cnchens/RV1126_RV1109_Hardware_Design_Template/README.md

# RV1126_RV1109_Hardware_Design_Template
RV1126_RV1109_HW_202103
