cnchens/RV1126_RV1109_Hardware_Design_Template/01_Common Document/Rockchip_RV1126_RV1109_Schematic_and_PCB_Review_Checklist_V1.1_CN.xlsx

Sheet: 封面页
RV1126/RV1109原理图及PCB评审注意事项
Revision: | V1.1
Date: | 2020-11-02
Status: | Draft
Rockchip Confidential

Sheet: 声明
保密提示： 本文档及其附件可能含有机密信息，来自瑞芯微电子股份有限公司，仅发送给指定接收者。若非该特定接收人，请勿复制、 使用或披露本文档的任何内容。若误收本文档，请从系统中永久性删除本文档，并以回复邮件或其他方式即刻告知发件人。瑞芯微电子股份有限公司拥有本文档信息的著作权及解释权，禁止任何未经授权许可的侵权行为。 IMPORTANT NOTICE: This document is from Rockchip Electronics Co., Ltd. .The contents of this document and any attachments may contain information that is privileged, confidential and/or exempt from disclosure under applicable law and relevant NDA. If you are not the intended recipient, you are hereby notified that any disclosure, copying, distribution, or use of the information is STRICTLY PROHIBITED. Please immediately contact the sender as soon as possible and destroy the material in its entirety in any format. Thank you.

Sheet: 历史版本
Revision History
Revision | Description | Editor | Revision Date
V1.0 | first edition | Linus.Lin | 2020.07.03
V1.1 | 删除关于efuse的描述. | Linus.Lin | 2020.11.02

Sheet: CPU&Crystal&Reset
类型 |  | 项目 | 要求 | 风险点及影响 | 是否验证? | 审核人 | 备注
平台共性 | 原理图 | PMIC_SLEEP和TSADC_SHUT是特定功能信号，不得随意更改。 | 必须 | 设计要求
 |  | RESET信号管脚需放置0.1uF滤波电容。 | 必须 | 设计要求
 |  | 晶体负载电容请根据实际使用的晶体的CL电容值选择，并控制常温下的频率容限在20ppm以内。 | 必须 | 设计要求
 |  | XOUT_24M网络串接电阻（22ohm）必须保留，用于限流，防止过驱。 | 必须 | 设计要求
 |  | FLASH_VOL_SEL/GPIO0_B3必须根据实际FLASH接口电平，选择合适的上下拉，以配置VCCIO1_VDD(FLASH_VDDQ)电源域的电平。 | 必须 | 设计要求
 |  | ADC_IN0用于Recovery模式选择，连接按键时请串联100ohm电阻；如果产品没有按键需求，请一定要预留10kohm上拉电阻以及测试点，否则会无法进行软件调试。 | 必须 | 设计要求
 |  | SPI/NAND/EMMC的DATA0或CLK信号预留测试点，以防开发过程中烧写了错误的固件后无法正常启动，且此时RECOVERY键不起作用。 | 必须 | 设计要求
 | PCB | 晶体电路布局需要优先考虑，布局时应与芯片在同一层并尽量靠近放置以避免打过孔。晶体走线尽可能的短，远离干扰源。 | 必须 | 设计要求
 |  | 晶体电路布局时如果与芯片不同层放置，走线及过孔需要与其他信号保持12mil以上间距，避免被干扰。 | 必须 | 设计要求
 |  | 晶体以及时钟信号必须保证邻层的地参考面完整，时钟信号需要包地处理，包地线每隔400mil至少添加一个GND过孔。 | 必须 | 设计要求
 |  | PLL电源的去耦电容，必须放在芯片管脚背面。 | 必须 | 设计要求
 |  | PLL电源的去耦电容，在单面贴时应尽量靠近芯片电源管脚布局单面贴时，先在最靠近芯片的位置放置去耦电容，电流需先流经电容，再进入芯片。 | 必须 | 设计要求
 |  | 在布局时，RESET复位信号远离板边缘和金属接插件，以防止因ESD引起的异常而导致复位模块死机。 | 必须 | 设计要求
 |  | RESET的滤波电容应尽量靠近芯片管脚布局，信号需先经过电容，再进入芯片。 | 必须 | 设计要求
 |  | RESET信号应远离DCDC、RF等强干扰信号，以防止受到干扰。如果走线较长，建议包地处理，并且包地线每隔500mil至少添加一个GND过孔。 | 必须 | 设计要求
 |  | RESET按键的TVS保护二级管应尽量靠近按键放置，信号拓扑为：按键--->TVS--->CPU&PMIC；出现ESD现象时，ESD电流必须先经过TVS器件衰减。 | 必须 | 设计要求
扩展需求 | 原理图
 | PCB

Sheet: PMIC&Power
类型 |  | 项目 | 要求 | 风险点及影响 | 是否验证? | 审核人 | 备注
平台共性 | 功能 | 电源器件选型请按照参考设计提供的型号，如果需要更换，LDO/BUCK的带载能力、功率耗散要满足设计要求。如果不知道每一路电源的功耗数据，可向Rockchip申请EVB的电源测试数据做参考。 | 必须 | 设计要求
 |  | 在各功能模块正常工作以后，需要在reboot测试和高功耗场景时对系统各电源做观察，电源不能有瞬时纹波较大的情况，必须留有足够的余量并控制好纹波。 | 必须 | 设计要求
 | 原理图 | DC 5V电源供电时，输入端放置100uF以上电容，改善电源纹波。 | 可选项
 |  | 芯片的每路电源管脚都要靠近放置去耦电容。 | 必须 | 设计要求
 |  | 请勿删除参考图中电源管脚串接的电阻或磁珠，因为芯片需要RC或LC以防止浪涌损坏。 | 必须 | 设计要求
 |  | PMIC的电源时序以及电源分配是固定的，请不要随意改动各路电源所使用的LDO和DC-DC。 | 必须 | 设计要求
 |  | 如果通过按键复位，靠近PMIC的RESETB管脚放置一个0.1uF滤波电容。 | 必须 | 设计要求
 |  | PMIC RK809-2的DC-DC电感参考值为：感量0.47uH，饱和电流3A以上，DCR小于50毫欧。 | 必须 | 设计要求
 |  | PMIC上连接SNSP和SNSN的采样电阻应选择10毫欧电阻，精度为1%，封装为0805或更大尺寸。 | 必须 | 设计要求
 | PCB | 芯片的相邻层必须是一个完整的GND平面。 | 必须 | 设计要求
 |  | 芯片的DDR信号区域，每个GND BALL需要对应一个过孔。 | 必须 | 设计要求
 |  | 芯片的Power管脚，每个ball需要对应一个过孔。 | 必须 | 设计要求
 |  | 芯片的GND管脚，每1.5个ball需要对应一个过孔。 | 必须 | 设计要求
 |  | 芯片下方相同网络的Power ball和GND ball在顶层走“井”字形，交叉连接。 | 必须 | 设计要求
 |  | 所有去耦电容应尽量靠近芯片电源管脚布局；双面贴的板子，去耦电容务必放在对应的电源管脚背面，特别是10uF以上容量的电容，电容的GND pad靠近芯片中心的GND ball放置。 | 必须 | 设计要求
 |  | 单面贴的板子，所有去耦电容布局时应尽可能放置在靠近芯片电源管脚。 | 必须 | 设计要求
 |  | 电源换层时，要尽可能的多打电源过孔；去耦电容的GND过孔要跟它的电源过孔数量保持一致。 | 必须 | 设计要求
 |  | 去耦电容的换层过孔要满足带载能力，不管是电源输入、电源输出还是接地，必须有足够多的过孔，才能保证低ESR（用于减低回路电感），保证电容的去耦效果。 Rockchip建议10uF容量以上去耦电容，一个焊盘提供两个以上0402尺寸的过孔，10uF以下容量的电容，一个焊盘提供至少一个0402尺寸的过孔，过孔要靠近电容焊盘。 | 必须 | 设计要求
 |  | PMIC的32.768KHz时钟信号需要包地处理。 | 必须 | 设计要求
 |  | PMIC电量计的SNSP/SNSN采样线按照差分规则走线，无阻抗要求；采样线上的100nF滤波电容靠近PMIC的管脚放置。采样电阻请靠近电池座的VCC_BAT-管脚放置。 | 必须 | 设计要求
 |  | PMIC的DC-DC之间电感的SW端间距大于1.5mm。建议将输入电容布局在PMIC的同一面，以增大电感之间的间距。 | 必须 | 设计要求
 |  | PMIC的EPAD接地焊盘要有足够的过孔，建议保证5*5个0.5*0.3mm或是6*6个0.4*0.2mm的过孔。 | 必须 | 设计要求
 |  | PMIC的DC-DC 100ohm反馈电阻需要靠近输出电容放置，电阻一端连接到DC-DC输出电容，另一端连接到PMIC的FB反馈脚上，并同时连接到CPU同一电源网络的最远端负载处(通常是芯片背面的去耦电容处)。反馈线宽度使用4mil，必须与电源铺铜伴随走线，以避免干扰；反馈线与其他信号间隔6mil以上。 | 必须 | 设计要求
 |  | VDD_ARM、VDD_LOGIC、VCC_DDR、VDD_NPU、VDD_VEPU的铺铜宽度需满足芯片的电流需求，连接到芯片电源管脚的铺铜足够宽，路径不能被过孔分割太严重。 | 必须 | 设计要求
 |  | 电源部分布局时应远离板边及金属接插件，防止ESD干扰。 | 必须 | 设计要求
 |  | 采样电阻 ——> VCC_BAT- ——> VCC_BAT+ ——>VCC_SYS的走线尽可能短，宽度必须考虑3A的过电流能力，并且不能有太大的压降，所以电源过孔孔径要够大并且数量够多（8个以上），这样可以让主电源回路阻抗更小，充分发挥电池的性能。 | 必须 | 设计要求
扩展需求 | 原理图 Schematic | 如果RK809-2不使用电量计，请把PMIC的SNSP/SNSN/BATDIV接地。 | 必须 | 设计要求
 | PCB | PMIC的32.768K晶体，如果使用金属圆柱体封装，金属外壳应接地。 | 必须 | 保证时钟稳定

Sheet: ADC
类型 |  | 项目 | 要求 | 风险点及影响 | 是否验证? | 审核人 | 备注
平台共性 | 原理图 | ADC_AVDD_1V8电源管脚需放置0.1uF去耦电容。 | 必须 | 设计要求
 |  | 按键的分压电阻阻值请使用参考设计的推荐值，请勿随意改动。 | 必须 | 设计要求
 | PCB | ADCIN0的1nF电容为按键去抖电容，布局时尽量靠近芯片管脚放置。 | 必须 | 设计要求
 |  | ADC信号请远离LCD、DRAM等数字信号。禁止在高速信号线的相邻层布线；禁止在高速信号附近打孔换层；走线不要穿过电感区域。 | 必须 | 设计要求
扩展需求 | 原理图
 | PCB

Sheet: GPIO&总线接口
类型 |  | 项目 | 要求 | 风险点及影响 | 是否验证? | 审核人 | 备注
平台共性 | 原理图 | 对于SDIO、I2S、I2C、PCM、SPI、UART等总线以及GPIO端口，要注意与外接设备的IO电平匹配。 | 必须 | 设计要求
 |  | 对于SDIO、I2S、I2C、PCM、SPI、UART等总线以及GPIO端口，当通过连接器实现板对板连接时，建议串接一定阻值的电阻(22ohm-100ohm之间，具体以能满足SI测试为准)，并预留TVS器件。 | 必须 | 防止生产过程中的强静电及强浪涌直接灌入芯片GPIO，导致芯片管脚被击穿。
 |  | 如果增加或更换了GPIO功能，请确保GPIO的初始上拉或下拉状态满足设计要求。 | 必须 | 设计要求
 |  | 如果连接器上有高压信号，在连接器选型时还应考虑防呆处理。 | 可选项 | 防止作业员反插，强电流灌入GPIO而导致芯片击穿。
 |  | 对于所有总线，如I2S/I2C/PCM/SPI/SDIO/SDMMC中，CLK信号上的串联匹配电阻，都必须靠近源端（发送端）放置。 | 必须 | 设计要求
 |  | 对于SDIO/SDMMC总线，数据信号上的串联匹配电阻，应靠近芯片端放置（400mil以内）。 | 必须 | 设计要求
 | PCB | 高速信号PCB设计请参考《Rockchip_RV1126_RV1109_High_Speed_PCB_Design_Guide》文档中的约束条件。 | 必须 | 设计要求
 |  | 对于I2S/PCM/SDIO/SDMMC总线，CLK信号必须单独包地走线以减少干扰，包地线每隔400mil至少添加一个GND过孔（如果走线没有包地但满足3W原则，也没什么问题。一旦包地则必须增加GND过孔，否则效果反而更差）；总线其他信号做为一组，整组包地走线并与其它信号隔离开，不建议使用电流变化较大的电源平面做为信号的参考平面，或者在DC-DC的SW端附近走线。 | 必须 | 设计要求
扩展需求 | 原理图
 | PCB

Sheet: USB
类型 |  | 项目 | 要求 | 风险点及影响 | 是否验证? | 审核人 | 备注
平台共性 | 原理图 | USB_AVDD_0V8/1V8/3V3电源管脚需放置0.1uF去耦电容。 | 必须 | 设计要求
 |  | OTG_EXTR、HOST_EXTR电阻请选用200ohm 1%精度。 | 必须 | 设计要求
 |  | DP/DM差分对串联连接2.2ohm电阻或共模电感。 | 必须 | 设计要求
 |  | ESD保护器件（如TVS）尽可能靠近USB连接器放置。对于USB2.0，TVS的最大结电容不应超过3pF。 | 必须 | 设计要求
 |  | USB OTG端口是系统固件烧写口，主板上必须预留接口。 | 必须 | 设计要求
 |  | USB ID串联100ohm电阻。 | 必须 | 设计要求
 | PCB | 高速信号PCB设计请参考《Rockchip_RV1126_RV1109_High_Speed_PCB_Design_Guide》文档中的约束条件。 | 必须 | 设计要求
 |  | USB差分对需要控制PCB阻抗，差分阻抗为90Ω ±10%。 | 必须 | 设计要求
 |  | USB差分对应严格遵循差分规则走线。例如，必须保持相同的长度、相同的宽度、相同的层和固定的线距，并尽可能保持对称。 | 必须 | 设计要求
 |  | USB差分对如果跨不同平面走线，需要有伴随地；走线拐角尽量用弧线或者钝角，不能为直角或锐角。 | 必须 | 设计要求
 |  | USB差分对与电源或地平面（或走线）、信号线和过孔保持至少12mil的距离。 | 必须 | 设计要求
 |  | 当USB差分信号走线需要换层时，确保走线上的过孔数量少于6个，并靠近信号过孔放置对称的地缝合孔。 | 必须 | 设计要求
 |  | OTG_EXTR、HOST_EXTR电阻靠近芯片端放置。 | 必须 | 设计要求
 |  | 如果使用USB进行电池充电，VBUS走线需要能支持2.5A的电流。 | 必须 | 设计要求
 |  | USB连接座远离RF天线、摄像头等高EMI源。 | 必须 | 设计要求
 |  | USB的TVS保护二极管应尽量靠近连接座放置，信号拓扑为：USB座--->TVS--->CPU；出现ESD现象时，ESD电流必须先经过TVS器件衰减；TVS器件走线上不要有残桩(Stub)。 | 必须 | 设计要求
扩展需求 | 原理图 | 在USB差分信号上预留共模电感。 | 可选项 | 眼图不符合协议规范
 | PCB | 共模电感应放置在靠近连接座端。 | 可选项 | 设计要求

Sheet: DRAM
类型 |  | 项目 | 要求 | 风险点及影响 | 是否验证? | 审核人 | 备注
平台共性 | 原理图 | 请根据不同的DDR颗粒类型，修改RK809-2 FB3（pin27）的分压电阻阻值，使得VCC_DDR输出电压与颗粒相匹配。 | 必须 | 设计要求
 | PCB | 高速信号PCB设计请参考《Rockchip_RV1126_RV1109_High_Speed_PCB_Design_Guide》文档中的约束条件。 | 必须 | 设计要求
 |  | 请套用Rockchip提供的DDR参考模板。 | 必须 | 设计要求
 |  | 所有DDR信号需要控制PCB阻抗，差分阻抗为100Ω ±10%，单端阻抗为50Ω ±10%。 | 必须 | 设计要求
 |  | DDR走线的参考层需要为完整的平面，参考平面的范围需要比最外层走线宽12mil以上 。避免出现连续的过孔阻断信号的回流路径的情况。 | 必须 | 设计要求
 |  | VCC_DDR电源平面保持完整，不要在平面内走线。 | 必须 | 设计要求
 |  | 信号换层时，参考层没有变化，始终为GND平面的，按照每2个信号过孔，对应增加1个GND过孔。 信号换层时，参考层出现变化，例如从GND平面变化为VCC_DDR平面，按照每3～4个信号过孔，对应增加1个缝合电容。 | 必须 | 设计要求
 |  | DDR电路布局尽量靠近板内，远离板边及金属接插件，防止DDR模块因ESD引起异常而死机。 | 必须 | 设计要求
扩展需求 | 原理图 | 预留屏蔽罩；屏蔽罩如果有散热孔，请避开DDR颗粒位置。 | 可选项
 | PCB

Sheet: FLASH
类型 |  | 项目 | 要求 | 风险点及影响 | 是否验证? | 审核人 | 备注
平台共性 | 原理图 | 根据Nand/eMMC Flash的实际供电电压(1.8V或3.3V)，配置FLASH_VOL_SEL/GPIO0_B3管脚电平： 配置为高电平，控制器供电VCCIO1_VDD及所属IO电压域为1.8V。 配置为低电平，控制器供电VCCIO1_VDD及所属IO电压域为3.3V。 | 必须 | 设计要求
 |  | NAND FLASH的38PIN串接0ohm电阻后接到VCCIO_FLASH电源网络。因为部分SLC的颗粒PIN38为写保护，如果直接接高电平，软件需要特殊处理。预留0ohm以后，遇到这类SLC颗粒后拿掉0ohm电阻，悬空PIN38即可。 | 必须 | 设计要求
 |  | EMMC的DATA0与CMD要预留上拉电阻位，电源为VCCIO_FLASH，不可删减。 | 必须 | 设计要求
 |  | EMMC_CLK不需要上拉电阻以及电容。 | 必须 | 设计要求
 | PCB | 高速信号PCB设计请参考《Rockchip_RV1126_RV1109_High_Speed_PCB_Design_Guide》文档中的约束条件。 | 必须 | 设计要求
 |  | 所有EMMC信号都要控制PCB阻抗，单端信号阻抗为50Ω ±10%。 | 必须 | 设计要求
 |  | 电源线宽度应满足控制器及相应颗粒的电流需求（25mil以上）。 | 必须 | 设计要求
 |  | EMMC_CLK的22ohm串联匹配电阻靠近CPU端（源端）布局（400mil以内）。 | 必须 | 设计要求
 |  | EMMC_CLK单独走线并做包地处理，并且包地线每隔400mil至少添加一个GND过孔。 | 必须 | 设计要求
 |  | EMMC_DATA/CMD整组并行包地走线并遵循3W原则。 | 必须 | 设计要求
扩展需求 | 原理图 | eMMC与Nand兼容设计双Layout时，需要注意走线要理顺，避免EMMC_CLK走线上有很长的分支。 | 必须 | 分支会造成EMMC_CLK的SI问题；
 |  | eMMC与Nand兼容设计双Layout时，走线必须先经过Nand的管脚再连接到EMMC的管脚。 | 必须 | EMMC速率较高，如果走线有分支或者先经过EMMC再连接到NAND，会造成信号的SI问题；
 | PCB

Sheet: Camera
类型 |  | 项目 | 要求 | 风险点及影响 | 是否验证? | 审核人 | 备注
平台共性 | 原理图 | MIPI_RX0_AVDD_0V8、MIPI_RX1_AVDD_1V8、MIPI_RX0_AVDD_1V8、MIPI_RX1_AVDD_1V8电源管脚需串联1ohm电阻。 | 必须 | 设计要求
 |  | 做为Camera功能使用时，VCCIO4与VCCIO6供电必须用相同的电源，保证I2C/MCLK/PDN/RESET等与Camera的DOVDD电平保持一致。 | 必须 | 设计要求
 |  | 若摄像头带AF 功能，则VCC2V8_AF需要单独供电；或是与AVCC2V8_DVP共用，但是需要用磁珠隔离。 | 必须 | 设计要求
 |  | CAMERA的DVDD 供电有1.2V/1.5V/1.8V等不同情况，请根据Camera的规格书提供准确的电源。 | 必须 | 设计要求
 | PCB | 高速信号PCB设计请参考《Rockchip_RV1126_RV1109_High_Speed_PCB_Design_Guide》文档中的约束条件。 | 必须 | 设计要求
 |  | MIPI CSI差分对需要控制PCB阻抗，差分阻抗为100Ω ±10%。 | 必须 | 设计要求
 |  | CIF_CLKIN (PCLK)/CIF_CLKOUT (MCLK)时钟信号单独走线并做包地处理，包地线每隔500mil至少添加一个GND过孔。 | 必须 | 设计要求
 |  | CIF_D0-D15/VSYNC/HREF整组并行包地走线并遵循3W原则。 | 必须 | 设计要求
 |  | MIPI CSI差分对应严格遵循差分规则走线。例如，必须保持相同的长度、相同的宽度、相同的层和固定的线距，并尽可能保持对称。 | 必须 | 设计要求
 |  | MIPI CSI差分对需要有完整的参考平面，不可跨平面走线；走线拐角尽量用弧线或者钝角，不能为直角或锐角。 | 必须 | 设计要求
 |  | MIPI CSI差分对整组并行走线并包地，与GND信号间距遵循3W原则，并且包地线每隔300mil至少添加一个GND过孔。 MIPI CSI差分对整组并行走线，如果不包地，则与其他信号的距离至少为12mil。 | 必须 | 设计要求
 |  | MIPI CSI连接座如果有预留测试点，应靠近连接座，且走线上的残桩(Stub)尽量短。 | 必须 | 设计要求
 |  | CAMERA布局时需要远离大功率辐射器件， 如GSM天线等。 | 必须 | 设计要求
 |  | 连接座AVDD/DOVDD/DVDD电源的去耦电容，都需要尽量靠近CAMERA连接座放置。 | 必须 | 设计要求
扩展需求 | 原理图
 | PCB

Sheet: Audio
类型 |  | 项目 | 要求 | 风险点及影响 | 是否验证? | 审核人 | 备注
平台共性 | 原理图 | 驻极体麦克风的偏置电阻请根据实际规格参数选择。 | 必须 | 设计要求
 |  | 麦克风的偏置电源需要68-100ohm电阻和4.7uF以上电容进行RC滤波。 | 必须 | 设计要求
 | PCB | PMIC Codec的SPK_OUT网络串接磁珠请靠近PMIC输出（源端）放置。 | 必须 | 设计要求
 |  | PMIC Codec的VCC_SPK_HP走线大于50mil。 | 必须 | 设计要求
 |  | HP_SNS网络串接电阻必须在耳机座管脚处短接到地。 | 必须 | 设计要求
 |  | HP_SNS做为HPL/HPR的伴随地，整组走线并包地，HPL/HPR线宽10mil以上。 | 必须 | 设计要求
 |  | SPKP/SPKN按照差分走线并整组包地，线宽20mil。 | 必须 | 设计要求
 |  | MIC单端连接时，MIC1/MIC2单独走线并分别包地。 MIC差分连接时，MICP/MICN按照差分走线，并整组包地。 | 必须 | 设计要求
 |  | 所有音频信号都请远离LCD、DRAM等高速信号线，遵循3W原则。禁止在高速信号线相邻层走线；禁止在高速信号线附近打孔换层；走线不要穿过电感区域；原理RF信号和器件。 | 必须 | 设计要求
 |  | 耳机座/麦克风的TVS保护二级管应尽量靠近连接座放置，信号拓扑为：耳机座/麦克风--->TVS--->CPU；出现ESD现象时，ESD电流必须先经过TVS器件衰减；TVS器件走线上不要有残桩(Stub)。 | 必须 | 设计要求
扩展需求 | 原理图
 | PCB

Sheet: Display
类型 |  | 项目 | 要求 | 风险点及影响 | 是否验证? | 审核人 | 备注
平台共性 | 原理图 | LCDC_CLK网络33ohm串联匹配电阻靠近芯片端（源端）放置，减少信号反射。 | 必须 | 设计要求
 |  | RGB/MIPI等信号，如果有经连接器实现板对板连接时，建议全部信号串接一定阻值的电阻(2.2ohm-10ohm之间，具体以能满足SI测试为准)，以及预留TVS器件。 | 必须Mandatory | 防止生产过程中的强静电及强浪涌直接灌入芯片GPIO，导致芯片管脚被击穿。
 | PCB | 高速信号PCB设计请参考《Rockchip_RV1126_RV1109_High_Speed_PCB_Design_Guide》文档中的约束条件。 | 必须 | 设计要求
 |  | MIPI DSI差分对需要控制PCB阻抗，差分阻抗为100Ω ±10%。 | 必须 | 设计要求
 |  | MIPI DSI差分对应严格遵循差分规则走线。例如，必须保持相同的长度、相同的宽度、相同的层和固定的线距，并尽可能保持对称。 | 必须 | 设计要求
 |  | MIPI DSI差分对需要有完整的参考平面，不可跨平面走线；走线拐角尽量用弧线或者钝角，不能为直角或锐角。 | 必须 | 设计要求
 |  | MIPI DSI差分对整组并行走线并包地，与GND信号间距遵循3W原则，并且包地线每隔300mil至少添加一个GND过孔。 MIPI DSI差分对整组并行走线，如果不包地，则与其他信号的距离至少为12mil。 | 必须 | 设计要求
 |  | MIPI DSI连接座如果有预留测试点，应靠近连接座，且走线上的残桩(Stub)尽量短。 | 必须 | 设计要求
 |  | RGB的数据信号整组并行走线并包地，与其他信号间距遵循3W原则。 | 必须 | 设计要求
 |  | RGB的CLK信号单独走线并做包地处理，并且包地线每隔500mil至少添加一个GND过孔。 | 必须 | 设计要求
扩展需求 | 原理图
 | PCB

Sheet: LCM&TP
类型 |  | 项目 | 要求 | 风险点及影响 | 是否验证? | 审核人 | 备注
平台共性 | 原理图 | LED背光升压IC的FB端限流电阻，请选用1%精度电阻，并按功率需求选择合适的封装尺寸。 | 必须 | 设计要求
 |  | LED背光升压IC的EN/PWM管脚，选择内部下拉的GPIO，外接下拉电阻，避免上电时出现闪屏现象。 | 必须 | 设计要求
 |  | LED背光的驱动电压输出，请选择合适额定电压的滤波电容。 | 必须 | 设计要求
 |  | LED背光升压电路的肖特基二极管请根据工作电流选择合适的型号，并注意二极管的反向击穿电压，避免在空载时反向击穿。 | 必须 | 设计要求
 |  | 屏和触摸屏的信号电平要与芯片的IO驱动电平匹配，如RST/Stand by等信号。 | 必须 | 设计要求
 |  | TP的I2C总线必须加2.2K上拉到VCC3V3_TP电源。 | 必须 | 设计要求
 |  | 带Charge pump的TP IC，请注意电容的额定电压。 | 必须 | 设计要求
 |  | 对于屏，当通过FPC与板连接时，建议串接一定阻值的电阻(22ohm-100ohm之间，具体以能满足SI测试为准)，并预留TVS器件。 | 必须 | 设计要求
 |  | 屏接口建议预留共模电感。 | 必须 | 设计要求
 | PCB | LED背光IC的FB端限流电阻，请靠近屏座放置而不是DC-DC。 | 必须 | 设计要求
 |  | 背光升压电路，请注意电容摆放及电源走线，保证电源的充放电回路最小。 | 必须 | 设计要求
 |  | 屏和触摸屏连接座如果有预留测试点，应靠近连接座，且走线上的残桩(Stub)尽量短。 | 必须 | 设计要求
扩展需求 | 原理图
 | PCB

Sheet: Sensor
类型 |  | 项目 | 要求 | 风险点及影响 | 是否验证? | 审核人 | 备注
平台共性 | 原理图 | 多个设备共用I2C总线时，确保I2C总线上有加上拉电阻，且设备的地址不冲突。 | 必须 | 设计要求
 |  | 确保Sensor的VCCIO与I2C/SPI总线的电源域一致，否则会漏电。 | 必须 | 设计要求
 | PCB | Sensor的去耦电容靠近IC放置。 | 必须 | 设计要求
 |  | 磁敏感类的Sensor（如地磁传感器）需要远离强磁场， 易磁化器件， 大电流器件等， 如听筒，喇叭，马达，摄像头，螺丝钉，大电感与大电容等。同时不能放在屏蔽罩内。 | 必须 | 设计要求
 |  | 磁敏感类的Sensor（如地磁传感器）不能放置在电源的铜皮、走线区域，会受电流产生磁场的影响。 | 必须 | 设计要求
 |  | MEMS器件，在pcb扇出时需注意四个方向走线均衡，不允许单个方向大面积铺铜，避免应力造成传感器参数漂移。 | 必须 | 设计要求
 |  | MEMS器件，在生产时不允许超声波清洗。 | 必须 | 设计要求
扩展需求 | 原理图
 | PCB

Sheet: Micro-SD Card
类型 |  | 项目 | 要求 | 风险点及影响 | 是否验证? | 审核人 | 备注
平台共性 | 原理图 | SDMMC_CLK串联匹配电阻靠近源端，即芯片端放置。 | 必须 | 设计要求
 |  | SDMMC_DET串联电阻靠近源端（卡端）放置，避免频繁拔插卡造成芯片端IO损坏。 | 必须 | 设计要求
 |  | Micro-SD总线支持3.0卡时，TVS保护管的结电容不超过0.5pF。 | 必须 | 设计要求
 |  | SDMMC与UART/JTAG复用的管脚建议预留测试点，方便调试阶段连接UART/JTAG。 | 可选项
 |  | Micro-SD连接座端的VCC_SD电源去耦电容不可删除。 | 必须 | 设计要求
 | PCB | 高速信号PCB设计请参考《Rockchip_RV1126_RV1109_High_Speed_PCB_Design_Guide》文档中的约束条件。 | 必须 | 设计要求
 |  | 所有SDMMC信号都要控制PCB阻抗，单端信号阻抗为50Ω ±10%。 | 必须 | 设计要求
 |  | SDMMC_CLK单独走线并做包地处理，并且包地线每隔400mil至少添加一个GND过孔。 | 必须 | 设计要求
 |  | SDMMC_DATA/CMD整组并行包地走线并遵循3W原则。 | 必须 | 设计要求
 |  | Micro-SD卡座下面区域尽量避免走线，以免出现ESD现象时会受耦合影响。 | 必须 | 设计要求
 |  | Micro-SD的TVS保护二级管应尽量靠近卡座放置，信号拓扑为：Micro-SD卡座--->TVS--->CPU；出现ESD现象时，ESD电流必须先经过TVS器件衰减；TVS器件走线上不要有残桩(Stub)。 | 必须 | 设计要求
扩展需求 | 原理图
 | PCB

Sheet: WIFI&BT
类型 |  | 项目 | 要求 | 风险点及影响 | 是否验证? | 审核人 | 备注
平台共性 | 原理图 | 请确保模组的IO电平与CPU的IO电平保持一致，否则需要做电平匹配处理。 | 必须 | 设计要求
 |  | 晶体负载电容请根据实际使用的晶体的CL电容值选择，并控制常温下的频率容限在10ppm以内。 | 必须 | 设计要求
 |  | 天线预留π型电路用于天线匹配调节。 | 必须 | 设计要求
 |  | 确认PCM与UART接口的连接方向，如IN和OUT、TXD和RXD。 | 必须 | 设计要求
 |  | 如果使用需要32.768k时钟输入的模组，需要注意时钟幅度。 | 必须 | 设计要求
 | PCB | 高速信号PCB设计请参考《Rockchip_RV1126_RV1109_High_Speed_PCB_Design_Guide》文档中的约束条件。 | 必须 | 设计要求
 |  | 模组远离DDR、HDMI、USB等其他高速信号走线及连接座。 | 必须 | 设计要求
 |  | 模组下方TOPC层不允许走线，需保证参考面为完整的地平面，SDIO信号线建议绕过模组投影区域后连接到模组管脚。 | 必须 | 设计要求
 |  | 晶体电路布局需要优先考虑，布局时应与模组在同一层并尽量靠近放置以避免打过孔。晶体走线尽可能的短，远离干扰源。 | 必须 | 设计要求
 |  | 晶体电路布局时如果与模组不同层放置，走线及过孔需要与其他信号保持12mil以上间距，避免被干扰。 | 必须 | 设计要求
 |  | 晶体以及时钟信号必须保证邻层的地参考面完整，时钟信号需要包地处理，包地线每隔400mil至少添加一个GND过孔。 | 必须 | 设计要求
 |  | 所有SDIO信号都要控制PCB阻抗，单端信号阻抗为50Ω ±10%。 | 必须 | 设计要求
 |  | SDIO_CLK单独走线并做包地处理，并且包地线每隔400mil至少添加一个GND过孔。 | 必须 | 设计要求
 |  | SDIO_DATA/CMD整组并行包地走线并遵循3W原则。 | 必须 | 设计要求
 |  | 模组的电源走线尽量采用星型布局，减弱不同路电源轨道之间的相互干扰。 | 必须 | 设计要求
 |  | 电源滤波电容应尽量靠近芯片管脚布局，电流需先经过电容，再进入芯片。 | 必须 | 设计要求
 |  | 模组的电感布局时，请注意走线经电感出来后，先经过电容，再进入模组电源管脚。（附图） | 必须 | 设计要求
 |  | 天线端口走线50欧，保证参考地完整，阻抗不要突变，下方不允许有其他信号线或电源；走线的伴随地需要与主地参考面使用地墙连接。 | 必须 | 设计要求
扩展需求 | 原理图 | 射频线预留测试座。 | 可选项 | 方便厂测，以及天线调试；
 | PCB | 模组周围预留屏蔽罩位置，并做PCB阻焊开窗处理。 | 可选项
