cnchens/RV1126_RV1109_Hardware_Design_Template/01_Common Document/Rockchip_RV1126_RV1109_Schematic_and_PCB_Review_Checklist_V1.1_EN.xlsx

Sheet: Cover
RV1126/RV1109 Schematic and PCB Review Checklist
Revision: | V1.1
Date: | 2020-11-02
Status: | Draft
Rockchip Confidential

Sheet: Statement
保密提示： 本文档及其附件可能含有机密信息，来自瑞芯微电子股份有限公司，仅发送给指定接收者。若非该特定接收人，请勿复制、 使用或披露本文档的任何内容。若误收本文档，请从系统中永久性删除本文档，并以回复邮件或其他方式即刻告知发件人。瑞芯微电子股份有限公司拥有本文档信息的著作权及解释权，禁止任何未经授权许可的侵权行为。 IMPORTANT NOTICE: This document is from Rockchip Electronics Co., Ltd. .The contents of this document and any attachments may contain information that is privileged, confidential and/or exempt from disclosure under applicable law and relevant NDA. If you are not the intended recipient, you are hereby notified that any disclosure, copying, distribution, or use of the information is STRICTLY PROHIBITED. Please immediately contact the sender as soon as possible and destroy the material in its entirety in any format. Thank you.

Sheet: Revision History
Revision History
Revision | Description | Editor | Revision Date
V1.0 | first edition | Linus.Lin | 2020.07.03
V1.1 | Delete the description about efuse. | Linus.Lin | 2020.11.02

Sheet: CPU&Crystal&Reset
Type |  | Item | Requirement | Risk & Influence | Is it verified? | Reviewer | Remark
Platform commonality | Schematic | PMIC_SLEEP and TSADC_SHUT are specific function signals and can not be changed randomly. | Mandatory | Design requirement
 |  | Place 0.1uF filter capacitor close to RESET pin. | Mandatory | Design requirement
 |  | The value of crystal load capacitors should be selected according to CL of the crystal, and having a frequency tolerance of ±20ppm at +25°C. | Mandatory | Design requirement
 |  | XOUT_24M network series resistance (22ohm) must be reserved for current limiting to prevent overdrive. | Mandatory | Design requirement
 |  | FLASH_VOL_SEL/GPIO0_B3 must select the appropriate pull-up and pull-down according to the actual FLASH interface level to configure the voltage of VCCIO1_VDD(FLASH_VDDQ). | Mandatory | Design requirement
 |  | ADC_IN0 is used for Recovery mode selection. Please series connect a 100ohm resistor connect to button. if the product has no button requirement, please be sure to reserve 10kohm pull-up resistor and test point, otherwise software debugging will not be possible. | Mandatory | Design requirement
 |  | The DATA0 or CLK signal of SPI/NAND/EMMC reserves test points, in case the wrong firmware is programmed during the development process and cannot boot normally, and the RECOVERY key does not work at this time. | Mandatory | Design requirement
 | PCB | Give priority to crystal circuit when layout, and place as close as possible to the CPU in the same layer to avoid vias. Crystal traces is as short as possible，far away from the interference source, and needs to surround by GND. | Mandatory | Design requirement
 |  | If the crystal circuit layout is placed in a different layer from the CPU, the traces and vias need to be kept at a distance of more than 12mil from other signals to avoid interference. | Mandatory | Design requirement
 |  | The crystal and clock signal must ensure the integrity of the ground reference plane of the adjacent layer, and the clock signal needs to surround by GND.The ground trace should be added with at least one GND via every 400mil. | Mandatory | Design requirement
 |  | The decoupling capacitors of PLL power supply must be placed on the back of the CPU power pins. | Mandatory | Design requirement
 |  | The decoupling capacitors of PLL power supply should be placed as close as possible to the power pin of the CPU for boards of single-side SMT. Place the decoupling capacitor closest to the CPU first. to flow through capacitors first before entering the pins. The current must first flow through the capacitor before entering the chip. | Mandatory | Design requirement
 |  | Keep the RESET signal far away from the board edge and metal connectors when layout to prevent the reset modules from crashing due to an abnormality caused by ESD. | Mandatory | Design requirement
 |  | The filter capacitor of RESET should be placed as close as possible to the CPU pin when layout. The signal must flow through capacitors first before entering the CPU. | Mandatory | Design requirement
 |  | The RESET signal should be far away from strong interference signals such as DCDC and RF to prevent interference. If the trace is long, it is recommended to surround by GND, and ground trace should be added with at least one GND via every 500mil. | Mandatory | Design requirement
 |  | TVS protection diodes are placed as close as possible to RESET button. Signal topology is: button--->TVS--->CPU&PMIC; when ESD occurs, ESD current must first be attenuated by TVS components. | Mandatory | Design requirement
Extended requirement | Schematic
 | PCB

Sheet: PMIC&Power
Type |  | Item | Requirement | Risk & Influence | Is it verified? | Reviewer | Remark
Platform commonality | Function | For the selection of power supply devices, please follow the model provided in the reference design. If replacement is required, the loading capacity and power dissipation of the LDO/BUCK must meet the design requirements. If you do not know the power consumption value of each power supply, you can apply to Rockchip for power supply test data for reference. | Mandatory | Design requirement
 |  | After each function module works properly, it is necessary to observe each power supply of system during reboot test and high consumption. The power cannot have a large instantaneous ripple, and you must leave sufficient margin and control the ripple. | Mandatory | Design requirement
 | Schematic | When the DC 5V power supply is used, place a capacitor of more than 100uF at the input terminal to improve the power supply ripple. | Optional
 |  | Each power supply pin of the chip should be placed close to the decoupling capacitor. | Mandatory | Design requirement
 |  | Do not delete serial connection resistors or beads in the power pins of reference schematic because CPU requires RC or LC to prevent surge damage. | Mandatory | Design requirement
 |  | Power sequence and power distribution of PMIC are fixed. Do not arbitrarily change LDO and DC-DC used by each power. | Mandatory | Design requirement
 |  | If reset by button, place a 0.1uF filter capacitor close to the RESETB pin of PMIC. | Mandatory | Design requirement
 |  | PMIC RK809-2 DC-DC inductors reference value: inductance 0.47uH, saturation current 3A or more, DCR less than 50 milliohms. | Mandatory | Design requirement
 |  | The sampling resistor connected to SNSP and SNSN on PMIC should choose 10 milliohm resistors with 1% accuracy and size 0805 or larger. | Mandatory | Design requirement
 | PCB | The adjacent layer of the CPU mount layer must be a complete GND plane. | Mandatory | Design requirement
 |  | For the DDR signal area of CPU, each GND BALL needs to correspond to a via. | Mandatory | Design requirement
 |  | For the Power pin of CPU, each ball needs to correspond to a via. | Mandatory | Design requirement
 |  | For the GND pin of CPU, every 1.5 ball needs to correspond to a via. | Mandatory | Design requirement
 |  | The Power ball and GND ball of the same net under CPU is routed in "X" shape, cross-connect in top layer. | Mandatory | Design requirement
 |  | All the decoupling capacitors should be placed as close as possible to the power pins of SOC. For boards of double-sided SMT, capacitors must be placed on the back of the power pins, especially for capacitors with a capacity of more than 10uF, the GND pad of the capacitor is placed close to the GND ball in the center of the SOC. | Mandatory | Design requirement
 |  | For boards of single-sided SMT, all decoupling capacitors should be placed as close as possible to the chip power pins. | Mandatory | Design requirement
 |  | When changing the power supply layer, it is necessary to add as many power supply vias as possible. The GND vias of the decoupling capacitor should be consistent with the number of power vias. | Mandatory | Design requirement
 |  | The layer-changing vias of the decoupling capacitor must meet the load-carrying capacity. Whether it is power input, power output or grounding, there must be enough vias to ensure low ESR (used to reduce loop inductance) and ensure the decoupling effect of the capacitor Rockchip recommends that, for decoupling capacitors bigger than 10uF, one pad provides more than two 0402 vias, and for capacitances less than 10uF, one pad provides a 0402 via at least. Vias should be close to capacitors pads. | Mandatory | Design requirement
 |  | 32.768KHz clock signal of PMIC needs to surrounded by GND. | Mandatory | Design requirement
 |  | The SNSP/SNSN sampling line of PMIC battery fuel gauge is in accordance with the difference rule and has no impedance requirement; the 100nF filter capacitor on the sampling line is placed closed to the pins of PMIC; the sampling resistor should be placed closed to the VBAT- pin of battery connector. | Mandatory | Design requirement
 |  | The distance between the SW terminals of the inductor between the DC and DC of the PMIC is greater than 1.5mm. It is recommended to place the input capacitor on the same side of the PMIC to increase the spacing between the inductors. | Mandatory | Design requirement
 |  | EPAD of PMIC should have enough vias. Recommend to ensure 5*5 0.5*0.3mm size or 6*6 0.4*0.2mm size vias. | Mandatory | Design requirement
 |  | The 100ohm feedback resistor of PMIC DC-DC needs to be placed close to the output capacitor. One end of the resistor is connected to the DC-DC output capacitor, the other end is connected to the PMIC FB feedback pin, and it is also connected to the farthest load of the same power network of the CPU ( It is usually the decoupling capacitor on the back of the chip). The width of the feedback line is 4mil, and it must be routed with the power supply copper to avoid interference; the distance between the feedback line and other signals is more than 6mil. | Mandatory | Design requirement
 |  | The copper of VDD_ARM, VDD_LOGIC, VCC_DDR,VDD_NPU and VDD_VEPU must meet requirements of the CPU current. Copper path to CPU power pins wide enough and cannot be divided too much by vias. | Mandatory | Design requirement
 |  | Power part should be far away from the board edge and metal connectors when layout to prevent from being interferenced due to ESD. | Mandatory | Design requirement
 |  | The power path from sampling resistance ---> VCC_BAT- ---> VCC_BAT+ ---> VCC_SYS should be as short as possible. Copper width requires current capacity to 3A, and the voltage drop should not be too large. So the vias of power supply should be large enough and the quantity should be more enough (more than 8), so that the main power supply circuit impedance can be smaller and the battery performance can be brought into full play. | Mandatory | Design requirement
Extended requirement | Schematic | If RK809-2 doesn't use fuel gauge, please connect SNSP/SNSN/BATDIV to GND for PMIC. | Mandatory | Design requirement
 | PCB | If 32.768KHz crystal of PMIC is packaged using metal cylinder, the metal shell should be connected to ground. | Mandatory | Guarantee the clock stability

Sheet: ADC
Type |  | Item | Requirement | Risk & Influence | Is it verified? | Reviewer | Remark
Platform commonality | Schematic | Need to place 0.1uF decoupling capacitor for ADC_AVDD_1V8 power pin. | Mandatory | Design requirement
 |  | Please use the recommended value in the reference design as the resistance of keys circuit. Do not change it randomly. | Mandatory | Design requirement
 | PCB | The 1nF capacitor of ADCIN0 is a button filter capacitor, it should be placed as close as possible to the CPU pin when layout. | Mandatory | Design requirement
 |  | Keep ADC signal away from the digital signal such as LCD, DRAM and so on. Do not route on the adjacent layer of high-speed signal. Do not drill via near the high-speed signal. Do not route through inductor area. | Mandatory | Design requirement
Extended requirement | Schematic
 | PCB

Sheet: GPIO&BUS
Type |  | Item | Requirement | Risk & Influence | Is it verified? | Reviewer | Remark
Platform commonality | Schematic | For SDIO, I2S, I2C, PCM, SPI, UART and other bus, as well as GPIO port, pay attention to IO level matching with external device. | Mandatory | Design requirement
 |  | For SDIO, I2S, I2C, PCM, SPI, UART and other bus, as well as GPIO port, when connect board with other by connectors, recommend to series connect resistors with a certain resistance (22ohm-100ohm, subject to the SI specification), and reserve TVS components. | Mandatory | Prevent the strong static electricity and strong surge in the production process, leading to the breakdown of the chip pin.
 |  | If there is an increase or replacement of GPIO function, ensure that the GPIO initial pull-up or pull-down state meets the design requirements. | Mandatory | Design requirement
 |  | If there is a high voltage signal on connectors, need to consider the anti-plug treatment for selection of connector components. | Optional | Prevent the operator from inserting back and pouring high current into GPIO to cause chip breakdown.
 |  | For all bus, such as I2S/I2C/PCM/SPI/SDIO/SDMMC, CLK signal series resistor must be placed close to source end (sending end). | Mandatory | Design requirement
 |  | For the SDIO/SDMMC bus, the series matching resistor on the data signal should be placed close to the CPU end (within 400mil). | Mandatory | Design requirement
 | PCB | For high-speed PCB design, please refer to the constraints in the "Rockchip_RV1126_RV1109_High_Speed_PCB_Design_Guide" document. | Mandatory | Design requirement
 |  | For I2S/PCM/SDIO/SDMMC bus, CLK signal must be surround by GND to reduce interference，The ground trace should be added with at least one GND via every 400mil (if the trace is not surround by GND, but it meets the 3W rule, there is nothing Problem. Once surround by GND, the GND via must be added, otherwise the effect is worse). The other signals of the bus as a group, surround by GND and isolated from other signals, and it is not recommend to use the power plane with large current variation as the signal reference plane , or the wire is routed near the SW terminal of the DC-DC. | Mandatory | Design requirement
Extended requirement | Schematic
 | PCB

Sheet: USB
Type |  | Item | Requirement | Risk & Influence | Is it verified? | Reviewer | Remark
Platform commonality | Schematic | Please place the 0.1uF decoupling capacitor as close the USB_AVDD_1V0/1V8/3V3 power pin as possible. | Mandatory | Design requirement
 |  | OTG_EXTR and HOST_EXTR should select 200ohm resistors with 1% accuracy. | Mandatory | Design requirement
 |  | DP/DM differential pair suggest to series connect a 2.2ohm resistor or common mode inductance . | Mandatory | Design requirement
 |  | Place ESD protection component (ex. TVS) as close as possible to the USB connector.The max junction capacitance of TVS should not exceed 3pF for USB2.0. | Mandatory | Design requirement
 |  | USB OTG port is the system firmware download port, the main board must reserve the port. | Mandatory | Design requirement
 |  | OTG ID series connected 100ohm resistor. | Mandatory | Design requirement
 | PCB | For high-speed PCB design, please refer to the constraints in the "Rockchip_RV1126_RV1109_High_Speed_PCB_Design_Guide" document. | Mandatory | Design requirement
 |  | USB differential pair should control impedance. The differential impedance is 90Ω ±10%. | Mandatory | Design requirement
 |  | USB differential pair trace should routing strictly follow the differential rule. For example,must be kept as same length, same width, same layer and fixed space gap,and also be kept as symmetric as possible. | Mandatory | Design requirement
 |  | If the USB differential pair is routed across different planes, an accompanying ground is required; Corners of the traces should use arcs or obtuse angles instead of right angles or acute angles. | Mandatory | Design requirement
 |  | Keep USB differential pair at least 12mil away from power or ground plane (or traces), signal traces and vias. | Mandatory | Design requirement
 |  | When the USB differential signal trace needs to be change layers, make sure that the number of vias on the trace is less than 6, and place ground stitching vias close to signal vias. | Mandatory | Design requirement
 |  | OTG_EXTR and HOST_EXTR resistor should be placed close to the CPU end. | Mandatory | Design requirement
 |  | If use USB for battery charging, VBUS trace needs to be able to support 2.5A current. | Mandatory | Design requirement
 |  | USB connectors should be far away from high EMI sources such as RF antennas, camera and so on. | Mandatory | Design requirement
 |  | TVS protection diodes are placed as close as possible to USB port. Signal topology is: USB port--->TVS--->CPU; when ESD occurs, ESD current must first be attenuated by TVS components.TVS components traces should not have trace stub. | Mandatory | Design requirement
Extended requirement | Schematic | Reserve a common mode choke on USB differential pair. | Optional | Eye diagram does not conform with protocol specification
 | PCB | Common mode choke should be placed close to the USB port. | Optional | Design requirement

Sheet: DRAM
Type |  | Item | Requirement | Risk & Influence | Is it verified? | Reviewer | Remark
Platform commonality | Schematic | Please change the value of RK809-2 FB3（pin27）divider resistor according to different types of DDR components to make VCC_DDR output voltage match with the component. | Mandatory | Design requirement
 | PCB | For high-speed PCB design, please refer to the constraints in the "Rockchip_RV1126_RV1109_High_Speed_PCB_Design_Guide" document. | Mandatory | Design requirement
 |  | Please use the DDR reference template provided by Rockchip. | Mandatory | Design requirement
 |  | All DDR signals should control impedance. The differential impedance is 100Ω ±10%, and the single-ended impedance is 50Ω ±10%. | Mandatory | Design requirement
 |  | The reference layer of the DDR trace needs to be a complete plane, and the range of the reference plane needs to be more than 12mil wider than the outermost trace. Avoid the situation of continuous via blocking signal return path. | Mandatory | Design requirement
 |  | The VCC_DDR power plane remains complete, do not route in the plane. | Mandatory | Design requirement
 |  | When the signal changes layers, the reference layer does not change, and it is always the GND plane. According to every 2 signal vias, add 1 GND via. When the signal changes layers, the reference layer changes, for example, from the GND plane to the VCC_DDR plane, and a stitching capacitor is added every 3 to 4 signal vias. | Mandatory | Design requirement
 |  | DDR circuit layout should be within the board as much as possible and away from the board edge and metal connectors to prevent DDR module from crashing due to abnormality caused by ESD. | Mandatory | Design requirement
Extended requirement | Schematic | Reserve the shield. If there are heat dissipation holes in a shield cover, please keep it away from DDR component position. | Optional
 | PCB

Sheet: FLASH
Type |  | Item | Requirement | Risk & Influence | Is it verified? | Reviewer | Remark
Platform commonality | Schematic | According to the supply voltage (1.8V or 3.3V) of Nand/eMMC Flash, the FLASH_VOL_SEL/GPIO0_B3 pin level is configured: Configuration high, the controller power supply VCCIO1_VDD and its IO voltage range are 1.8V. Configuration low, the controller power supply VCCIO1_VDD and its IO voltage range are 3.3V. | Mandatory | Design requirement
 |  | The 38 pin of NAND FLASH is series connected to the VCCIO_FLASH power supply by a 0 ohm resistor. Because some SLC particle PIN38 is write protection, if connected directly to high level, the software needs special treatment. After reserving 0 ohm, when encountering such SLC particles, remove 0 ohm resistance and floating PIN38. | Mandatory | Design requirement
 |  | The DATA0 and CMD signals of EMMC should reserve pull-up resistor to connect to VCCIO_FLASH power supply, which can not be deleted. | Mandatory | Design requirement
 |  | EMMC_CLK doesn't need pull-up resistor and capacitor. | Mandatory | Design requirement
 | PCB | For high-speed PCB design, please refer to the constraints in the "Rockchip_RV1126_RV1109_High_Speed_PCB_Design_Guide" document. | Mandatory | Design requirement
 |  | All EMMC signals should control impedance. The single-ended signal impedance is 50Ω ±10%. | Mandatory | Design requirement
 |  | Power trace width should meet the current requirements of controller and corresponding components (more than 25mil). | Mandatory | Design requirement
 |  | The 22ohm series matching resistor of EMMC_CLK should be close to CPU (source) end at layout (within 400mil). | Mandatory | Design requirement
 |  | EMMC_CLK signal should be routed separately and surrounded by GND, and ground trace should be added with at least one GND via every 400mil. | Mandatory | Design requirement
 |  | The EMMC_DATA/CMD as a group parallel routing and surround by GND, and follow the 3W rule. | Mandatory | Design requirement
Extended requirement | Schematic | When eMMC and Nand are compatible to design double Layout, attention should be paid to straightening out the routing and avoiding the long branches of EMMC_CLK. | Mandatory | Long branches will cause SI problems in EMMC_CLK.
 |  | When eMMC and Nand are compatible to design double Layout, the line must first pass through Nand's pin and then connect to EMMC's pin. | Mandatory | EMMC has a high speed. If the line first pass through eMMC's pin and then connect to Nand's pin, it will cause SI problem of the signal.
 | PCB

Sheet: Camera
Type |  | Item | Requirement | Risk & Influence | Is it verified? | Reviewer | Remark
Platform commonality | Schematic | MIPI_RX0_AVDD_0V8、MIPI_RX1_AVDD_1V8、MIPI_RX0_AVDD_1V8 and MIPI_RX1_AVDD_1V8 power pins need to series connect 1ohm resistors. | Mandatory | Design requirement
 |  | When used as camera function, VCCIO4 and VCCIO6 must use the same power supply to ensure that I2C/MCLK/PDN/RESET level should be match with DOVDD of Camera. | Mandatory | Design requirement
 |  | If camera has AF function, VCC2V8_AF requires separate power supply, or share with AVCC2V8_DVP using chip ferrite bead to isolate. | Mandatory | Design requirement
 |  | DVDD voltage of CAMERA has different conditions such as 1.2V / 1.5V / 1.8V, etc. Please provide accurate power supply according to the specification of Camera. | Mandatory | Design requirement
 | PCB | For high-speed PCB design, please refer to the constraints in the "Rockchip_RV1126_RV1109_High_Speed_PCB_Design_Guide" document. | Mandatory | Design requirement
 |  | MIPI CSI differential pair should control impedance. The differential impedance is 100Ω ±10%. | Mandatory | Design requirement
 |  | CIF_CLKIN (PCLK)/CIF_CLKOUT (MCLK) signal should be routed separately and surrounded by GND, and ground trace should be added with at least one GND via every 500mil. | Mandatory | Design requirement
 |  | The CIF_D0-D15/VSYNC/HREF as a group parallel routing and surround by GND, and follow the 3W rule. | Mandatory | Design requirement
 |  | MIPI CSI differential pair should routing strictly follow the differential rule. For example,must be kept as same length, same width, same layer and fixed space gap,and also be kept as symmetric as possible. | Mandatory | Design requirement
 |  | MIPI CSI differential pair must be routed over complete ground plane and not cross different plane. Corners of the traces should use arcs or obtuse angles instead of right angles or acute angles. | Mandatory | Design requirement
 |  | MIPI CSI differential pair as a group parallel routing and surround by GND, the distance from the GND signal follow the 3W rule and the ground trace should be added with at least one GND via every 300mil. MIPI CSI differential pair as a group parallel routing and if not surround by GND, the distance away from othe signals at least 12mil . | Mandatory | Design requirement
 |  | If there is a reserved test point for the MIPI CSI connector, they should be close to the connector, and the stub on the trace should be as short as possible. | Mandatory | Design requirement
 |  | CAMERA layout should be far away from the high power radiation components such as GMS antenna etc. | Mandatory | Design requirement
 |  | The decoupling capacitors of AVDD/DOVDD/DVDD power of connectors all need to be placed as close as possible to CAMERA connector. | Mandatory | Design requirement
Extended requirement | Schematic
 | PCB

Sheet: Audio
Type |  | Item | Requirement | Risk & Influence | Is it verified? | Reviewer | Remark
Platform commonality | Schematic | Select the bias resistance of electret microphone according to the actual specification parameter. | Mandatory | Design requirement
 |  | The bias power of microphone needs 68-100ohm resistor and 4.7uF or more capacitor for RC filtering. | Mandatory | Design requirement
 | PCB | The magnetic bead series connected with SPK_OUT network of PMIC Codec should be placed close to the output(source end) of PMIC. | Mandatory | Design requirement
 |  | The trace of VCC_SPK_HP of PMIC Codec is bigger than 50mil. | Mandatory | Design requirement
 |  | HP_SNS network series connected resistor must be short connected to GND in earphone socket pin. | Mandatory | Design requirement
 |  | HP_SNS is used as a concomitant VSS for HPL / HPR signals. The whole group should be surrounded by GND. The HPL/HPR trace width is more than 10mil. | Mandatory | Design requirement
 |  | SPKP/SPKN should be routed according to the difference and the whole group should be surrounded by GND, the trace width is 20mil. | Mandatory | Design requirement
 |  | When MIC is connected with single end, MIC1/MIC2 should be routed separately and surrounded by GND. When MIC is connected with the differential, MICP/MICN should be routed according to the differential and the whole group should be surrounded by GND. | Mandatory | Design requirement
 |  | Keep all audio signals away from high-speed signal lines such as LCD and DRAM, and follow the 3W rule. It is forbidden to route the adjacent layers of high-speed signal lines; it is forbidden to drill holes and change layers near high-speed signal lines; the traces should not pass through the inductor area; Away from RF signals and equipment. | Mandatory | Design requirement
 |  | TVS protection diodes are placed as close as possible to headphone/microphone. Signal topology is: headphone/microphone--->TVS--->CPU; when ESD occurs, ESD current must first be attenuated by TVS components.TVS components traces should not have trace stub. | Mandatory | Design requirement
Extended requirement | Schematic
 | PCB

Sheet: Display
Type |  | Item | Requirement | Risk & Influence | Is it verified? | Reviewer | Remark
Platform commonality | Schematic | LCDC_CLK network 33ohm series connection resistor is placed near the chip end (source end) to reduce signal reflection. | Mandatory | Design requirement
 |  | For the signals such as RGB/MIPI etc., if it is board-to-board connected by connectors, recommend to series connect resistors with a certain resistance value (2.2ohm-10ohm, subject to the SI specification) for all the signals, and reserve TVS components. | Mandatory | Prevent the strong static electricity and strong surge in the production process, leading to the breakdown of the chip pin.
 | PCB | For high-speed PCB design, please refer to the constraints in the "Rockchip_RV1126_RV1109_High_Speed_PCB_Design_Guide" document. | Mandatory | Design requirement
 |  | MIPI DSI differential pair should control impedance. The differential impedance is 100Ω ±10%. | Mandatory | Design requirement
 |  | MIPI DSI differential pair should routing strictly follow the differential rule. For example,must be kept as same length, same width, same layer and fixed space gap,and also be kept as symmetric as possible. | Mandatory | Design requirement
 |  | MIPI DSI differential pair must be routed over complete ground plane and not cross different plane. Corners of the traces should use arcs or obtuse angles instead of right angles or acute angles. | Mandatory | Design requirement
 |  | MIPI DSI differential pair as a group parallel routing and surround by GND, the distance from the GND signal follow the 3W rule and the ground trace should be added with at least one GND via every 300mil. MIPI DSI differential pair as a group parallel routing and if not surround by GND, the distance away from othe signals at least 12mil . | Mandatory | Design requirement
 |  | If there is a reserved test point for the MIPI DSI connector, they should be close to the connector, and the stub on the trace should be as short as possible. | Mandatory | Design requirement
 |  | The whole group of RGB signals should be surrounded by GND and distance from the othe signals follow the 3W rule. | Mandatory | Design requirement
 |  | The CLK signal of RGB should be routed separately and surrounded by GND, and the ground trace should be added with at least one GND via every 500mil. | Mandatory | Design requirement
Extended requirement | Schematic
 | PCB

Sheet: LCM&TP
Type |  | Item | Requirement | Risk & Influence | Is it verified? | Reviewer | Remark
Platform commonality | Schematic | The current-limiting resistor of FB pin of LED backlight booster IC should select 1% accuracy, and choose the appropriate package size according to the power requirements. | Mandatory | Design requirement
 |  | EN/PWM pin of LED backlight boost IC needs to select the internal pull-down GPIO, and connect pull-down resistor to avoid the screen flicker when power-on. | Mandatory | Design requirement
 |  | LED backlight driving voltage output should select the filter capacitor with appropriate rated voltage (DC). | Mandatory | Design requirement
 |  | For the Schottky diode of the LED backlight boost circuit, please select the appropriate model according to the operating current, and pay attention to the reverse breakdown voltage of the diode to avoid reverse breakdown during no-load. | Mandatory | Design requirement
 |  | The signal level of the screen and touch screen should match the IO drive level of the CPU, such as Reset/Standby signals. | Mandatory | Design requirement
 |  | I2C bus of TP must add 2.2Kohm pull-up to VCC3V3_TP power. | Mandatory | Design requirement
 |  | For TP IC with Charge pump, please pay attention to the rated voltage of capacitor. | Mandatory | Design requirement
 |  | For Screen panel, when connect board with FPC cnnectors, recommend to series connect resistors with a certain resistance (22ohm-100ohm, subject to the SI specification), and reserve TVS components. | Mandatory | Design requirement
 |  | Screen interface is recommended to reserve common mode inductor. | Mandatory | Design requirement
 | PCB | The current-limiting resistor of FB pin of LED backlight IC should be placed close to the panel socket instead of DC-DC. | Mandatory | Design requirement
 |  | Backlight booster circuit, please pay attention to capacitor placement and power wiring to ensure the minimum charge and discharge circuit of the power supply. | Mandatory | Design requirement
 |  | If there are reserved test points for the screen and touch screen connector, they should be close to the connector, and the stub on the trace should be as short as possible. | Mandatory | Design requirement
Extended requirement | Schematic
 | PCB

Sheet: Sensor
Type |  | Item | Requirement | Risk & Influence | Is it verified? | Reviewer | Remark
Platform commonality | Schematic | When I2C bus is shared by multiple devices, make sure there is pull-up resistor added in I2C bus and no conflict among the devices address. | Mandatory | Design requirement
 |  | Make sure VCCIO power supply of sensor is consistent with the power domain of I2C/SPI bus, otherwise the current leakage will occur. | Mandatory | Design requirement
 | PCB | Place decoupling capacitors close to sensor. | Mandatory | Design requirement
 |  | Magnetic sensitive sensors (such as compass sensors) need to stay away from strong magnetic fields, easily magnetizable components, high current components etc. such as earphone, motor, speaker, camera, screw, big inductor and big capacitor and so on. Besides, they cannot be placed inside the shield. | Mandatory | Design requirement
 |  | Magnetic sensitive sensors (such as compass sensors) cannot be placed in the area of the copper and trace of power, otherwise it will be influenced by the magnetic field produced by the current. | Mandatory | Design requirement
 |  | For MEMS devices, pay attention to the balanced routing in the four directions when the PCB is fanout. It is not allowed to lay copper in a large area in a single direction to avoid sensor parameter drift caused by stress. | Mandatory | Design requirement
 |  | MEMS devices, ultrasonic cleaning is not allowed during production. | Mandatory | Design requirement
Extended requirement | Schematic
 | PCB

Sheet: Micro-SD Card
Type |  | Item | Requirement | Risk & Influence | Is it verified? | Reviewer | Remark
Platform commonality | Schematic | SDMMC_CLK series connection resistor is close to the source end, that is, placed on the CPU end. | Mandatory | Design requirement
 |  | SDMMC_DET serial connection resistors are placed close to the source end (card end) to avoid the CPU end IO damage caused by frequent card insertion and removal. | Mandatory | Design requirement
 |  | When Sdcard bus supports 3.0 card, TVS protection diodes load capacitances do not exceed 0.5pF. | Mandatory | Design requirement
 |  | It is recommended to reserve test points for the multiplexed pins of SDMMC and UART/JTAG, which is convenient for connecting the serial port/JTAG during the debugging stage. | Optional
 |  | Do not delete VCC_SD power decoupling capacitor in Micro-SD connector. | Mandatory | Design requirement
 | PCB | For high-speed PCB design, please refer to the constraints in the "Rockchip_RV1126_RV1109_High_Speed_PCB_Design_Guide" document. | Mandatory | Design requirement
 |  | All SDMMC signals should control impedance. The single-ended signal impedance is 50Ω ±10%. | Mandatory | Design requirement
 |  | SDMMC_CLK signal should be routed separately and surrounded by GND, and ground trace should be added with at least one GND via every 400mil. | Mandatory | Design requirement
 |  | The SDMMC_DATA/CMD as a group parallel routing and surround by GND, and follow the 3W rule. | Mandatory | Design requirement
 |  | Try to avoid routing in the area below Micro-SD card connector to avoid coupling caused by ESD occurs. | Mandatory | Design requirement
 |  | TVS protection diodes are placed as close as possible to Micro-SD connector. Signal topology is: connector--->TVS--->CPU; when ESD occurs, ESD current must first be attenuated by TVS components. TVS components traces should not have trace stub. | Mandatory | Design requirement
Extended requirement | Schematic
 | PCB

Sheet: WIFI&BT
Type |  | Item | Requirement | Risk & Influence | Is it verified? | Reviewer | Remark
Platform commonality | Schematic | Please ensure that the IO level of the module is consistent with the IO level of the CPU, otherwise level matching needs to do the level shift. | Mandatory | Design requirement
 |  | The value of crystal load capacitors should be selected according to CL of the crystal, and having a frequency tolerance of ±10ppm at +25°C. | Mandatory | Design requirement
 |  | Reserve π-type circuit for antenna matching adjustment. | Mandatory | Design requirement
 |  | Confirm the connection direction of PCM and UART interfaces, such as IN and OUT, TXD and RXD. | Mandatory | Design requirement
 |  | If you use a module that requires a 32.768k clock input, you need to pay attention to the clock amplitude. | Mandatory | Design requirement
 | PCB | For high-speed PCB design, please refer to the constraints in the "Rockchip_RV1126_RV1109_High_Speed_PCB_Design_Guide" document. | Mandatory | Design requirement
 |  | Module should be far away from other high-speed signal traces and connectors such as DDR, HDMI, USB and so on. | Mandatory | Design requirement
 |  | The TOP layer below the module does not allow wiring. It is necessary to ensure that the reference plane is a complete ground plane. SDIO signals routing should bypass module projection area and then connect to the module pins. | Mandatory | Design requirement
 |  | Give priority to crystal circuit when layout, and place as close as possible to the module in the same layer to avoid vias. Crystal traces is as short as possible，far away from the interference source, and needs to surround by GND. | Mandatory | Design requirement
 |  | If the crystal circuit layout is placed in a different layer from the module, the traces and vias need to be kept at a distance of more than 12mil from other signals to avoid interference. | Mandatory | Design requirement
 |  | The crystal and clock signal must ensure the integrity of the ground reference plane of the adjacent layer, and the clock signal needs to surround by GND.The ground trace should be added with at least one GND via every 400mil. | Mandatory | Design requirement
 |  | All SDIO signals should control impedance. The single-ended signal impedance is 50Ω ±10%. | Mandatory | Design requirement
 |  | SDIO_CLK signal should be routed separately and surrounded by GND, and ground trace should be added with at least one GND via every 400mil. | Mandatory | Design requirement
 |  | The SDIO_DATA/CMD as a group parallel routing and surround by GND, and follow the 3W rule. | Mandatory | Design requirement
 |  | Module power traces need to adopt a star shape layout to reduce the mutual interference among different power traces. | Mandatory | Design requirement
 |  | Power filter capacitors layout should be as close as possible to the chip pins. They should be placed on the same layer of WIFI chip or module. Current needs to flow through capacitors before entering the chip. | Mandatory | Design requirement
 |  | When the inductor of the module is laid out, please note that after the trace comes out of the inductor, it passes through the capacitor first, and then enters the power supply pin | Mandatory | Design requirement
 |  | The impedance of antenna input/output ports is 50ohm, with reference ground of interlayer, surrounding clearance GND which connect multiple vias to main ground, and do not allow crossover with other signal traces or power. | Mandatory | Design requirement
Extended requirement | Schematic | RF trace should reserve a test connector. | Optional | Convenient for factory testing and antenna tunning.
 | PCB | Reserve the shield position around modules, and make PCB solder mask opening. | Optional
