cnchens/RV1126_RV1109_Hardware_Design_Template/01_Common Document/RV1126_RV1109_PINOUT_EN_V1.2_20201030.xlsx

Sheet: CoverPage
RV1126_RV1109
Pin List and Pin Information
Revision: V1.2
Date: 2020/10/30
Status: Draft
Rockchip Confidential

Sheet: Statement
保密提示： 本文档及其附件可能含有机密信息，来自瑞芯微电子股份有限公司，仅发送给指定接收者。若非该特定接收人，请勿复制、 使用或披露本文档的任何内容。若误收本文档，请从系统中永久性删除本文档，并以回复邮件或其他方式即刻告知发件人。瑞芯微电子股份有限公司拥有本文档信息的著作权及解释权，禁止任何未经授权许可的侵权行为。 IMPORTANT NOTICE: This document is from Rockchip Electronics Co., Ltd. .The contents of this document and any attachments may contain information that is privileged, confidential and/or exempt from disclosure under applicable law and relevant NDA. If you are not the intended recipient, you are hereby notified that any disclosure, copying, distribution, or use of the information is STRICTLY PROHIBITED. Please immediately contact the sender as soon as possible and destroy the material in its entirety in any format. Thank you.

Sheet: Revision History
Revision History
Revision | Description | Editor | Revision Date
V1.0 | First edition. | Li Yanhong | 2020.04.10
V1.1 | update MCU | Li Yanhong | 2020.06.23
V1.2 | update： 1.Delect BT.656 TX function | Li Yanhong | 2020.10.30

Sheet: 0.Description
Sheet Description
1. The Pin Information sheet describes the pin numbers, functions,characteristics, and corresponding configuration registers. 2. The Function Signal sheet describes the function signals and their multiplexed pins. 3. The Pin Control registers sheet describes the rigister address of the pins and the configurations of multiplexing relationships, driver capability, and pull-up and pull-down ,default IO drive strenth,input enable,schmitt trigger enable. 4. The Ball Map sheet describes the ball position distribution.
Pin Types Describtion
CI | Crystal Oscillator Input
CO | Crystal Oscillator Drive Output
I | Input
O | Output
I/O | Input/Output
B | Bidirection signal
A | Analog setting or filtering
AI | Analog Input
AO | Analog Output
AI/O | Analog Input/Output
PI | Power Supply
PO | Power Output
API | Analog Power Supply
APO | Analog Power Output
G | Ground
AG | Analog Ground
UP | Internal Pull-up
DOWN | Internal Pull-down
High-Z | high impedance
R_PU28K | Pull up resistance normal value 28Kohm
R_PD29K | Pull down resistance normal value 29Kohm
Abbreviations Describtion
_u | Default Internal Pull-up
_d | Default Internal Pull-down
_z | Default Tri-State
_od | Open Drain Output
_5V | Support 5V Tolerant Input
_od5V | Support 5V Tolerant Input ,Open Drain Output

Sheet: 1.Pin Information
Pin Number | Pin Name | Level State | default I/O Type | Default Io Driver Current |  |  |  | Power Domain | Supply Voltage | Pin Type | Schmitt Trigger | Interruptable | IO Config Register |  |  |  |  | Function Description
 |  |  |  | DS3 | DS2 | DS1 | DS0 |  |  |  |  |  | Driver strength control register | PU/PD control register | Input enable control register | Schmitt trigger control register | IOMUX control register | function Number | Signal Name | Direction | Description
OSC/PLL | 6 balls
Y9 | XOUT24M |  |  |  |  |  |  | PMU/PLL | 1.8V | CO | -- | -- | PMUGRF_OSC_DS | -- | -- | -- | -- | 0 | XOUT24M | O | Clock output of 24MHz crystal
AA9 | XIN24M |  |  |  |  |  |  | PMU/PLL | 1.8V | CI | -- | -- |  | -- | -- | -- | -- | 0 | XIN24M | I | Clock input of 24MHz crystal
P11 | PLL_AVDD_0V8 |  |  |  |  |  |  | PLL | 0.8V | PI | -- | -- | -- | -- | -- | -- | -- | 0 | PLL_AVDD_0V8 | -- | PLL 0.8V supply
R11 | PLL_AVDD_1V8 |  |  |  |  |  |  | PLL | 1.8V | PI | -- | -- | -- | -- | -- | -- | -- | 0 | PLL_AVDD_1V8 | -- | PLL 1.8V supply
P10 | PMUIO_VDD_0V8 |  |  |  |  |  |  | PMUIO0/1 | 0.8V | PI | -- | -- | -- | -- | -- | -- | -- | 0 | PMUIO_VDD_0V8 | -- | PUMIO0/1 0.8V supply
R10 | PMUIO_VDD_1V8 |  |  |  |  |  |  | PMUIO0/1 | 1.8V | PI | -- | -- | -- | -- | -- | -- | -- | 0 | PMUIO_VDD_1V8 | -- | PUMIO0/1 1.8V supply
PMUIO0 | 12 Balls |  |  |  |  |  |  | Power Supply | Supply Voltage | Pin Type | Schmitt Trigger | Interruptable | Driver strength control register | PU/PD control register | Input enable control register | Schmitt trigger control register | IOMUX control register | function Number | Signal Name | Direction | Description
W7 | NPOR_u | UP | I | NA | NA | 0 | 1 | PMUIO0 | 1.8V/3.3V | I | √ | -- | -- | -- | -- | -- | -- | 0 | IO_NPOR | I | Reset signal, active low
T8 | TVSS_d | DOWN | I | NA | NA | 0 | 1 | PMUIO0 | 1.8V/3.3V | I | √ | -- | -- | -- | -- | -- | -- | 0 | TVSS | I | Mode Select: TVSS = 0 function mode, default 0. TVSS = 1 test mode.
W6 | CLK_REF/GPIO0_A0_d | DOWN | I | 0 | 0 | 0 | 1 | PMUIO0 | 1.8V/3.3V | I/O | √ | √ | PMUGRF_GPIO0A_DS_L | PMUGRF_GPIO0A_P | PMUGRF_GPIO0A_IE | PMUGRF_GPIO0A_SMT | PMUGRF_GPIO0A_IOMUX_L | 0 | GPIO0_A0 | B | GPIO
 |  |  |  |  |  |  |  |  |  |  |  |  |  |  |  |  |  | 1 | CLK_REF | O | Clock output
Y5 | TSADC_SHUT_M0/TSADC_SHUTORG/GPIO0_A1_z | High-Z | I | NA | NA | 0 | 1 | PMUIO0 | 1.8V/3.3V | I/O | √ | √ | PMUGRF_GPIO0A_DS_L | PMUGRF_GPIO0A_P | PMUGRF_GPIO0A_IE | PMUGRF_GPIO0A_SMT | PMUGRF_GPIO0A_IOMUX_L | 0 | GPIO0_A1 | B | GPIO
 |  |  |  |  |  |  |  |  |  |  |  |  |  |  |  |  |  | 1 | TSADC_SHUT_M0 | O | Temperature sensor ADC,connected with primary reset and watchdog reset
 |  |  |  |  |  |  |  |  |  |  |  |  |  |  |  |  |  | 2 | TSADC_SHUTORG | O | Temperature sensor ADC
AA3 | CLKI_CLKO_32K/GPIO0_A2_z | High-Z | I | 0 | 0 | 0 | 1 | PMUIO0 | 1.8V/3.3V | I/O | √ | √ | PMUGRF_GPIO0A_DS_L | PMUGRF_GPIO0A_P | PMUGRF_GPIO0A_IE | PMUGRF_GPIO0A_SMT | PMUGRF_GPIO0A_IOMUX_L | 0 | GPIO0_A2 | B | GPIO
 |  |  |  |  |  |  |  |  |  |  |  |  |  |  |  |  |  | 1 | CLKI_CLKO_32K | B | 32.768KHz clock output or input
U7 | SDMMC0_DET/GPIO0_A3_u | UP | I | NA | NA | 0 | 1 | PMUIO0 | 1.8V/3.3V | I/O | √ | √ | PMUGRF_GPIO0A_DS_L | PMUGRF_GPIO0A_P | PMUGRF_GPIO0A_IE | PMUGRF_GPIO0A_SMT | PMUGRF_GPIO0A_IOMUX_L | 0 | GPIO0_A3 | B | GPIO
 |  |  |  | NA | NA | 0 | 1 |  |  |  |  |  |  |  |  |  |  | 1 | SDMMC0_DET | I | SDMMC0 card detect signal, 0 represents presence of card
V7 | SPI0_CS1n_M0/GPIO0_A4_u | UP | I | NA | NA | 0 | 1 | PMUIO0 | 1.8V/3.3V | I/O | √ | √ | PMUGRF_GPIO0A_DS_H | PMUGRF_GPIO0A_P | PMUGRF_GPIO0A_IE | PMUGRF_GPIO0A_SMT | PMUGRF_GPIO0A_IOMUX_H | 0 | GPIO0_A4 | B | GPIO
 |  |  |  | NA | NA | 0 | 1 |  |  |  |  |  |  |  |  |  |  | 1 | SPI0_CS1n_M0 | B | CS signal1 of SPI0
AA2 | SPI0_CS0n_M0/GPIO0_A5_u | UP | I | NA | NA | 0 | 1 | PMUIO0 | 1.8V/3.3V | I/O | √ | √ | PMUGRF_GPIO0A_DS_H | PMUGRF_GPIO0A_P | PMUGRF_GPIO0A_IE | PMUGRF_GPIO0A_SMT | PMUGRF_GPIO0A_IOMUX_H | 0 | GPIO0_A5 | B | GPIO
 |  |  |  | NA | NA | 0 | 1 |  |  |  |  |  |  |  |  |  |  | 1 | SPI0_CS0n_M0 | B | CS signal0 of SPI0
V6 | SPI0_MOSI_M0/GPIO0_A6_d | DOWN | I | NA | NA | 0 | 1 | PMUIO0 | 1.8V/3.3V | I/O | √ | √ | PMUGRF_GPIO0A_DS_H | PMUGRF_GPIO0A_P | PMUGRF_GPIO0A_IE | PMUGRF_GPIO0A_SMT | PMUGRF_GPIO0A_IOMUX_H | 0 | GPIO0_A6 | B | GPIO
 |  |  |  | NA | NA | 0 | 1 |  |  |  |  |  |  |  |  |  |  | 1 | SPI0_MOSI_M0 | O | SPI0 output data
W5 | SPI0_MISO_M0/GPIO0_A7_d | DOWN | I | NA | NA | 0 | 1 | PMUIO0 | 1.8V/3.3V | I/O | √ | √ | PMUGRF_GPIO0A_DS_H | PMUGRF_GPIO0A_P | PMUGRF_GPIO0A_IE | PMUGRF_GPIO0A_SMT | PMUGRF_GPIO0A_IOMUX_H | 0 | GPIO0_A7 | B | GPIO
 |  |  |  | NA | NA | 0 | 1 |  |  |  |  |  |  |  |  |  |  | 1 | SPI0_MISO_M0 | I | SPI0 input data
Y4 | SPI0_CLK_M0/GPIO0_B0_d | DOWN | I | 0 | 0 | 0 | 1 | PMUIO0 | 1.8V/3.3V | I/O | √ | √ | PMUGRF_GPIO0B_DS_L | PMUGRF_GPIO0B_P | PMUGRF_GPIO0B_IE | PMUGRF_GPIO0B_SMT | PMUGRF_GPIO0B_IOMUX_L | 0 | GPIO0_B0 | B | GPIO
 |  |  | I |  |  |  |  |  |  |  |  |  |  |  |  |  |  | 1 | SPI0_CLK_M0 | O | SPI0 clock signal
R9 | PMUIO0_VDD |  |  |  |  |  |  | PMUIO0 | 1.8V/3.3V | PI | -- | -- | -- | -- | -- | -- | -- | 0 | PMUIO0_VDD | -- | 1.8V/3.3V I/O power of PMUIO0
PMUIO1 | 12 Balls |  |  |  |  |  |  | Power Supply | Supply Voltage | Pin Type | Schmitt Trigger | Interruptable | Driver strength control register | PU/PD control register | Input enable control register | Schmitt trigger control register | IOMUX control register | function Number | Signal Name | Direction | Description
W10 | PMIC_IN/PWM7_IR_M0/GPIO0_B1_d | DOWN | I | NA | NA | 0 | 1 | PMUIO1 | 1.8V/3.3V | I/O | √ | √ | PMUGRF_GPIO0B_DS_L | PMUGRF_GPIO0B_P | PMUGRF_GPIO0B_IE | PMUGRF_GPIO0B_SMT | PMUGRF_GPIO0B_IOMUX_L | 0 | GPIO0_B1 | B | GPIO
 |  | DOWN | I | NA | NA | 0 | 1 |  |  |  |  |  |  |  |  |  |  | 1 | PMIC_INT | I | PMIC interrupt input signal
 |  | DOWN | I | NA | NA | 0 | 1 |  |  |  |  |  |  |  |  |  |  | 3 | PWM7_IR_M0 | B | Pulse Width Modulation input or output, used for IR application recommended
Y10 | PMIC_SLEEP/TSADC_SHUT_M1/PWM6_M0/GPIO0_B2_d | DOWN | I | NA | NA | 0 | 1 | PMUIO1 | 1.8V/3.3V | I/O | √ | √ | PMUGRF_GPIO0B_DS_L | PMUGRF_GPIO0B_P | PMUGRF_GPIO0B_IE | PMUGRF_GPIO0B_SMT | PMUGRF_GPIO0B_IOMUX_L | 0 | GPIO0_B2 | B | GPIO
 |  | UP | I | NA | NA | 0 | 1 |  |  |  |  |  |  |  |  |  |  | 1 | PMIC_SLEEP | O | mode Select: PMIC_SLEEP= 0 operation mode, default 0. PMIC_SLEEP= 1 Sleep mode.
 |  | DOWN | I | NA | NA | 0 | 1 |  |  |  |  |  |  |  |  |  |  | 2 | TSADC_SHUT_M1 | O | Temperature sensor ADC,connected with primary reset and watchdog reset
 |  | DOWN | I | NA | NA | 0 | 1 |  |  |  |  |  |  |  |  |  |  | 3 | PWM6_M0 | B | Pulse Width Modulation input or output
Y8 | FLASH_VOL_SEL/GPIO0_B3_d | DOWN | I | NA | NA | 0 | 1 | PMUIO1 | 1.8V/3.3V | I/O | √ | √ | PMUGRF_GPIO0B_DS_L | PMUGRF_GPIO0B_P | PMUGRF_GPIO0B_IE | PMUGRF_GPIO0B_SMT | PMUGRF_GPIO0B_IOMUX_L | 0 | GPIO0_B3 | B | GPIO
 |  | DOWN | I | NA | NA | 0 | 1 |  |  |  |  |  |  |  |  |  |  | 1 | FLASH_VOL_SEL | I | FLASH voltage Selete: FLASH_VOL_SEL=1, FLASH IO Voltage is 1.8V. FLASH_VOL_SEL float, FLASH IO Voltage is 3.3V.
AA7 | I2C0_SCL/GPIO0_B4_u | UP | I | NA | NA | 0 | 1 | PMUIO1 | 1.8V/3.3V | I/O | √ | √ | PMUGRF_GPIO0B_DS_H | PMUGRF_GPIO0B_P | PMUGRF_GPIO0B_IE | PMUGRF_GPIO0B_SMT | PMUGRF_GPIO0B_IOMUX_H | 0 | GPIO0_B4 | B | GPIO
 |  | DOWN | I | NA | NA | 0 | 1 |  |  |  |  |  |  |  |  |  |  | 1 | I2C0_SCL | B | Clock of I2C bus0
Y7 | I2C0_SDA/GPIO0_B5_u | UP | I | NA | NA | 0 | 1 | PMUIO1 | 1.8V/3.3V | I/O | √ | √ | PMUGRF_GPIO0B_DS_H | PMUGRF_GPIO0B_P | PMUGRF_GPIO0B_IE | PMUGRF_GPIO0B_SMT | PMUGRF_GPIO0B_IOMUX_H | 0 | GPIO0_B5 | B | GPIO
 |  | DOWN | I | NA | NA | 0 | 1 |  |  |  |  |  |  |  |  |  |  | 1 | I2C0_SDA | B | Data/Address of I2C bus0
W8 | UART1_TX_M0/PWM0_M0/GPIO0_B6_d | DOWN | I | NA | NA | 0 | 1 | PMUIO1 | 1.8V/3.3V | I/O | √ | √ | PMUGRF_GPIO0B_DS_H | PMUGRF_GPIO0B_P | PMUGRF_GPIO0B_IE | PMUGRF_GPIO0B_SMT | PMUGRF_GPIO0B_IOMUX_H | 0 | GPIO0_B6 | B | GPIO
 |  | UP | I | NA | NA | 0 | 1 |  |  |  |  |  |  |  |  |  |  | 2 | UART1_TX_M0 | O | UART1 TX data
 |  | UP | I | NA | NA | 0 | 1 |  |  |  |  |  |  |  |  |  |  | 3 | PWM0_M0 | B | Pulse Width Modulation input or output
V9 | UART1_RX_M0/PWM1_M0/GPIO0_B7_d | DOWN | I | NA | NA | 0 | 1 | PMUIO1 | 1.8V/3.3V | I/O | √ | √ | PMUGRF_GPIO0B_DS_H | PMUGRF_GPIO0B_P | PMUGRF_GPIO0B_IE | PMUGRF_GPIO0B_SMT | PMUGRF_GPIO0B_IOMUX_H | 0 | GPIO0_B7 | B | GPIO
 |  | DOWN | I | NA | NA | 0 | 1 |  |  |  |  |  |  |  |  |  |  | 2 | UART1_RX_M0 | I | UART1 RX data
 |  | DOWN | I | NA | NA | 0 | 1 |  |  |  |  |  |  |  |  |  |  | 3 | PWM1_M0 | B | Pulse Width Modulation input or output
U9 | SDMMC0_PWR /UART1_RTSN_M0/ PWM2_M0/GPIO0_C0_d | DOWN | I | NA | NA | 0 | 1 | PMUIO1 | 1.8V/3.3V | I/O | √ | √ | PMUGRF_GPIO0C_DS_L | PMUGRF_GPIO0C_P_L | PMUGRF_GPIO0C_IE_L | PMUGRF_GPIO0C_SMT_L | PMUGRF_GPIO0C_IOMUX_L | 0 | GPIO0_C0 | B | GPIO
 |  | DOWN | I | NA | NA | 0 | 1 |  |  |  |  |  |  |  |  |  |  | 1 | SDMMC0_PWR | O | Enable control signal of the SD card power supply
 |  | DOWN | I | NA | NA | 0 | 1 |  |  |  |  |  |  |  |  |  |  | 2 | UART1_RTSN_M0 | O | UART1 request-to-send signal
 |  | DOWN | I | NA | NA | 0 | 1 |  |  |  |  |  |  |  |  |  |  | 3 | PWM2_M0 | B | Pulse Width Modulation input or output
AA4 | PMU_DEBUG/UART1_CTSN_M0/PWM3_IR_M0/GPIO0_C1_d | DOWN | I | NA | NA | 0 | 1 | PMUIO1 | 1.8V/3.3V | I/O | √ | √ | PMUGRF_GPIO0C_DS_L | PMUGRF_GPIO0C_P_L | PMUGRF_GPIO0C_IE_L | PMUGRF_GPIO0C_SMT_L | PMUGRF_GPIO0C_IOMUX_L | 0 | GPIO0_C1 | B | GPIO
 |  | DOWN | I | NA | NA | 0 | 1 |  |  |  |  |  |  |  |  |  |  | 1 | PMU_DEBUG | B | PMU_DEBUG
 |  | UP | I | NA | NA | 0 | 1 |  |  |  |  |  |  |  |  |  |  | 2 | UART1_CTSN_M0 | I | UART1 clear-to-send signal
 |  | UP | I | NA | NA | 0 | 1 |  |  |  |  |  |  |  |  |  |  | 3 | PWM3_IR_M0 | B | Pulse Width Modulation input or output, used for IR application recommended
AA6 | I2C2_SCL/PWM4_M0/GPIO0_C2_d | DOWN | I | NA | NA | 0 | 1 | PMUIO1 | 1.8V/3.3V | I/O | √ | √ | PMUGRF_GPIO0C_DS_L | PMUGRF_GPIO0C_P_L | PMUGRF_GPIO0C_IE_L | PMUGRF_GPIO0C_SMT_L | PMUGRF_GPIO0C_IOMUX_L | 0 | GPIO0_C2 | B | GPIO
 |  | DOWN | I | NA | NA | 0 | 1 |  |  |  |  |  |  |  |  |  |  | 1 | I2C2_SCL | B | Clock of I2C bus2
 |  | DOWN | I | NA | NA | 0 | 1 |  |  |  |  |  |  |  |  |  |  | 3 | PWM4_M0 | B | Pulse Width Modulation input or output
Y6 | I2C2_SDA/PWM5_M0/GPIO0_C3_d | DOWN | I | NA | NA | 0 | 1 | PMUIO1 | 1.8V/3.3V | I/O | √ | √ | PMUGRF_GPIO0C_DS_L | PMUGRF_GPIO0C_P_L | PMUGRF_GPIO0C_IE_L | PMUGRF_GPIO0C_SMT_L | PMUGRF_GPIO0C_IOMUX_L | 0 | GPIO0_C3 | B | GPIO
 |  | DOWN | I | NA | NA | 0 | 1 |  |  |  |  |  |  |  |  |  |  | 1 | I2C2_SDA | B | Data/Address of I2C bus2
 |  | DOWN | I | NA | NA | 0 | 1 |  |  |  |  |  |  |  |  |  |  | 3 | PWM5_M0 | B | Pulse Width Modulation input or output
R8 | PMUIO1_VDD |  |  |  |  |  |  | PMUIO1 | 1.8V/3.3V | PI | -- | -- | -- | -- | -- | -- | -- | 0 | PMUIO1_VDD | -- | 1.8V/3.3V I/O power of PMUIO1
VCCIO1 | 17 Balls |  |  |  |  |  |  | Power Supply | Supply Voltage | Pin Type | Schmitt Trigger | Interruptable | Driver strength control register | PU/PD control register | Input enable control register | Schmitt trigger control register | IOMUX control register | function Number | Signal Name | Direction | Description
W2 | FLASH_D0/EMMC_D0/GPIO0_C4_u | UP | I | NA | NA | 0 | 1 | VCCIO1 | 1.8V/3.3V | I/O | √ | √ | GRF1_GPIO0C_DS_H | GRF1_GPIO0C_P_H | GRF1_GPIO0C_IE_H | GRF1_GPIO0C_SMT_H | GRF1_GPIO0C_IOMUX_H | 0 | GPIO0_C4 | B | GPIO
 |  |  |  | NA | NA | 0 | 1 |  |  |  |  |  |  |  |  |  |  | 1 | FLASH_D0 | B | NAND FLASH Data0
 |  |  |  | NA | NA | 0 | 1 |  |  |  |  |  |  |  |  |  |  | 2 | EMMC_D0 | B | EMMC Data0
W1 | FLASH_D1/EMMC_D1/GPIO0_C5_u | UP | I | NA | NA | 0 | 1 | VCCIO1 | 1.8V/3.3V | I/O | √ | √ | GRF1_GPIO0C_DS_H | GRF1_GPIO0C_P_H | GRF1_GPIO0C_IE_H | GRF1_GPIO0C_SMT_H | GRF1_GPIO0C_IOMUX_H | 0 | GPIO0_C5 | B | GPIO
 |  |  |  | NA | NA | 0 | 1 |  |  |  |  |  |  |  |  |  |  | 1 | FLASH_D1 | B | NAND FLASH Data1
 |  |  |  | NA | NA | 0 | 1 |  |  |  |  |  |  |  |  |  |  | 2 | EMMC_D1 | B | EMMC Data1
V4 | FLASH_D2/EMMC_D2/GPIO0_C6_u | UP | I | NA | NA | 0 | 1 | VCCIO1 | 1.8V/3.3V | I/O | √ | √ | GRF1_GPIO0C_DS_H | GRF1_GPIO0C_P_H | GRF1_GPIO0C_IE_H | GRF1_GPIO0C_SMT_H | GRF1_GPIO0C_IOMUX_H | 0 | GPIO0_C6 | B | GPIO
 |  |  |  | NA | NA | 0 | 1 |  |  |  |  |  |  |  |  |  |  | 1 | FLASH_D2 | B | NAND FLASH Data2
 |  |  |  | NA | NA | 0 | 1 |  |  |  |  |  |  |  |  |  |  | 2 | EMMC_D2 | B | EMMC Data2
V3 | FLASH_D3/EMMC_D3/GPIO0_C7_u | UP | I | NA | NA | 0 | 1 | VCCIO1 | 1.8V/3.3V | I/O | √ | √ | GRF1_GPIO0C_DS_H | GRF1_GPIO0C_P_H | GRF1_GPIO0C_IE_H | GRF1_GPIO0C_SMT_H | GRF1_GPIO0C_IOMUX_H | 0 | GPIO0_C7 | B | GPIO
 |  |  |  | NA | NA | 0 | 1 |  |  |  |  |  |  |  |  |  |  | 1 | FLASH_D3 | B | NAND FLASH Data3
 |  |  |  | NA | NA | 0 | 1 |  |  |  |  |  |  |  |  |  |  | 2 | EMMC_D3 | B | EMMC Data3
V2 | FLASH_D4/EMMC_D4/GPIO0_D0_u | UP | I | NA | NA | 0 | 1 | VCCIO1 | 1.8V/3.3V | I/O | √ | √ | GRF1_GPIO0D_DS_L | GRF1_GPIO0D_P | GRF1_GPIO0D_IE | GRF1_GPIO0D_SMT | GRF1_GPIO0D_IOMUX_L | 0 | GPIO0_D0 | B | GPIO
 |  |  |  | NA | NA | 0 | 1 |  |  |  |  |  |  |  |  |  |  | 1 | FLASH_D4 | B | NAND FLASH Data4
 |  |  |  | NA | NA | 0 | 1 |  |  |  |  |  |  |  |  |  |  | 2 | EMMC_D4 | B | EMMC Data4
V1 | FLASH_D5/EMMC_D5/FSPI_CS1n/GPIO0_D1_u | UP | I | NA | NA | 0 | 1 | VCCIO1 | 1.8V/3.3V | I/O | √ | √ | GRF1_GPIO0D_DS_L | GRF1_GPIO0D_P | GRF1_GPIO0D_IE | GRF1_GPIO0D_SMT | GRF1_GPIO0D_IOMUX_L | 0 | GPIO0_D1 | B | GPIO
 |  |  |  | NA | NA | 0 | 1 |  |  |  |  |  |  |  |  |  |  | 1 | FLASH_D5 | B | NAND FLASH Data5
 |  |  |  | NA | NA | 0 | 1 |  |  |  |  |  |  |  |  |  |  | 2 | EMMC_D5 | B | EMMC Data5
 |  |  |  | NA | NA | 0 | 1 |  |  |  |  |  |  |  |  |  |  | 3 | FSPI_CS1n | O | CS signal1 of SPI FLASH
U4 | FLASH_D6/EMMC_D6/GPIO0_D2_u | UP | I | NA | NA | 0 | 1 | VCCIO1 | 1.8V/3.3V | I/O | √ | √ | GRF1_GPIO0D_DS_L | GRF1_GPIO0D_P | GRF1_GPIO0D_IE | GRF1_GPIO0D_SMT | GRF1_GPIO0D_IOMUX_L | 0 | GPIO0_D2 | B | GPIO
 |  |  |  | NA | NA | 0 | 1 |  |  |  |  |  |  |  |  |  |  | 1 | FLASH_D6 | B | NAND FLASH Data6
 |  |  |  | NA | NA | 0 | 1 |  |  |  |  |  |  |  |  |  |  | 2 | EMMC_D6 | B | EMMC Data6
U3 | FLASH_D7/EMMC_D7/GPIO0_D3_u | UP | I | NA | NA | 0 | 1 | VCCIO1 | 1.8V/3.3V | I/O | √ | √ | GRF1_GPIO0D_DS_L | GRF1_GPIO0D_P | GRF1_GPIO0D_IE | GRF1_GPIO0D_SMT | GRF1_GPIO0D_IOMUX_L | 0 | GPIO0_D3 | B | GPIO
 |  |  |  | NA | NA | 0 | 1 |  |  |  |  |  |  |  |  |  |  | 1 | FLASH_D7 | B | NAND FLASH Data7
 |  |  |  | NA | NA | 0 | 1 |  |  |  |  |  |  |  |  |  |  | 2 | EMMC_D7 | B | EMMC Data7
U2 | FLASH_CS0n/FSPI_CS0n /I2S1_MCLK_M0/GPIO0_D4_u | UP | I | 0 | 0 | 0 | 1 | VCCIO1 | 1.8V/3.3V | I/O | √ | √ | GRF1_GPIO0D_DS_H | GRF1_GPIO0D_P | GRF1_GPIO0D_IE | GRF1_GPIO0D_SMT | GRF1_GPIO0D_IOMUX_H | 0 | GPIO0_D4 | B | GPIO
 |  |  |  | 0 | 0 | 0 | 1 |  |  |  |  |  |  |  |  |  |  | 1 | FLASH_CS0n | O | CS signal of NAND FLASH
 |  |  |  | 0 | 0 | 0 | 1 |  |  |  |  |  |  |  |  |  |  | 3 | FSPI_CS0n | O | CS signal0 of SPI FLASH
 |  |  |  | 0 | 0 | 0 | 1 |  |  |  |  |  |  |  |  |  |  | 4 | I2S1_MCLK_M0 | O | I2S/PCM clock to external device
T4 | FLASH_WRn/EMMC_CMD/GPIO0_D5_u | UP | I | NA | NA | 0 | 1 | VCCIO1 | 1.8V/3.3V | I/O | √ | √ | GRF1_GPIO0D_DS_H | GRF1_GPIO0D_P | GRF1_GPIO0D_IE | GRF1_GPIO0D_SMT | GRF1_GPIO0D_IOMUX_H | 0 | GPIO0_D5 | B | GPIO
 |  |  |  | NA | NA | 0 | 1 |  |  |  |  |  |  |  |  |  |  | 1 | FLASH_WRn | O | NAND FLASH Write enable
 |  |  |  | NA | NA | 0 | 1 |  |  |  |  |  |  |  |  |  |  | 2 | EMMC_CMD | B | EMMC Command or response
T3 | FSPI_D2/I2S1_SDO_M0/GPIO0_D6_d | DOWN | I | NA | NA | 0 | 1 | VCCIO1 | 1.8V/3.3V | I/O | √ | √ | GRF1_GPIO0D_DS_H | GRF1_GPIO0D_P | GRF1_GPIO0D_IE | GRF1_GPIO0D_SMT | GRF1_GPIO0D_IOMUX_H | 0 | GPIO0_D6 | B | GPIO
 |  |  |  | NA | NA | 0 | 1 |  |  |  |  |  |  |  |  |  |  | 3 | FSPI_D2 | B | Data2 of SPI FLASH
 |  |  |  | NA | NA | 0 | 1 |  |  |  |  |  |  |  |  |  |  | 4 | I2S1_SDO_M0 | O | Serial data output of I2S or PCM interface
T1 | FLASH_CLE/EMMC_CLKO/GPIO0_D7_d | DOWN | I | 0 | 0 | 1 | 0 | VCCIO1 | 1.8V/3.3V | I/O | √ | √ | GRF1_GPIO0D_DS_H | GRF1_GPIO0D_P | GRF1_GPIO0D_IE | GRF1_GPIO0D_SMT | GRF1_GPIO0D_IOMUX_H | 0 | GPIO0_D7 | B | GPIO
 |  |  |  | 0 | 0 | 1 | 0 |  |  |  |  |  |  |  |  |  |  | 1 | FLASH_CLE | O | NAND FLASH command latch enable
 |  |  |  | 0 | 0 | 1 | 0 |  |  |  |  |  |  |  |  |  |  | 2 | EMMC_CLKO | O | EMMC Clock
T2 | FLASH_ALE/FSPI_D0/I2S1_LRCK_M0/GPIO1_A0_d | DOWN | I | NA | NA | 0 | 1 | VCCIO1 | 1.8V/3.3V | I/O | √ | √ | GRF1_GPIO1A_DS_L | GRF1_GPIO1A_P | GRF1_GPIO1A_IE | RF1_GPIO1A_SMT | GRF1_GPIO1A_IOMUX_L | 0 | GPIO1_A0 | B | GPIO
 |  |  |  | NA | NA | 0 | 1 |  |  |  |  |  |  |  |  |  |  | 1 | FLASH_ALE | O | NAND FLASH address latch enable
 |  |  |  | NA | NA | 0 | 1 |  |  |  |  |  |  |  |  |  |  | 3 | FSPI_D0 | B | Data0 of SPI FLASH
 |  |  |  | NA | NA | 0 | 1 |  |  |  |  |  |  |  |  |  |  | 4 | I2S1_LRCK_M0 | B | I2S/PCM left & right channel signal serial data, synchronous left & right channel in I2S mode and the beginning of a group of left & right channels in PCM mode
R2 | FLASH_RDYn/FSPI_D1/I2S1_SCLK_M0/GPIO1_A1_u | UP | I | NA | NA | 0 | 1 | VCCIO1 | 1.8V/3.3V | I/O | √ | √ | GRF1_GPIO1A_DS_L | GRF1_GPIO1A_P | GRF1_GPIO1A_IE | RF1_GPIO1A_SMT | GRF1_GPIO1A_IOMUX_L | 0 | GPIO1_A1 | B | GPIO
 |  |  |  | NA | NA | 0 | 1 |  |  |  |  |  |  |  |  |  |  | 1 | FLASH_RDYn | I | NAND FLASH Ready/busy
 |  |  |  | NA | NA | 0 | 1 |  |  |  |  |  |  |  |  |  |  | 3 | FSPI_D1 | B | Data1 of SPI FLASH
 |  |  |  | NA | NA | 0 | 1 |  |  |  |  |  |  |  |  |  |  | 4 | I2S1_SCLK_M0 | B | I2S/PCM serial clock
R4 | FLASH_RDn/FSPI_D3/I2S1_SDI_M0/GPIO1_A2_u | UP | I | NA | NA | 0 | 1 | VCCIO1 | 1.8V/3.3V | I/O | √ | √ | GRF1_GPIO1A_DS_L | GRF1_GPIO1A_P | GRF1_GPIO1A_IE | RF1_GPIO1A_SMT | GRF1_GPIO1A_IOMUX_L | 0 | GPIO1_A2 | B | GPIO
 |  |  |  | NA | NA | 0 | 1 |  |  |  |  |  |  |  |  |  |  | 1 | FLASH_RDn | O | NAND FLASH Read enable
 |  |  |  | NA | NA | 0 | 1 |  |  |  |  |  |  |  |  |  |  | 3 | FSPI_D3 | B | Data3 of SPI FLASH
 |  |  |  | NA | NA | 0 | 1 |  |  |  |  |  |  |  |  |  |  | 4 | I2S1_SDI_M0 | I | Serial data input of I2S
R3 | FLASH_WPn/EMMC_RSTn/FSPI_CLK/GPIO1_A3_d | DOWN | I | 0 | 0 | 1 | 0 | VCCIO1 | 1.8V/3.3V | I/O | √ | √ | GRF1_GPIO1A_DS_L | GRF1_GPIO1A_P | GRF1_GPIO1A_IE | RF1_GPIO1A_SMT | GRF1_GPIO1A_IOMUX_L | 0 | GPIO1_A3 | B | GPIO
 |  |  |  | 0 | 0 | 1 | 0 |  |  |  |  |  |  |  |  |  |  | 1 | FLASH_WPn | O | NAND FLASH Write protect
 |  |  |  | 0 | 0 | 1 | 0 |  |  |  |  |  |  |  |  |  |  | 2 | EMMC_RSTn | B | EMMC reset signal
 |  |  |  | 0 | 0 | 1 | 0 |  |  |  |  |  |  |  |  |  |  | 3 | FSPI_CLK | O | Clock signal of SPI FLASH
P6 | VCCIO1_VDD |  |  |  |  |  |  | VCCIO1 | 1.8V/3.3V | PI | -- | -- | -- | -- | -- | -- | -- | 0 | VCCIO1_VDD | -- | 1.8V/3.3V I/O power of VCCIO1
VCCIO2 | 7 Balls |  |  |  |  |  |  | Power Supply | Supply Voltage | Pin Type | Schmitt Trigger | Interruptable | Driver strength control register | PU/PD control register | Input enable control register | Schmitt trigger control register | IOMUX control register | function Number | Signal Name | Direction | Description
Y14 | SDMMC0_D0/TEST_CLK1_OUT/UART2_RX_M0/GPIO1_A4_u | UP | I | NA | NA | 0 | 1 | VCCIO2 | 1.8V/3.3V | I/O | √ | √ | GRF1_GPIO1A_DS_H | GRF1_GPIO1A_P | GRF1_GPIO1A_IE | RF1_GPIO1A_SMT | GRF1_GPIO1A_IOMUX_H | 0 | GPIO1_A4 | B | GPIO
 |  |  |  | NA | NA | 0 | 1 |  |  |  |  |  |  |  |  |  |  | 1 | SDMMC0_D0 | B | SDMMC0 data0
 |  |  |  | NA | NA | 0 | 1 |  |  |  |  |  |  |  |  |  |  | 2 | TEST_CLK1_OUT | O | Colck signal1 test pin
 |  |  |  | NA | NA | 0 | 1 |  |  |  |  |  |  |  |  |  |  | 3 | UART2_RX_M0 | I | UART2 RX data
W13 | SDMMC0_D1/TEST_CLK0_OUT/UART2_TX_M0/MCU_JTAG_TRSTn/GPIO1_A5_u | UP | I | NA | NA | 0 | 1 | VCCIO2 | 1.8V/3.3V | I/O | √ | √ | GRF1_GPIO1A_DS_H | GRF1_GPIO1A_P | GRF1_GPIO1A_IE | RF1_GPIO1A_SMT | GRF1_GPIO1A_IOMUX_H | 0 | GPIO1_A5 | B | GPIO
 |  |  |  | NA | NA | 0 | 1 |  |  |  |  |  |  |  |  |  |  | 1 | SDMMC0_D1 | B | SDMMC0 data1
 |  |  |  | NA | NA | 0 | 1 |  |  |  |  |  |  |  |  |  |  | 2 | TEST_CLK0_OUT | O | Colck signal0 test pin
 |  |  |  | NA | NA | 0 | 1 |  |  |  |  |  |  |  |  |  |  | 3 | UART2_TX_M0 | O | UART2 TX data
 |  |  |  | NA | NA | 0 | 1 |  |  |  |  |  |  |  |  |  |  | 4 | MCU_JTAG_TRSTn | I | MCU JTAG reset signal
V13 | SDMMC0_D2/UART3_RX_M1/A7_JTAG_TCK_M0/MCU_JTAG_TCK/GPIO1_A6_u | UP | I | NA | NA | 0 | 1 | VCCIO2 | 1.8V/3.3V | I/O | √ | √ | GRF1_GPIO1A_DS_H | GRF1_GPIO1A_P | GRF1_GPIO1A_IE | RF1_GPIO1A_SMT | GRF1_GPIO1A_IOMUX_H | 0 | GPIO1_A6 | B | GPIO
 |  |  |  | NA | NA | 0 | 1 |  |  |  |  |  |  |  |  |  |  | 1 | SDMMC0_D2 | B | SDMMC0 data2
 |  |  |  | NA | NA | 0 | 1 |  |  |  |  |  |  |  |  |  |  | 2 | UART3_RX_M1 | I | UART3 RX data
 |  |  |  | NA | NA | 0 | 1 |  |  |  |  |  |  |  |  |  |  | 3 | A7_JTAG_TCK_M0 | I | Cortex-A7 JTAG interface clock input/SWD interface clock input
 |  |  |  | NA | NA | 0 | 1 |  |  |  |  |  |  |  |  |  |  | 4 | MCU_JTAG_TCK | I | MCU JTAG Clock signal
U13 | SDMMC0_D3/UART3_TX_M1/A7_JTAG_TMS_M0/MCU_JTAG_TMS/GPIO1_A7_u | UP | I | NA | NA | 0 | 1 | VCCIO2 | 1.8V/3.3V | I/O | √ | √ | GRF1_GPIO1A_DS_H | GRF1_GPIO1A_P | GRF1_GPIO1A_IE | RF1_GPIO1A_SMT | GRF1_GPIO1A_IOMUX_H | 0 | GPIO1_A7 | B | GPIO
 |  |  |  | NA | NA | 0 | 1 |  |  |  |  |  |  |  |  |  |  | 1 | SDMMC0_D3 | B | SDMMC0 data3
 |  |  |  | NA | NA | 0 | 1 |  |  |  |  |  |  |  |  |  |  | 2 | UART3_TX_M1 | O | UART3 TX data
 |  |  |  | NA | NA | 0 | 1 |  |  |  |  |  |  |  |  |  |  | 3 | A7_JTAG_TMS_M0 | B | Cortex-A7 JTAG interface TMS input/SWD interface data out
 |  |  |  | NA | NA | 0 | 1 |  |  |  |  |  |  |  |  |  |  | 4 | MCU_JTAG_TMS | I | MCU JTAG mode selection input signal
AA13 | SDMMC0_CLK/UART3_RTSN_M1/MCU_JTAG_TDO/GPIO1_B0_u | UP | I | 0 | 0 | 1 | 0 | VCCIO2 | 1.8V/3.3V | I/O | √ | √ | GRF1_GPIO1B_DS_L | GRF1_GPIO1B_P | GRF1_GPIO1B_IE | GRF1_GPIO1B_SMT | GRF1_GPIO1B_IOMUX_L | 0 | GPIO1_B0 | B | GPIO
 |  |  |  | 0 | 0 | 1 | 0 |  |  |  |  |  |  |  |  |  |  | 1 | SDMMC0_CLK | O | SDMMC0 clock
 |  |  |  | 0 | 0 | 1 | 0 |  |  |  |  |  |  |  |  |  |  | 2 | UART3_RTSN_M1 | O | UART3 request-to-send signal
 |  |  |  | 0 | 0 | 1 | 0 |  |  |  |  |  |  |  |  |  |  | 4 | MCU_JTAG_TDO | O | MCU JTAG output signal
Y13 | SDMMC0_CMD/UART3_CTSN_M1/MCU_JTAG_TDI/GPIO1_B1_u | UP | I | NA | NA | 0 | 1 | VCCIO2 | 1.8V/3.3V | I/O | √ | √ | GRF1_GPIO1B_DS_L | GRF1_GPIO1B_P | GRF1_GPIO1B_IE | GRF1_GPIO1B_SMT | GRF1_GPIO1B_IOMUX_L | 0 | GPIO1_B1 | B | GPIO
 |  |  |  | NA | NA | 0 | 1 |  |  |  |  |  |  |  |  |  |  | 1 | SDMMC0_CMD | B | SDMMC0 command
 |  |  |  | NA | NA | 0 | 1 |  |  |  |  |  |  |  |  |  |  | 2 | UART3_CTSN_M1 | I | UART3 clear-to-send signal
 |  |  |  | NA | NA | 0 | 1 |  |  |  |  |  |  |  |  |  |  | 4 | MCU_JTAG_TDI | I | MCU JTAG input signal
T13 | VCCIO2_VDD |  |  |  |  |  |  | VCCIO2 | 1.8V/3.3V | PI | -- | -- | -- | -- | -- | -- | -- | 0 | VCCIO2_VDD | -- | 1.8V/3.3V I/O power of VCCIO2
VCCIO3 | 17Balls |  |  |  |  |  |  | Power Supply | Supply Voltage | Pin Type | Schmitt Trigger | Interruptable | Driver strength control register | PU/PD control register | Input enable control register | Schmitt trigger control register | IOMUX control register | function Number | Signal Name | Direction | Description
D16 | SDIO_CLK/GPIO1_B2_d | DOWN | I | 0 | 0 | 1 | 0 | VCCIO3 | 1.8V/3.3V | I/O | √ | √ | GRF1_GPIO1B_DS_L | GRF1_GPIO1B_P | GRF1_GPIO1B_IE | GRF1_GPIO1B_SMT | GRF1_GPIO1B_IOMUX_L | 0 | GPIO1_B2 | B | GPIO
 |  |  | I | 0 | 0 | 1 | 0 |  |  |  |  |  |  |  |  |  |  | 1 | SDIO_CLK | O | SDIO clock
A16 | SDIO_CMD/GPIO1_B3_u | UP | I | NA | NA | 0 | 1 | VCCIO3 | 1.8V/3.3V | I/O | √ | √ | GRF1_GPIO1B_DS_L | GRF1_GPIO1B_P | GRF1_GPIO1B_IE | GRF1_GPIO1B_SMT | GRF1_GPIO1B_IOMUX_L | 0 | GPIO1_B3 | B | GPIO
 |  |  | I | NA | NA | 0 | 1 |  |  |  |  |  |  |  |  |  |  | 1 | SDIO_CMD | B | SDIO command
B16 | SDIO_D0/GPIO1_B4_u | UP | I | NA | NA | 0 | 1 | VCCIO3 | 1.8V/3.3V | I/O | √ | √ | GRF1_GPIO1B_DS_H | GRF1_GPIO1B_P | GRF1_GPIO1B_IE | GRF1_GPIO1B_SMT | GRF1_GPIO1B_IOMUX_H | 0 | GPIO1_B4 | B | GPIO
 |  |  | I | NA | NA | 0 | 1 |  |  |  |  |  |  |  |  |  |  | 1 | SDIO_D0 | B | SDIO data0
C16 | SDIO_D1/GPIO1_B5_u | UP | I | NA | NA | 0 | 1 | VCCIO3 | 1.8V/3.3V | I/O | √ | √ | GRF1_GPIO1B_DS_H | GRF1_GPIO1B_P | GRF1_GPIO1B_IE | GRF1_GPIO1B_SMT | GRF1_GPIO1B_IOMUX_H | 0 | GPIO1_B5 | B | GPIO
 |  |  | I | NA | NA | 0 | 1 |  |  |  |  |  |  |  |  |  |  | 1 | SDIO_D1 | B | SDIO data1
D15 | SDIO_D2/GPIO1_B6_u | UP | I | NA | NA | 0 | 1 | VCCIO3 | 1.8V/3.3V | I/O | √ | √ | GRF1_GPIO1B_DS_H | GRF1_GPIO1B_P | GRF1_GPIO1B_IE | GRF1_GPIO1B_SMT | GRF1_GPIO1B_IOMUX_H | 0 | GPIO1_B6 | B | GPIO
 |  |  | I | NA | NA | 0 | 1 |  |  |  |  |  |  |  |  |  |  | 1 | SDIO_D2 | B | SDIO data2
C15 | SDIO_D3/GPIO1_B7_u | UP | I | NA | NA | 0 | 1 | VCCIO3 | 1.8V/3.3V | I/O | √ | √ | GRF1_GPIO1B_DS_H | GRF1_GPIO1B_P | GRF1_GPIO1B_IE | GRF1_GPIO1B_SMT | GRF1_GPIO1B_IOMUX_H | 0 | GPIO1_B7 | B | GPIO
 |  |  | I | NA | NA | 0 | 1 |  |  |  |  |  |  |  |  |  |  | 1 | SDIO_D3 | B | SDIO data3
B15 | UART0_RTSn/GPIO1_C0_u | UP | I | NA | NA | 0 | 1 | VCCIO3 | 1.8V/3.3V | I/O | √ | √ | GRF1_GPIO1C_DS_L | GRF1_GPIO1C_P | GRF1_GPIO1C_IE | GRF1_GPIO1C_SMT | GRF1_GPIO1C_IOMUX_L | 0 | GPIO1_C0 | B | GPIO
 |  |  | I | NA | NA | 0 | 1 |  |  |  |  |  |  |  |  |  |  | 1 | UART0_RTSN | O | UART0 request-to-send signal
A15 | UART0_CTSn/GPIO1_C1_u | UP | I | NA | NA | 0 | 1 | VCCIO3 | 1.8V/3.3V | I/O | √ | √ | GRF1_GPIO1C_DS_L | GRF1_GPIO1C_P | GRF1_GPIO1C_IE | GRF1_GPIO1C_SMT | GRF1_GPIO1C_IOMUX_L | 0 | GPIO1_C1 | B | GPIO
 |  |  | I | NA | NA | 0 | 1 |  |  |  |  |  |  |  |  |  |  | 1 | UART0_CTSN | I | UART0 clear-to-send signal
D14 | UART0_RX/GPIO1_C2_u | UP | I | NA | NA | 0 | 1 | VCCIO3 | 1.8V/3.3V | I/O | √ | √ | GRF1_GPIO1C_DS_L | GRF1_GPIO1C_P | GRF1_GPIO1C_IE | GRF1_GPIO1C_SMT | GRF1_GPIO1C_IOMUX_L | 0 | GPIO1_C2 | B | GPIO
 |  |  | I | NA | NA | 0 | 1 |  |  |  |  |  |  |  |  |  |  | 1 | UART0_RX | I | UART0 RX data
C14 | UART0_TX/GPIO1_C3_u | UP | I | NA | NA | 0 | 1 | VCCIO3 | 1.8V/3.3V | I/O | √ | √ | GRF1_GPIO1C_DS_L | GRF1_GPIO1C_P | GRF1_GPIO1C_IE | GRF1_GPIO1C_SMT | GRF1_GPIO1C_IOMUX_L | 0 | GPIO1_C3 | B | GPIO
 |  |  | I | NA | NA | 0 | 1 |  |  |  |  |  |  |  |  |  |  | 1 | UART0_TX | O | UART0 TX data
B14 | I2S2_SDO_M0/SPI1_MOSI_M1/FLASH_TRIG_OUT/GPIO1_C4_d | DOWN | I | NA | NA | 0 | 1 | VCCIO3 | 1.8V/3.3V | I/O | √ | √ | GRF1_GPIO1C_DS_H | GRF1_GPIO1C_P | GRF1_GPIO1C_IE | GRF1_GPIO1C_SMT | GRF1_GPIO1C_IOMUX_H | 0 | GPIO1_C4 | B | GPIO
 |  |  | I | NA | NA | 0 | 1 |  |  |  |  |  |  |  |  |  |  | 1 | I2S2_SDO_M0 | O | Serial data output of I2S
 |  |  | I | NA | NA | 0 | 1 |  |  |  |  |  |  |  |  |  |  | 3 | SPI1_MOSI_M1 | O | SPI1 signal output
 |  |  | I | NA | NA | 0 | 1 |  |  |  |  |  |  |  |  |  |  | 4 | FLASH_TRIG_OUT | O | FLASH trig output
E13 | I2S2_SDI_M0/SPI1_MISO_M1/FLASH_TRIG_IN/GPIO1_C5_d | DOWN | I | NA | NA | 0 | 1 | VCCIO3 | 1.8V/3.3V | I/O | √ | √ | GRF1_GPIO1C_DS_H | GRF1_GPIO1C_P | GRF1_GPIO1C_IE | GRF1_GPIO1C_SMT | GRF1_GPIO1C_IOMUX_H | 0 | GPIO1_C5 | B | GPIO
 |  |  | I | NA | NA | 0 | 1 |  |  |  |  |  |  |  |  |  |  | 1 | I2S2_SDI_M0 | I | Serial data intput of I2S
 |  |  | I | NA | NA | 0 | 1 |  |  |  |  |  |  |  |  |  |  | 3 | SPI1_MISO_M1 | I | SPI1 signal input
 |  |  | I | NA | NA | 0 | 1 |  |  |  |  |  |  |  |  |  |  | 4 | FLASH_TRIG_IN | I | FLASH trig input
D13 | I2S2_SCLK_M0/SPI1_CLK_M1/PRELIGHT_TRIG_OUT/UART1_RTSn_M1/ GPIO1_C6_d | DOWN | I | 0 | 0 | 0 | 1 | VCCIO3 | 1.8V/3.3V | I/O | √ | √ | GRF1_GPIO1C_DS_H | GRF1_GPIO1C_P | GRF1_GPIO1C_IE | GRF1_GPIO1C_SMT | GRF1_GPIO1C_IOMUX_H | 0 | GPIO1_C6 | B | GPIO
 |  |  | I | 0 | 0 | 0 | 1 |  |  |  |  |  |  |  |  |  |  | 1 | I2S2_SCLK_M0 | B | I2S/PCM serial clock
 |  |  | I | 0 | 0 | 0 | 1 |  |  |  |  |  |  |  |  |  |  | 3 | SPI1_CLK_M1 | B | SPI1 clock signal
 |  |  | I | 0 | 0 | 0 | 1 |  |  |  |  |  |  |  |  |  |  | 4 | PRELIGHT_TRIG_OUT | O | Prelight trig output
 |  |  | I | 0 | 0 | 0 | 1 |  |  |  |  |  |  |  |  |  |  | 5 | UART1_RTSN_M1 | O | UART1 request-to-send signal
C13 | I2S2_LRCK_M0/SPI1_CS0n_M1/UART1_CTSn_M1/GPIO1_C7_d | DOWN | I | 0 | 0 | 0 | 1 | VCCIO3 | 1.8V/3.3V | I/O | √ | √ | GRF1_GPIO1C_DS_H | GRF1_GPIO1C_P | GRF1_GPIO1C_IE | GRF1_GPIO1C_SMT | GRF1_GPIO1C_IOMUX_H | 0 | GPIO1_C7 | B | GPIO
 |  |  | I | 0 | 0 | 0 | 1 |  |  |  |  |  |  |  |  |  |  | 1 | I2S2_LRCK_M0 | B | I2S/PCM left & right channel signal for receiving serial data, synchronous left & right channel in I2S mode and the beginning of a group of left & right channels in PCM mode
 |  |  | I | 0 | 0 | 0 | 1 |  |  |  |  |  |  |  |  |  |  | 3 | SPI1_CS0n_M1 | B | CS signal0 of SPI1
 |  |  | I | 0 | 0 | 0 | 1 |  |  |  |  |  |  |  |  |  |  | 5 | UART1_CTSN_M1 | I | UART1 clear-to-send signal
B13 | I2S2_MCLK_M0/SDIO_DET/SPI1_CS1n_M1/I2C5_SCL_M2/UART1_TX_M1/GPIO1_D0_d | DOWN | I | 0 | 0 | 0 | 1 | VCCIO3 | 1.8V/3.3V | I/O | √ | √ | GRF1_GPIO1D_DS_L | GRF1_GPIO1D_P | GRF1_GPIO1D_IE | GRF1_GPIO1D_SMT | GRF1_GPIO1D_IOMUX_L | 0 | GPIO1_D0 | B | GPIO
 |  |  | I | 0 | 0 | 0 | 1 |  |  |  |  |  |  |  |  |  |  | 1 | I2S2_MCLK_M0 | O | I2S/PCM clock to external device
 |  |  | I | 0 | 0 | 0 | 1 |  |  |  |  |  |  |  |  |  |  | 2 | SDIO_DET | I | SDIO card detect signal, 0 represents presence of card
 |  |  | I | 0 | 0 | 0 | 1 |  |  |  |  |  |  |  |  |  |  | 3 | SPI1_CS1n_M1 | B | CS signal1 of SPI1
 |  |  | I | 0 | 0 | 0 | 1 |  |  |  |  |  |  |  |  |  |  | 4 | I2C5_SCL_M2 | B | Clock of I2C bus5
 |  |  | I | 0 | 0 | 0 | 1 |  |  |  |  |  |  |  |  |  |  | 5 | UART1_TX_M1 | O | UART1 TX data
A13 | SDIO_PWR/ I2C5_SDA_M2/UART1_RX_M1/GPIO1_D1_d | DOWN | I | NA | NA | 0 | 1 | VCCIO3 | 1.8V/3.3V | I/O | √ | √ | GRF1_GPIO1D_DS_L | GRF1_GPIO1D_P | GRF1_GPIO1D_IE | GRF1_GPIO1D_SMT | GRF1_GPIO1D_IOMUX_L | 0 | GPIO1_D1 | B | GPIO
 |  |  | I | NA | NA | 0 | 1 |  |  |  |  |  |  |  |  |  |  | 2 | SDIO_PWR | O | Enable control signal of the SDIO power supply
 |  |  | I | NA | NA | 0 | 1 |  |  |  |  |  |  |  |  |  |  | 4 | I2C5_SDA_M2 | B | Data/Address of I2C bus5
 |  |  | I | NA | NA | 0 | 1 |  |  |  |  |  |  |  |  |  |  | 5 | UART1_RX_M1 | I | UART1 RX data
E14 | VCCIO3_VDD |  |  |  |  |  |  | VCCIO3 | 1.8V/3.3V | PI | -- | -- | -- | -- | -- | -- | -- |  | VCCIO3_VDD | -- | 1.8V/3.3V I/O power of VCCIO3
VCCIO4 | 11 Balls |  |  |  |  |  |  | Power Supply | Supply Voltage | Pin Type | Schmitt Trigger | Interruptable | Driver strength control register | PU/PD control register | Input enable control register | Schmitt trigger control register | IOMUX control register | function Number | Signal Name | Direction | Description
W19 | I2C1_SDA/UART4_RTSN_M2/GPIO1_D2_u | UP | I | NA | NA | 0 | 1 | VCCIO4 | 1.8V/3.3V | I/O | √ | √ | GRF1_GPIO1D_DS_L | GRF1_GPIO1D_P | GRF1_GPIO1D_IE | GRF1_GPIO1D_SMT | GRF1_GPIO1D_IOMUX_L | 0 | GPIO1_D2 | B | GPIO
 |  |  |  | NA | NA | 0 | 1 |  |  |  |  |  |  |  |  |  |  | 1 | I2C1_SDA | B | Data/Address of I2C bus1
 |  |  |  | NA | NA | 0 | 1 |  |  |  |  |  |  |  |  |  |  | 3 | UART4_RTSN_M2 | O | UART4 request-to-send signal
Y21 | I2C1_SCL/UART4_CTSN_M2/GPIO1_D3_u | UP | I | NA | NA | 0 | 1 | VCCIO4 | 1.8V/3.3V | I/O | √ | √ | GRF1_GPIO1D_DS_L | GRF1_GPIO1D_P | GRF1_GPIO1D_IE | GRF1_GPIO1D_SMT | GRF1_GPIO1D_IOMUX_L | 0 | GPIO1_D3 | B | GPIO
 |  |  |  | NA | NA | 0 | 1 |  |  |  |  |  |  |  |  |  |  | 1 | I2C1_SCL | B | Clock of I2C bus1
 |  |  |  | NA | NA | 0 | 1 |  |  |  |  |  |  |  |  |  |  | 3 | UART4_CTSN_M2 | I | UART4 clear-to-send signal
W20 | UART4_RX_M2/GPIO1_D4_d | DOWN | I | NA | NA | 0 | 1 | VCCIO4 | 1.8V/3.3V | I/O | √ | √ | GRF1_GPIO1D_DS_H | GRF1_GPIO1D_P | GRF1_GPIO1D_IE | GRF1_GPIO1D_SMT | GRF1_GPIO1D_IOMUX_H | 0 | GPIO1_D4 | B | GPIO
 |  |  |  | NA | NA | 0 | 1 |  |  |  |  |  |  |  |  |  |  | 3 | UART4_RX_M2 | I | UART4 RX signal
V20 | SPI0_CS1n_M1/I2S1_MCLK_M1/UART4_TX_M2/GPIO1_D5_d | DOWN | I | 0 | 0 | 0 | 1 | VCCIO4 | 1.8V/3.3V | I/O | √ | √ | GRF1_GPIO1D_DS_H | GRF1_GPIO1D_P | GRF1_GPIO1D_IE | GRF1_GPIO1D_SMT | GRF1_GPIO1D_IOMUX_H | 0 | GPIO1_D5 | B | GPIO
 |  |  |  | 0 | 0 | 0 | 1 |  |  |  |  |  |  |  |  |  |  | 1 | SPI0_CS1n_M1 | B | CS signal1 of SPI0
 |  |  |  | 0 | 0 | 0 | 1 |  |  |  |  |  |  |  |  |  |  | 2 | I2S1_MCLK_M1 | O | I2S/PCM clock to external device
 |  |  |  | 0 | 0 | 0 | 1 |  |  |  |  |  |  |  |  |  |  | 3 | UART4_TX_M2 | O | UART4 TX signal
V19 | SPI0_MOSI_M1/I2S1_SCLK_M1/I2C3_SCL_M2/GPIO1_D6_d | DOWN | I | 0 | 0 | 0 | 1 | VCCIO4 | 1.8V/3.3V | I/O | √ | √ | GRF1_GPIO1D_DS_H | GRF1_GPIO1D_P | GRF1_GPIO1D_IE | GRF1_GPIO1D_SMT | GRF1_GPIO1D_IOMUX_H | 0 | GPIO1_D6 | B | GPIO
 |  |  |  | 0 | 0 | 0 | 1 |  |  |  |  |  |  |  |  |  |  | 1 | SPI0_MOSI_M1 | O | SPI0 signal output
 |  |  |  | 0 | 0 | 0 | 1 |  |  |  |  |  |  |  |  |  |  | 2 | I2S1_SCLK_M1 | B | I2S/PCM serial clock
 |  |  |  | 0 | 0 | 0 | 1 |  |  |  |  |  |  |  |  |  |  | 3 | I2C3_SCL_M2 | B | Data/Address of I2C bus3
U18 | SPI0_MISO_M1/I2S1_LRCK_M1/I2C3_SDA_M2/GPIO1_D7_d | DOWN | I | 0 | 0 | 0 | 1 | VCCIO4 | 1.8V/3.3V | I/O | √ | √ | GRF1_GPIO1D_DS_H | GRF1_GPIO1D_P | GRF1_GPIO1D_IE | GRF1_GPIO1D_SMT | GRF1_GPIO1D_IOMUX_H | 0 | GPIO1_D7 | B | GPIO
 |  |  |  | 0 | 0 | 0 | 1 |  |  |  |  |  |  |  |  |  |  | 1 | SPI0_MISO_M1 | I | SPI0 signal input
 |  |  |  | 0 | 0 | 0 | 1 |  |  |  |  |  |  |  |  |  |  | 2 | I2S1_LRCK_M1 | B | I2S/PCM left & right channel signal for receiving serial data, synchronous left & right channel in I2S mode and the beginning of a group of left & right channels in PCM mode
 |  |  |  | 0 | 0 | 0 | 1 |  |  |  |  |  |  |  |  |  |  | 3 | I2C3_SDA_M2 | B | Data/Address of I2C bus3
U19 | SPI0_CS0n_M1/I2S1_SDI_M1/UART5_TX_M2/GPIO2_A0_d | DOWN | I | NA | NA | 0 | 1 | VCCIO4 | 1.8V/3.3V | I/O | √ | √ | GRF1_GPIO2A_DS_L | GRF1_GPIO2A_P | GRF1_GPIO2A_IE | GRF1_GPIO2A_SMT | GRF1_GPIO2A_IOMUX_L | 0 | GPIO2_A0 | B | GPIO
 |  |  |  | NA | NA | 0 | 1 |  |  |  |  |  |  |  |  |  |  | 1 | SPI0_CS0n_M1 | B | CS signal0 of SPI0
 |  |  |  | NA | NA | 0 | 1 |  |  |  |  |  |  |  |  |  |  | 2 | I2S1_SDI_M1 | I | Serial data input of I2S
 |  |  |  | NA | NA | 0 | 1 |  |  |  |  |  |  |  |  |  |  | 3 | UART5_TX_M2 | O | UART5 TX signal
U20 | SPI0_CLK_M1/I2S1_SDO_M1/UART5_RX_M2/GPIO2_A1_d | DOWN | I | 0 | 0 | 0 | 1 | VCCIO4 | 1.8V/3.3V | I/O | √ | √ | GRF1_GPIO2A_DS_L | GRF1_GPIO2A_P | GRF1_GPIO2A_IE | GRF1_GPIO2A_SMT | GRF1_GPIO2A_IOMUX_L | 0 | GPIO2_A1 | B | GPIO
 |  |  |  | 0 | 0 | 0 | 1 |  |  |  |  |  |  |  |  |  |  | 1 | SPI0_CLK_M1 | B | SPI0 clock signal
 |  |  |  | 0 | 0 | 0 | 1 |  |  |  |  |  |  |  |  |  |  | 2 | I2S1_SDO_M1 | O | Serial data output of I2S
 |  |  |  | 0 | 0 | 0 | 1 |  |  |  |  |  |  |  |  |  |  | 3 | UART5_RX_M2 | I | UART5 RX signal
W21 | MIPI_CSI_CLK1/UART5_RTSN_M2/GPIO2_A2_d | DOWN | I | 0 | 0 | 1 | 0 | VCCIO4 | 1.8V/3.3V | I/O | √ | √ | GRF1_GPIO2A_DS_L | GRF1_GPIO2A_P | GRF1_GPIO2A_IE | GRF1_GPIO2A_SMT | GRF1_GPIO2A_IOMUX_L | 0 | GPIO2_A2 | B | GPIO
 |  |  |  | 0 | 0 | 1 | 0 |  |  |  |  |  |  |  |  |  |  | 1 | MIPI_CSI_CLK1 | O | clock output1 for sensor
 |  |  |  | 0 | 0 | 1 | 0 |  |  |  |  |  |  |  |  |  |  | 3 | UART5_RTSN_M2 | O | UART5 request-to-send signal
V21 | MIPI_CSI_CLK0/UART5_CTSN_M2/GPIO2_A3_d | DOWN | I | 0 | 0 | 1 | 0 | VCCIO4 | 1.8V/3.3V | I/O | √ | √ | GRF1_GPIO2A_DS_L | GRF1_GPIO2A_P | GRF1_GPIO2A_IE | GRF1_GPIO2A_SMT | GRF1_GPIO2A_IOMUX_L | 0 | GPIO2_A3 | B | GPIO
 |  |  |  | 0 | 0 | 1 | 0 |  |  |  |  |  |  |  |  |  |  | 1 | MIPI_CSI_CLK0 | O | clock output0 for sensor
 |  |  |  | 0 | 0 | 1 | 0 |  |  |  |  |  |  |  |  |  |  | 3 | UART5_CTSN_M2 | I | UART5 clear-to-send signal
P15 | VCCIO4_VDD |  |  |  |  |  |  | VCCIO4 | 1.8V/3.3V | PI | -- | -- | -- | -- | -- | -- | -- | 0 | VCCIO4_VDD | -- | 1.8V/3.3V I/O power of VCCIO4
VCCIO5 | 34 Balls |  |  |  |  |  |  | Power Supply | Supply Voltage | Pin Type | Schmitt Trigger | Interruptable | Driver strength control register | PU/PD control register | Input enable control register | Schmitt trigger control register | IOMUX control register | function Number | Signal Name | Direction | Description
J18 | LCDC_D0/RGMII_TXD3_M1/CIF_D0_M1/UART4_RTSN_M1/GPIO2_A4_d | DOWN | I | NA | NA | 0 | 1 | VCCIO5 | 1.8V/3.3V | I/O | √ | √ | GRF1_GPIO2A_DS_H | GRF1_GPIO2A_P | GRF1_GPIO2A_IE | GRF1_GPIO2A_SMT | GRF1_GPIO2A_IOMUX_H | 0 | GPIO2_A4 | B | GPIO
 |  |  | I | NA | NA | 0 | 1 |  |  |  |  |  |  |  |  |  |  | 1 | LCDC_D0 | O | Output data0 of LCDC or BT1120
 |  |  | I | NA | NA | 0 | 1 |  |  |  |  |  |  |  |  |  |  | 2 | RGMII_TXD3_M1 | O | MAC TX data3
 |  |  | I | NA | NA | 0 | 1 |  |  |  |  |  |  |  |  |  |  | 3 | CIF_D0_M1 | I | CIF input data0
 |  |  | I | NA | NA | 0 | 1 |  |  |  |  |  |  |  |  |  |  | 4 | UART4_RTSN_M1 | O | UART4 request-to-send signal
L17 | LCDC_D1/RGMII_CRS_M1/CIF_D1_M1/UART4_CTSN_M1/I2C5_SCL_M0/GPIO2_A5_d | DOWN | I | NA | NA | 0 | 1 | VCCIO5 | 1.8V/3.3V | I/O | √ | √ | GRF1_GPIO2A_DS_H | GRF1_GPIO2A_P | GRF1_GPIO2A_IE | GRF1_GPIO2A_SMT | GRF1_GPIO2A_IOMUX_H | 0 | GPIO2_A5 | B | GPIO
 |  |  | I | NA | NA | 0 | 1 |  |  |  |  |  |  |  |  |  |  | 1 | LCDC_D1 | O | Output data1 of LCDC or BT1120
 |  |  | I | NA | NA | 0 | 1 |  |  |  |  |  |  |  |  |  |  | 2 | RGMII_CRS_M1 | I | PHY CRS signal
 |  |  | I | NA | NA | 0 | 1 |  |  |  |  |  |  |  |  |  |  | 3 | CIF_D1_M1 | I | CIF input data1
 |  |  | I | NA | NA | 0 | 1 |  |  |  |  |  |  |  |  |  |  | 4 | UART4_CTSN_M1 | I | UART4 clear-to-send signal
 |  |  | I | NA | NA | 0 | 1 |  |  |  |  |  |  |  |  |  |  | 7 | I2C5_SCL_M0 | B | Clock of I2C bus5
M21 | LCDC_D2/RGMII_COL_M1/CIF_D2_M1/PWM5_M1/ UART4_TX_M1/GPIO2_A6_d | DOWN | I | NA | NA | 0 | 1 | VCCIO5 | 1.8V/3.3V | I/O | √ | √ | GRF1_GPIO2A_DS_H | GRF1_GPIO2A_P | GRF1_GPIO2A_IE | GRF1_GPIO2A_SMT | GRF1_GPIO2A_IOMUX_H | 0 | GPIO2_A6 | B | GPIO
 |  |  | I | NA | NA | 0 | 1 |  |  |  |  |  |  |  |  |  |  | 1 | LCDC_D2 | O | Output data2 of LCDC or BT1120
 |  |  | I | NA | NA | 0 | 1 |  |  |  |  |  |  |  |  |  |  | 2 | RGMII_COL_M1 | I | PHY collision detected
 |  |  | I | NA | NA | 0 | 1 |  |  |  |  |  |  |  |  |  |  | 3 | CIF_D2_M1 | I | CIF input data2
 |  |  | I | NA | NA | 0 | 1 |  |  |  |  |  |  |  |  |  |  | 4 | UART4_TX_M1 | O | UART4 TX signal
 |  |  | I | NA | NA | 0 | 1 |  |  |  |  |  |  |  |  |  |  | 5 | PWM5_M1 | B | Pulse Width Modulation input or output
M20 | LCDC_D3/I2S2_SDO_M1/UART4_RX_M1/PWM4_M1/SPI0_CS0n_M2/GPIO2_A7_d | DOWN | I | NA | NA | 0 | 1 | VCCIO5 | 1.8V/3.3V | I/O | √ | √ | GRF1_GPIO2A_DS_H | GRF1_GPIO2A_P | GRF1_GPIO2A_IE | GRF1_GPIO2A_SMT | GRF1_GPIO2A_IOMUX_H | 0 | GPIO2_A7 | B | GPIO
 |  |  | I | NA | NA | 0 | 1 |  |  |  |  |  |  |  |  |  |  | 1 | LCDC_D3 | O | Output data3 of LCDC or BT1120
 |  |  | I | NA | NA | 0 | 1 |  |  |  |  |  |  |  |  |  |  | 2 | I2S2_SDO_M1 | O | Serial data output of I2S
 |  |  | I | NA | NA | 0 | 1 |  |  |  |  |  |  |  |  |  |  | 4 | UART4_RX_M1 | I | UART4 RX signal
 |  |  | I | NA | NA | 0 | 1 |  |  |  |  |  |  |  |  |  |  | 5 | PWM4_M1 | B | Pulse Width Modulation input or output
 |  |  | I | NA | NA | 0 | 1 |  |  |  |  |  |  |  |  |  |  | 6 | SPI0_CS0n_M2 | B | CS signal0 of SPI0
L19 | LCDC_D4/I2S2_SDI_M1/UART5_TX_M1/PWM3_IR_M1/SPI0_MOSI_M2/GPIO2_B0_d | DOWN | I | NA | NA | 0 | 1 | VCCIO5 | 1.8V/3.3V | I/O | √ | √ | GRF1_GPIO2B_DS_L | GRF1_GPIO2B_P | GRF1_GPIO2B_IE | GRF1_GPIO2B_SMT | GRF1_GPIO2B_IOMUX_L | 0 | GPIO2_B0 | B | GPIO
 |  |  | I | NA | NA | 0 | 1 |  |  |  |  |  |  |  |  |  |  | 1 | LCDC_D4 | O | Output data4 of LCDC or BT1120
 |  |  | I | NA | NA | 0 | 1 |  |  |  |  |  |  |  |  |  |  | 2 | I2S2_SDI_M1 | I | Serial data intput of I2S
 |  |  | I | NA | NA | 0 | 1 |  |  |  |  |  |  |  |  |  |  | 4 | UART5_TX_M1 | O | UART5 TX signal
 |  |  | I | NA | NA | 0 | 1 |  |  |  |  |  |  |  |  |  |  | 5 | PWM3_IR_M1 | B | Pulse Width Modulation input or output, used for IR application recommended
 |  |  | I | NA | NA | 0 | 1 |  |  |  |  |  |  |  |  |  |  | 6 | SPI0_MOSI_M2 | O | Data output of SPI0
L20 | LCDC_D5/I2S2_SCLK_M1/UART5_RX_M1/PWM2_M1/SPI0_MISO_M2/GPIO2_B1_d | DOWN | I | NA | NA | 0 | 1 | VCCIO5 | 1.8V/3.3V | I/O | √ | √ | GRF1_GPIO2B_DS_L | GRF1_GPIO2B_P | GRF1_GPIO2B_IE | GRF1_GPIO2B_SMT | GRF1_GPIO2B_IOMUX_L | 0 | GPIO2_B1 | B | GPIO
 |  |  | I | NA | NA | 0 | 1 |  |  |  |  |  |  |  |  |  |  | 1 | LCDC_D5 | O | Output data5 of LCDC or BT1120
 |  |  | I | NA | NA | 0 | 1 |  |  |  |  |  |  |  |  |  |  | 2 | I2S2_SCLK_M1 | B | I2S/PCM serial clock
 |  |  | I | NA | NA | 0 | 1 |  |  |  |  |  |  |  |  |  |  | 4 | UART5_RX_M1 | I | UART5 RX signal
 |  |  | I | NA | NA | 0 | 1 |  |  |  |  |  |  |  |  |  |  | 5 | PWM2_M1 | B | Pulse Width Modulation input or output
 |  |  | I | NA | NA | 0 | 1 |  |  |  |  |  |  |  |  |  |  | 6 | SPI0_MISO_M2 | I | Data input of SPI0
K16 | LCDC_D6/I2S2_LRCK_M1/UART5_RTSN_M1/PWM1_M1/SPI0_CLK_M2/GPIO2_B2_d | DOWN | I | NA | NA | 0 | 1 | VCCIO5 | 1.8V/3.3V | I/O | √ | √ | GRF1_GPIO2B_DS_L | GRF1_GPIO2B_P | GRF1_GPIO2B_IE | GRF1_GPIO2B_SMT | GRF1_GPIO2B_IOMUX_L | 0 | GPIO2_B2 | B | GPIO
 |  |  | I | NA | NA | 0 | 1 |  |  |  |  |  |  |  |  |  |  | 1 | LCDC_D6 | O | Output data6 of LCDC or BT1120
 |  |  | I | NA | NA | 0 | 1 |  |  |  |  |  |  |  |  |  |  | 2 | I2S2_LRCK_M1 | B | I2S/PCM left & right channel signal serial data, synchronous left & right channel in I2S mode and the beginning of a group of left & right channels in PCM mode
 |  |  | I | NA | NA | 0 | 1 |  |  |  |  |  |  |  |  |  |  | 4 | UART5_RTSN_M1 | O | UART5 request-to-send signal
 |  |  | I | NA | NA | 0 | 1 |  |  |  |  |  |  |  |  |  |  | 5 | PWM1_M1 | B | Pulse Width Modulation input or output
 |  |  | I | NA | NA | 0 | 1 |  |  |  |  |  |  |  |  |  |  | 6 | SPI0_CLK_M2 | B | Clock signal of SPI0
K17 | LCDC_D7/I2S2_MCLK_M1/CIF_D3_M1/UART5_CTSN_M1/SPI0_CS1n_M2/PWM0_M1/I2C5_SDA_M0/ GPIO2_B3_d | DOWN | I | NA | NA | 0 | 1 | VCCIO5 | 1.8V/3.3V | I/O | √ | √ | GRF1_GPIO2B_DS_L | GRF1_GPIO2B_P | GRF1_GPIO2B_IE | GRF1_GPIO2B_SMT | GRF1_GPIO2B_IOMUX_L | 0 | GPIO2_B3 | B | GPIO
 |  |  | I | NA | NA | 0 | 1 |  |  |  |  |  |  |  |  |  |  | 1 | LCDC_D7 | O | Output data7 of LCDC or BT1120
 |  |  | I | NA | NA | 0 | 1 |  |  |  |  |  |  |  |  |  |  | 2 | I2S2_MCLK_M1 | O | I2S/PCM clock to external device
 |  |  | I | NA | NA | 0 | 1 |  |  |  |  |  |  |  |  |  |  | 3 | CIF_D3_M1 | I | CIF input data3
 |  |  | I | NA | NA | 0 | 1 |  |  |  |  |  |  |  |  |  |  | 4 | UART5_CTSN_M1 | I | UART5 clear-to-send signal
 |  |  | I | NA | NA | 0 | 1 |  |  |  |  |  |  |  |  |  |  | 5 | PWM0_M1 | B | Pulse Width Modulation input or output
 |  |  | I | NA | NA | 0 | 1 |  |  |  |  |  |  |  |  |  |  | 6 | SPI0_CS1n_M2 | B | CS signal1 of SPI0
 |  |  | I | NA | NA | 0 | 1 |  |  |  |  |  |  |  |  |  |  | 7 | I2C5_SDA_M0 | B | Data/Address of I2C bus5
K18 | LCDC_D8/RGMII_RXDV_M1/CIF_D4_M1/GPIO2_B4_d | DOWN | I | NA | NA | 0 | 1 | VCCIO5 | 1.8V/3.3V | I/O | √ | √ | GRF1_GPIO2B_DS_H | GRF1_GPIO2B_P | GRF1_GPIO2B_IE | GRF1_GPIO2B_SMT | GRF1_GPIO2B_IOMUX_H | 0 | GPIO2_B4 | B | GPIO
 |  |  | I | NA | NA | 0 | 1 |  |  |  |  |  |  |  |  |  |  | 1 | LCDC_D8 | O | Output data8 of LCDC or BT1120
 |  |  | I | NA | NA | 0 | 1 |  |  |  |  |  |  |  |  |  |  | 2 | RGMII_RXDV_M1 | I | RX data validity and carrier sense signal of the RMII
 |  |  | I | NA | NA | 0 | 1 |  |  |  |  |  |  |  |  |  |  | 3 | CIF_D4_M1 | I | CIF input data4
K19 | LCDC_D9/RGMII_RXD0_M1/CIF_D5_M1/GPIO2_B5_d | DOWN | I | NA | NA | 0 | 1 | VCCIO5 | 1.8V/3.3V | I/O | √ | √ | GRF1_GPIO2B_DS_H | GRF1_GPIO2B_P | GRF1_GPIO2B_IE | GRF1_GPIO2B_SMT | GRF1_GPIO2B_IOMUX_H | 0 | GPIO2_B5 | B | GPIO
 |  |  | I | NA | NA | 0 | 1 |  |  |  |  |  |  |  |  |  |  | 1 | LCDC_D9 | O | Output data9 of LCDC or BT1120
 |  |  | I | NA | NA | 0 | 1 |  |  |  |  |  |  |  |  |  |  | 2 | RGMII_RXD0_M1 | I | MAC RX data0
 |  |  | I | NA | NA | 0 | 1 |  |  |  |  |  |  |  |  |  |  | 3 | CIF_D5_M1 | I | CIF input data5
K20 | LCDC_D10/RGMII_RXD1_M1/CIF_D6_M1/GPIO2_B6_d | DOWN | I | NA | NA | 0 | 1 | VCCIO5 | 1.8V/3.3V | I/O | √ | √ | GRF1_GPIO2B_DS_H | GRF1_GPIO2B_P | GRF1_GPIO2B_IE | GRF1_GPIO2B_SMT | GRF1_GPIO2B_IOMUX_H | 0 | GPIO2_B6 | B | GPIO
 |  |  | I | NA | NA | 0 | 1 |  |  |  |  |  |  |  |  |  |  | 1 | LCDC_D10 | O | Output data10 of LCDC or BT1120
 |  |  | I | NA | NA | 0 | 1 |  |  |  |  |  |  |  |  |  |  | 2 | RGMII_RXD1_M1 | I | MAC RX data1
 |  |  | I | NA | NA | 0 | 1 |  |  |  |  |  |  |  |  |  |  | 3 | CIF_D6_M1 | I | CIF input data6
K21 | LCDC_D11/RGMII_CLK_M1/CIF_D7_M1/GPIO2_B7_d | DOWN | I | NA | NA | 0 | 1 | VCCIO5 | 1.8V/3.3V | I/O | √ | √ | GRF1_GPIO2B_DS_H | GRF1_GPIO2B_P | GRF1_GPIO2B_IE | GRF1_GPIO2B_SMT | GRF1_GPIO2B_IOMUX_H | 0 | GPIO2_B7 | B | GPIO
 |  |  | I | NA | NA | 0 | 1 |  |  |  |  |  |  |  |  |  |  | 1 | LCDC_D11 | O | Output data11 of LCDC or BT1120
 |  |  | I | NA | NA | 0 | 1 |  |  |  |  |  |  |  |  |  |  | 2 | RGMII_CLK_M1 | B | MAC REC_CLK output or external clock input
 |  |  | I | NA | NA | 0 | 1 |  |  |  |  |  |  |  |  |  |  | 3 | CIF_D7_M1 | I | CIF input data7
J19 | LCDC_D12/RGMII_RXER_M1/CIF_D8_M1/GPIO2_C0_d | DOWN | I | NA | NA | 0 | 1 | VCCIO5 | 1.8V/3.3V | I/O | √ | √ | GRF1_GPIO2C_DS_L | GRF1_GPIO2C_P | GRF1_GPIO2C_IE | GRF1_GPIO2C_SMT | GRF1_GPIO2C_IOMUX_L | 0 | GPIO2_C0 | B | GPIO
 |  |  | I | NA | NA | 0 | 1 |  |  |  |  |  |  |  |  |  |  | 1 | LCDC_D12 | O | Output data12 of LCDC or BT1120
 |  |  | I | NA | NA | 0 | 1 |  |  |  |  |  |  |  |  |  |  | 2 | RGMII_RXER_M1 | I | Receive Error of MAC
 |  |  | I | NA | NA | 0 | 1 |  |  |  |  |  |  |  |  |  |  | 3 | CIF_D8_M1 | I | CIF input data8
J21 | LCDC_D13/RGMII_MDIO_M1/CIF_D9_M1/GPIO2_C1_d | DOWN | I | NA | NA | 0 | 1 | VCCIO5 | 1.8V/3.3V | I/O | √ | √ | GRF1_GPIO2C_DS_L | GRF1_GPIO2C_P | GRF1_GPIO2C_IE | GRF1_GPIO2C_SMT | GRF1_GPIO2C_IOMUX_L | 0 | GPIO2_C1 | B | GPIO
 |  |  | I | NA | NA | 0 | 1 |  |  |  |  |  |  |  |  |  |  | 1 | LCDC_D13 | O | Output data13 of LCDC or BT1120
 |  |  | I | NA | NA | 0 | 1 |  |  |  |  |  |  |  |  |  |  | 2 | RGMII_MDIO_M1 | B | MDIO interface data
 |  |  | I | NA | NA | 0 | 1 |  |  |  |  |  |  |  |  |  |  | 3 | CIF_D9_M1 | I | CIF input data9
J20 | LCDC_D14/RGMII_MDC_M1/CIF_D10_M1/GPIO2_C2_d | DOWN | I | NA | NA | 0 | 1 | VCCIO5 | 1.8V/3.3V | I/O | √ | √ | GRF1_GPIO2C_DS_L | GRF1_GPIO2C_P | GRF1_GPIO2C_IE | GRF1_GPIO2C_SMT | GRF1_GPIO2C_IOMUX_L | 0 | GPIO2_C2 | B | GPIO
 |  |  | I | NA | NA | 0 | 1 |  |  |  |  |  |  |  |  |  |  | 1 | LCDC_D14 | O | Output data14 of LCDC or BT1120
 |  |  | I | NA | NA | 0 | 1 |  |  |  |  |  |  |  |  |  |  | 2 | RGMII_MDC_M1 | O | MDIO interface Clock
 |  |  | I | NA | NA | 0 | 1 |  |  |  |  |  |  |  |  |  |  | 3 | CIF_D10_M1 | I | CIF input data10
H20 | LCDC_D15/RGMII_TXD0_M1/CIF_D11_M1/GPIO2_C3_d | DOWN | I | NA | NA | 0 | 1 | VCCIO5 | 1.8V/3.3V | I/O | √ | √ | GRF1_GPIO2C_DS_L | GRF1_GPIO2C_P | GRF1_GPIO2C_IE | GRF1_GPIO2C_SMT | GRF1_GPIO2C_IOMUX_L | 0 | GPIO2_C3 | B | GPIO
 |  |  | I | NA | NA | 0 | 1 |  |  |  |  |  |  |  |  |  |  | 1 | LCDC_D15 | O | Output data15 of LCDC or BT1120
 |  |  | I | NA | NA | 0 | 1 |  |  |  |  |  |  |  |  |  |  | 2 | RGMII_TXD0_M1 | O | MAC TX data0
 |  |  | I | NA | NA | 0 | 1 |  |  |  |  |  |  |  |  |  |  | 3 | CIF_D11_M1 | I | CIF input data11
H19 | LCDC_D16/RGMII_TXD1_M1/CIF_D12_M1/GPIO2_C4_d | DOWN | I | NA | NA | 0 | 1 | VCCIO5 | 1.8V/3.3V | I/O | √ | √ | GRF1_GPIO2C_DS_H | GRF1_GPIO2C_P | GRF1_GPIO2C_IE | GRF1_GPIO2C_SMT | GRF1_GPIO2C_IOMUX_H | 0 | GPIO2_C4 | B | GPIO
 |  |  | I | NA | NA | 0 | 1 |  |  |  |  |  |  |  |  |  |  | 1 | LCDC_D16 | O | Output data16 of LCDC
 |  |  | I | NA | NA | 0 | 1 |  |  |  |  |  |  |  |  |  |  | 2 | RGMII_TXD1_M1 | O | MAC TX data1
 |  |  | I | NA | NA | 0 | 1 |  |  |  |  |  |  |  |  |  |  | 3 | CIF_D12_M1 | I | CIF input data12
G21 | LCDC_D17/CLK_OUT_ETHERNET_M1/CIF_D13_M1/GPIO2_C5_d | DOWN | I | NA | NA | 0 | 1 | VCCIO5 | 1.8V/3.3V | I/O | √ | √ | GRF1_GPIO2C_DS_H | GRF1_GPIO2C_P | GRF1_GPIO2C_IE | GRF1_GPIO2C_SMT | GRF1_GPIO2C_IOMUX_H | 0 | GPIO2_C5 | B | GPIO
 |  |  | I | NA | NA | 0 | 1 |  |  |  |  |  |  |  |  |  |  | 1 | LCDC_D17 | O | Output data17 of LCDC
 |  |  | I | NA | NA | 0 | 1 |  |  |  |  |  |  |  |  |  |  | 2 | CLK_OUT_ETHERNET_M1 | O | Output reference Clock to PHY
 |  |  | I | NA | NA | 0 | 1 |  |  |  |  |  |  |  |  |  |  | 3 | CIF_D13_M1 | I | CIF input data13
G20 | LCDC_D18/RGMII_TXEN_M1/CIF_D14_M1/GPIO2_C6_d | DOWN | I | NA | NA | 0 | 1 | VCCIO5 | 1.8V/3.3V | I/O | √ | √ | GRF1_GPIO2C_DS_H | GRF1_GPIO2C_P | GRF1_GPIO2C_IE | GRF1_GPIO2C_SMT | GRF1_GPIO2C_IOMUX_H | 0 | GPIO2_C6 | B | GPIO
 |  |  | I | NA | NA | 0 | 1 |  |  |  |  |  |  |  |  |  |  | 1 | LCDC_D18 | O | Output data18 of LCDC
 |  |  | I | NA | NA | 0 | 1 |  |  |  |  |  |  |  |  |  |  | 2 | RGMII_TXEN_M1 | O | MAC TX data validity signal
 |  |  | I | NA | NA | 0 | 1 |  |  |  |  |  |  |  |  |  |  | 3 | CIF_D14_M1 | I | CIF input data14
G19 | LCDC_D19/RGMII_RXD2_M1/CIF_D15_M1/I2S1_MCLK_M2/GPIO2_C7_d | DOWN | I | NA | NA | 0 | 1 | VCCIO5 | 1.8V/3.3V | I/O | √ | √ | GRF1_GPIO2C_DS_H | GRF1_GPIO2C_P | GRF1_GPIO2C_IE | GRF1_GPIO2C_SMT | GRF1_GPIO2C_IOMUX_H | 0 | GPIO2_C7 | B | GPIO
 |  |  | I | NA | NA | 0 | 1 |  |  |  |  |  |  |  |  |  |  | 1 | LCDC_D19 | O | Output data19 of LCDC
 |  |  | I | NA | NA | 0 | 1 |  |  |  |  |  |  |  |  |  |  | 2 | RGMII_RXD2_M1 | I | MAC RX data2
 |  |  | I | NA | NA | 0 | 1 |  |  |  |  |  |  |  |  |  |  | 3 | CIF_D15_M1 | I | CIF input data15
 |  |  | I | NA | NA | 0 | 1 |  |  |  |  |  |  |  |  |  |  | 6 | I2S1_MCLK_M2 | O | I2S/PCM clock to external device
H18 | LCDC_D20/RGMII_RXD3_M1/CIF_VSYNC_M1/I2S1_SDO_M2/GPIO2_D0_d | DOWN | I | NA | NA | 0 | 1 | VCCIO5 | 1.8V/3.3V | I/O | √ | √ | GRF1_GPIO2D_DS_L | GRF1_GPIO2D_P | GRF1_GPIO2D_IE | GRF1_GPIO2D_SMT | GRF1_GPIO2D_IOMUX_L | 0 | GPIO2_D0 | B | GPIO
 |  |  | I | NA | NA | 0 | 1 |  |  |  |  |  |  |  |  |  |  | 1 | LCDC_D20 | O | Output data20 of LCDC
 |  |  | I | NA | NA | 0 | 1 |  |  |  |  |  |  |  |  |  |  | 2 | RGMII_RXD3_M1 | I | MAC RX data3
 |  |  | I | NA | NA | 0 | 1 |  |  |  |  |  |  |  |  |  |  | 3 | CIF_VSYNC_M1 | I | CIF field sync signal
 |  |  | I | NA | NA | 0 | 1 |  |  |  |  |  |  |  |  |  |  | 6 | I2S1_SDO_M2 | O | Serial data output of I2S
F21 | LCDC_D21/RGMII_TXD2_M1/CIF_CLKOUT_M1/I2S1_SCLK_M2/GPIO2_D1_d | DOWN | I | NA | NA | 0 | 1 | VCCIO5 | 1.8V/3.3V | I/O | √ | √ | GRF1_GPIO2D_DS_L | GRF1_GPIO2D_P | GRF1_GPIO2D_IE | GRF1_GPIO2D_SMT | GRF1_GPIO2D_IOMUX_L | 0 | GPIO2_D1 | B | GPIO
 |  |  | I | NA | NA | 0 | 1 |  |  |  |  |  |  |  |  |  |  | 1 | LCDC_D21 | O | Output data21 of RGB
 |  |  | I | NA | NA | 0 | 1 |  |  |  |  |  |  |  |  |  |  | 2 | RGMII_TXD2_M1 | O | RGMII TX data2
 |  |  | I | NA | NA | 0 | 1 |  |  |  |  |  |  |  |  |  |  | 3 | CIF_CLKOUT_M1 | O | CIF output clock
 |  |  | I | NA | NA | 0 | 1 |  |  |  |  |  |  |  |  |  |  | 6 | I2S1_SCLK_M2 | B | Serial Clock of the I2S
F20 | LCDC_D22/RGMII_TXCLK_M1/CIF_CLKIN_M1/I2S1_LRCK_M2/GPIO2_D2_d | DOWN | I | NA | NA | 0 | 1 | VCCIO5 | 1.8V/3.3V | I/O | √ | √ | GRF1_GPIO2D_DS_L | GRF1_GPIO2D_P | GRF1_GPIO2D_IE | GRF1_GPIO2D_SMT | GRF1_GPIO2D_IOMUX_L | 0 | GPIO2_D2 | B | GPIO
 |  |  | I | NA | NA | 0 | 1 |  |  |  |  |  |  |  |  |  |  | 1 | LCDC_D22 | O | Output data22 of RGB
 |  |  | I | NA | NA | 0 | 1 |  |  |  |  |  |  |  |  |  |  | 2 | RGMII_TXCLK_M1 | O | The transmit reference clock
 |  |  | I | NA | NA | 0 | 1 |  |  |  |  |  |  |  |  |  |  | 3 | CIF_CLKIN_M1 | I | CIF input clock
 |  |  | I | NA | NA | 0 | 1 |  |  |  |  |  |  |  |  |  |  | 6 | I2S1_LRCK_M2 | B | I2S/PCM left & right channel signal for receiving serial data, synchronous left & right channel in I2S mode and the beginning of a group of left & right channels in PCM mode
F19 | LCDC_D23/RGMII_RXCLK_M1/CIF_HSYNC_M1/I2S1_SDI_M2/GPIO2_D3_d | DOWN | I | NA | NA | 0 | 1 | VCCIO5 | 1.8V/3.3V | I/O | √ | √ | GRF1_GPIO2D_DS_L | GRF1_GPIO2D_P | GRF1_GPIO2D_IE | GRF1_GPIO2D_SMT | GRF1_GPIO2D_IOMUX_L | 0 | GPIO2_D3 | B | GPIO
 |  |  | I | NA | NA | 0 | 1 |  |  |  |  |  |  |  |  |  |  | 1 | LCDC_D23 | O | Output data23 of RGB
 |  |  | I | NA | NA | 0 | 1 |  |  |  |  |  |  |  |  |  |  | 2 | RGMII_RXCLK_M1 | I | MAC RX clock
 |  |  | I | NA | NA | 0 | 1 |  |  |  |  |  |  |  |  |  |  | 3 | CIF_HSYNC_M1 | I | CIF horizontal sync signal
 |  |  | I | NA | NA | 0 | 1 |  |  |  |  |  |  |  |  |  |  | 6 | I2S1_SDI_M2 | I | Serial input data of I2S1
J17 | LCDC_DEN/PWM6_M1/SPI1_CS0n_M2/I2C3_SCL_M1/GPIO2_D4_d | DOWN | I | NA | NA | 0 | 1 | VCCIO5 | 1.8V/3.3V | I/O | √ | √ | GRF1_GPIO2D_DS_H | GRF1_GPIO2D_P | GRF1_GPIO2D_IE | GRF1_GPIO2D_SMT | GRF1_GPIO2D_IOMUX_H | 0 | GPIO2_D4 | B | GPIO
 |  |  | I | NA | NA | 0 | 1 |  |  |  |  |  |  |  |  |  |  | 1 | LCDC_DEN | O | LCDC data validity
 |  |  | I | NA | NA | 0 | 1 |  |  |  |  |  |  |  |  |  |  | 5 | PWM6_M1 | B | Pulse Width Modulation input or output
 |  |  | I | NA | NA | 0 | 1 |  |  |  |  |  |  |  |  |  |  | 6 | SPI1_CS0n_M2 | B | CS signal0 of SPI1
 |  |  | I | NA | NA | 0 | 1 |  |  |  |  |  |  |  |  |  |  | 7 | I2C3_SCL_M1 | B | Clock of I2C bus3
H17 | LCDC_HSYNC/PWM10_M1/ SPI1_CLK_M2 /I2C3_SDA_M1/GPIO2_D5_d | DOWN | I | NA | NA | 0 | 1 | VCCIO5 | 1.8V/3.3V | I/O | √ | √ | GRF1_GPIO2D_DS_H | GRF1_GPIO2D_P | GRF1_GPIO2D_IE | GRF1_GPIO2D_SMT | GRF1_GPIO2D_IOMUX_H | 0 | GPIO2_D5 | B | GPIO
 |  |  | I | NA | NA | 0 | 1 |  |  |  |  |  |  |  |  |  |  | 1 | LCDC_HSYNC | O | LCDC horizontal sync signal
 |  |  | I | NA | NA | 0 | 1 |  |  |  |  |  |  |  |  |  |  | 5 | PWM10_M1 | B | Pulse Width Modulation input or output
 |  |  | I | NA | NA | 0 | 1 |  |  |  |  |  |  |  |  |  |  | 6 | SPI1_CLK_M2 | B | Clock signal of SPI1
 |  |  | I | NA | NA | 0 | 1 |  |  |  |  |  |  |  |  |  |  | 7 | I2C3_SDA_M1 | B | Data/Address of I2C bus3
C21 | LCDC_VSYNC/UART3_RTSN_M2/PWM9_M1/SPI1_MOSI_M2/GPIO2_D6_d | DOWN | I | NA | NA | 0 | 1 | VCCIO5 | 1.8V/3.3V | I/O | √ | √ | GRF1_GPIO2D_DS_H | GRF1_GPIO2D_P | GRF1_GPIO2D_IE | GRF1_GPIO2D_SMT | GRF1_GPIO2D_IOMUX_H | 0 | GPIO2_D6 | B | GPIO
 |  |  | I | NA | NA | 0 | 1 |  |  |  |  |  |  |  |  |  |  | 1 | LCDC_VSYNC | O | LCDC vertical sync signal
 |  |  | I | NA | NA | 0 | 1 |  |  |  |  |  |  |  |  |  |  | 4 | UART3_RTSN_M2 | I | UART3 request-to-sensd signal
 |  |  | I | NA | NA | 0 | 1 |  |  |  |  |  |  |  |  |  |  | 5 | PWM9_M1 | B | Pulse Width Modulation input or output
 |  |  | I | NA | NA | 0 | 1 |  |  |  |  |  |  |  |  |  |  | 6 | SPI1_MOSI_M2 | O | Data output of SPI1
D21 | LCDC_CLK/UART3_CTSN_M2/PWM8_M1/SPI1_MISO_M2/GPIO2_D7_d | DOWN | I | 0 | 0 | 1 | 0 | VCCIO5 | 1.8V/3.3V | I/O | √ | √ | GRF1_GPIO2D_DS_H | GRF1_GPIO2D_P | GRF1_GPIO2D_IE | GRF1_GPIO2D_SMT | GRF1_GPIO2D_IOMUX_H | 0 | GPIO2_D7 | B | GPIO
 |  |  | I | 0 | 0 | 1 | 0 |  |  |  |  |  |  |  |  |  |  | 1 | LCDC_CLK | O | LCDC Clock
 |  |  | I | 0 | 0 | 1 | 0 |  |  |  |  |  |  |  |  |  |  | 4 | UART3_CTSN_M2 | O | UART3 clear-to-send signal
 |  |  | I | 0 | 0 | 1 | 0 |  |  |  |  |  |  |  |  |  |  | 5 | PWM8_M1 | B | Pulse Width Modulation input or output
 |  |  | I | 0 | 0 | 1 | 0 |  |  |  |  |  |  |  |  |  |  | 6 | SPI1_MISO_M2 | I | Data Input of SPI1
E20 | CAN_RXD_M0/UART3_TX_M2/PWM7_IR_M1/SPI1_CS1n_M2/I2C4_SCL_M0/GPIO3_A0_u | UP | I | NA | NA | 0 | 1 | VCCIO5 | 1.8V/3.3V | I/O | √ | √ | GRF1_GPIO3A_DS_L | GRF1_GPIO3A_P | GRF1_GPIO3A_IE | GRF1_GPIO3A_SMT | GRF1_GPIO3A_IOMUX_L | 0 | GPIO3_A0 | B | GPIO
 |  |  | I | NA | NA | 0 | 1 |  |  |  |  |  |  |  |  |  |  | 3 | CAN_RXD_M0 | I | Can bus RX data
 |  |  | I | NA | NA | 0 | 1 |  |  |  |  |  |  |  |  |  |  | 4 | UART3_TX_M2 | O | UART3 Tx data
 |  |  | I | NA | NA | 0 | 1 |  |  |  |  |  |  |  |  |  |  | 5 | PWM7_IR_M1 | B | Pulse Width Modulation input or output, used for IR application recommended
 |  |  | I | NA | NA | 0 | 1 |  |  |  |  |  |  |  |  |  |  | 6 | SPI1_CS1n_M2 | B | CS signal1 of SPI1
 |  |  | I | NA | NA | 0 | 1 |  |  |  |  |  |  |  |  |  |  | 7 | I2C4_SCL_M0 | B | Clock of I2C bus4
E19 | CAN_TXD_M0/UART3_RX_M2/PWM11_IR_M1/I2C4_SDA_M0/GPIO3_A1_u | UP | I | NA | NA | 0 | 1 | VCCIO5 | 1.8V/3.3V | I/O | √ | √ | GRF1_GPIO3A_DS_L | GRF1_GPIO3A_P | GRF1_GPIO3A_IE | GRF1_GPIO3A_SMT | GRF1_GPIO3A_IOMUX_L | 0 | GPIO3_A1 | B | GPIO
 |  |  | I | NA | NA | 0 | 1 |  |  |  |  |  |  |  |  |  |  | 3 | CAN_TXD_M0 | O | Can bus TX data
 |  |  | I | NA | NA | 0 | 1 |  |  |  |  |  |  |  |  |  |  | 4 | UART3_RX_M2 | I | UART3 RX data
 |  |  | I | NA | NA | 0 | 1 |  |  |  |  |  |  |  |  |  |  | 5 | PWM11_IR_M1 | B | Pulse Width Modulation input or output, used for IR application recommended
 |  |  | I | NA | NA | 0 | 1 |  |  |  |  |  |  |  |  |  |  | 7 | I2C4_SDA_M0 | B | Data/Address of I2C bus4
G18 | UART2_TX_M1/A7_JTAG_TCK_M1/GPIO3_A2_u | UP | I | NA | NA | 0 | 1 | VCCIO5 | 1.8V/3.3V | I/O | √ | √ | GRF1_GPIO3A_DS_L | GRF1_GPIO3A_P | GRF1_GPIO3A_IE | GRF1_GPIO3A_SMT | GRF1_GPIO3A_IOMUX_L | 0 | GPIO3_A2 | B | GPIO
 |  |  | I | NA | NA | 0 | 1 |  |  |  |  |  |  |  |  |  |  | 1 | UART2_TX_M1 | O | UART2 TX data
 |  |  | I | NA | NA | 0 | 1 |  |  |  |  |  |  |  |  |  |  | 2 | A7_JTAG_TCK_M1 | I | Cortex-A7 JTAG interface clock input/SWD interface clock input
H16 | UART2_RX_M1/A7_JTAG_TMS_M1/GPIO3_A3_u | UP | I | NA | NA | 0 | 1 | VCCIO5 | 1.8V/3.3V | I/O | √ | √ | GRF1_GPIO3A_DS_L | GRF1_GPIO3A_P | GRF1_GPIO3A_IE | GRF1_GPIO3A_SMT | GRF1_GPIO3A_IOMUX_L | 0 | GPIO3_A3 | B | GPIO
 |  |  | I | NA | NA | 0 | 1 |  |  |  |  |  |  |  |  |  |  | 1 | UART2_RX_M1 | I | UART2 RX data
 |  |  | I | NA | NA | 0 | 1 |  |  |  |  |  |  |  |  |  |  | 2 | A7_JTAG_TMS_M1 | B | Cortex-A7 JTAG interface TMS input/SWD interface data out
J15 | VCCIO5_VDD1 |  |  |  |  |  |  | VCCIO5 | 1.8V/3.3V | PI | -- | -- | -- | -- | -- | -- | -- | 0 | VCCIO5_VDD1 | -- | 1.8V/3.3V I/O power of VCCIO5
K15 | VCCIO5_VDD2 |  |  |  |  |  |  | VCCIO5 | 1.8V/3.3V | PI | -- | -- | -- | -- | -- | -- | -- | 0 | VCCIO5_VDD2 | -- | 1.8V/3.3V I/O power of VCCIO5
VCCIO6 | 21 Balls |  |  |  |  |  |  | Power Supply | Supply Voltage | Pin Type | Schmitt Trigger | Interruptable | Driver strength control register | PU/PD control register | Input enable control register | Schmitt trigger control register | IOMUX control register | function Number | Signal Name | Direction | Description
R17 | CIF_D0_M0/I2S0_SCLK_TX_M1/UART4_TX_M0/I2C3_SCL_M0/PWM8_M0/GPIO3_A4_d | DOWN | I | NA | NA | 0 | 1 | VCCIO6 | 1.8V/3.3V | I/O | √ | √ | GRF1_GPIO3A_DS_H | GRF1_GPIO3A_P | GRF1_GPIO3A_IE | GRF1_GPIO3A_SMT | GRF1_GPIO3A_IOMUX_H | 0 | GPIO3_A4 | B | GPIO
 |  | DOWN | I | NA | NA | 0 | 1 |  |  |  |  |  |  |  |  |  |  | 1 | CIF_D0_M0 | I | CIF data 0
 |  | DOWN | I | NA | NA | 0 | 1 |  |  |  |  |  |  |  |  |  |  | 3 | I2S0_SCLK_TX_M1 | B | I2S/PCM serial clock
 |  | DOWN | I | NA | NA | 0 | 1 |  |  |  |  |  |  |  |  |  |  | 4 | UART4_TX_M0 | O | UART4 TX signal
 |  | DOWN | I | NA | NA | 0 | 1 |  |  |  |  |  |  |  |  |  |  | 5 | I2C3_SCL_M0 | B | Clock of I2C bus3
 |  | DOWN | I | NA | NA | 0 | 1 |  |  |  |  |  |  |  |  |  |  | 6 | PWM8_M0 | B | Pulse Width Modulation input or output
T18 | CIF_D1_M0/RGMII_CRS_M0/I2S0_LRCK_TX_M1/UART4_RX_M0/I2C3_SDA_M0/PWM9_M0/GPIO3_A5_d | DOWN | I | NA | NA | 0 | 1 | VCCIO6 | 1.8V/3.3V | I/O | √ | √ | GRF1_GPIO3A_DS_H | GRF1_GPIO3A_P | GRF1_GPIO3A_IE | GRF1_GPIO3A_SMT | GRF1_GPIO3A_IOMUX_H | 0 | GPIO3_A5 | B | GPIO
 |  | DOWN | I | NA | NA | 0 | 1 |  |  |  |  |  |  |  |  |  |  | 1 | CIF_D1_M0 | I | CIF data 1
 |  | DOWN | I | NA | NA | 0 | 1 |  |  |  |  |  |  |  |  |  |  | 2 | RGMII_CRS_M0 | I | PHY CRS signal
 |  | DOWN | I | NA | NA | 0 | 1 |  |  |  |  |  |  |  |  |  |  | 3 | I2S0_LRCK_TX_M1 | B | I2S/PCM left & right channel signal for receiving serial data, synchronous left & right channel in I2S mode and the beginning of a group of left & right channels in PCM mode
 |  | DOWN | I | NA | NA | 0 | 1 |  |  |  |  |  |  |  |  |  |  | 4 | UART4_RX_M0 | I | UART4 RX signal
 |  | DOWN | I | NA | NA | 0 | 1 |  |  |  |  |  |  |  |  |  |  | 5 | I2C3_SDA_M0 | B | Data/Address signal of I2C bus3
 |  | DOWN | I | NA | NA | 0 | 1 |  |  |  |  |  |  |  |  |  |  | 6 | PWM9_M0 | B | Pulse Width Modulation input or output
P17 | CIF_D2_M0/RGMII_COL_M0/I2S0_SDO0_M1/UART5_TX_M0/CAN_RXD_M1/PWM10_M0/GPIO3_A6_d | DOWN | I | NA | NA | 0 | 1 | VCCIO6 | 1.8V/3.3V | I/O | √ | √ | GRF1_GPIO3A_DS_H | GRF1_GPIO3A_P | GRF1_GPIO3A_IE | GRF1_GPIO3A_SMT | GRF1_GPIO3A_IOMUX_H | 0 | GPIO3_A6 | B | GPIO
 |  | DOWN | I | NA | NA | 0 | 1 |  |  |  |  |  |  |  |  |  |  | 1 | CIF_D2_M0 | I | CIF data 2
 |  | DOWN | I | NA | NA | 0 | 1 |  |  |  |  |  |  |  |  |  |  | 2 | RGMII_COL_M0 | I | PHY collision detected
 |  | DOWN | I | NA | NA | 0 | 1 |  |  |  |  |  |  |  |  |  |  | 3 | I2S0_SDO0_M1 | O | Serial output data0 of I2S0
 |  | DOWN | I | NA | NA | 0 | 1 |  |  |  |  |  |  |  |  |  |  | 4 | UART5_TX_M0 | O | UART5 TX signal
 |  | DOWN | I | NA | NA | 0 | 1 |  |  |  |  |  |  |  |  |  |  | 5 | CAN_RXD_M1 | I | Can bus RX data
 |  | DOWN | I | NA | NA | 0 | 1 |  |  |  |  |  |  |  |  |  |  | 6 | PWM10_M0 | B | Pulse Width Modulation input or output
R18 | CIF_D3_M0/RGMII_RXD2_M0/I2S0_SDI0_M1/UART5_RX_M0/CAN_TXD_M1/PWM11_IR_M0/GPIO3_A7_d | DOWN | I | NA | NA | 0 | 1 | VCCIO6 | 1.8V/3.3V | I/O | √ | √ | GRF1_GPIO3A_DS_H | GRF1_GPIO3A_P | GRF1_GPIO3A_IE | GRF1_GPIO3A_SMT | GRF1_GPIO3A_IOMUX_H | 0 | GPIO3_A7 | B | GPIO
 |  | DOWN | I | NA | NA | 0 | 1 |  |  |  |  |  |  |  |  |  |  | 1 | CIF_D3_M0 | I | CIF data 3
 |  | DOWN | I | NA | NA | 0 | 1 |  |  |  |  |  |  |  |  |  |  | 2 | RGMII_RXD2_M0 | I | MAC RX data2
 |  | DOWN | I | NA | NA | 0 | 1 |  |  |  |  |  |  |  |  |  |  | 3 | I2S0_SDI0_M1 | I | Serial input data0 of I2S0
 |  | DOWN | I | NA | NA | 0 | 1 |  |  |  |  |  |  |  |  |  |  | 4 | UART5_RX_M0 | I | UART5 RX signal
 |  | DOWN | I | NA | NA | 0 | 1 |  |  |  |  |  |  |  |  |  |  | 5 | CAN_TXD_M1 | O | Can bus TX data
 |  | DOWN | I | NA | NA | 0 | 1 |  |  |  |  |  |  |  |  |  |  | 6 | PWM11_IR_M0 | B | Pulse Width Modulation input or output, used for IR application recommended
T19 | CIF_D4_M0/RGMII_RXD3_M0/I2S0_MCLK_M1/UART5_RTSN_M0/I2C5_SCL_M1/GPIO3_B0_d | DOWN | I | NA | NA | 0 | 1 | VCCIO6 | 1.8V/3.3V | I/O | √ | √ | GRF1_GPIO3B_DS_L | GRF1_GPIO3B_P | GRF1_GPIO3B_IE | GRF1_GPIO3B_SMT | GRF1_GPIO3B_IOMUX_L | 0 | GPIO3_B0 | B | GPIO
 |  | DOWN | I | NA | NA | 0 | 1 |  |  |  |  |  |  |  |  |  |  | 1 | CIF_D4_M0 | I | CIF data 4
 |  | DOWN | I | NA | NA | 0 | 1 |  |  |  |  |  |  |  |  |  |  | 2 | RGMII_RXD3_M0 | I | MAC RX data3
 |  | DOWN | I | NA | NA | 0 | 1 |  |  |  |  |  |  |  |  |  |  | 3 | I2S0_MCLK_M1 | O | I2S/PCM clock to external device
 |  | DOWN | I | NA | NA | 0 | 1 |  |  |  |  |  |  |  |  |  |  | 4 | UART5_RTSN_M0 | O | UART5 Request-to-send signal
 |  | DOWN | I | NA | NA | 0 | 1 |  |  |  |  |  |  |  |  |  |  | 5 | I2C5_SCL_M1 | B | Clock of I2C bus5
T20 | CIF_D5_M0/RGMII_TXD2_M0/I2S0_SCLK_RX_M1/UART5_CTSN_M0/I2C5_SDA_M1/GPIO3_B1_d | DOWN | I | NA | NA | 0 | 1 | VCCIO6 | 1.8V/3.3V | I/O | √ | √ | GRF1_GPIO3B_DS_L | GRF1_GPIO3B_P | GRF1_GPIO3B_IE | GRF1_GPIO3B_SMT | GRF1_GPIO3B_IOMUX_L | 0 | GPIO3_B1 | B | GPIO
 |  | DOWN | I | NA | NA | 0 | 1 |  |  |  |  |  |  |  |  |  |  | 1 | CIF_D5_M0 | I | CIF data 5
 |  | DOWN | I | NA | NA | 0 | 1 |  |  |  |  |  |  |  |  |  |  | 2 | RGMII_TXD2_M0 | O | MAC TX data2
 |  | DOWN | I | NA | NA | 0 | 1 |  |  |  |  |  |  |  |  |  |  | 3 | I2S0_SCLK_RX_M1 | I | I2S/PCM serial clock
 |  | DOWN | I | NA | NA | 0 | 1 |  |  |  |  |  |  |  |  |  |  | 4 | UART5_CTSN_M0 | O | UART5 Clear-to-send signal
 |  | DOWN | I | NA | NA | 0 | 1 |  |  |  |  |  |  |  |  |  |  | 5 | I2C5_SDA_M1 | B | Data/Address of I2C bus5
N17 | CIF_D6_M0/RGMII_TXD3_M0/I2S0_LRCK_RX_M1/UART4_RTSN_M0/GPIO3_B2_d | DOWN | I | NA | NA | 0 | 1 | VCCIO6 | 1.8V/3.3V | I/O | √ | √ | GRF1_GPIO3B_DS_L | GRF1_GPIO3B_P | GRF1_GPIO3B_IE | GRF1_GPIO3B_SMT | GRF1_GPIO3B_IOMUX_L | 0 | GPIO3_B2 | B | GPIO
 |  | DOWN | I | NA | NA | 0 | 1 |  |  |  |  |  |  |  |  |  |  | 1 | CIF_D6_M0 | I | CIF data 6
 |  | DOWN | I | NA | NA | 0 | 1 |  |  |  |  |  |  |  |  |  |  | 2 | RGMII_TXD3_M0 | O | RGMII TX data3
 |  | DOWN | I | NA | NA | 0 | 1 |  |  |  |  |  |  |  |  |  |  | 3 | I2S0_LRCK_RX_M1 | B | I2S/PCM left & right channel signal for receiving serial data, synchronous left & right channel in I2S mode and the beginning of a group of left & right channels in PCM mode
 |  | DOWN | I | NA | NA | 0 | 1 |  |  |  |  |  |  |  |  |  |  | 4 | UART4_RTSN_M0 | O | UART4 request-to-send signal
R19 | CIF_D7_M0/RGMII_TXD0_M0/I2S0_SDO1_SDI3_M1/UART4_CTSN_M0/GPIO3_B3_d | DOWN | I | NA | NA | 0 | 1 | VCCIO6 | 1.8V/3.3V | I/O | √ | √ | GRF1_GPIO3B_DS_L | GRF1_GPIO3B_P | GRF1_GPIO3B_IE | GRF1_GPIO3B_SMT | GRF1_GPIO3B_IOMUX_L | 0 | GPIO3_B3 | B | GPIO
 |  | DOWN | I | NA | NA | 0 | 1 |  |  |  |  |  |  |  |  |  |  | 1 | CIF_D7_M0 | I | CIF data 7
 |  | DOWN | I | NA | NA | 0 | 1 |  |  |  |  |  |  |  |  |  |  | 2 | RGMII_TXD0_M0 | O | MAC TX data0
 |  | DOWN | I | NA | NA | 0 | 1 |  |  |  |  |  |  |  |  |  |  | 3 | I2S0_SDO1_SDI3_M1 | B | Serial output data1/input data3 of I2S0
 |  | DOWN | I | NA | NA | 0 | 1 |  |  |  |  |  |  |  |  |  |  | 4 | UART4_CTSN_M0 | I | UART4 clear-to-send signal
T21 | CIF_D8_M0/RGMII_TXD1_M0/I2S0_SDO2_SDI2_M1/SPI1_CS1n_M0/GPIO3_B4_d | DOWN | I | NA | NA | 0 | 1 | VCCIO6 | 1.8V/3.3V | I/O | √ | √ | GRF1_GPIO3B_DS_H | GRF1_GPIO3B_P | GRF1_GPIO3B_IE | GRF1_GPIO3B_SMT | GRF1_GPIO3B_IOMUX_H | 0 | GPIO3_B4 | B | GPIO
 |  | DOWN | I | NA | NA | 0 | 1 |  |  |  |  |  |  |  |  |  |  | 1 | CIF_D8_M0 | I | CIF data 8
 |  | DOWN | I | NA | NA | 0 | 1 |  |  |  |  |  |  |  |  |  |  | 2 | RGMII_TXD1_M0 | O | MAC TX data1
 |  | DOWN | I | NA | NA | 0 | 1 |  |  |  |  |  |  |  |  |  |  | 3 | I2S0_SDO2_SDI2_M1 | B | Serial output data2/input data2 of I2S0
 |  | DOWN | I | NA | NA | 0 | 1 |  |  |  |  |  |  |  |  |  |  | 5 | SPI1_CS1n_M0 | B | CS signal1 of SPI1
N18 | CIF_D9_M0/RGMII_TXEN_M0/I2S0_SDO3_SDI1_M1/SPI1_CS0n_M0/GPIO3_B5_d | DOWN | I | NA | NA | 0 | 1 | VCCIO6 | 1.8V/3.3V | I/O | √ | √ | GRF1_GPIO3B_DS_H | GRF1_GPIO3B_P | GRF1_GPIO3B_IE | GRF1_GPIO3B_SMT | GRF1_GPIO3B_IOMUX_H | 0 | GPIO3_B5 | B | GPIO
 |  | DOWN | I | NA | NA | 0 | 1 |  |  |  |  |  |  |  |  |  |  | 1 | CIF_D9_M0 | I | CIF data 9
 |  | DOWN | I | NA | NA | 0 | 1 |  |  |  |  |  |  |  |  |  |  | 2 | RGMII_TXEN_M0 | O | MAC TX data validity signal
 |  | DOWN | I | NA | NA | 0 | 1 |  |  |  |  |  |  |  |  |  |  | 3 | I2S0_SDO3_SDI1_M1 | B | Serial output data3/input data1 of I2S0
 |  | DOWN | I | NA | NA | 0 | 1 |  |  |  |  |  |  |  |  |  |  | 5 | SPI1_CS0n_M0 | B | CS signal0 of SPI1
R20 | CIF_D10_M0/RGMII_RXD0_M0/PDM_SDI2_M1/SPI1_MOSI_M0/GPIO3_B6_d | DOWN | I | NA | NA | 0 | 1 | VCCIO6 | 1.8V/3.3V | I/O | √ | √ | GRF1_GPIO3B_DS_H | GRF1_GPIO3B_P | GRF1_GPIO3B_IE | GRF1_GPIO3B_SMT | GRF1_GPIO3B_IOMUX_H | 0 | GPIO3_B6 | B | GPIO
 |  | DOWN | I | NA | NA | 0 | 1 |  |  |  |  |  |  |  |  |  |  | 1 | CIF_D10_M0 | I | CIF data 10
 |  | DOWN | I | NA | NA | 0 | 1 |  |  |  |  |  |  |  |  |  |  | 2 | RGMII_RXD0_M0 | I | MAC RX data0
 |  | DOWN | I | NA | NA | 0 | 1 |  |  |  |  |  |  |  |  |  |  | 3 | PDM_SDI2_M1 | I | PDM input data2
 |  | DOWN | I | NA | NA | 0 | 1 |  |  |  |  |  |  |  |  |  |  | 5 | SPI1_MOSI_M0 | O | Data output of SPI1
R21 | CIF_D11_M0/RGMII_RXD1_M0/PDM_SDI3_M1/SPI1_MISO_M0/GPIO3_B7_d | DOWN | I | NA | NA | 0 | 1 | VCCIO6 | 1.8V/3.3V | I/O | √ | √ | GRF1_GPIO3B_DS_H | GRF1_GPIO3B_P | GRF1_GPIO3B_IE | GRF1_GPIO3B_SMT | GRF1_GPIO3B_IOMUX_H | 0 | GPIO3_B7 | B | GPIO
 |  | DOWN | I | NA | NA | 0 | 1 |  |  |  |  |  |  |  |  |  |  | 1 | CIF_D11_M0 | I | CIF data 11
 |  | DOWN | I | NA | NA | 0 | 1 |  |  |  |  |  |  |  |  |  |  | 2 | RGMII_RXD1_M0 | I | MAC RX data1
 |  | DOWN | I | NA | NA | 0 | 1 |  |  |  |  |  |  |  |  |  |  | 3 | PDM_SDI3_M1 | I | PDM input data3
 |  | DOWN | I | NA | NA | 0 | 1 |  |  |  |  |  |  |  |  |  |  | 5 | SPI1_MISO_M0 | I | Data input of SPI1
N19 | CIF_D12_M0/RGMII_CLK_M0/PDM_CLk0_M1/SPI1_CLK_M0/GPIO3_C0_d | DOWN | I | NA | NA | 0 | 1 | VCCIO6 | 1.8V/3.3V | I/O | √ | √ | GRF1_GPIO3C_DS_L | GRF1_GPIO3C_P | GRF1_GPIO3C_IE | GRF1_GPIO3C_SMT | GRF1_GPIO3C_IOMUX_L | 0 | GPIO3_C0 | B | GPIO
 |  | DOWN | I | NA | NA | 0 | 1 |  |  |  |  |  |  |  |  |  |  | 1 | CIF_D12_M0 | I | CIF data 12
 |  | DOWN | I | NA | NA | 0 | 1 |  |  |  |  |  |  |  |  |  |  | 2 | RGMII_CLK_M0 | B | MAC REC_CLK output or external clock input
 |  | DOWN | I | NA | NA | 0 | 1 |  |  |  |  |  |  |  |  |  |  | 3 | PDM_CLk0_M1 | O | PDM clock signal0
 |  | DOWN | I | NA | NA | 0 | 1 |  |  |  |  |  |  |  |  |  |  | 5 | SPI1_CLK_M0 | B | Clock of SPI1
M17 | CIF_D13_M0/RGMII_RXDV_M0/PDM_SDI0_M1/GPIO3_C1_d | DOWN | I | NA | NA | 0 | 1 | VCCIO6 | 1.8V/3.3V | I/O | √ | √ | GRF1_GPIO3C_DS_L | GRF1_GPIO3C_P | GRF1_GPIO3C_IE | GRF1_GPIO3C_SMT | GRF1_GPIO3C_IOMUX_L | 0 | GPIO3_C1 | B | GPIO
 |  | DOWN | I | NA | NA | 0 | 1 |  |  |  |  |  |  |  |  |  |  | 1 | CIF_D13_M0 | I | CIF data 13
 |  | DOWN | I | NA | NA | 0 | 1 |  |  |  |  |  |  |  |  |  |  | 2 | RGMII_RXDV_M0 | I | RX data validity and carrier sense signal of the RMII
 |  | DOWN | I | NA | NA | 0 | 1 |  |  |  |  |  |  |  |  |  |  | 3 | PDM_SDI0_M1 | I | PDM input data0
M18 | CIF_D14_M0/RGMII_RXER_M0/PDM_SDI1_M1/GPIO3_C2_d | DOWN | I | NA | NA | 0 | 1 | VCCIO6 | 1.8V/3.3V | I/O | √ | √ | GRF1_GPIO3C_DS_L | GRF1_GPIO3C_P | GRF1_GPIO3C_IE | GRF1_GPIO3C_SMT | GRF1_GPIO3C_IOMUX_L | 0 | GPIO3_C2 | B | GPIO
 |  | DOWN | I | NA | NA | 0 | 1 |  |  |  |  |  |  |  |  |  |  | 1 | CIF_D14_M0 | I | CIF data 14
 |  | DOWN | I | NA | NA | 0 | 1 |  |  |  |  |  |  |  |  |  |  | 2 | RGMII_RXER_M0 | I | Receive Error of MAC
 |  | DOWN | I | NA | NA | 0 | 1 |  |  |  |  |  |  |  |  |  |  | 3 | PDM_SDI1_M1 | I | PDM input data1
N20 | CIF_D15_M0/RGMII_MDIO_M0/PDM_CLk1_M1/GPIO3_C3_d | DOWN | I | NA | NA | 0 | 1 | VCCIO6 | 1.8V/3.3V | I/O | √ | √ | GRF1_GPIO3C_DS_L | GRF1_GPIO3C_P | GRF1_GPIO3C_IE | GRF1_GPIO3C_SMT | GRF1_GPIO3C_IOMUX_L | 0 | GPIO3_C3 | B | GPIO
 |  | DOWN | I | NA | NA | 0 | 1 |  |  |  |  |  |  |  |  |  |  | 1 | CIF_D15_M0 | I | CIF data 15
 |  | DOWN | I | NA | NA | 0 | 1 |  |  |  |  |  |  |  |  |  |  | 2 | RGMII_MDIO_M0 | B | MDIO interface data
 |  | DOWN | I | NA | NA | 0 | 1 |  |  |  |  |  |  |  |  |  |  | 3 | PDM_CLk1_M1 | O | PDM clock signal1
N21 | CIF_VSYNC_M0/RGMII_MDC_M0/UART3_RTSN_M0/GPIO3_C4_d | DOWN | I | NA | NA | 0 | 1 | VCCIO6 | 1.8V/3.3V | I/O | √ | √ | GRF1_GPIO3C_DS_H | GRF1_GPIO3C_P | GRF1_GPIO3C_IE | GRF1_GPIO3C_SMT | GRF1_GPIO3C_IOMUX_H | 0 | GPIO3_C4 | B | GPIO
 |  | DOWN | I | NA | NA | 0 | 1 |  |  |  |  |  |  |  |  |  |  | 1 | CIF_VSYNC_M0 | I | CIF field sync signal
 |  | DOWN | I | NA | NA | 0 | 1 |  |  |  |  |  |  |  |  |  |  | 2 | RGMII_MDC_M0 | O | MDIO interface clock
 |  | DOWN | I | NA | NA | 0 | 1 |  |  |  |  |  |  |  |  |  |  | 4 | UART3_RTSN_M0 | O | UART3 Request-to-send signal
M19 | CIF_CLKIN_M0/CLK_OUT_ETHERNET_M0/UART3_CTSN_M0/GPIO3_C5_d | DOWN | I | NA | NA | 0 | 1 | VCCIO6 | 1.8V/3.3V | I/O | √ | √ | GRF1_GPIO3C_DS_H | GRF1_GPIO3C_P | GRF1_GPIO3C_IE | GRF1_GPIO3C_SMT | GRF1_GPIO3C_IOMUX_H | 0 | GPIO3_C5 | B | GPIO
 |  | DOWN | I | NA | NA | 0 | 1 |  |  |  |  |  |  |  |  |  |  | 1 | CIF_CLKIN_M0 | I | CIF clock input
 |  | DOWN | I | NA | NA | 0 | 1 |  |  |  |  |  |  |  |  |  |  | 2 | CLK_OUT_ETHERNET_M0 | O | Output reference Clock to PHY
 |  | DOWN | I | NA | NA | 0 | 1 |  |  |  |  |  |  |  |  |  |  | 4 | UART3_CTSN_M0 | I | UART3 clear-to-send signal
P19 | CIF_CLKOUT_M0/RGMII_TXCLK_M0/UART3_TX_M0/GPIO3_C6_d | DOWN | I | NA | NA | 0 | 1 | VCCIO6 | 1.8V/3.3V | I/O | √ | √ | GRF1_GPIO3C_DS_H | GRF1_GPIO3C_P | GRF1_GPIO3C_IE | GRF1_GPIO3C_SMT | GRF1_GPIO3C_IOMUX_H | 0 | GPIO3_C6 | B | GPIO
 |  | DOWN | I | NA | NA | 0 | 1 |  |  |  |  |  |  |  |  |  |  | 1 | CIF_CLKOUT_M0 | O | CIF clock output
 |  | DOWN | I | NA | NA | 0 | 1 |  |  |  |  |  |  |  |  |  |  | 2 | RGMII_TXCLK_M0 | O | MAC TX clock
 |  | DOWN | I | NA | NA | 0 | 1 |  |  |  |  |  |  |  |  |  |  | 4 | UART3_TX_M0 | O | UART3 TX data
P20 | CIF_HSYNC_M0/RGMII_RXCLK_M0/UART3_RX_M0/GPIO3_C7_d | DOWN | I | NA | NA | 0 | 1 | VCCIO6 | 1.8V/3.3V | I/O | √ | √ | GRF1_GPIO3C_DS_H | GRF1_GPIO3C_P | GRF1_GPIO3C_IE | GRF1_GPIO3C_SMT | GRF1_GPIO3C_IOMUX_H | 0 | GPIO3_C7 | B | GPIO
 |  | DOWN | I | NA | NA | 0 | 1 |  |  |  |  |  |  |  |  |  |  | 1 | CIF_HSYNC_M0 | I | CIF horizontal sync signal
 |  | DOWN | I | NA | NA | 0 | 1 |  |  |  |  |  |  |  |  |  |  | 2 | RGMII_RXCLK_M0 | I | The continuous receive reference clock
 |  | DOWN | I | NA | NA | 0 | 1 |  |  |  |  |  |  |  |  |  |  | 4 | UART3_RX_M0 | I | UART3 RX data
M15 | VCCIO6_VDD |  |  |  |  |  |  | VCCIO6 | 1.8V/3.3V | PI | -- | -- | -- | -- | -- | -- | -- | 0 | VCCIO6_VDD | -- | 1.8V/3.3V I/O power of VCCIO6
VCCIO7 | 11balls |  |  |  |  |  |  | Power Supply | Supply Voltage | Pin Type | Schmitt Trigger | Interruptable | Driver strength control register | PU/PD control register | Input enable control register | Schmitt trigger control register | IOMUX control register | function Number | Signal Name | Direction | Description
W12 | I2S0_SCLK_TX_M0/ACODEC_DAC_CLK/GPIO3_D0_d | DOWN | I | 0 | 0 | 0 | 1 | VCCIO7 | 1.8V/3.3V | I/O | √ | √ | GRF1_GPIO3D_DS_L | GRF1_GPIO3D_P | GRF1_GPIO3D_IE | GRF1_GPIO3D_SMT | GRF1_GPIO3D_IOMUX_L | 0 | GPIO3_D0 | B | GPIO
 |  | DOWN | I | 0 | 0 | 0 | 1 |  |  |  |  |  |  |  |  |  |  | 1 | I2S0_SCLK_TX_M0 | B | I2S/PCM serial clock
 |  | DOWN | I | 0 | 0 | 0 | 1 |  |  |  |  |  |  |  |  |  |  | 3 | ACODEC_DAC_CLK | O | CODEC DAC clock output signal
V12 | I2S0_SCLK_RX_M0/PDM_CLk1_M0/ACODEC_ADC_CLK/GPIO3_D1_d | DOWN | I | 0 | 0 | 0 | 1 | VCCIO7 | 1.8V/3.3V | I/O | √ | √ | GRF1_GPIO3D_DS_L | GRF1_GPIO3D_P | GRF1_GPIO3D_IE | GRF1_GPIO3D_SMT | GRF1_GPIO3D_IOMUX_L | 0 | GPIO3_D1 | B | GPIO
 |  | DOWN | I | 0 | 0 | 0 | 1 |  |  |  |  |  |  |  |  |  |  | 1 | I2S0_SCLK_RX_M0 | B | I2S/PCM serial clock
 |  | DOWN | I | 0 | 0 | 0 | 1 |  |  |  |  |  |  |  |  |  |  | 2 | PDM_CLk1_M0 | O | PDM clock signal1
 |  | DOWN | I | 0 | 0 | 0 | 1 |  |  |  |  |  |  |  |  |  |  | 3 | ACODEC_ADC_CLK | O | CODEC ADC clock output signal
U12 | I2S0_MCLK_M0/GPIO3_D2_d | DOWN | I | 0 | 0 | 0 | 1 | VCCIO7 | 1.8V/3.3V | I/O | √ | √ | GRF1_GPIO3D_DS_L | GRF1_GPIO3D_P | GRF1_GPIO3D_IE | GRF1_GPIO3D_SMT | GRF1_GPIO3D_IOMUX_L | 0 | GPIO3_D2 | B | GPIO
 |  | DOWN | I | 0 | 0 | 0 | 1 |  |  |  |  |  |  |  |  |  |  | 1 | I2S0_MCLK_M0 | O | I2S/PCM clock to external device
W11 | I2S0_LRCK_TX_M0/ACODEC_DAC_SYNC/AUDPWM_L_M1/AUDDSM_LN/GPIO3_D3_d | DOWN | I | 0 | 0 | 0 | 1 | VCCIO7 | 1.8V/3.3V | I/O | √ | √ | GRF1_GPIO3D_DS_L | GRF1_GPIO3D_P | GRF1_GPIO3D_IE | GRF1_GPIO3D_SMT | GRF1_GPIO3D_IOMUX_L | 0 | GPIO3_D3 | B | GPIO
 |  | DOWN | I | 0 | 0 | 0 | 1 |  |  |  |  |  |  |  |  |  |  | 1 | I2S0_LRCK_TX_M0 | B | I2S/PCM left & right channel signal for receiving serial data, synchronous left & right channel in I2S mode and the beginning of a group of left & right channels in PCM mode
 |  | DOWN | I | 0 | 0 | 0 | 1 |  |  |  |  |  |  |  |  |  |  | 3 | ACODEC_DAC_SYNC | O | CODEC ADC synchronous signal
 |  | DOWN | I | 0 | 0 | 0 | 1 |  |  |  |  |  |  |  |  |  |  | 4 | AUDPWM_L_M1 | O | Audio PWM left channel data
 |  | DOWN | I | 0 | 0 | 0 | 1 |  |  |  |  |  |  |  |  |  |  | 5 | AUDDSM_LN | O | Audio DSM negative differential left channel data
Y12 | I2S0_LRCK_RX_M0/PDM_CLk0_M0/ACODEC_ADC_SYNC/GPIO3_D4_d | DOWN | I | 0 | 0 | 0 | 1 | VCCIO7 | 1.8V/3.3V | I/O | √ | √ | GRF1_GPIO3D_DS_H | GRF1_GPIO3D_P | GRF1_GPIO3D_IE | GRF1_GPIO3D_SMT | GRF1_GPIO3D_IOMUX_H | 0 | GPIO3_D4 | B | GPIO
 |  | DOWN | I | 0 | 0 | 0 | 1 |  |  |  |  |  |  |  |  |  |  | 1 | I2S0_LRCK_RX_M0 | B | I2S/PCM left & right channel signal for receiving serial data, synchronous left & right channel in I2S mode and the beginning of a group of left & right channels in PCM mode
 |  | DOWN | I | 0 | 0 | 0 | 1 |  |  |  |  |  |  |  |  |  |  | 2 | PDM_CLk0_M0 | O | PDM clock signal 0
 |  | DOWN | I | 0 | 0 | 0 | 1 |  |  |  |  |  |  |  |  |  |  | 3 | ACODEC_ADC_SYNC | O | CODEC ADC synchronous signal
Y11 | I2S0_SDO0_M0/ACODEC_DAC_DATAR/AUDPWM_R_M1/AUDDSM_LP/GPIO3_D5_d | DOWN | I | NA | NA | 0 | 1 | VCCIO7 | 1.8V/3.3V | I/O | √ | √ | GRF1_GPIO3D_DS_H | GRF1_GPIO3D_P | GRF1_GPIO3D_IE | GRF1_GPIO3D_SMT | GRF1_GPIO3D_IOMUX_H | 0 | GPIO3_D5 | B | GPIO
 |  | DOWN | I | NA | NA | 0 | 1 |  |  |  |  |  |  |  |  |  |  | 1 | I2S0_SDO0_M0 | O | serial data0 output of I2S0 or PCM interface
 |  | DOWN | I | NA | NA | 0 | 1 |  |  |  |  |  |  |  |  |  |  | 3 | ACODEC_DAC_DATAR | O | CODEC DAC right channel data
 |  | DOWN | I | NA | NA | 0 | 1 |  |  |  |  |  |  |  |  |  |  | 4 | AUDPWM_R_M1 | O | Audio PWM right channel data
 |  | DOWN | I | NA | NA | 0 | 1 |  |  |  |  |  |  |  |  |  |  | 5 | AUDDSM_LP | O | Audio DSM positive differential left channel data
AA12 | I2S0_SDI0_M0/PDM_SDI0_M0/ACODEC_DAC_DATAL/GPIO3_D6_d | DOWN | I | NA | NA | 0 | 1 | VCCIO7 | 1.8V/3.3V | I/O | √ | √ | GRF1_GPIO3D_DS_H | GRF1_GPIO3D_P | GRF1_GPIO3D_IE | GRF1_GPIO3D_SMT | GRF1_GPIO3D_IOMUX_H | 0 | GPIO3_D6 | B | GPIO
 |  | DOWN | I | NA | NA | 0 | 1 |  |  |  |  |  |  |  |  |  |  | 1 | I2S0_SDI0_M0 | I | serial data0 input of I2S0 or PCM interface
 |  | DOWN | I | NA | NA | 0 | 1 |  |  |  |  |  |  |  |  |  |  | 2 | PDM_SDI0_M0 | I | PDM input data0
 |  | DOWN | I | NA | NA | 0 | 1 |  |  |  |  |  |  |  |  |  |  | 3 | ACODEC_DAC_DATAL | O | CODEC DAC left channel data
T11 | I2S0_SDO1_SDI3_M0/PDM_SDI3_M0/ACODEC_ADC_DATA/GPIO3_D7_d | DOWN | I | NA | NA | 0 | 1 | VCCIO7 | 1.8V/3.3V | I/O | √ | √ | GRF1_GPIO3D_DS_H | GRF1_GPIO3D_P | GRF1_GPIO3D_IE | GRF1_GPIO3D_SMT | GRF1_GPIO3D_IOMUX_H | 0 | GPIO3_D7 | B | GPIO
 |  | DOWN | I | NA | NA | 0 | 1 |  |  |  |  |  |  |  |  |  |  | 1 | I2S0_SDO1_SDI3_M0 | B | serial data1 output or serial data3 input of I2S0
 |  | DOWN | I | NA | NA | 0 | 1 |  |  |  |  |  |  |  |  |  |  | 2 | PDM_SDI3_M0 | I | PDM input data3
 |  | DOWN | I | NA | NA | 0 | 1 |  |  |  |  |  |  |  |  |  |  | 3 | ACODEC_ADC_DATA | I | CODEC ADC data
U11 | I2S0_SDO2_SDI2_M0/PDM_SDI2_M0/AUDPWM_L_M0/I2C4_SCL_M1/AUDDSM_RN/GPIO4_A0_d | DOWN | I | NA | NA | 0 | 1 | VCCIO7 | 1.8V/3.3V | I/O | √ | √ | GRF1_GPIO4A_DS_L | GRF1_GPIO4A_P | GRF1_GPIO4A_IE | GRF1_GPIO4A_SMT | GRF1_GPIO4A_IOMUX_L | 0 | GPIO4_A0 | B | GPIO
 |  | DOWN | I | NA | NA | 0 | 1 |  |  |  |  |  |  |  |  |  |  | 1 | I2S0_SDO2_SDI2_M0 | B | serial data2 output or serial data2 input of I2S0
 |  | DOWN | I | NA | NA | 0 | 1 |  |  |  |  |  |  |  |  |  |  | 2 | PDM_SDI2_M0 | I | PDM input data2
 |  | DOWN | I | NA | NA | 0 | 1 |  |  |  |  |  |  |  |  |  |  | 3 | AUDPWM_L_M0 | O | Audio PWM left channel data
 |  | DOWN | I | NA | NA | 0 | 1 |  |  |  |  |  |  |  |  |  |  | 4 | I2C4_SCL_M1 | O | Clock of I2C bus4
 |  | DOWN | I | NA | NA | 0 | 1 |  |  |  |  |  |  |  |  |  |  | 5 | AUDDSM_RN | O | Audio DSM negative differential right channel data
V11 | I2S0_SDO3_SDI1_M0/PDM_SDI1_M0/AUDPWM_R_M0/I2C4_SDA_M1/AUDDSM_RP/GPIO4_A1_d | DOWN | I | NA | NA | 0 | 1 | VCCIO7 | 1.8V/3.3V | I/O | √ | √ | GRF1_GPIO4A_DS_L | GRF1_GPIO4A_P | GRF1_GPIO4A_IE | GRF1_GPIO4A_SMT | GRF1_GPIO4A_IOMUX_L | 0 | GPIO4_A1 | B | GPIO
 |  | DOWN | I | NA | NA | 0 | 1 |  |  |  |  |  |  |  |  |  |  | 1 | I2S0_SDO3_SDI1_M0 | B | serial data3 output or serial data1 input of I2S0
 |  | DOWN | I | NA | NA | 0 | 1 |  |  |  |  |  |  |  |  |  |  | 2 | PDM_SDI1_M0 | I | PDM input data1
 |  | DOWN | I | NA | NA | 0 | 1 |  |  |  |  |  |  |  |  |  |  | 3 | AUDPWM_R_M0 | O | Audio PWM right channel data
 |  | DOWN | I | NA | NA | 0 | 1 |  |  |  |  |  |  |  |  |  |  | 4 | I2C4_SDA_M1 | B | Data/Address of I2C bus4
 |  | DOWN | I | NA | NA | 0 | 1 |  |  |  |  |  |  |  |  |  |  | 5 | AUDDSM_RP | O | Audio DSM positive differential right channel data
T12 | VCCIO7_VDD |  |  |  |  |  |  | VCCIO7 | 1.8V/3.3V | PI | -- | -- | -- | -- | -- | -- | -- | 0 | VCCIO7_VDD | -- | 1.8V/3.3V I/O power of VCCIO7
MIPI DSI | 12 balls |  |  |  |  |  |  | Power Supply | Supply Voltage | Pin Type | Schmitt Trigger | Interruptable | Driver strength control register | PU/PD control register | Input enable control register | Schmitt trigger control register | IOMUX control register | function Number | Signal Name | Direction | Description
A19 | MIPI_DSI_TX0_D0P |  |  |  |  |  |  | MIPI_DSI | -- | A | -- | -- | -- | -- | -- | -- | -- | 0 | MIPI_DSI_TX0_D0P | O | Positive pole of differential data0 of MIPI TX interface
B19 | MIPI_DSI_TX0_D0N |  |  |  |  |  |  | MIPI_DSI | -- | A | -- | -- | -- | -- | -- | -- | -- | 0 | MIPI_DSI_TX0_D0N | O | Negative pole of differential data0 of MIPI TX interface
A20 | MIPI_DSI_TX0_D1P |  |  |  |  |  |  | MIPI_DSI | -- | A | -- | -- | -- | -- | -- | -- | -- | 0 | MIPI_DSI_TX0_D1P | O | Positive pole of differential data1 of MIPI TX interface
B20 | MIPI_DSI_TX0_D1N |  |  |  |  |  |  | MIPI_DSI | -- | A | -- | -- | -- | -- | -- | -- | -- | 0 | MIPI_DSI_TX0_D1N | O | Negative pole of differential data1 of MIPI TX interface
B21 | MIPI_DSI_TX0_D2P |  |  |  |  |  |  | MIPI_DSI | -- | A | -- | -- | -- | -- | -- | -- | -- | 0 | MIPI_DSI_TX0_D2P | O | Positive pole of differential data2 of MIPI TX interface
C20 | MIPI_DSI_TX0_D2N |  |  |  |  |  |  | MIPI_DSI | -- | A | -- | -- | -- | -- | -- | -- | -- | 0 | MIPI_DSI_TX0_D2N | O | Negative pole of differential data2 of MIPI TX interface
D20 | MIPI_DSI_TX0_D3P |  |  |  |  |  |  | MIPI_DSI | -- | A | -- | -- | -- | -- | -- | -- | -- | 0 | MIPI_DSI_TX0_D3P | O | Positive pole of differential data3 of MIPI TX interface
D19 | MIPI_DSI_TX0_D3N |  |  |  |  |  |  | MIPI_DSI | -- | A | -- | -- | -- | -- | -- | -- | -- | 0 | MIPI_DSI_TX0_D3N | O | Negative pole of differential data3 of MIPI TX interface
C19 | MIPI_DSI_TX0_CLKP |  |  |  |  |  |  | MIPI_DSI | -- | A | -- | -- | -- | -- | -- | -- | -- | 0 | MIPI_DSI_TX0_CLKP | O | Positive pole of differential clock of MIPI TX interface
C18 | MIPI_DSI_TX0_CLKN |  |  |  |  |  |  | MIPI_DSI | -- | A | -- | -- | -- | -- | -- | -- | -- | 0 | MIPI_DSI_TX0_CLKN | O | Negative pole of differential clock of MIPI TX interface
E18 | MIPI_DSI_TX0_AVDD_0V8 |  |  |  |  |  |  | MIPI_DSI | 0.8V | API | -- | -- | -- | -- | -- | -- | -- | 0 | MIPI_DSI_TX0_AVDD_0V8 | -- | MIPI TX AVDD 0.8V
G15 | MIPI_DSI_TX0_AVDD_1V8 |  |  |  |  |  |  | MIPI_DSI | 1.8V | API | -- | -- | -- | -- | -- | -- | -- | 0 | MIPI_DSI_TX0_AVDD_1V8 | -- | MIPI TX AVDD 1.8V
MIPI CSI0 | 12 balls |  |  |  |  |  |  | Power Supply | Supply Voltage | Pin Type | Schmitt Trigger | Interruptable | Driver strength control register | PU/PD control register | Input enable control register | Schmitt trigger control register | IOMUX control register | function Number | Signal Name | Direction | Description
V16 | MIPI_CSI_RX0_D0P/LVDS0_RX0P |  |  |  |  |  |  | MIPI_CSI | -- | A | -- | -- | -- | -- | -- | -- | -- | 0 | MIPI_CSI_RX0_D0P | I | Positive pole of differential data0 of MIPI RX interface
 |  |  |  |  |  |  |  |  |  |  |  |  | -- | -- | -- | -- | -- | 1 | LVDS0_RX0P | I | Positive pole of differential data0 of LVDS RX interface
U16 | MIPI_CSI_RX0_D0N/LVDS0_RX0N |  |  |  |  |  |  | MIPI_CSI | -- | A | -- | -- | -- | -- | -- | -- | -- | 0 | MIPI_CSI_RX0_D0N | I | Negative pole of differential data0 of MIPI RX interface
 |  |  |  |  |  |  |  |  |  |  |  |  | -- | -- | -- | -- | -- | 1 | LVDS0_RX0N | I | Negative pole of differential data0 of LVDS RX interface
Y16 | MIPI_CSI_RX0_D1P/LVDS0_RX1P |  |  |  |  |  |  | MIPI_CSI | -- | A | -- | -- | -- | -- | -- | -- | -- | 0 | MIPI_CSI_RX0_D1P | I | Positive pole of differential data1 of MIPI RX interface
 |  |  |  |  |  |  |  |  |  |  |  |  | -- | -- | -- | -- | -- | 1 | LVDS0_RX1P | I | Positive pole of differential data1 of LVDS RX interface
W16 | MIPI_CSI_RX0_D1N/LVDS0_RX1N |  |  |  |  |  |  | MIPI_CSI | -- | A | -- | -- | -- | -- | -- | -- | -- | 0 | MIPI_CSI_RX0_D1N | I | Negative pole of differential data1 of MIPI RX interface
 |  |  |  |  |  |  |  |  |  |  |  |  | -- | -- | -- | -- | -- | 1 | LVDS0_RX1N | I | Negative pole of differential data1 of LVDS RX interface
W15 | MIPI_CSI_RX0_D2P/LVDS0_RX2P |  |  |  |  |  |  | MIPI_CSI | -- | A | -- | -- | -- | -- | -- | -- | -- | 0 | MIPI_CSI_RX0_D2P | I | Positive pole of differential data2 of MIPI RX interface
 |  |  |  |  |  |  |  |  |  |  |  |  | -- | -- | -- | -- | -- | 1 | LVDS0_RX2P | I | Positive pole of differential data2 of LVDS RX interface
Y15 | MIPI_CSI_RX0_D2N/LVDS0_RX2N |  |  |  |  |  |  | MIPI_CSI | -- | A | -- | -- | -- | -- | -- | -- | -- | 0 | MIPI_CSI_RX0_D2N | I | Negative pole of differential data2 of MIPI RX interface
 |  |  |  |  |  |  |  |  |  |  |  |  | -- | -- | -- | -- | -- | 1 | LVDS0_RX2N | I | Negative pole of differential data2 of LVDS RX interface
AA15 | MIPI_CSI_RX0_D3P/LVDS0_RX3P |  |  |  |  |  |  | MIPI_CSI | -- | A | -- | -- | -- | -- | -- | -- | -- | 0 | MIPI_CSI_RX0_D3P | I | Positive pole of differential data3 of MIPI RX interface
 |  |  |  |  |  |  |  |  |  |  |  |  | -- | -- | -- | -- | -- | 1 | LVDS0_RX3P | I | Positive pole of differential data3 of LVDS RX interface
AA16 | MIPI_CSI_RX0_D3N/LVDS0_RX3N |  |  |  |  |  |  | MIPI_CSI | -- | A | -- | -- | -- | -- | -- | -- | -- | 0 | MIPI_CSI_RX0_D3N | I | Negative pole of differential data3 of MIPI RX interface
 |  |  |  |  |  |  |  |  |  |  |  |  | -- | -- | -- | -- | -- | 1 | LVDS0_RX3N | I | Negative pole of differential data3 of LVDS RX interface
U15 | MIPI_CSI_RX0_CLKP/LVDS0_CLKP |  |  |  |  |  |  | MIPI_CSI | -- | A | -- | -- | -- | -- | -- | -- | -- | 0 | MIPI_CSI_RX0_CLKP | I | Positive pole of differential clock of MIPI RX interface
 |  |  |  |  |  |  |  |  |  |  |  |  | -- | -- | -- | -- | -- | 1 | LVDS0_CLKP | I | Positive pole of differential clock of LVDS RX interface
V15 | MIPI_CSI_RX0_CLKN/LVDS0_CLKN |  |  |  |  |  |  | MIPI_CSI | -- | A | -- | -- | -- | -- | -- | -- | -- | 0 | MIPI_CSI_RX0_CLKN | I | Negative pole of differential clock of MIPI RX interface
 |  |  |  |  |  |  |  |  |  |  |  |  | -- | -- | -- | -- | -- | 1 | LVDS0_CLKN | I | Negative pole of differential clock of LVDS RX interface
T15 | MIPI_CSI_RX0_AVDD_0V8 |  |  |  |  |  |  | MIPI_CSI | 0.8V | API | -- | -- | -- | -- | -- | -- | -- | 0 | MIPI_CSI_RX0_AVDD_0V8 | -- | MIPI/LVDC RX AVDD 0.8V
T16 | MIPI_CSI_RX0_AVDD_1V8 |  |  |  |  |  |  | MIPI_CSI | 1.8V | API | -- | -- | -- | -- | -- | -- | -- | 0 | MIPI_CSI_RX0_AVDD_1V8 | -- | MIPI/LVDC RX AVDD 1.8V
MIPI CSI1 | 12 balls |  |  |  |  |  |  | Power Supply | Supply Voltage | Pin Type | Schmitt Trigger | Interruptable | Driver strength control register | PU/PD control register | Input enable control register | Schmitt trigger control register | IOMUX control register | function Number | Signal Name | Direction | Description
AA20 | MIPI_CSI_RX1_D0P/LVDS1_RX0P |  |  |  |  |  |  | MIPI_CSI | -- | A | -- | -- | -- | -- | -- | -- | -- | 0 | MIPI_CSI_RX1_D0P | I | Positive pole of differential data0 of MIPI RX interface
 |  |  |  |  |  |  |  |  |  |  |  |  | -- | -- | -- | -- | -- | 1 | LVDS1_RX0P | I | Positive pole of differential data0 of LVDS RX interface
Y20 | MIPI_CSI_RX1_D0N/LVDS1_RX0N |  |  |  |  |  |  | MIPI_CSI | -- | A | -- | -- | -- | -- | -- | -- | -- | 0 | MIPI_CSI_RX1_D0N | I | Negative pole of differential data0 of MIPI RX interface
 |  |  |  |  |  |  |  |  |  |  |  |  | -- | -- | -- | -- | -- | 1 | LVDS1_RX0N | I | Negative pole of differential data0 of LVDS RX interface
AA19 | MIPI_CSI_RX1_D1P/LVDS1_RX1P |  |  |  |  |  |  | MIPI_CSI | -- | A | -- | -- | -- | -- | -- | -- | -- | 0 | MIPI_CSI_RX1_D1P | I | Positive pole of differential data1 of MIPI RX interface
 |  |  |  |  |  |  |  |  |  |  |  |  | -- | -- | -- | -- | -- | 1 | LVDS1_RX1P | I | Positive pole of differential data1 of LVDS RX interface
Y19 | MIPI_CSI_RX1_D1N/LVDS1_RX1N |  |  |  |  |  |  | MIPI_CSI | -- | A | -- | -- | -- | -- | -- | -- | -- | 0 | MIPI_CSI_RX1_D1N | I | Negative pole of differential data1 of MIPI RX interface
 |  |  |  |  |  |  |  |  |  |  |  |  | -- | -- | -- | -- | -- | 1 | LVDS1_RX1N | I | Negative pole of differential data1 of LVDS RX interface
AA18 | MIPI_CSI_RX1_D2P/LVDS1_RX2P |  |  |  |  |  |  | MIPI_CSI | -- | A | -- | -- | -- | -- | -- | -- | -- | 0 | MIPI_CSI_RX1_D2P | I | Positive pole of differential data2 of MIPI RX interface
 |  |  |  |  |  |  |  |  |  |  |  |  | -- | -- | -- | -- | -- | 1 | LVDS1_RX2P | I | Positive pole of differential data2 of LVDS RX interface
Y18 | MIPI_CSI_RX1_D2N/LVDS1_RX2N |  |  |  |  |  |  | MIPI_CSI | -- | A | -- | -- | -- | -- | -- | -- | -- | 0 | MIPI_CSI_RX1_D2N | I | Negative pole of differential data2 of MIPI RX interface
 |  |  |  |  |  |  |  |  |  |  |  |  | -- | -- | -- | -- | -- | 1 | LVDS1_RX2N | I | Negative pole of differential data2 of LVDS RX interface
Y17 | MIPI_CSI_RX1_D3P/LVDS1_RX3P |  |  |  |  |  |  | MIPI_CSI | -- | A | -- | -- | -- | -- | -- | -- | -- | 0 | MIPI_CSI_RX1_D3P | I | Positive pole of differential data3 of MIPI RX interface
 |  |  |  |  |  |  |  |  |  |  |  |  | -- | -- | -- | -- | -- | 1 | LVDS1_RX3P | I | Positive pole of differential data3 of LVDS RX interface
W17 | MIPI_CSI_RX1_D3N/LVDS1_RX3N |  |  |  |  |  |  | MIPI_CSI | -- | A | -- | -- | -- | -- | -- | -- | -- | 0 | MIPI_CSI_RX1_D3N | I | Negative pole of differential data3 of MIPI RX interface
 |  |  |  |  |  |  |  |  |  |  |  |  | -- | -- | -- | -- | -- | 1 | LVDS1_RX3N | I | Negative pole of differential data3 of LVDS RX interface
V18 | MIPI_CSI_RX1_CLKP/LVDS1_CLKP |  |  |  |  |  |  | MIPI_CSI | -- | A | -- | -- | -- | -- | -- | -- | -- | 0 | MIPI_CSI_RX1_CLKP | I | Positive pole of differential clock of MIPI RX interface
 |  |  |  |  |  |  |  |  |  |  |  |  | -- | -- | -- | -- | -- | 1 | LVDS1_CLKP | I | Positive pole of differential clock of LVDS RX interface
W18 | MIPI_CSI_RX1_CLKN/LVDS1_CLKN |  |  |  |  |  |  | MIPI_CSI | -- | A | -- | -- | -- | -- | -- | -- | -- | 0 | MIPI_CSI_RX1_CLKN | I | Negative pole of differential clock of MIPI RX interface
 |  |  |  |  |  |  |  |  |  |  |  |  | -- | -- | -- | -- | -- | 1 | LVDS1_CLKN | I | Negative pole of differential clock of LVDS RX interface
R15 | MIPI_CSI_RX1_AVDD_0V8 |  |  |  |  |  |  | MIPI_CSI | 0.8V | API | -- | -- | -- | -- | -- | -- | -- | 0 | MIPI_CSI_RX1_AVDD_0V8 | -- | MIPI/LVDC RX AVDD 0.8V
R16 | MIPI_CSI_RX1_AVDD_1V8 |  |  |  |  |  |  | MIPI_CSI | 1.8V | API | -- | -- | -- | -- | -- | -- | -- | 0 | MIPI_CSI_RX1_AVDD_1V8 | -- | MIPI/LVDC RX AVDD 1.8V
SARADC | 7 balls |  |  |  |  |  |  | Power Supply | Supply Voltage | Pin Type | Schmitt Trigger | Interruptable | Driver strength control register | PU/PD control register | Input enable control register | Schmitt trigger control register | IOMUX control register | function Number | Signal Name | Direction | Description
E17 | ADCIN0 |  |  |  |  |  |  | ADC | -- | AI | -- | -- | -- | -- | -- | -- | -- | 0 | ADCIN0 | I | ADC signal0
D17 | ADCIN1 |  |  |  |  |  |  | ADC | -- | AI | -- | -- | -- | -- | -- | -- | -- | 0 | ADCIN1 | I | ADC signal1
B18 | ADCIN2 |  |  |  |  |  |  | ADC | -- | AI | -- | -- | -- | -- | -- | -- | -- | 0 | ADCIN2 | I | ADC signal2
A18 | ADCIN3 |  |  |  |  |  |  | ADC | -- | AI | -- | -- | -- | -- | -- | -- | -- | 0 | ADCIN3 | I | ADC signal3
C17 | ADCIN4 |  |  |  |  |  |  | ADC | -- | AI | -- | -- | -- | -- | -- | -- | -- | 0 | ADCIN4 | I | ADC signal4
B17 | ADCIN5 |  |  |  |  |  |  | ADC | -- | AI | -- | -- | -- | -- | -- | -- | -- | 0 | ADCIN5 | I | ADC signal5
E16 | ADC_AVDD_1V8 |  |  |  |  |  |  | ADC | 1.8V | API | -- | -- | -- | -- | -- | -- | -- | 0 | ADC_AVDD_1V8 | -- | ADC AVDD 1.8V, always need power supply.
USB2.0 | 11 balls |  |  |  |  |  |  | Power Supply | Supply Voltage | Pin Type | Schmitt Trigger | Interruptable | Driver strength control register | PU/PD control register | Input enable control register | Schmitt trigger control register | IOMUX control register | function Number | Signal Name | Direction | Description
W4 | OTG_DM |  |  |  |  |  |  | USB | -- | A | -- | -- | -- | -- | -- | -- | -- | 0 | OTG_DM | B | negative pole of the data signal of the USB OTG 2.0 port, using to download firmware.
W3 | OTG_DP |  |  |  |  |  |  | USB | -- | A | -- | -- | -- | -- | -- | -- | -- | 0 | OTG_DP | B | positive pole of the data signal of the USB OTG 2.0 port, using to download firmware.
Y3 | OTG_ID |  |  |  |  |  |  | USB | -- | A | -- | -- | -- | -- | -- | -- | -- | 0 | OTG_ID | I | Mode select for OTG: OTG_ID=0, OTG as host function OTG_ID=1(1.8V),OTG as device function
U6 | OTG_EXTR |  |  |  |  |  |  | USB | -- | A | -- | -- | -- | -- | -- | -- | -- | 0 | OTG_EXTR | B | connect to external reference resistor:200R
V5 | OTG_VBUS1V8 |  |  |  |  |  |  | USB | -- | A | -- | -- | -- | -- | -- | -- | -- | 0 | OTG_VBUS1V8 | I | USB VBUS signal, level votage is 1.8V.
Y2 | HOST_DM |  |  |  |  |  |  | USB | -- | A | -- | -- | -- | -- | -- | -- | -- | 0 | HOST_DM | B | negative pole of the data signal of the USB HOST 2.0 port, using to download firmware.
Y1 | HOST_DP |  |  |  |  |  |  | USB | -- | A | -- | -- | -- | -- | -- | -- | -- | 0 | HOST_DP | B | positive pole of the data signal of the USB HOST 2.0 port, using to download firmware.
U5 | HOST_EXTR |  |  |  |  |  |  | USB | -- | A | -- | -- | -- | -- | -- | -- | -- | 0 | HOST_EXTR | B | connect to external reference resistor:200R
R6 | USB_AVDD_0V8 |  |  |  |  |  |  | USB | 0.8V | API | -- | -- | -- | -- | -- | -- | -- | 0 | USB_AVDD_0V8 | -- | USB AVDD 0.8V
R7 | USB_AVDD_1V8 |  |  |  |  |  |  | USB | 1.8V | API | -- | -- | -- | -- | -- | -- | -- | 0 | USB_AVDD_1V8 | -- | USB AVDD 1.8V
T7 | USB_AVDD_3V3 |  |  |  |  |  |  | USB | 3.3V | API | -- | -- | -- | -- | -- | -- | -- | 0 | USB_AVDD_3V3 | -- | USB AVDD 3.3V
DDR | 84 balls |  |  |  |  |  |  | Power Supply | Supply Voltage | Pin Type | Schmitt Trigger | Interruptable | Driver strength control register | PU/PD control register | Input enable control register | Schmitt trigger control register | IOMUX control register | function Number | Signal Name | Direction | Description
K4 | DDR3/4_DQ0/LPDDR4_D8_A/LPDDR3_D2 |  |  |  |  |  |  | DDR | -- | A | -- | -- | -- | -- | -- | -- | -- | 0 | DDR3/4_DQ0/LPDDR4_D8_A/LPDDR3_D2 | B | DDR SDRAM data
J4 | DDR3/4_DQ1/LPDDR4_D9_A/LPDDR3_D6 |  |  |  |  |  |  | DDR | -- | A | -- | -- | -- | -- | -- | -- | -- | 0 | DDR3/4_DQ1/LPDDR4_D9_A/LPDDR3_D6 | B | DDR SDRAM data
P4 | DDR3/4_DQ2/LPDDR4_D10_A/LPDDR3_D4 |  |  |  |  |  |  | DDR | -- | A | -- | -- | -- | -- | -- | -- | -- | 0 | DDR3/4_DQ2/LPDDR4_D10_A/LPDDR3_D4 | B | DDR SDRAM data
N4 | DDR3/4_DQ3/LPDDR4_D11_A/LPDDR3_D0 |  |  |  |  |  |  | DDR | -- | A | -- | -- | -- | -- | -- | -- | -- | 0 | DDR3/4_DQ3/LPDDR4_D11_A/LPDDR3_D0 | B | DDR SDRAM data
J3 | DDR3/4_DQ4/LPDDR4_D12_A/LPDDR3_D3 |  |  |  |  |  |  | DDR | -- | A | -- | -- | -- | -- | -- | -- | -- | 0 | DDR3/4_DQ4/LPDDR4_D12_A/LPDDR3_D3 | B | DDR SDRAM data
K3 | DDR3/4_DQ5/LPDDR4_D13_A/LPDDR3_D7 |  |  |  |  |  |  | DDR | -- | A | -- | -- | -- | -- | -- | -- | -- | 0 | DDR3/4_DQ5/LPDDR4_D13_A/LPDDR3_D7 | B | DDR SDRAM data
M4 | DDR3/4_DQ6/LPDDR4_D14_A/LPDDR3_D5 |  |  |  |  |  |  | DDR | -- | A | -- | -- | -- | -- | -- | -- | -- | 0 | DDR3/4_DQ6/LPDDR4_D14_A/LPDDR3_D5 | B | DDR SDRAM data
P3 | DDR3/4_DQ7/LPDDR4_D15_A/LPDDR3_D1 |  |  |  |  |  |  | DDR | -- | A | -- | -- | -- | -- | -- | -- | -- | 0 | DDR3/4_DQ7/LPDDR4_D15_A/LPDDR3_D1 | B | DDR SDRAM data
D2 | DDR3/4_DQ8/LPDDR4_D0_B/LPDDR3_D10 |  |  |  |  |  |  | DDR | -- | A | -- | -- | -- | -- | -- | -- | -- | 0 | DDR3/4_DQ8/LPDDR4_D0_B/LPDDR3_D10 | B | DDR SDRAM data
D1 | DDR3/4_DQ9/LPDDR4_D1_B/LPDDR3_D11 |  |  |  |  |  |  | DDR | -- | A | -- | -- | -- | -- | -- | -- | -- | 0 | DDR3/4_DQ9/LPDDR4_D1_B/LPDDR3_D11 | B | DDR SDRAM data
H2 | DDR3/4_DQ10/LPDDR4_D2_B/LPDDR3_D8 |  |  |  |  |  |  | DDR | -- | A | -- | -- | -- | -- | -- | -- | -- | 0 | DDR3/4_DQ10/LPDDR4_D2_B/LPDDR3_D8 | B | DDR SDRAM data
H1 | DDR3/4_DQ11/LPDDR4_D3_B/LPDDR3_D9 |  |  |  |  |  |  | DDR | -- | A | -- | -- | -- | -- | -- | -- | -- | 0 | DDR3/4_DQ11/LPDDR4_D3_B/LPDDR3_D9 | B | DDR SDRAM data
G1 | DDR3/4_DQ12/LPDDR4_D4_B/LPDDR3_D12 |  |  |  |  |  |  | DDR | -- | A | -- | -- | -- | -- | -- | -- | -- | 0 | DDR3/4_DQ12/LPDDR4_D4_B/LPDDR3_D12 | B | DDR SDRAM data
E1 | DDR3/4_DQ13/LPDDR4_D5_B/LPDDR3_D13 |  |  |  |  |  |  | DDR | -- | A | -- | -- | -- | -- | -- | -- | -- | 0 | DDR3/4_DQ13/LPDDR4_D5_B/LPDDR3_D13 | B | DDR SDRAM data
C1 | DDR3/4_DQ14/LPDDR4_D6_B/LPDDR3_D14 |  |  |  |  |  |  | DDR | -- | A | -- | -- | -- | -- | -- | -- | -- | 0 | DDR3/4_DQ14/LPDDR4_D6_B/LPDDR3_D14 | B | DDR SDRAM data
C2 | DDR3/4_DQ15/LPDDR4_D7_B/LPDDR3_D15 |  |  |  |  |  |  | DDR | -- | A | -- | -- | -- | -- | -- | -- | -- | 0 | DDR3/4_DQ15/LPDDR4_D7_B/LPDDR3_D15 | B | DDR SDRAM data
K1 | DDR3/4_DQ16/LPDDR4_D0_A/LPDDR3_D19 |  |  |  |  |  |  | DDR | -- | A | -- | -- | -- | -- | -- | -- | -- | 0 | DDR3/4_DQ16/LPDDR4_D0_A/LPDDR3_D19 | B | DDR SDRAM data
K2 | DDR3/4_DQ17/LPDDR4_D1_A/LPDDR3_D18 |  |  |  |  |  |  | DDR | -- | A | -- | -- | -- | -- | -- | -- | -- | 0 | DDR3/4_DQ17/LPDDR4_D1_A/LPDDR3_D18 | B | DDR SDRAM data
J1 | DDR3/4_DQ18/LPDDR4_D2_A/LPDDR3_D23 |  |  |  |  |  |  | DDR | -- | A | -- | -- | -- | -- | -- | -- | -- | 0 | DDR3/4_DQ18/LPDDR4_D2_A/LPDDR3_D23 | B | DDR SDRAM data
J2 | DDR3/4_DQ19/LPDDR4_D3_A/LPDDR3_D22 |  |  |  |  |  |  | DDR | -- | A | -- | -- | -- | -- | -- | -- | -- | 0 | DDR3/4_DQ19/LPDDR4_D3_A/LPDDR3_D22 | B | DDR SDRAM data
P2 | DDR3/4_DQ20/LPDDR4_D4_A/LPDDR3_D21 |  |  |  |  |  |  | DDR | -- | A | -- | -- | -- | -- | -- | -- | -- | 0 | DDR3/4_DQ20/LPDDR4_D4_A/LPDDR3_D21 | B | DDR SDRAM data
L1 | DDR3/4_DQ21/LPDDR4_D5_A/LPDDR3_D16 |  |  |  |  |  |  | DDR | -- | A | -- | -- | -- | -- | -- | -- | -- | 0 | DDR3/4_DQ21/LPDDR4_D5_A/LPDDR3_D16 | B | DDR SDRAM data
M1 | DDR3/4_DQ22/LPDDR4_D6_A/LPDDR3_D17 |  |  |  |  |  |  | DDR | -- | A | -- | -- | -- | -- | -- | -- | -- | 0 | DDR3/4_DQ22/LPDDR4_D6_A/LPDDR3_D17 | B | DDR SDRAM data
P1 | DDR3/4_DQ23/LPDDR4_D7_A/LPDDR3_D20 |  |  |  |  |  |  | DDR | -- | A | -- | -- | -- | -- | -- | -- | -- | 0 | DDR3/4_DQ23/LPDDR4_D7_A/LPDDR3_D20 | B | DDR SDRAM data
A2 | DDR3/4_DQ24/LPDDR4_D8_B/LPDDR3_D30 |  |  |  |  |  |  | DDR | -- | A | -- | -- | -- | -- | -- | -- | -- | 0 | DDR3/4_DQ24/LPDDR4_D8_B/LPDDR3_D30 | B | DDR SDRAM data
A3 | DDR3/4_DQ25/LPDDR4_D9_B/LPDDR3_D31 |  |  |  |  |  |  | DDR | -- | A | -- | -- | -- | -- | -- | -- | -- | 0 | DDR3/4_DQ25/LPDDR4_D9_B/LPDDR3_D31 | B | DDR SDRAM data
G4 | DDR3/4_DQ26/LPDDR4_D10_B/LPDDR3_D28 |  |  |  |  |  |  | DDR | -- | A | -- | -- | -- | -- | -- | -- | -- | 0 | DDR3/4_DQ26/LPDDR4_D10_B/LPDDR3_D28 | B | DDR SDRAM data
F4 | DDR3/4_DQ27/LPDDR4_D11_B/LPDDR3_D29 |  |  |  |  |  |  | DDR | -- | A | -- | -- | -- | -- | -- | -- | -- | 0 | DDR3/4_DQ27/LPDDR4_D11_B/LPDDR3_D29 | B | DDR SDRAM data
H3 | DDR3/4_DQ28/LPDDR4_D12_B/LPDDR3_D24 |  |  |  |  |  |  | DDR | -- | A | -- | -- | -- | -- | -- | -- | -- | 0 | DDR3/4_DQ28/LPDDR4_D12_B/LPDDR3_D24 | B | DDR SDRAM data
G3 | DDR3/4_DQ29/LPDDR4_D13_B/LPDDR3_D25 |  |  |  |  |  |  | DDR | -- | A | -- | -- | -- | -- | -- | -- | -- | 0 | DDR3/4_DQ29/LPDDR4_D13_B/LPDDR3_D25 | B | DDR SDRAM data
B1 | DDR3/4_DQ30/LPDDR4_D14_B/LPDDR3_D26 |  |  |  |  |  |  | DDR | -- | A | -- | -- | -- | -- | -- | -- | -- | 0 | DDR3/4_DQ30/LPDDR4_D14_B/LPDDR3_D26 | B | DDR SDRAM data
B2 | DDR3/4_DQ31/LPDDR4_D15_B/LPDDR3_D27 |  |  |  |  |  |  | DDR | -- | A | -- | -- | -- | -- | -- | -- | -- | 0 | DDR3/4_DQ31/LPDDR4_D15_B/LPDDR3_D27 | B | DDR SDRAM data
N3 | DDR3/4_DM0/LPDDR4_DM1_A/LPDDR3_DM0 |  |  |  |  |  |  | DDR | -- | A | -- | -- | -- | -- | -- | -- | -- | 0 | DDR3/4_DM0/LPDDR4_DM1_A/LPDDR3_DM0 | O | data mask signal0 of the DDR3/4/LPDDR3, or data mask signal1 of the LPDDR4 channel A.
E2 | DDR3/4_DM1/LPDDR4_DM0_B/LPDDR3_DM1 |  |  |  |  |  |  | DDR | -- | A | -- | -- | -- | -- | -- | -- | -- | 0 | DDR3/4_DM1/LPDDR4_DM0_B/LPDDR3_DM1 | O | data mask signal1 of the DDR3/4/LPDDR3, or data mask signal0 of the LPDDR4 channel B.
M2 | DDR3/4_DM2/LPDDR4_DM0_A/LPDDR3_DM2 |  |  |  |  |  |  | DDR | -- | A | -- | -- | -- | -- | -- | -- | -- | 0 | DDR3/4_DM2/LPDDR4_DM0_A/LPDDR3_DM2 | O | data mask signal2 of the DDR3/4/LPDDR3, or data mask signal0 of the LPDDR4 channel A.
B3 | DDR3/4_DM3/LPDDR4_DM1_B/LPDDR3_DM3 |  |  |  |  |  |  | DDR | -- | A | -- | -- | -- | -- | -- | -- | -- | 0 | DDR3/4_DM3/LPDDR4_DM1_B/LPDDR3_DM3 | O | data mask signal3 of the DDR3/4/LPDDR3, or data mask signal1 of the LPDDR4 channel B.
L4 | DDR3/4_DQS0P/LPDDR4_DQS1P_A/LPDDR3_DQS0P |  |  |  |  |  |  | DDR | -- | A | -- | -- | -- | -- | -- | -- | -- | 0 | DDR3/4_DQS0P/LPDDR4_DQS1P_A/LPDDR3_DQS0P | I | positive pole of DQS signal0 of the DDR3/4/LPDDR3 SDRAM, corresponding to DDR3/4/LPDDR3 DDR_DQ0-DDR_DQ7. or the positive pole of DQS signa1 of the LPDDR4 channel A SDRAM,corresponding to LPDDR4 channel A DDR_DQ8-DDR_DQ15.
L3 | DDR3/4_DQS0N/LPDDR4_DQS1N_A/LPDDR3_DQS0N |  |  |  |  |  |  | DDR | -- | A | -- | -- | -- | -- | -- | -- | -- | 0 | DDR3/4_DQS0N/LPDDR4_DQS1N_A/LPDDR3_DQS0N | I | negative pole of DQS signal0 of the DDR3/4/LPDDR3 SDRAM,corresponding to DDR3/4/LPDDR3 DDR_DQ0-DDR_DQ7. or the negative pole of DQS signa1 of the LPDDR4 channel A SDRAM,corresponding to LPDDR4 channel A DDR_DQ8-DDR_DQ15.
F2 | DDR3/4_DQS1P/LPDDR4_DQS0P_B/LPDDR3_DQS1P |  |  |  |  |  |  | DDR | -- | A | -- | -- | -- | -- | -- | -- | -- | 0 | DDR3/4_DQS1P/LPDDR4_DQS0P_B/LPDDR3_DQS1P | I | positive pole of DQS signal1 of the DDR3/4/LPDDR3 SDRAM, corresponding to DDR3/4/LPDDR3 DDR_DQ8-DDR_DQ15. or the positive pole of DQS signa0 of the LPDDR4 channel B SDRAM,corresponding to LPDDR4 channel B DDR_DQ0-DDR_DQ7.
F1 | DDR3/4_DQS1N/LPDDR4_DQS0N_B/LPDDR3_DQS1N |  |  |  |  |  |  | DDR | -- | A | -- | -- | -- | -- | -- | -- | -- | 0 | DDR3/4_DQS1N/LPDDR4_DQS0N_B/LPDDR3_DQS1N | I | negative pole of DQS signal1 of the DDR3/4/LPDDR3 SDRAM, corresponding to DDR3/4/LPDDR3 DDR_DQ8-DDR_DQ15. or the negative pole of DQS signa0 of the LPDDR4 channel B SDRAM,corresponding to LPDDR4 channel B DDR_DQ0-DDR_DQ7.
N2 | DDR3/4_DQS2P/LPDDR4_DQS0P_A/LPDDR3_DQS2P |  |  |  |  |  |  | DDR | -- | A | -- | -- | -- | -- | -- | -- | -- | 0 | DDR3/4_DQS2P/LPDDR4_DQS0P_A/LPDDR3_DQS2P | I | positive pole of DQS signal2 of the DDR3/4/LPDDR3 SDRAM,corresponding to DDR3/4/LPDDR3 DDR_DQ16-DDR_DQ23. or the positive pole of DQS signa0 of the LPDDR4 channel A SDRAM,corresponding to LPDDR4 channel A DDR_DQ0-DDR_DQ7.
N1 | DDR3/4_DQS2N/LPDDR4_DQS0N_A/LPDDR3_DQS2N |  |  |  |  |  |  | DDR | -- | A | -- | -- | -- | -- | -- | -- | -- | 0 | DDR3/4_DQS2N/LPDDR4_DQS0N_A/LPDDR3_DQS2N | I | negative pole of DQS signal2 of the DDR3/4/LPDDR3 SDRAM,corresponding to DDR3/4/LPDDR3 DDR_DQ16-DDR_DQ23. or the negative pole of DQS signa0 of the LPDDR4 channel A SDRAM,corresponding to LPDDR4 channel A DDR_DQ0-DDR_DQ7.
D3 | DDR3/4_DQS3P/LPDDR4_DQS1P_B/LPDDR3_DQS3P |  |  |  |  |  |  | DDR | -- | A | -- | -- | -- | -- | -- | -- | -- | 0 | DDR3/4_DQS3P/LPDDR4_DQS1P_B/LPDDR3_DQS3P | I | positive pole of DQS signal3 of the DDR3/4/LPDDR3 SDRAM,corresponding to DDR3/4/LPDDR3 DDR_DQ24-DDR_DQ31. or the positive pole of DQS signa1 of the LPDDR4 channel B SDRAM,corresponding to LPDDR4 channel B DDR_DQ8-DDR_DQ15.
E3 | DDR3/4_DQS3N/LPDDR4_DQS1N_B/LPDDR3_DQS3N |  |  |  |  |  |  | DDR | -- | A | -- | -- | -- | -- | -- | -- | -- | 0 | DDR3/4_DQS3N/LPDDR4_DQS1N_B/LPDDR3_DQS3N | I | negative pole of DQS signal3 of the DDR3/4/LPDDR3 SDRAM, corresponding to DDR3/4/LPDDR3 DDR_DQ24-DDR_DQ31. or the negative pole of DQS signa1 of the LPDDR4 channel B SDRAM,corresponding to LPDDR4 channel B DDR_DQ8-DDR_DQ15.
C9 | DDR3_A3/LPDDR4_CKE1_A/LPDDR3_A3/DDR4_A0 |  |  |  |  |  |  | DDR | -- | A | -- | -- | -- | -- | -- | -- | -- | 0 | DDR3_A3/LPDDR4_CKE1_A/LPDDR3_A3/DDR4_A0 | O | DDR3/4/LPDDR3 SDRAM address. or clock enable signal1 of LPDDR4 channel A.
B7 | DDR3_BA1/LPDDR4_CKE0_B/DDR4_A1 |  |  |  |  |  |  | DDR | -- | A | -- | -- | -- | -- | -- | -- | -- | 0 | DDR3_BA1/LPDDR4_CKE0_B/DDR4_A1 | O | SDRAM addres of DDR4. or bank address signal1 of DDR3. or clock enable signal0 of LPDDR4 channel B .
B11 | DDR3_A9/LPDDR4_A4_A/LPDDR3_A9/DDR4_A2 |  |  |  |  |  |  | DDR | -- | A | -- | -- | -- | -- | -- | -- | -- | 0 | DDR3_A9/LPDDR4_A4_A/LPDDR3_A9/DDR4_A2 | O | SDRAM addres of DDR3/4 and LPDDR3/LPDDR4 channel A.
B6 | DDR3_A15/LPDDR4_A5_B/DDR4_A3 |  |  |  |  |  |  | DDR | -- | A | -- | -- | -- | -- | -- | -- | -- | 0 | DDR3_A15/LPDDR4_A5_B/DDR4_A3 | O | SDRAM addres of DDR3/4 and LPDDR4 channel B.
A9 | DDR3_A6/LPDDR4_CLKP_A/LPDDR3_A6/DDR4_A4 |  |  |  |  |  |  | DDR | -- | A | -- | -- | -- | -- | -- | -- | -- | 0 | DDR3_A6/LPDDR4_CLKP_A/LPDDR3_A6/DDR4_A4 | O | SDRAM addres of DDR3/4 and LPDDR3. or positive pole of differential clock of LPDDR4 channel A.
A7 | DDR3_A12/LPDDR4_ODT0_B/DDR4_A5 |  |  |  |  |  |  | DDR | -- | A | -- | -- | -- | -- | -- | -- | -- | 0 | DDR3_A12/LPDDR4_ODT0_B/DDR4_A5 | O | SDRAM addres of DDR3/4 . or terminal matched resistor 0 of LPDDR4 channel B.
C8 | DDR3_BA2/LPDDR4_A0_A/DDR4_A6 |  |  |  |  |  |  | DDR | -- | A | -- | -- | -- | -- | -- | -- | -- | 0 | DDR3_BA2/LPDDR4_A0_A/DDR4_A6 | O | SDRAM addres of DDR4/LPDDR4 channel A. or bank address signal2 of DDR3.
B8 | DDR3_A4/LPDDR4_ODT0_A/LPDDR3_A4/DDR4_A7 |  |  |  |  |  |  | DDR | -- | A | -- | -- | -- | -- | -- | -- | -- | 0 | DDR3_A4/LPDDR4_ODT0_A/LPDDR3_A4/DDR4_A7 | O | SDRAM addres of DDR3/4 and LPDDR3. or terminal matched resistor 0 of LPDDR4 channel A.
A8 | DDR3_A1/LPDDR4_CKE0_A/LPDDR3_A1/DDR4_A8 |  |  |  |  |  |  | DDR | -- | A | -- | -- | -- | -- | -- | -- | -- | 0 | DDR3_A1/LPDDR4_CKE0_A/LPDDR3_A1/DDR4_A8 | O | SDRAM addres of DDR3/4 and LPDDR3. or clock enable signal 0 of LPDDR4 channel A.
B9 | DDR3_A5/LPDDR4_A5_A/LPDDR3_A5/DDR4_A9 |  |  |  |  |  |  | DDR | -- | A | -- | -- | -- | -- | -- | -- | -- | 0 | DDR3_A5/LPDDR4_A5_A/LPDDR3_A5/DDR4_A9 | O | SDRAM addres of DDR3/DDR4/LPDDR3/LPDDR4 channel A.
A10 | DDR3_A8/LPDDR4_CLKN_A/LPDDR3_A8/DDR4_A10 |  |  |  |  |  |  | DDR | -- | A | -- | -- | -- | -- | -- | -- | -- | 0 | DDR3_A8/LPDDR4_CLKN_A/LPDDR3_A8/DDR4_A10 | O | SDRAM addres of DDR3/DDR4/LPDDR3. or negative pole of differential clock of LPDDR4 channel A.
C11 | DDR3_A7/LPDDR4_A2_A/LPDDR3_A7/DDR4_A11 |  |  |  |  |  |  | DDR | -- | A | -- | -- | -- | -- | -- | -- | -- | 0 | DDR3_A7/LPDDR4_A2_A/LPDDR3_A7/DDR4_A11 | O | SDRAM addres of DDR3/DDR4/LPDDR3/LPDDR4 channel A.
D7 | DDR3_RASn/LPDDR4_A1_A/DDR4_A12 |  |  |  |  |  |  | DDR | -- | A | -- | -- | -- | -- | -- | -- | -- | 0 | DDR3_RASn/LPDDR4_A1_A/DDR4_A12 | O | SDRAM addres of DDR4/LPDDR4 channel A. or row address select signal of the DDR3.
A12 | DDR3_A13/LPDDR4_A3_A/DDR4_A13 |  |  |  |  |  |  | DDR | -- | A | -- | -- | -- | -- | -- | -- | -- | 0 | DDR3_A13/LPDDR4_A3_A/DDR4_A13 | O | SDRAM addres of DDR3/DDR4/LPDDR4 channel A
A11 | DDR3_A14/LPDDR4_CS1n_B/DDR4_A14_Wen |  |  |  |  |  |  | DDR | -- | A | -- | -- | -- | -- | -- | -- | -- | 0 | DDR3_A14/LPDDR4_CS1n_B/DDR4_A14_Wen | O | SDRAM addres of DDR3/DDR4. or CS signal1 of the LPDDR4 channel B.
B5 | DDR3_A10/LPDDR4_A0_B/DDR4_A15_CASn |  |  |  |  |  |  | DDR | -- | A | -- | -- | -- | -- | -- | -- | -- | 0 | DDR3_A10/LPDDR4_A0_B/DDR4_A15_CASn | O | SDRAM addres of DDR3/DDR4/LPDDR4 channel B.
B10 | DDR3_A11/LPDDR4_CS0n_B/DDR4_A16_RASn |  |  |  |  |  |  | DDR | -- | A | -- | -- | -- | -- | -- | -- | -- | 0 | DDR3_A11/LPDDR4_CS0n_B/DDR4_A16_RASn | O | SDRAM addres of DDR3/DDR4. or CS signal0 of the LPDDR4 channel B.
D4 | DDR3_CLKP/LPDDR4_CLKP_B/LPDDR3_CLKP/DDR4_CLKP |  |  |  |  |  |  | DDR | -- | A | -- | -- | -- | -- | -- | -- | -- | 0 | DDR3_CLKP/LPDDR4_CLKP_B/LPDDR3_CLKP/DDR4_CLKP | O | positive pole of differential clock of DDR3/DDR4/LPDDR3/LPDDR4 channel B.
D5 | DDR3_CLKN/LPDDR4_CLKN_B/LPDDR3_CLKN/DDR4_CLKN |  |  |  |  |  |  | DDR | -- | A | -- | -- | -- | -- | -- | -- | -- | 0 | DDR3_CLKN/LPDDR4_CLKN_B/LPDDR3_CLKN/DDR4_CLKN | O | nagative pole of differential clock of DDR3/DDR4/LPDDR3/LPDDR4 channel B.
D6 | DDR3_ODT1/LPDDR4_CS1n_A/LPDDR3_ODT1/DDR4_BG0 |  |  |  |  |  |  | DDR | -- | A | -- | -- | -- | -- | -- | -- | -- | 0 | DDR3_ODT1/LPDDR4_CS1n_A/LPDDR3_ODT1/DDR4_BG0 | O | terminal matched resistor 1 of DDR3/LPDDR3. or bank group0 of DDR4. or CS signal1 of LPDDR4 channel A.
D11 | DDR3_A2/LPDDR4_ODT1_A/LPDDR3_A2/DDR4_BG1 |  |  |  |  |  |  | DDR | -- | A | -- | -- | -- | -- | -- | -- | -- | 0 | DDR3_A2/LPDDR4_ODT1_A/LPDDR3_A2/DDR4_BG1 | O | SDRAM addres of DDR3/LPDDR3. or bank group1 of DDR4. or terminal matched resistor 1 of LPDDR4 channel A.
E7 | DDR3_CS1n/LPDDR4_CS0n_A/LPDDR3_CS1n/DDR4_BA0 |  |  |  |  |  |  | DDR | -- | A | -- | -- | -- | -- | -- | -- | -- | 0 | DDR3_CS1n/LPDDR4_CS0n_A/LPDDR3_CS1n/DDR4_BA0 | O | CS signal of DDR3/LPDDR3/LPDDR4 channel A. or bank address0 of DDR4.
A6 | DDR3_Wen/LPDDR4_CKE1_B/DDR4_BA1 |  |  |  |  |  |  | DDR | -- | A | -- | -- | -- | -- | -- | -- | -- | 0 | DDR3_Wen/LPDDR4_CKE1_B/DDR4_BA1 | O | DDR3 write enable. or clock enable signal of LPDDR4 channel B. or bank address1 of DDR4.
B4 | DDR3_ODT0/LPDDR4_A2_B/LPDDR3_ODT0/DDR4_CS0n |  |  |  |  |  |  | DDR | -- | A | -- | -- | -- | -- | -- | -- | -- | 0 | DDR3_ODT0/LPDDR4_A2_B/LPDDR3_ODT0/DDR4_CS0n | O | terminal matched resistor 0 of DDR3/LPDDR3. CS signal0 of DDR4,. or SDRAM address of LPDDR4 channel B.
D8 | DDR3_BA0/DDR4_CS1n |  |  |  |  |  |  | DDR | -- | A | -- | -- | -- | -- | -- | -- | -- | 0 | DDR3_BA0/DDR4_CS1n | O | bank address0 of DDR3. or CS signal1 of DDR4
A5 | DDR3_CS0n/LPDDR4_A4_B/LPDDR3_CS0n/DDR4_ODT0 |  |  |  |  |  |  | DDR | -- | A | -- | -- | -- | -- | -- | -- | -- | 0 | DDR3_CS0n/LPDDR4_A4_B/LPDDR3_CS0n/DDR4_ODT0 | O | CS signal0 of DDR3/LPDDR3. or terminal matched resistor 0 of DDR4. or SDRAM address of LPDDR4 channel B .
D10 | DDR3_A0/LPDDR4_ODT1_B/LPDDR3_A0/DDR4_ODT1 |  |  |  |  |  |  | DDR | -- | A | -- | -- | -- | -- | -- | -- | -- | 0 | DDR3_A0/LPDDR4_ODT1_B/LPDDR3_A0/DDR4_ODT1 | O | SDRAM address of DDR3/LPDDR3. or terminal matched resistor 1 of DDR4/LPDDR4 channel B.
C6 | DDR3_CASn/LPDDR4_A1_B/DDR4_CKE |  |  |  |  |  |  | DDR | -- | A | -- | -- | -- | -- | -- | -- | -- | 0 | DDR3_CASn/LPDDR4_A1_B/DDR4_CKE | O | Column address select signal of DDR3. or clock enable signal of DDR4. or SDRAM address of LPDDR4 channel B.
A4 | DDR3_CKE/LPDDR4_A3_B/LPDDR3_CKE/DDR4_ACTn |  |  |  |  |  |  | DDR | -- | A | -- | -- | -- | -- | -- | -- | -- | 0 | DDR3_CKE/LPDDR4_A3_B/LPDDR3_CKE/DDR4_ACTn | O | clock enable signal of DDR3/LPDDR3. or activation command being entered along with CSn of DDR4. SDRAM address of LPDDR4 channel B.
C4 | DDR_RESETn |  |  |  |  |  |  | DDR | -- | A | -- | -- | -- | -- | -- | -- | -- | 0 | DDR_RESETn | O | DDR SDRAM reset pin
E5 | DDR_RZQ |  |  |  |  |  |  | DDR | -- | A | -- | -- | -- | -- | -- | -- | -- | 0 | DDR_RZQ | I | ZQ calibration pin of the DDR SDRAM
F6 | DDR_AVSS |  |  |  |  |  |  | DDR | -- | A | -- | -- | -- | -- | -- | -- | -- | 0 | DDR_AVSS | -- | DDR analog GND
M6 | DDR_VREF |  |  |  |  |  |  | DDR | -- | PO | -- | -- | -- | -- | -- | -- | -- | 0 | DDR_VREF | O | DDR VREF Power output
G7 | DDR_VDD_1 |  |  |  |  |  |  | DDR | 1.5V forDDR3 1.2V forDDR4/LPDDR3 1.1V for LPDDR4 | PI | -- | -- | -- | -- | -- | -- | -- | 0 | DDR_VDD_1 | -- | DDR IO supply
G8 | DDR_VDD_2 |  |  |  |  |  |  | DDR |  | PI | -- | -- | -- | -- | -- | -- | -- | 0 | DDR_VDD_2 | -- | DDR IO supply
G9 | DDR_VDD_3 |  |  |  |  |  |  | DDR |  | PI | -- | -- | -- | -- | -- | -- | -- | 0 | DDR_VDD_3 | -- | DDR IO supply
H8 | DDR_VDD_4 |  |  |  |  |  |  | DDR |  | PI | -- | -- | -- | -- | -- | -- | -- | 0 | DDR_VDD_4 | -- | DDR IO supply
J7 | DDR_VDD_5 |  |  |  |  |  |  | DDR |  | PI | -- | -- | -- | -- | -- | -- | -- | 0 | DDR_VDD_5 | -- | DDR IO supply
K7 | DDR_VDD_6 |  |  |  |  |  |  | DDR |  | PI | -- | -- | -- | -- | -- | -- | -- | 0 | DDR_VDD_6 | -- | DDR IO supply
L7 | DDR_VDD_7 |  |  |  |  |  |  | DDR |  | PI | -- | -- | -- | -- | -- | -- | -- | 0 | DDR_VDD_7 | -- | DDR IO supply
NPU/LOGIC/ARM/VEPU/VCCIO_VDD_1V8 | 20balls |  |  |  |  |  |  | Power Supply | Supply Voltage | Pin Type | Schmitt Trigger | Interruptable | Driver strength control register | PU/PD control register | Input enable control register | Schmitt trigger control register | IOMUX control register | function Number | Signal Name | Direction | Description
H11 | NPU_VDD_1 |  |  |  |  |  |  | NPU | 0.8V | PI | -- | -- | -- | -- | -- | -- | -- | 0 | NPU_VDD_1 | -- | NPU Power
H12 | NPU_VDD_2 |  |  |  |  |  |  | NPU | 0.8V | PI | -- | -- | -- | -- | -- | -- | -- | 0 | NPU_VDD_2 | -- | NPU Power
J10 | NPU_VDD_3 |  |  |  |  |  |  | NPU | 0.8V | PI | -- | -- | -- | -- | -- | -- | -- | 0 | NPU_VDD_3 | -- | NPU Power
J11 | NPU_VDD_4 |  |  |  |  |  |  | NPU | 0.8V | PI | -- | -- | -- | -- | -- | -- | -- | 0 | NPU_VDD_4 | -- | NPU Power
K10 | NPU_VDD_5 |  |  |  |  |  |  | NPU | 0.8V | PI | -- | -- | -- | -- | -- | -- | -- | 0 | NPU_VDD_5 | -- | NPU Power
K11 | NPU_VDD_6 |  |  |  |  |  |  | NPU | 0.8V | PI | -- | -- | -- | -- | -- | -- | -- | 0 | NPU_VDD_6 | -- | NPU Power
H9 | LOGIC_VDD_1 |  |  |  |  |  |  | LOGIC | 0.8V | PI | -- | -- | -- | -- | -- | -- | -- | 0 | LOGIC_VDD_1 | -- | Logic Power
J9 | LOGIC_VDD_2 |  |  |  |  |  |  | LOGIC | 0.8V | PI | -- | -- | -- | -- | -- | -- | -- | 0 | LOGIC_VDD_2 | -- | Logic Power
L10 | LOGIC_VDD_3 |  |  |  |  |  |  | LOGIC | 0.8V | PI | -- | -- | -- | -- | -- | -- | -- | 0 | LOGIC_VDD_3 | -- | Logic Power
M11 | LOGIC_VDD_4 |  |  |  |  |  |  | LOGIC | 0.8V | PI | -- | -- | -- | -- | -- | -- | -- | 0 | LOGIC_VDD_4 | -- | Logic Power
H13 | LOGIC_VDD_5 |  |  |  |  |  |  | LOGIC | 0.8V | PI | -- | -- | -- | -- | -- | -- | -- | 0 | LOGIC_VDD_5 | -- | Logic Power
J13 | LOGIC_VDD_6 |  |  |  |  |  |  | LOGIC | 0.8V | PI | -- | -- | -- | -- | -- | -- | -- | 0 | LOGIC_VDD_6 | -- | Logic Power
L9 | VEPU_VDD_1 |  |  |  |  |  |  | VEPU | 0.8V | PI | -- | -- | -- | -- | -- | -- | -- | 0 | VEPU_VDD_1 | -- | VEPU Power
M9 | VEPU_VDD_2 |  |  |  |  |  |  | VEPU | 0.8V | PI | -- | -- | -- | -- | -- | -- | -- | 0 | VEPU_VDD_2 | -- | VEPU Power
N8 | VEPU_VDD_3 |  |  |  |  |  |  | VEPU | 0.8V | PI | -- | -- | -- | -- | -- | -- | -- | 0 | VEPU_VDD_3 | -- | VEPU Power
N9 | VEPU_VDD_4 |  |  |  |  |  |  | VEPU | 0.8V | PI | -- | -- | -- | -- | -- | -- | -- | 0 | VEPU_VDD_4 | -- | VEPU Power
N12 | ARM_VDD_1 |  |  |  |  |  |  | ARM | 0.8V | PI | -- | -- | -- | -- | -- | -- | -- | 0 | ARM_VDD_1 | -- | ARM Power
P12 | ARM_VDD_2 |  |  |  |  |  |  | ARM | 0.8V | PI | -- | -- | -- | -- | -- | -- | -- | 0 | ARM_VDD_2 | -- | ARM Power
P13 | ARM_VDD_3 |  |  |  |  |  |  | ARM | 0.8V | PI | -- | -- | -- | -- | -- | -- | -- | 0 | ARM_VDD_3 | -- | ARM Power
H14 | VCCIO_VDD_1V8 |  |  |  |  |  |  | VCCIO1~7 | 1.8V | PI | -- | -- | -- | -- | -- | -- | -- | 0 | VCCIO_VDD_1V8 | -- | VCCIO1/2/3/4/5/6/7 VDD Power
VSS/AVSS | 103balls |  |  |  |  |  |  | Power Supply | Supply Voltage | Pin Type | Schmitt Trigger | Interruptable | Driver strength control register | PU/PD control register | Input enable control register | Schmitt trigger control register | IOMUX control register | function Number | Signal Name | Direction | Description
A1 | VSS_1 |  |  |  |  |  |  | -- | -- | G | -- | -- | -- | -- | -- | -- | -- | 0 | VSS_1 | -- | Digital GND
A21 | AVSS_2 |  |  |  |  |  |  | -- | -- | AG | -- | -- | -- | -- | -- | -- | -- | 0 | AVSS_2 | -- | MIPI DSI Analog GND
B12 | VSS_3 |  |  |  |  |  |  | -- | -- | G | -- | -- | -- | -- | -- | -- | -- | 0 | VSS_3 | -- | Digital GND
C3 | VSS_4 |  |  |  |  |  |  | -- | -- | G | -- | -- | -- | -- | -- | -- | -- | 0 | VSS_4 | -- | Digital GND
C5 | VSS_5 |  |  |  |  |  |  | -- | -- | G | -- | -- | -- | -- | -- | -- | -- | 0 | VSS_5 | -- | Digital GND
C7 | VSS_6 |  |  |  |  |  |  | -- | -- | G | -- | -- | -- | -- | -- | -- | -- | 0 | VSS_6 | -- | Digital GND
C10 | VSS_7 |  |  |  |  |  |  | -- | -- | G | -- | -- | -- | -- | -- | -- | -- | 0 | VSS_7 | -- | Digital GND
C12 | VSS_8 |  |  |  |  |  |  | -- | -- | G | -- | -- | -- | -- | -- | -- | -- | 0 | VSS_8 | -- | Digital GND
D9 | VSS_9 |  |  |  |  |  |  | -- | -- | G | -- | -- | -- | -- | -- | -- | -- | 0 | VSS_9 | -- | Digital GND
D12 | VSS_10 |  |  |  |  |  |  | -- | -- | G | -- | -- | -- | -- | -- | -- | -- | 0 | VSS_10 | -- | Digital GND
D18 | AVSS_11 |  |  |  |  |  |  | -- | -- | AG | -- | -- | -- | -- | -- | -- | -- | 0 | AVSS_11 | -- | MIPI DSI Analog GND
E4 | VSS_12 |  |  |  |  |  |  | -- | -- | G | -- | -- | -- | -- | -- | -- | -- | 0 | VSS_12 | -- | Digital GND
E6 | VSS_13 |  |  |  |  |  |  | -- | -- | G | -- | -- | -- | -- | -- | -- | -- | 0 | VSS_13 | -- | Digital GND
E8 | VSS_14 |  |  |  |  |  |  | -- | -- | G | -- | -- | -- | -- | -- | -- | -- | 0 | VSS_14 | -- | Digital GND
E9 | VSS_15 |  |  |  |  |  |  | -- | -- | G | -- | -- | -- | -- | -- | -- | -- | 0 | VSS_15 | -- | Digital GND
E10 | VSS_16 |  |  |  |  |  |  | -- | -- | G | -- | -- | -- | -- | -- | -- | -- | 0 | VSS_16 | -- | Digital GND
E11 | VSS_17 |  |  |  |  |  |  | -- | -- | G | -- | -- | -- | -- | -- | -- | -- | 0 | VSS_17 | -- | Digital GND
E12 | VSS_18 |  |  |  |  |  |  | -- | -- | G | -- | -- | -- | -- | -- | -- | -- | 0 | VSS_18 | -- | Digital GND
F3 | VSS_19 |  |  |  |  |  |  | -- | -- | G | -- | -- | -- | -- | -- | -- | -- | 0 | VSS_19 | -- | Digital GND
F5 | VSS_20 |  |  |  |  |  |  | -- | -- | G | -- | -- | -- | -- | -- | -- | -- | 0 | VSS_20 | -- | Digital GND
F7 | VSS_21 |  |  |  |  |  |  | -- | -- | G | -- | -- | -- | -- | -- | -- | -- | 0 | VSS_21 | -- | Digital GND
F8 | VSS_22 |  |  |  |  |  |  | -- | -- | G | -- | -- | -- | -- | -- | -- | -- | 0 | VSS_22 | -- | Digital GND
F9 | VSS_23 |  |  |  |  |  |  | -- | -- | G | -- | -- | -- | -- | -- | -- | -- | 0 | VSS_23 | -- | Digital GND
F10 | VSS_24 |  |  |  |  |  |  | -- | -- | G | -- | -- | -- | -- | -- | -- | -- | 0 | VSS_24 | -- | Digital GND
F11 | VSS_25 |  |  |  |  |  |  | -- | -- | G | -- | -- | -- | -- | -- | -- | -- | 0 | VSS_25 | -- | Digital GND
F12 | VSS_26 |  |  |  |  |  |  | -- | -- | G | -- | -- | -- | -- | -- | -- | -- | 0 | VSS_26 | -- | Digital GND
F13 | VSS_27 |  |  |  |  |  |  | -- | -- | G | -- | -- | -- | -- | -- | -- | -- | 0 | VSS_27 | -- | Digital GND
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
