cnchens/RV1126_RV1109_Hardware_Design_Template/01_Common Document/RV1126_RV1109_DDR3_LPDDR3_Power consumption_V1.2_20201207.xlsx

Sheet: Report cover
Project Name |  | RV1126/RV1109 Platform
Test Purpose |  | IPC/ Smart Bell Power consumption
Tester |  | Rockchip
Configuration | ITEM | CPU Model | CPU frequency | Memory | NPU Frequency | VEPU | DDR Type | DDR Frequency | Bat voltage (V)
 | RV1109 | Dual-core CorteX-A7 (14nm) | Max to 1500MHz | 4GB | 1.2Tops | Max to 700MHz | DDR3/DDR3L/DDR4/LP3/LP4 | Max to 1056MHz
 | RV1126 | Quad-core CorteX-A7 (14nm) | Max to 1500MHz | 4GB | 2.0Tops | Max to 700MHz | DDR3/DDR3L/DDR4/LP3/LP4 | Max to 1056MHz
Change History
Version |  | Date |  | Handled By |  |  | Comments
1.0 |  | 2020-07-21 |  | Rockchip
1.1 |  | 2020-11-02 |  | Rockchip
1.2 |  | 2020-12-07 |  | Rockchip |  |  | update: 1. Add the power consumption of 4K IPC NN on and NN off 2. Add peak value of transient current of LOGIC/ARM/NPU/VEPU

Sheet: Statement
保密提示： 本文档及其附件可能含有机密信息，来自瑞芯微电子股份有限公司，仅发送给指定接收者。若非该特定接收人，请勿复制、 使用或披露本文档的任何内容。若误收本文档，请从系统中永久性删除本文档，并以回复邮件或其他方式即刻告知发件人。瑞芯微电子股份有限公司拥有本文档信息的著作权及解释权，禁止任何未经授权许可的侵权行为。 IMPORTANT NOTICE: This document is from Rockchip Electronics Co., Ltd. .The contents of this document and any attachments may contain information that is privileged, confidential and/or exempt from disclosure under applicable law and relevant NDA. If you are not the intended recipient, you are hereby notified that any disclosure, copying, distribution, or use of the information is STRICTLY PROHIBITED. Please immediately contact the sender as soon as possible and destroy the material in its entirety in any format. Thank you.

Sheet: Peak value of transient current
Peak value of transient current of RV1126/RV1109 EVB
Condition |  | VDD_ARM
VDD_ARM | Frequence1.8G ,Test CMD: dhrystone 200000000 &input 4 times linux_repository/RV1109/BringUp/RV1126_DVFS/dvfs_auto | Voltage(V) | AVG I (mA) | MAX I(mA)
 |  | 1.10 | 722.90 | 726.90
VDD_LOGIC | Linux_Repository\RV1109\03_IMAGES\vicap\RV1126-EVB-DDR3-V12_20201130.1800_RELEASE_TEST-VICAP-NORMAL-30FPS VICAP solution V12 EVB + IMX415 VICAP + ISP + ISPP, Normal, TNR 2to1，Raw10bit Freq: ISP 600MHz， ISPP 500MHz， DDR 1056MHz ，VEPU600MHz ISP output 30fps； Main stream 30fps, sub stream 30fps, triple stream 30fps Bit stream resolution: 4K (fbc0) + 1080p + 480p Bandwidth:5698.66MB/s (67.45%) Power consumption without Ethernet NPU:800M+4k encode+vop display +EN HDR2 | VDD_LOGIC
 |  | Voltage(V) | AVG I (mA) | MAX I(mA)
 |  | 0.838 | 1133.5 | 1681.1
VDD_VEPU | linux_repository/RV1109/BringUp/RV1126_DVFS/vepu satd_byps_disable（700M） | VDD_VEPU
 |  | Voltage(V) | AVG I (mA) | MAX I(mA)
 |  | 0.822 | 442 | 771.1
VDD_NPU | linux_repository/RV1109/BringUp/RV1126_DVFS/dvfs_auto 934MHz | VDD_VEPU
 |  | Voltage(V) | AVG I (mA) | MAX I(mA)
 |  | 0.913 | 994.6 | 1340.8

Sheet: EVB Standby Consumption
Standby Power consumption of RV1126/RV1109 EVB
Notice: These data is test on EVB board.Do not represent the final product power consumption value. If there is a big improvement, we will update.
Board |  | RV1126/RV1109_EVB_LP3S178P132SD6_V11_20200529
Condition |  | ,VDD_NPU_VEPU,VDD_ARM,VCC_0V8,VCC_1V8 and VCC_3V3 are off. VCC3V3_SYS，VCC0V8_PMU, VCC1V8_PMU, VCC_DDR，VDD_LOGIC, and VCC_RTC are on.
Total Power consumption VCC5V0_SYS |  | VCC3V3_SYS |  | VCC_DDR |  | VCC0V8_PMU |  | VCC1V8_PMU |  | VCC_RTC |  | VDD_LOGIC
Voltage(V) | AVG I (mA) | Voltage(V) | AVG I (mA) | Voltage(V) | AVG I (mA) | Voltage(V) | AVG I (mA) | Voltage(V) | AVG I (mA) | Voltage(V) | AVG I (mA) | Voltage(V) | AVG I (mA)
5.24 | 4.3 | 3.3 | 0.1 | 1.2 | 3.7 | 0.8 | 0.1 | 1.8 | 1.6 | 5.24 | 1.8 | 0.8 | 1.9
Board |  | RV1126/RV1109_EVB_DDR3P216SD6_V12_20200515
Condition |  | VDD_NPU_VEPU,VDD_ARM,VCC_0V8,VCC_1V8 and VCC_3V3 are off. VDD_LOGIC, VCC_DDR,VCC3V3_SYS，VCC0V8_PMU, VCC1V8_PMU, and VCC_RTC are on.
Total Power consumption VCC5V0_SYS |  | VCC3V3_SYS |  | VCC_DDR |  | VCC0V8_PMU |  | VCC1V8_PMU |  | VCC_RTC |  | VDD_LOGIC
Voltage(V) | AVG I (mA) | Voltage(V) | AVG I (mA) | Voltage(V) | AVG I (mA) | Voltage(V) | AVG I (mA) | Voltage(V) | AVG I (mA) | Voltage(V) | AVG I (mA) | Voltage(V) | AVG I (mA)
5.24 | 8 | 3.3 | 0.3 | 1.53 | 14.3 | 0.8 | 0.1 | 1.8 | 0.1 | 5.24 | 1.8 | 0.8 | 2.7

Sheet: IPC 2K LP3 EVB V1.0
Power consumption of RV1126/RV1109 Battery IPC_Smart bell solution
Notice: These data is test on EVB board.Do not represent the final product power consumption value. If there is a big improvement, we will update.
Board | RV1126/RV1109_EVB_LP3S178P132SD6_V10_20191227LXF + os04a10 camera + NO LCD
Condition | RV1109\03_IMAGES\RV1109-EVB-LP3-V10_20200717.1216_RELEASE_TEST\IMAGES Function： 1. ISP: 2688X1520@30FPS RAW10bit 2F HDR + TNR(2to1) + YNR&UVNR(ON) + DEHAZE（OFF） ISPP: MP(FBC) : 2688X1520@30FPS YUV420 Scale0: 1280x720@30fps YUV420 Scale1: 640x480 YUV420 Scale2: OFF 2. Encode：H265 Encode（H265 2688X1520@30fps 8Mbps + H265 1920x1080@30fps 2Mbps） 3. NPU:720p Camera input run SSD-inceptionv2 model 4. DDR: :924M 5. Close other devices（wifi/bt/lcd/tp/gmac） 6. FREQ：CPU:408MHz~1.5GHz/DDR:924MHz/NPU:600MHz/ISP:500MHz/ISPP:396MHz/VENC:396MHz To ensure the consistency of power consumption test, the camera should be covered. Tool PowerMe test：Power consumption within 10 minutes after application stabilization Environment Temperature: 25℃
DATE | 2020.07.17
2K camera，NN OFF，NPU(OFF)/VEPU396MHz/DEHAZE（OFF）/DDR BW 3100±50 MBps
Environment temperature | Chip temperature | SOC total Power consumption | VDD_LOGIC |  | VDD_ARM |  | VDD_VEPU |  | VDD_NPU |  | VCC_DDR（DDRPHY） |  | VCC3V3_SYS |  | VCC_0V8 |  | VCC0V8_PMU |  | VCC1V8_PMU |  | VCC_1V8
25.0℃ | 47.5℃ | consumption（mW) | Voltage(V) | AVG I (mA) | Voltage(V) | AVG I (mA) | Voltage(V) | AVG I (mA) | Voltage(V) | AVG I (mA) | Voltage(V) | AVG I (mA) | Voltage(V) | AVG I (mA) | Voltage(V) | AVG I (mA) | Voltage(V) | AVG I (mA) | Voltage(V) | AVG I (mA) | Voltage(V) | AVG I (mA)
 |  | 1059.9893 | 0.807 | 691.3 | 0.912 | 68.6 | 0.735 | 289.1 | 0.752 | 0.4 | 1.205 | 119 | 3.308 | 1.8 | 0.803 | 4.8 | 0.796 | 9.5 | 1.801 | 23.6 | 1.793 | 13.1
NOTE: 1.This is the measured power consumption value of each power supply, and the total system power consumption will be different according to different power supply efficiency. 2. The table list the power consumption of SOC.
2K camera，NN ON，NPU600MHz/VEPU396MHz/DEHAZE（OFF）/DDR BW 4100±50 MBps
Environment temperature | Chip temperature | SOC total Power consumption | VDD_LOGIC |  | VDD_ARM |  | VDD_VEPU |  | VDD_NPU |  | VCC_DDR（DDRPHY） |  | VCC3V3_SYS |  | VCC_0V8 |  | VCC0V8_PMU |  | VCC1V8_PMU |  | VCC_1V8
25.0℃ | 51.0℃ | consumption（mW) | Voltage(V) | AVG I (mA) | Voltage(V) | AVG I (mA) | Voltage(V) | AVG I (mA) | Voltage(V) | AVG I (mA) | Voltage(V) | AVG I (mA) | Voltage(V) | AVG I (mA) | Voltage(V) | AVG I (mA) | Voltage(V) | AVG I (mA) | Voltage(V) | AVG I (mA) | Voltage(V) | AVG I (mA)
 |  | 1293.0991 | 0.807 | 701.1 | 0.912 | 100.8 | 0.735 | 296.6 | 0.752 | 203.7 | 1.205 | 148 | 3.308 | 1.8 | 0.803 | 4.8 | 0.796 | 9.7 | 1.801 | 24.3 | 1.793 | 13.7
NOTE: 1.This is the measured power consumption value of each power supply, and the total system power consumption will be different according to different power supply efficiency. 2. The table list the power consumption of SOC.

Sheet: IPC 2K DDR3 EVB V1.0
Power consumption of RV1126/RV1109 IPC solution
Notice: These data is test on EVB board.Do not represent the final product power consumption value. If there is a big improvement, we will update.
Board | RV1126/RV1109_EVB_DDR3P216SD6_V10_20191219LXF+ OS04A10 module + NO LCD
Condition | RV1109\03_IMAGES\RV1109-EVB-DDR3-V10_20200717.0928_IPC\IMAGES Function： 1.ISP: 2688X1520@30FPS RAW10bit 2F HDR + TNR(2to1) + YNR&UVNR(ON) + DEHAZE（OFF） ISPP: MP(FBC): 2688X1520@30FPS YUV420 Scale0: 1280x720@30fps YUV420 Scale1: 640x480 YUV420 Scale2: OFF 2. Encode:3 H26X encode（H265 2688X1520@30fps 8Mbps + H264 1280x720@30fps 1Mbps + H264 640x480@30fps 512Kbps）+ 1 JPEG encode(2688X1520@2fps) + H26X 3. Moving frame rate: 640x480@30fps 4.Audio:1 channel 16K sample rate 16bit AAC , openANR 5. NPU:720p Camera input, Run SSD-inceptionv2 module 6. Close other devices（wifi/bt/lcd/tp/gmac） 7. FREQ:CPU:408MHz~1.5GHz/DDR:924MHz/NPU:600MHz/ISP:500MHz/ISPP:396MHz/VENC:396MHz To ensure the consistency of power consumption test, the camera should be covered. Tool PowerMe test: Power consumption within 10 minutes after application stabilization Environment Temperature: 25℃
DATE | 2020.07.17
2K Camera，NN OFF，NPU(OFF)/VEPU396MHz/DEHAZE（OFF）/DDR BW 3350±50 MBps
Environment temperature | Chip temperature | SOC total Power consumption | VDD_LOGIC |  | VDD_ARM |  | VDD_VEPU |  | VDD_NPU |  | VCC_DDR（DDRPHY） |  | VCC3V3_SYS |  | VCC_0V8 |  | VCC0V8_PMU |  | VCC1V8_PMU |  | VCC_1V8
25.0℃ | 53.0℃ | consumption（mW) | Voltage(V) | AVG I (mA) | Voltage(V) | AVG I (mA) | Voltage(V) | AVG I (mA) | Voltage(V) | AVG I (mA) | Voltage(V) | AVG I (mA) | Voltage(V) | AVG I (mA) | Voltage(V) | AVG I (mA) | Voltage(V) | AVG I (mA) | Voltage(V) | AVG I (mA) | Voltage(V) | AVG I (mA)
 |  | 1172.4328 | 0.812 | 669.8 | 0.918 | 115.8 | 0.743 | 295.3 | 0.747 | 0.6 | 1.51 | 140 | 3.308 | 1.9 | 0.803 | 5 | 0.796 | 9.9 | 1.801 | 24.7 | 1.793 | 15.8
NOTE: 1.This is the measured power consumption value of each power supply, and the total system power consumption will be different according to different power supply efficiency. 2. The table list the power consumption of SOC.
2KCamera，NN ON，NPU600MHz/VEPU396MHz/DEHAZE（OFF）/DDR BW 4100±50 MBps
Environment temperature | Chip temperature | SOC total Power consumption | VDD_LOGIC |  | VDD_ARM |  | VDD_VEPU |  | VDD_NPU |  | VCC_DDR（DDRPHY） |  | VCC3V3_SYS |  | VCC_0V8 |  | VCC0V8_PMU |  | VCC1V8_PMU |  | VCC_1V8
25.0℃ | 58.0℃ | consumption（mW) | Voltage(V) | AVG I (mA) | Voltage(V) | AVG I (mA) | Voltage(V) | AVG I (mA) | Voltage(V) | AVG I (mA) | Voltage(V) | AVG I (mA) | Voltage(V) | AVG I (mA) | Voltage(V) | AVG I (mA) | Voltage(V) | AVG I (mA) | Voltage(V) | AVG I (mA) | Voltage(V) | AVG I (mA)
 |  | 1379.7866 | 0.812 | 692 | 0.975 | 140.7 | 0.735 | 273.9 | 0.752 | 175.5 | 1.53 | 167 | 3.308 | 1.9 | 0.803 | 5 | 0.796 | 9.9 | 1.801 | 25.5 | 1.793 | 15.5
NOTE: 1.This is the measured power consumption value of each power supply, and the total system power consumption will be different according to different power supply efficiency. 2. The table list the power consumption of SOC.

Sheet: 4K IPC DDR3 EVB RV1126
Power consumption of RV1126 IPC 4K camera
Notice: These data is test on EVB board.Do not represent the final product power consumption value. If there is a big improvement, we will update.
Board | RV1109_EVB_DDR3P216SD6_V13+ IMX415 module + NO LCD
Condition | Linux_Repository\RV1109\03_IMAGES\vicap\RV1126-EVB-DDR3-V12_20201130.1800_RELEASE_TEST-VICAP-NORMAL-30FPS VICAP solution V12 EVB + IMX415 VICAP + ISP + ISPP, Normal, TNR 2to1，Raw10bit Freq: ISP 600MHz， ISPP 500MHz， DDR 1056MHz ，VEPU600MHz ISP output 30fps； Main stream 30fps, sub stream 30fps, triple stream 30fps Bit stream resolution: 4K (fbc0) + 720p + 480p Bandwidth:5698.66MB/s (67.45%) Power consumption without Ethernet
DATE | 2020.08.27
Environment temperature | Chip temperature | NOTE | SOC total Power consumption | VDD_LOGIC |  | VDD_ARM |  | VDD_NPU_VEPU |  | VCC3V3_SYS |  | VCC_DDR（DDRPHY） |  | VCC_0V8 |  | VCC0V8_PMU |  | VCC1V8_PMU |  | VCC_1V8
19.5℃ | 69.7℃ | NPU OFF | consumption（mW) | Voltage(V) | AVG I (mA) | Voltage(V) | AVG I (mA) | Voltage(V) | AVG I (mA) | Voltage(V) | AVG I (mA) | Voltage(V) | AVG I (mA) | Voltage(V) | AVG I (mA) | Voltage(V) | AVG I (mA) | Voltage(V) | AVG I (mA) | Voltage(V) | AVG I (mA)
 |  |  | 1886.1834 | 0.832 | 889.4 | 0.775 | 75.6 | 0.857 | 547.2 | 3.326 | 83 | 1.5 | 160.7 | 0.796 | 18.2 | 0.802 | 10.1 | 1.784 | 25.2 | 1.79 | 19
Environment temperature | Chip temperature | NOTE | SOC total Power consumption | VDD_LOGIC |  | VDD_ARM |  | VDD_NPU_VEPU |  | VCC3V3_SYS |  | VCC_DDR（DDRPHY） |  | VCC_0V8 |  | VCC0V8_PMU |  | VCC1V8_PMU |  | VCC_1V8
19.5℃ | 80.1℃ | NPU 800MHz | consumption（mW) | Voltage(V) | AVG I (mA) | Voltage(V) | AVG I (mA) | Voltage(V) | AVG I (mA) | Voltage(V) | AVG I (mA) | Voltage(V) | AVG I (mA) | Voltage(V) | AVG I (mA) | Voltage(V) | AVG I (mA) | Voltage(V) | AVG I (mA) | Voltage(V) | AVG I (mA)
 |  |  | 2169.6288 | 0.832 | 897 | 0.894 | 150.2 | 0.86 | 731.4 | 3.325 | 89.9 | 1.5 | 181.6 | 0.796 | 15.9 | 0.801 | 10.5 | 1.783 | 26.2 | 1.79 | 11.7
NOTE: 1.This is the measured power consumption value of each power supply, and the total system power consumption will be different according to different power supply efficiency. 2. The table list the power consumption of SOC.

Sheet: GATE DDR3 EVB RV1109
Power consumption of RV1126/RV1109 Gate Dual MIPI camera
Notice: These data is test on EVB board.Do not represent the final product power consumption value. If there is a big improvement, we will update.
Board | RV1126/RV1109_EVB_DDR3P216SD6_V12+ OV2718+GC2053+LCD
Condition | Linux_Repository\RV1109\03_IMAGES\RV1109-EVB-DDR3-V12-FACIAL-GATE_20200827.0908_RELEASE_TEST ISP+ISPP: RGB Camera（OV2718，1920*1080/HDR/3DNR）+ IR Camera（GC2053，1920*1080） NPU： 720p Camera input, Run Rockface algorithm（face_detect, liveness_detect, face_extrace..） FREQ：CPU:408MHz~1.5GHz/DDR:924MHz/NPU:600MHz/ISP:500MHz/ISPP:396MHz/VENC:396MHz
DATE | 2020.08.31
Environment temperature | Chip temperature | SOC total Power consumption | VDD_LOGIC |  | VDD_ARM |  | VDD_NPU_VEPU |  | VCC3V3_SYS |  | VCC_DDR（DDRPHY） |  | VCC_0V8 |  | VCC0V8_PMU |  | VCC1V8_PMU |  | VCC_1V8
25.0℃ | 66.7℃ | consumption（mW) | Voltage(V) | AVG I (mA) | Voltage(V) | AVG I (mA) | Voltage(V) | AVG I (mA) | Voltage(V) | AVG I (mA) | Voltage(V) | AVG I (mA) | Voltage(V) | AVG I (mA) | Voltage(V) | AVG I (mA) | Voltage(V) | AVG I (mA) | Voltage(V) | AVG I (mA)
 |  | 1305.026 | 0.826 | 780 | 0.874 | 104.8 | 0.729 | 63.8 | 3.308 | 64.9 | 1.53 | 133 | 0.803 | 19.5 | 0.799 | 10.4 | 1.79 | 26.1 | 1.787 | 18.9
NOTE: 1.This is the measured power consumption value of each power supply, and the total system power consumption will be different according to different power supply efficiency. 2. The table list the power consumption of SOC.
