cnchens/RV1126_RV1109_Hardware_Design_Template/01_Common Document/00_History Document/RV1126_RV1109_SOC_Package_Pin_Delay_V1.0_20200403.xlsx

RV1126_RV1109_SOC_Package_Pin_Delay_V1.0_20200403
UNIT: microns
Net Pins | Net Name | Total Conductor
ADC
E17 | ADCIN0 | 3409.026
D17 | ADCIN1 | 3774.586
B18 | ADCIN2 | 5275.416
A18 | ADCIN3 | 5896.371
C17 | ADCIN4 | 4722.121
B17 | ADCIN5 | 5273.234
DDR
C9 | DDR_A0 | 3502.953
B7 | DDR_A1 | 3867.129
B11 | DDR_A2 | 3455.112
B6 | DDR_A3 | 4047.059
A9 | DDR_A4 | 4211.906
A7 | DDR_A5 | 4301.86
C8 | DDR_A6 | 3797.842
B8 | DDR_A7 | 3737.321
A8 | DDR_A8 | 4240.191
B9 | DDR_A9 | 3926.182
A10 | DDR_A10 | 4181.554
C11 | DDR_A11 | 3401.953
D7 | DDR_A12 | 3309.465
A12 | DDR_A13 | 4632.28
A11 | DDR_A14 | 4423.52
B5 | DDR_A15 | 4474.812
B10 | DDR_A16 | 3932.131
A4 | DDR_ACTN | 5245.367
F6 | DDR_AVSS | 1325.812
E7 | DDR_BA0 | 2421.046
A6 | DDR_BA1 | 4571.126
D6 | DDR_BG0 | 2570.712
D11 | DDR_BG1 | 2340.161
C6 | DDR_CKE | 3235.334
D5 | DDR_CLKN | 3841.844
D4 | DDR_CLKP | 4014.085
B4 | DDR_CS0N | 4666.133
D8 | DDR_CS1N | 2891.833
N3 | DDR_DM0 | 4874.108
E2 | DDR_DM1 | 4747.328
M2 | DDR_DM2 | 4505.33
B3 | DDR_DM3 | 5028.066
K4 | DDR_DQ0 | 2186.927
J4 | DDR_DQ1 | 2508.929
P4 | DDR_DQ2 | 3964.229
N4 | DDR_DQ3 | 3075.64
J3 | DDR_DQ4 | 5227.307
K3 | DDR_DQ5 | 5231.989
M4 | DDR_DQ6 | 3348.008
P3 | DDR_DQ7 | 4693.832
D2 | DDR_DQ8 | 5431.398
D1 | DDR_DQ9 | 5973.341
H2 | DDR_DQ10 | 3898.778
H1 | DDR_DQ11 | 4635.615
G1 | DDR_DQ12 | 5307.08
E1 | DDR_DQ13 | 6466.461
C1 | DDR_DQ14 | 6775.398
C2 | DDR_DQ15 | 7000.769
K1 | DDR_DQ16 | 6167.064
K2 | DDR_DQ17 | 5318.533
J1 | DDR_DQ18 | 8300.276
J2 | DDR_DQ19 | 8274.234
P2 | DDR_DQ20 | 4455.814
L1 | DDR_DQ21 | 7630.62
M1 | DDR_DQ22 | 5253.381
P1 | DDR_DQ23 | 5120.27
A2 | DDR_DQ24 | 6039.83
A3 | DDR_DQ25 | 5625.211
G4 | DDR_DQ26 | 2465.646
F4 | DDR_DQ27 | 2975.591
H3 | DDR_DQ28 | 3304.257
G3 | DDR_DQ29 | 3679.91
B1 | DDR_DQ30 | 5833.882
B2 | DDR_DQ31 | 5650.636
L3 | DDR_DQS0N | 3079.166
L4 | DDR_DQS0P | 2806.94
F1 | DDR_DQS1N | 5479.94
F2 | DDR_DQS1P | 5218.22
N1 | DDR_DQS2N | 5265.721
N2 | DDR_DQS2P | 5038.743
E3 | DDR_DQS3N | 4185.864
D3 | DDR_DQS3P | 4205.422
A5 | DDR_ODT0 | 4686.25
D10 | DDR_ODT1 | 2448.791
C4 | DDR_RESETN | 4185.565
E5 | DDR_RZQ | 2219.746
SPI0_M0/PMUIO0 domain signal
W7 | NPOR | 3162.412
W6 | GPIO0_A0/CLK_REF | 3637.835
Y5 | GPIO0_A1/TSADC_SHUT_M0/TSADC_SHUTORG | 4681.404
AA3 | GPIO0_A2/CLKI_CLKO_32K | 5977.62
U7 | GPIO0_A3/SDMMC0_DET | 2623.9
V7 | GPIO0_A4/SPI0_CS1N_M0 | 2484.317
AA2 | GPIO0_A5/SPI0_CS0N_M0 | 6616.143
V6 | GPIO0_A6/SPI0_MOSI_M0 | 2571.042
W5 | GPIO0_A7/SPI0_MISO_M0 | 3727.881
Y4 | GPIO0_B0/SPI0_CLK_M0 | 4527.772
PMUIO1 domain signal
W10 | GPIO0_B1/PMIC_INT/PWM7_IR_M0 | 2653.9
Y10 | GPIO0_B2/PMIC_SLEEP/TSADC_SHUT_M1/PWM6_M0 | 3671.062
Y8 | GPIO0_B3/FLASH_VOL_SEL | 3904.695
AA7 | GPIO0_B4/I2C0_SCL | 4865.345
Y7 | GPIO0_B5/I2C0_SDA | 4182.437
W8 | GPIO0_B6/UART1_TX_M0/PWM0_M0 | 3348.38
V9 | GPIO0_B7/UART1_RX_M0/PWM1_M0 | 2236.06
U9 | GPIO0_C0/SDMMC0_PWR/UART1_RTSN_M0/PWM2_M0 | 1889.122
AA4 | GPIO0_C1/PMU_DEBUG/UART1_CTSN_M0/PWM3_IR_M0 | 6294.309
AA6 | GPIO0_C2/I2C2_SCL/PWM4_M0 | 4964.25
Y6 | GPIO0_C3/I2C2_SDA/PWM5_M0 | 4266.933
FLASH/EMMC
W2 | GPIO0_C4/FLASH_D0/EMMC_D0 | 5142.356
W1 | GPIO0_C5/FLASH_D1/EMMC_D1 | 5831.124
V4 | GPIO0_C6/FLASH_D2/EMMC_D2 | 3508.359
V3 | GPIO0_C7/FLASH_D3/EMMC_D3 | 4097.395
V2 | GPIO0_D0/FLASH_D4/EMMC_D4 | 4640.766
V1 | GPIO0_D1/FLASH_D5/EMMC_D5/FSPI_CS1N | 5346.492
U4 | GPIO0_D2/FLASH_D6/EMMC_D6 | 3607.865
U3 | GPIO0_D3/FLASH_D7/EMMC_D7 | 3774.777
U2 | GPIO0_D4/FLASH_CS0N/FSPI_CS0N/I2S1_MCLK_M0 | 4525.002
T4 | GPIO0_D5/FLASH_WRN/EMMC_CMD | 3027.341
T3 | GPIO0_D6/FSPI_D2/I2S1_SDO_M0 | 3584.547
T1 | GPIO0_D7/FLASH_CLE/EMMC_CLKO | 5150.437
T2 | GPIO1_A0/FLASH_ALE/FSPI_D0/I2S1_LRCK_M0 | 4311.773
R2 | GPIO1_A1/FLASH_RDYN/FSPI_D1/I2S1_SCLK_M0 | 4309.304
R4 | GPIO1_A2/FLASH_RDN/FSPI_D3/I2S1_SDI_M0 | 2775.167
R3 | GPIO1_A3/FLASH_WPN/EMMC_RSTN/FSPI_CLK | 3539.086
SDMMC0
Y14 | GPIO1_A4/SDMMC0_D0/TEST_CLK1_OUT/UART2_RX_M0 | 3511.674
W13 | GPIO1_A5/SDMMC0_D1/TEST_CLK0_OUT/UART2_TX_M0/RISC-V_JTAG_TRSTN | 2828.781
V13 | GPIO1_A6/SDMMC0_D2/UART3_RX_M1/A7_JTAG_TCK_M0/RISC-V_JTAG_TCK | 1920.091
U13 | GPIO1_A7/SDMMC0_D3/UART3_TX_M1/A7_JTAG_TMS_M0/RISC-V_JTAG_TMS | 1914.548
AA13 | GPIO1_B0/SDMMC0_CLK/UART3_RTSN_M1/RISC-V_JTAG_TDO | 4262.281
Y13 | GPIO1_B1/SDMMC0_CMD/UART3_CTSN_M1/RISC-V_JTAG_TDI | 3628.666
SDIO
D16 | GPIO1_B2/SDIO_CLK | 3510.079
A16 | GPIO1_B3/SDIO_CMD | 5567.663
B16 | GPIO1_B4/SDIO_D0 | 4763.668
C16 | GPIO1_B5/SDIO_D1 | 4088.963
D15 | GPIO1_B6/SDIO_D2 | 3133.658
C15 | GPIO1_B7/SDIO_D3 | 3813.93
UART0/I2S2_M0
B15 | GPIO1_C0/UART0_RTSN | 4307.317
A15 | GPIO1_C1/UART0_CTSN | 5095.07
D14 | GPIO1_C2/UART0_RX | 2793.222
C14 | GPIO1_C3/UART0_TX | 3567.576
B14 | GPIO1_C4/I2S2_SDO_M0/SPI1_MOSI_M1/FLASH_TRIG_OUT | 4082.89
E13 | GPIO1_C5/I2S2_SDI_M0/SPI1_MISO_M1/FLASH_TRIG_IN | 2392.716
D13 | GPIO1_C6/I2S2_SCLK_M0/SPI1_CLK_M1/PRELIGHT_TRIG_OUT/UART1_RTSN_M1 | 2481.881
C13 | GPIO1_C7/I2S2_LRCK_M0/SPI1_CS0N_M1/UART1_CTSN_M1 | 3219.8
B13 | GPIO1_D0/I2S2_MCLK_M0/SDIO_DET/SPI1_CS1N_M1/I2C5_SCL_M2/UART1_TX_M1 | 3780.889
A13 | GPIO1_D1/SDIO_PWR/I2C5_SDA_M2/UART1_RX_M1 | 4579.33
VCCIO4 domain Signal
W19 | GPIO1_D2/I2C1_SDA/UART4_RTSN_M2 | 4604.284
Y21 | GPIO1_D3/I2C1_SCL/UART4_CTSN_M2 | 6057.222
W20 | GPIO1_D4/UART4_RX_M2 | 4952.785
V20 | GPIO1_D5/SPI0_CS1N_M1/I2S1_MCLK_M1/UART4_TX_M2 | 4592.857
V19 | GPIO1_D6/SPI0_MOSI_M1/I2S1_SCLK_M1/I2C3_SCL_M2 | 4481.299
U18 | GPIO1_D7/SPI0_MISO_M1/I2S1_LRCK_M1/I2C3_SDA_M2 | 3799.873
U19 | GPIO2_A0/SPI0_CS0N_M1/I2S1_SDI_M1/UART5_TX_M2 | 3680.111
U20 | GPIO2_A1/SPI0_CLK_M1/I2S1_SDO_M1/UART5_RX_M2 | 4338.527
W21 | GPIO2_A2/MIPI_CSI_CLK1/UART5_RTSN_M2 | 5800.991
V21 | GPIO2_A3/MIPI_CSI_CLK0/UART5_CTSN_M2 | 5484.713
LCDC/RGMII_M1/CIF_M1
J18 | GPIO2_A4/LCDC_D0/RGMII_TXD3_M1/CIF_D0_M1/UART4_RTSN_M1 | 2614.919
L17 | GPIO2_A5/LCDC_D1/RGMII_CRS_M1/CIF_D1_M1/UART4_CTSN_M1/I2C5_SCL_M0 | 1965.775
M21 | GPIO2_A6/LCDC_D2/RGMII_COL_M1/CIF_D2_M1/UART4_TX_M1/PWM5_M1 | 4397.448
M20 | GPIO2_A7/LCDC_D3/I2S2_SDO_M1/UART4_RX_M1/PWM4_M1/SPI0_CS0N_M2 | 3779.037
L19 | GPIO2_B0/LCDC_D4/I2S2_SDI_M1/UART5_TX_M1/PWM3_IR_M1/SPI0_MOSI_M2 | 2870.207
L20 | GPIO2_B1/LCDC_D5/I2S2_SCLK_M1/UART5_RX_M1/PWM2_M1/SPI0_MISO_M2 | 3417.914
K16 | GPIO2_B2/LCDC_D6/I2S2_LRCK_M1/UART5_RTSN_M1/PWM1_M1/SPI0_CLK_M2 | 1348.205
K17 | GPIO2_B3/LCDC_D7/I2S2_MCLK_M1/CIF_D3_M1/UART5_CTSN_M1/PWM0_M1/SPI0_CS1N_M2/I2C5_SDA_M0 | 1632.183
K18 | GPIO2_B4/LCDC_D8/RGMII_RXDV_M1/CIF_D4_M1 | 2387.896
K19 | GPIO2_B5/LCDC_D9/RGMII_RXD0_M1/CIF_D5_M1 | 2727.821
K20 | GPIO2_B6/LCDC_D10/RGMII_RXD1_M1/CIF_D6_M1 | 3454.821
K21 | GPIO2_B7/LCDC_D11/RGMII_CLK_M1/CIF_D7_M1 | 4185.819
J19 | GPIO2_C0/LCDC_D12/RGMII_RXER_M1/CIF_D8_M1 | 3173.703
J21 | GPIO2_C1/LCDC_D13/RGMII_MDIO_M1/CIF_D9_M1 | 4339.636
J20 | GPIO2_C2/LCDC_D14/RGMII_MDC_M1/CIF_D10_M1 | 3503.307
H20 | GPIO2_C3/LCDC_D15/RGMII_TXD0_M1/CIF_D11_M1 | 3922.613
H19 | GPIO2_C4/LCDC_D16/RGMII_TXD1_M1/CIF_D12_M1 | 3147.054
G21 | GPIO2_C5/LCDC_D17/CLK_OUT_ETHERNET_M1/CIF_D13_M1 | 4675.709
G20 | GPIO2_C6/LCDC_D18/RGMII_TXEN_M1/CIF_D14_M1 | 3888.069
G19 | GPIO2_C7/LCDC_D19/RGMII_RXD2_M1/CIF_D15_M1/I2S1_MCLK_M2 | 3783.452
H18 | GPIO2_D0/LCDC_D20/RGMII_RXD3_M1/CIF_VSYNC_M1/I2S1_SDO_M2 | 2295.766
F21 | GPIO2_D1/LCDC_D21/RGMII_TXD2_M1/CIF_CLKOUT_M1/I2S1_SCLK_M2 | 4862.438
F20 | GPIO2_D2/LCDC_D22/RGMII_TXCLK_M1/CIF_CLKIN_M1/I2S1_LRCK_M2 | 4120.115
F19 | GPIO2_D3/LCDC_D23/RGMII_RXCLK_M1/CIF_HSYNC_M1/I2S1_SDI_M2 | 4063.747
J17 | GPIO2_D4/LCDC_DEN/PWM6_M1/SPI1_CS0N_M2/I2C3_SCL_M1 | 1604.393
H17 | GPIO2_D5/LCDC_HSYNC/PWM10_M1/SPI1_CLK_M2/I2C3_SDA_M1 | 2151.662
C21 | GPIO2_D6/LCDC_VSYNC/UART3_RTSN_M2/PWM9_M1/SPI1_MOSI_M2 | 6350.616
D21 | GPIO2_D7/LCDC_CLK/UART3_CTSN_M2/PWM8_M1/SPI1_MISO_M2 | 5504.877
CAN BUS
E20 | GPIO3_A0/CAN_RXD_M0/UART3_TX_M2/PWM7_IR_M1/SPI1_CS1N_M2/I2C4_SCL_M0 | 4325.169
E19 | GPIO3_A1/CAN_TXD_M0/UART3_RX_M2/PWM11_IR_M1/I2C4_SDA_M0 | 4154.359
G18 | GPIO3_A2/UART2_TX_M1/A7_JTAG_TCK_M1 | 2479.193
H16 | GPIO3_A3/UART2_RX_M1/A7_JTAG_TMS_M1 | 1171.27
CIF_M0/RGMII_M0
R17 | GPIO3_A4/CIF_D0_M0/I2S0_SCLK_TX_M1/UART4_TX_M0/I2C3_SCL_M0/PWM8_M0 | 2574.042
T18 | GPIO3_A5/CIF_D1_M0/RGMII_CRS_M0/I2S0_LRCK_TX_M1/UART4_RX_M0/I2C3_SDA_M0/PWM9_M0 | 3818.724
P17 | GPIO3_A6/CIF_D2_M0/RGMII_COL_M0/I2S0_SDO0_M1/UART5_TX_M0/CAN_RXD_M1/PWM10_M0 | 1763.028
R18 | GPIO3_A7/CIF_D3_M0/RGMII_RXD2_M0/I2S0_SDI0_M1/UART5_RX_M0/CAN_TXD_M1/PWM11_IR_M0 | 3015.175
T19 | GPIO3_B0/CIF_D4_M0/RGMII_RXD3_M0/I2S0_MCLK_M1/UART5_RTSN_M0/I2C5_SCL_M1 | 3905.333
T20 | GPIO3_B1/CIF_D5_M0/RGMII_TXD2_M0/I2S0_SCLK_RX_M1/UART5_CTSN_M0/I2C5_SDA_M1 | 4418.101
N17 | GPIO3_B2/CIF_D6_M0/RGMII_TXD3_M0/I2S0_LRCK_RX_M1/UART4_RTSN_M0 | 1539.782
R19 | GPIO3_B3/CIF_D7_M0/RGMII_TXD0_M0/I2S0_SDO1_SDI3_M1/UART4_CTSN_M0 | 3802.079
T21 | GPIO3_B4/CIF_D8_M0/RGMII_TXD1_M0/I2S0_SDO2_SDI2_M1/SPI1_CS1N_M0 | 5114.591
N18 | GPIO3_B5/CIF_D9_M0/RGMII_TXEN_M0/I2S0_SDO3_SDI1_M1/SPI1_CS0N_M0 | 2884.798
R20 | GPIO3_B6/CIF_D10_M0/RGMII_RXD0_M0/PDM_SDI2_M1/SPI1_MOSI_M0 | 4604.398
R21 | GPIO3_B7/CIF_D11_M0/RGMII_RXD1_M0/PDM_SDI3_M1/SPI1_MISO_M0 | 5244.479
N19 | GPIO3_C0/CIF_D12_M0/RGMII_CLK_M0/PDM_CLK0_M1/SPI1_CLK_M0 | 3159.946
M17 | GPIO3_C1/CIF_D13_M0/RGMII_RXDV_M0/PDM_SDI0_M1 | 1987.82
M18 | GPIO3_C2/CIF_D14_M0/RGMII_RXER_M0/PDM_SDI1_M1 | 2237.072
N20 | GPIO3_C3/CIF_D15_M0/RGMII_MDIO_M0/PDM_CLK1_M1 | 3704.974
N21 | GPIO3_C4/CIF_VSYNC_M0/RGMII_MDC_M0/UART3_RTSN_M0 | 4488.667
M19 | GPIO3_C5/CIF_CLKIN_M0/CLK_OUT_ETHERNET_M0/UART3_CTSN_M0 | 2918.779
P19 | GPIO3_C6/CIF_CLKOUT_M0/RGMII_TXCLK_M0/UART3_TX_M0 | 3229.802
P20 | GPIO3_C7/CIF_HSYNC_M0/RGMII_RXCLK_M0/UART3_RX_M0 | 5674.785
I2S0/PDM/ACODEC/AUDDSM
W12 | GPIO3_D0/I2S0_SCLK_TX_M0/ACODEC_DAC_CLK | 2641.74
V12 | GPIO3_D1/I2S0_SCLK_RX_M0/PDM_CLK1_M0/ACODEC_ADC_CLK | 2596.016
U12 | GPIO3_D2/I2S0_MCLK_M0 | 1246.628
W11 | GPIO3_D3/I2S0_LRCK_TX_M0/ACODEC_DAC_SYNC/AUDPWM_L_M1/AUDDSM_LN | 2977.555
Y12 | GPIO3_D4/I2S0_LRCK_RX_M0/PDM_CLK0_M0/ACODEC_ADC_SYNC | 3358.274
Y11 | GPIO3_D5/I2S0_SDO0_M0/ACODEC_DAC_DATAR/AUDPWM_R_M1/AUDDSM_LP | 3577.422
AA12 | GPIO3_D6/I2S0_SDI0_M0/PDM_SDI0_M0/ACODEC_DAC_DATAL | 4374.812
T11 | GPIO3_D7/I2S0_SDO1_SDI3_M0/PDM_SDI3_M0/ACODEC_ADC_DATA | 1268.972
U11 | GPIO4_A0/I2S0_SDO2_SDI2_M0/PDM_SDI2_M0/AUDPWM_L_M0/I2C4_SCL_M1/AUDDSM_RN | 1509.659
V11 | GPIO4_A1/I2S0_SDO3_SDI1_M0/PDM_SDI1_M0/AUDPWM_R_M0/I2C4_SDA_M1/AUDDSM_RP | 2162.734
MIPI_CSI_RX0
V15 | MIPI_CSI_RX0_CLKN/LVDS0_CLKN | 2464.315
U15 | MIPI_CSI_RX0_CLKP/LVDS0_CLKP | 2506.951
U16 | MIPI_CSI_RX0_D0N/LVDS0_RX0N | 2708.381
V16 | MIPI_CSI_RX0_D0P/LVDS0_RX0P | 2827.38
W16 | MIPI_CSI_RX0_D1N/LVDS0_RX1N | 4061.764
Y16 | MIPI_CSI_RX0_D1P/LVDS0_RX1P | 4167.743
Y15 | MIPI_CSI_RX0_D2N/LVDS0_RX2N | 3914.94
W15 | MIPI_CSI_RX0_D2P/LVDS0_RX2P | 4015.621
AA16 | MIPI_CSI_RX0_D3N/LVDS0_RX3N | 5175.692
AA15 | MIPI_CSI_RX0_D3P/LVDS0_RX3P | 5252.48
MIPI_CSI_RX1
W18 | MIPI_CSI_RX1_CLKN/LVDS1_CLKN | 3824.576
V18 | MIPI_CSI_RX1_CLKP/LVDS1_CLKP | 3883.43
Y20 | MIPI_CSI_RX1_D0N/LVDS1_RX0N | 6076.438
AA20 | MIPI_CSI_RX1_D0P/LVDS1_RX0P | 6147.077
Y19 | MIPI_CSI_RX1_D1N/LVDS1_RX1N | 5644.024
AA19 | MIPI_CSI_RX1_D1P/LVDS1_RX1P | 5779.984
Y18 | MIPI_CSI_RX1_D2N/LVDS1_RX2N | 5287.449
AA18 | MIPI_CSI_RX1_D2P/LVDS1_RX2P | 5372.455
W17 | MIPI_CSI_RX1_D3N/LVDS1_RX3N | 4279.516
Y17 | MIPI_CSI_RX1_D3P/LVDS1_RX3P | 4388.149
MIPI_DSI
C18 | MIPI_DSI_TX0_CLKN | 4670.177
C19 | MIPI_DSI_TX0_CLKP | 4810.535
B19 | MIPI_DSI_TX0_D0N | 5930.308
A19 | MIPI_DSI_TX0_D0P | 6190.313
B20 | MIPI_DSI_TX0_D1N | 6459.188
A20 | MIPI_DSI_TX0_D1P | 6691.871
C20 | MIPI_DSI_TX0_D2N | 6255.408
B21 | MIPI_DSI_TX0_D2P | 6422.694
D19 | MIPI_DSI_TX0_D3N | 4686.762
D20 | MIPI_DSI_TX0_D3P | 4824.288
USB2.0
W4 | OTG_DM | 4874.061
W3 | OTG_DP | 4740.909
Y2 | HOST_DM | 6034.263
Y1 | HOST_DP | 6015.831
OSC
AA9 | XIN24M | 4772.091
Y9 | XOUT24M | 4558.549
