cnchens/RV1126_RV1109_Hardware_Design_Template/02_DDR Template/00_History Document/历史文件/RV1126_RV1109 DDR template introduce.xlsx

DDR类型 | 核心模板名称 | 模板特征 | 频率
DDR3 | RV1126_RV1109_Template_DDR3P216DD4_V10_20200617 | 板层：4层板 | 933MHz
 |  | DDR数量：支持贴1颗或2颗DDR颗粒,如果只贴单个颗粒，要使用lane0和lane2（这个颗粒）。
 |  | DDR芯片布局 ：D-双面贴
DDR3 | RV1126_RV1109_Template_DDR3P216SD4_V10_20200619 | 板层：4层板 | 1056MHz
 |  | DDR数量：支持贴1颗或2颗DDR颗粒,如果只贴单个颗粒，要使用lane0和lane2（这个颗粒）。
 |  | DDR芯片布局 ：S-单面贴
DDR3 | RV1126_RV1109_Template_DDR3P216DD6_V10_20200325 | 板层：6层板 | 1056MHz
 |  | DDR数量：只支持2颗DDR颗粒。
 |  | DDR芯片布局 ：D-双面贴
DDR3 | RV1126_RV1109_Template_DDR3P416DD6_V10_20200423 | 板层：6层板 | 1056MHz
 |  | DDR数量：支持4颗DDR颗粒。
 |  | DDR芯片布局 ：D-双面贴
DDR4 | RV1126_RV1109_Template_DDR4P216DD6_V10_20200325 | 板层：6层板 | 1056MHz
 |  | DDR数量：支持贴1颗或2颗DDR颗粒,如果只贴单个颗粒，要使用lane0和lane2（这个颗粒）。
 |  | DDR芯片布局 ：D-双面贴
LPDDR3 | RV1126_RV1109_Template_LP3S178P132SD6_V10_20200325 | 板层：6层板 | 1056MHz
 |  | DDR数量：单颗 178 balls LPDDR3
LPDDR4 | RV1126_RV1109_Template_LP4S200P132SD6_V10_20200325 | 板层：6层板 | 1056MHz
 |  | DDR数量：单颗 200 balls LPDDR4
DDR type | Template name | description | Frequence
DDR3 | RV1126_RV1109_Template_DDR3P216DD4_V10_20200617 | Layer: 4 | 933MHz
 |  | DDR number：Support 1pcs or 2 pcs DDR chips.If only use 1pcs DDR chip, please use lane0 and lane2.
 |  | DDR layout：double side
DDR3 | RV1126_RV1109_Template_DDR3P216SD4_V10_20200619 | Layer: 4 | 1056MHz
 |  | DDR number：Support 1pcs or 2 pcs DDR chips.If only use 1pcs DDR chip, please use lane0 and lane2.
 |  | DDR layout：Single side
DDR3 | RV1126_RV1109_Template_DDR3P216DD6_V10_20200325 | Layer:6 | 1056MHz
 |  | DDR number：Only support 2 pcs DDR chips.
 |  | DDR layout：double side
DDR3 | RV1126_RV1109_Template_DDR3P416DD6_V10_20200423 | Layer:6 | 1056MHz
 |  | DDR number：Support 4 pcs DDR chips.
 |  | DDR layout：double side
DDR4 | RV1126_RV1109_Template_DDR4P216DD6_V10_20200325 | Layer: 6 | 1056MHz
 |  | DDR number：Support 1pcs or 2 pcs DDR chips.If only use 1pcs DDR chip, please use lane0 and lane2.
 |  | DDR layout：double side
LPDDR3 | RV1126_RV1109_Template_LP3S178P132SD6_V10_20200325 | Layer: 6 | 1056MHz
 |  | DDR number：Support 1pcs 178 balls LPDDR3 chip
LPDDR4 | RV1126_RV1109_Template_LP4S200P132SD6_V10_20200325 | Layer: 6 | 1056MHz
 |  | DDR number：Support 1pcs 200 balls LPDDR4 chip
