cnchens/RV1126_RV1109_Hardware_Design_Template/05_Pruduct Line Branch(UVC DEMO)/00_History Document/SCH Ver12/RV1126_RV1109_USB_AI_Camera_DEMO_DDR3P216DD6_V12_20200820.pdf

D | D

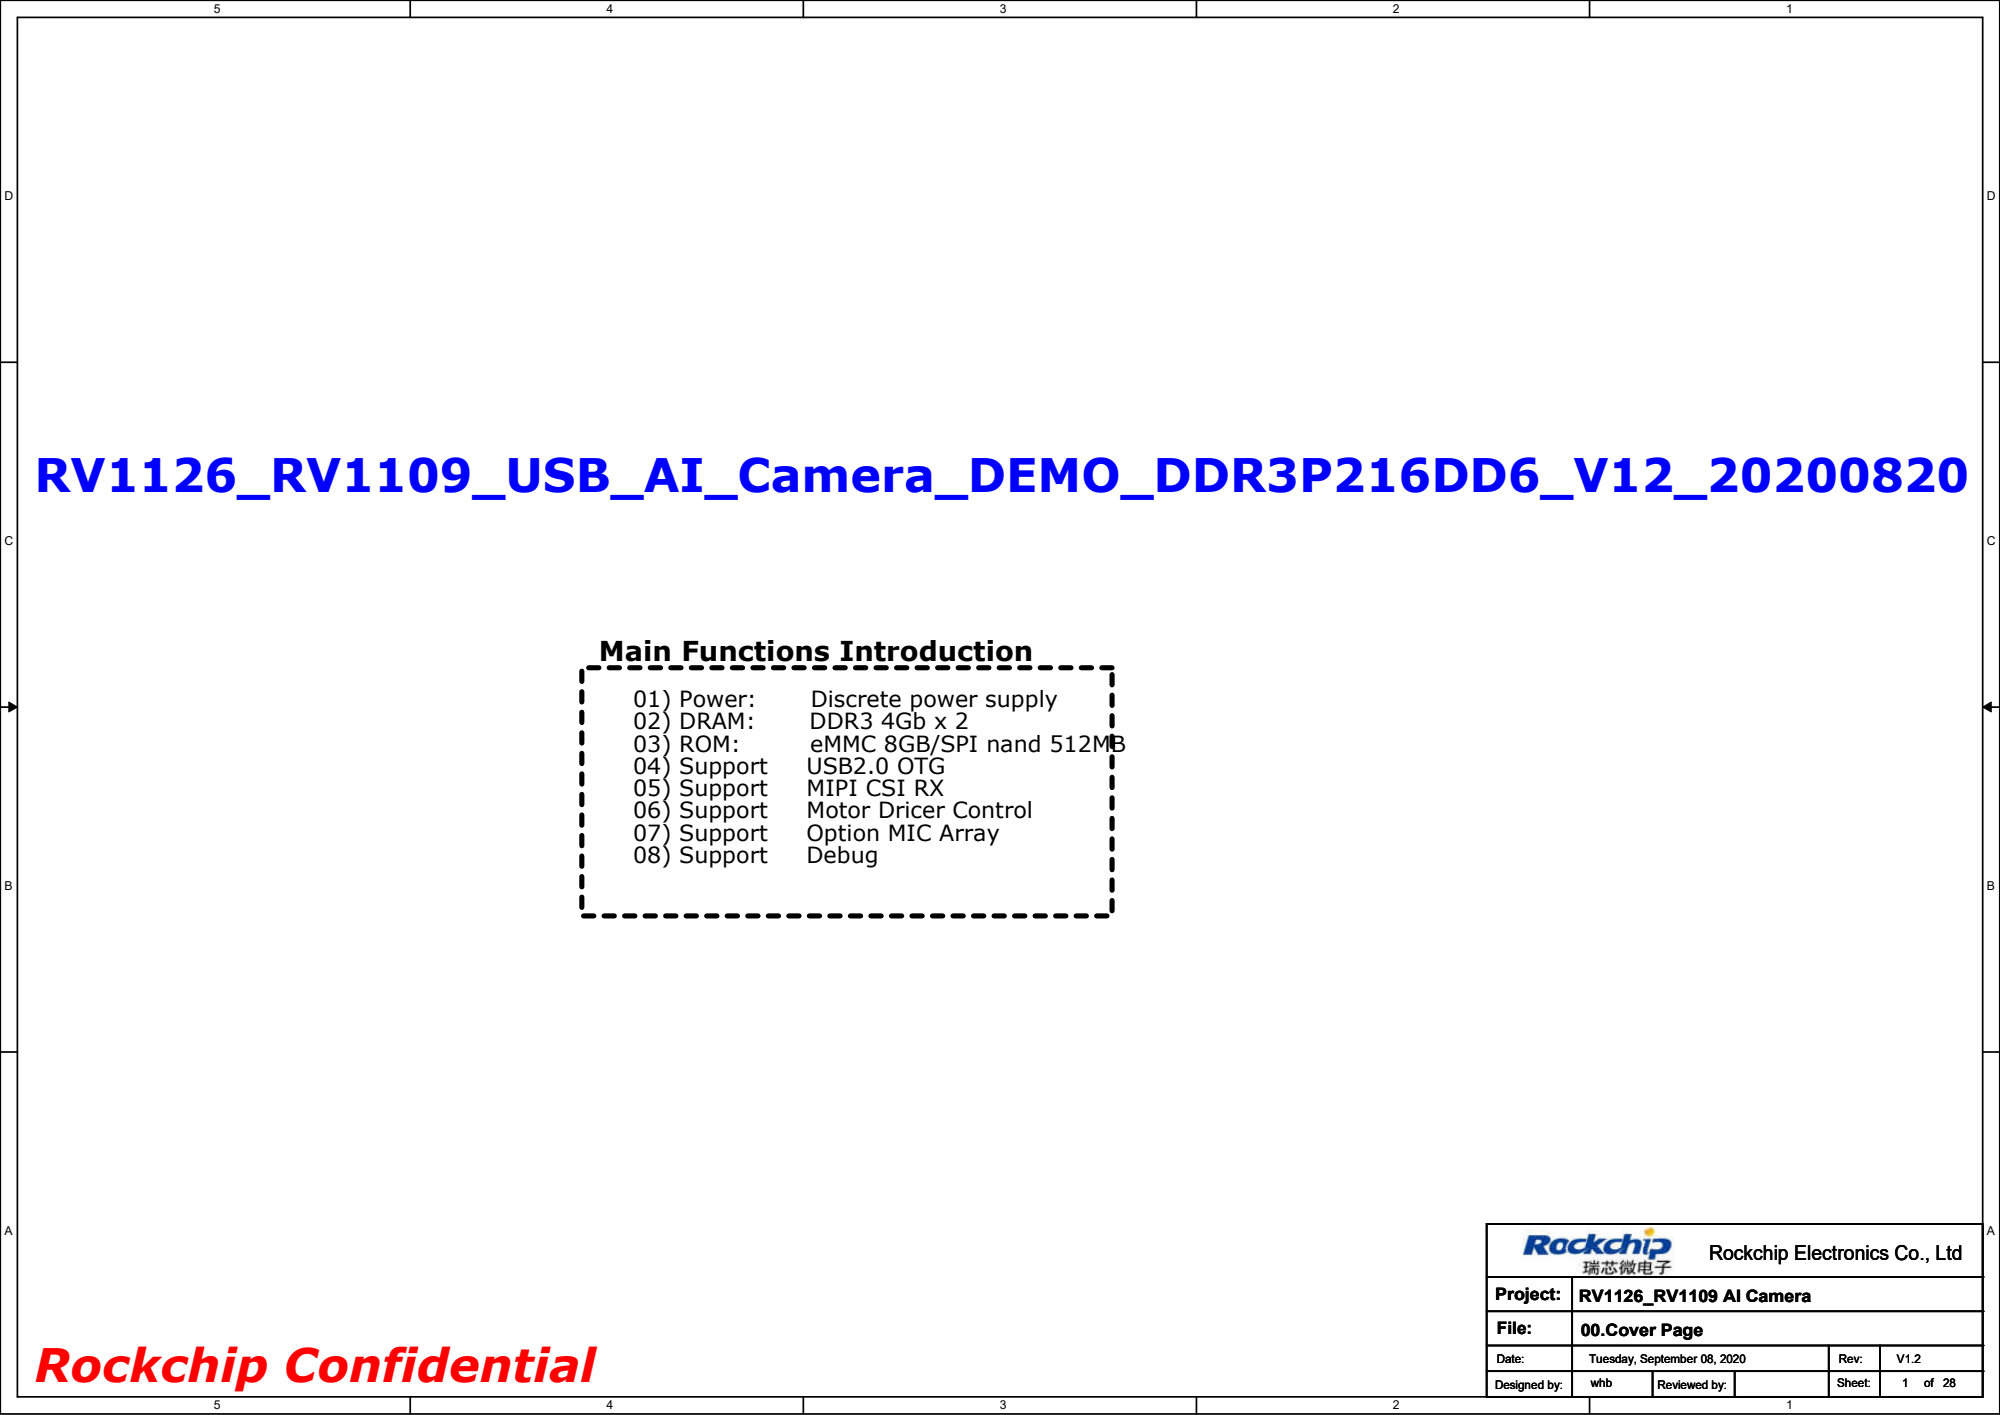
[picture p60: page 1]
01) Power:; Discrete power supply; 02) DRAM:; DDR3 4Gb x 2; 03) ROM:; eMMC 8GB/SPI nand 512MB; 04) Support; USB2.0 OTG; 05) Support; MIPI CSI RX; 06) Support; Motor Dricer Control; 07) Support; Option MIC Array; 08) Support; Debug; RV1126_RV1109_USB_AI_Camera_DEMO_DDR3P216DD6_V12_20200820; Rockchip Confidential; Project:; File:; Date:; Designed by:; Rev:; Reviewed by:; Sheet:; Tuesday, September 08, 2020; 00.Cover Page; RV1126_RV1109 AI Camera; whb

Main Functions Introduction

Rockchip Electronics Co., Ltd

D | D

## Page02

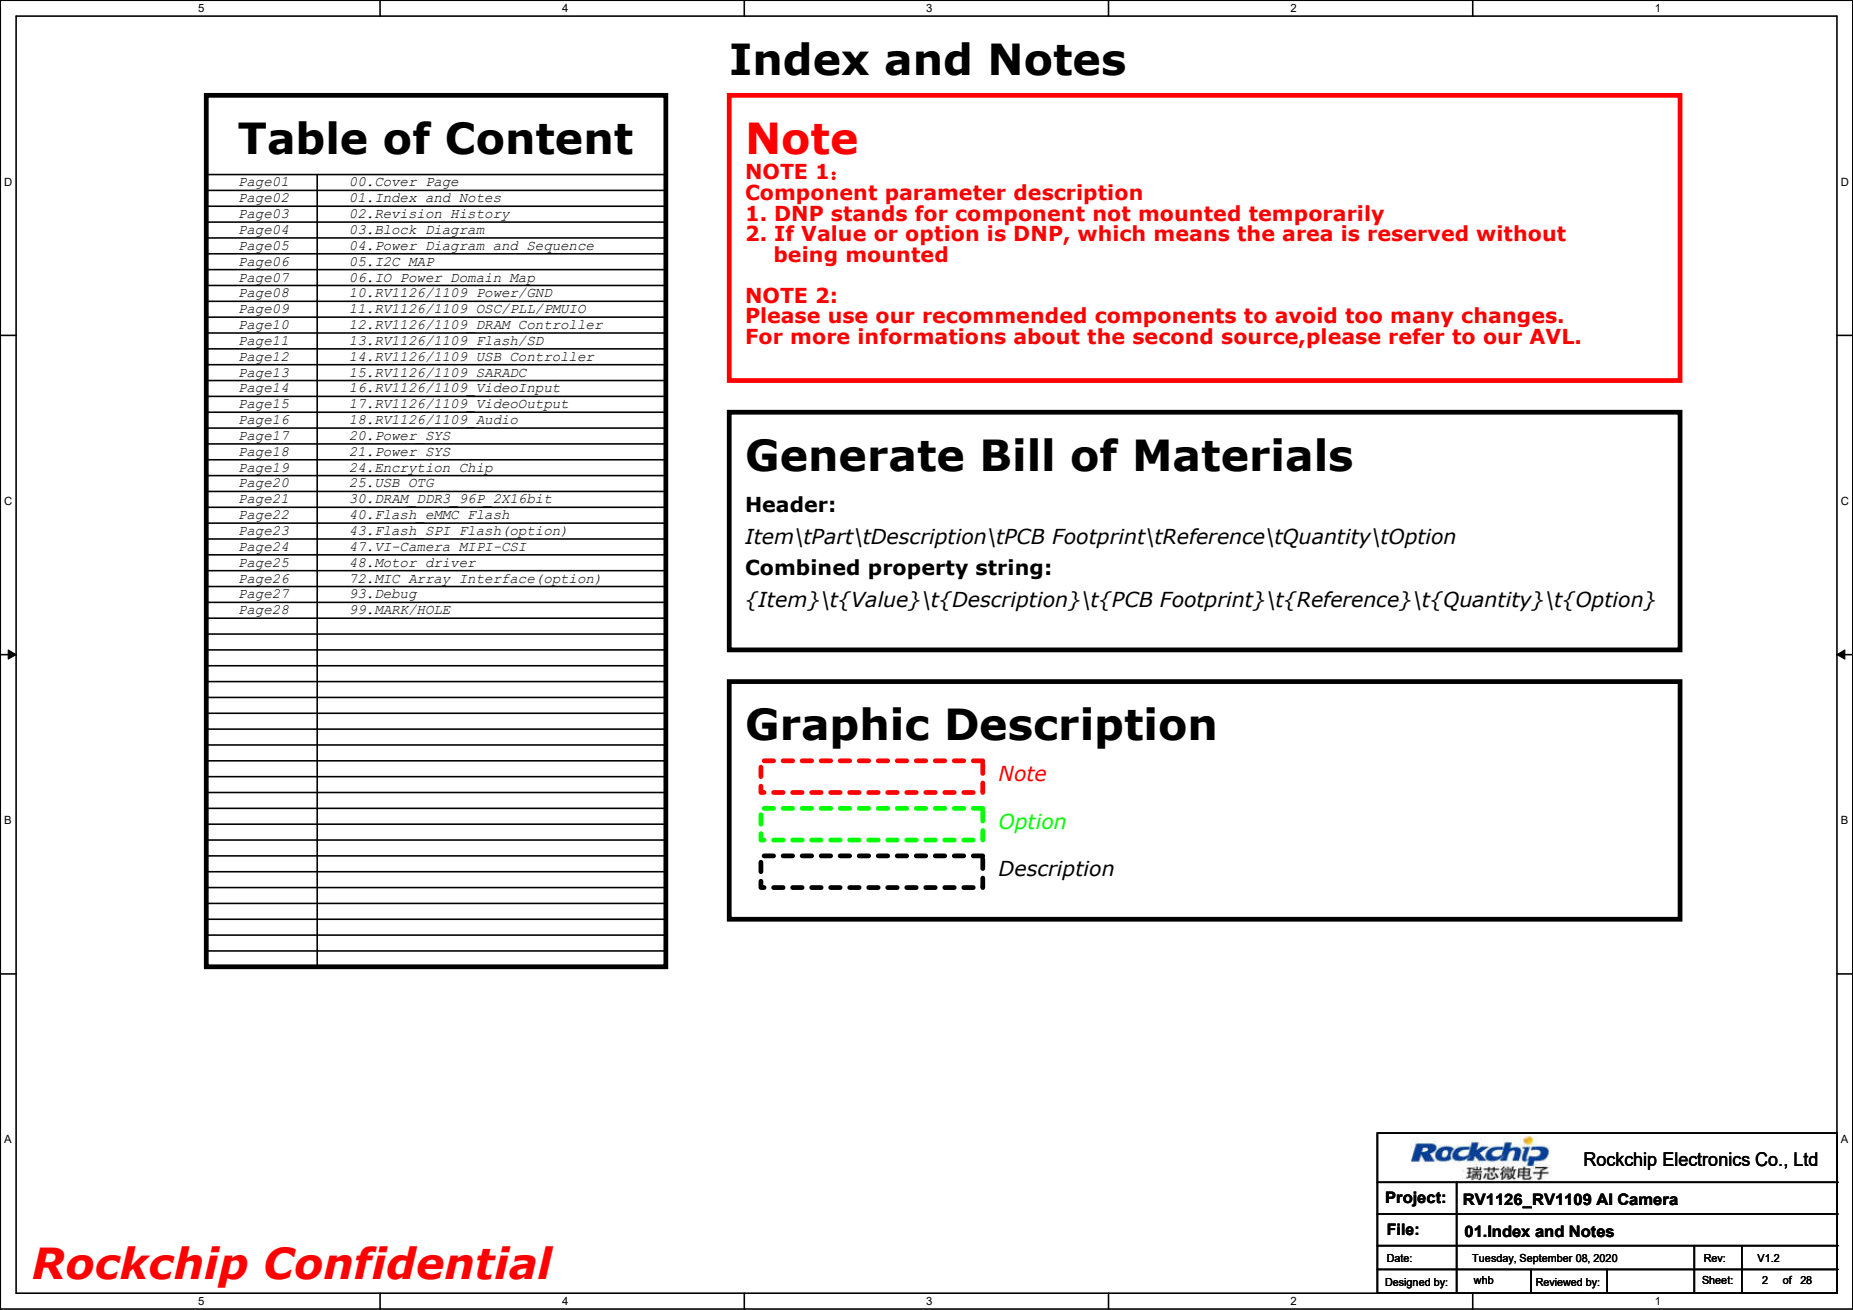
[picture p61: page 2]
Rockchip Confidential; Page03 Page04 Page05; Page07; Page06; Page08 Page09 Page10 Page11 Page12 Page13 Page14 Page15 Page16 Page17 Page18 Page19 Page20 Page21 Page22 Page23 Page24 Page25 Page26 Page27; Graphic Description; Note; Option; Description; Page01; Page28; Project:; whb

Index and Notes

Table of Content

NOTE 1： Component parameter description

00.Cover Page
01.Index and Notes
02.Revision History
03.Block Diagram
04.Power Diagram and Sequence
05.I2C MAP
06.IO Power Domain Map
10.RV1126/1109 Power/GND
11.RV1126/1109 OSC/PLL/PMUIO
12.RV1126/1109_DRAM Controller
13.RV1126/1109_Flash/SD
14.RV1126/1109_USB Controller
15.RV1126/1109_SARADC
16.RV1126/1109_VideoInput
17.RV1126/1109_VideoOutput
18.RV1126/1109_Audio
20.Power_SYS
21.Power_SYS
24.Encrytion Chip
25.USB OTG
30.DRAM_DDR3_96P_2X16bit
40.Flash_eMMC Flash
43.Flash_SPI Flash(option)
47.VI-Camera_MIPI-CSI
48.Motor driver
72.MIC Array Interface(option)
93.Debug
99.MARK/HOLE

1. DNP stands for component not mounted temporarily
2. If Value or option is DNP, which means the area is reserved without
being mounted

NOTE 2:
Please use our recommended components to avoid too many changes.
For more informations about the second source,please refer to our AVL.

Generate Bill of Materials

Header:
Item\tPart\tDescription\tPCB Footprint\tReference\tQuantity\tOption
Combined property string:
{Item}\t{Value}\t{Description}\t{PCB Footprint}\t{Reference}\t{Quantity}\t{Option}

Rockchip Electronics Co., Ltd

D | D

# Revision History

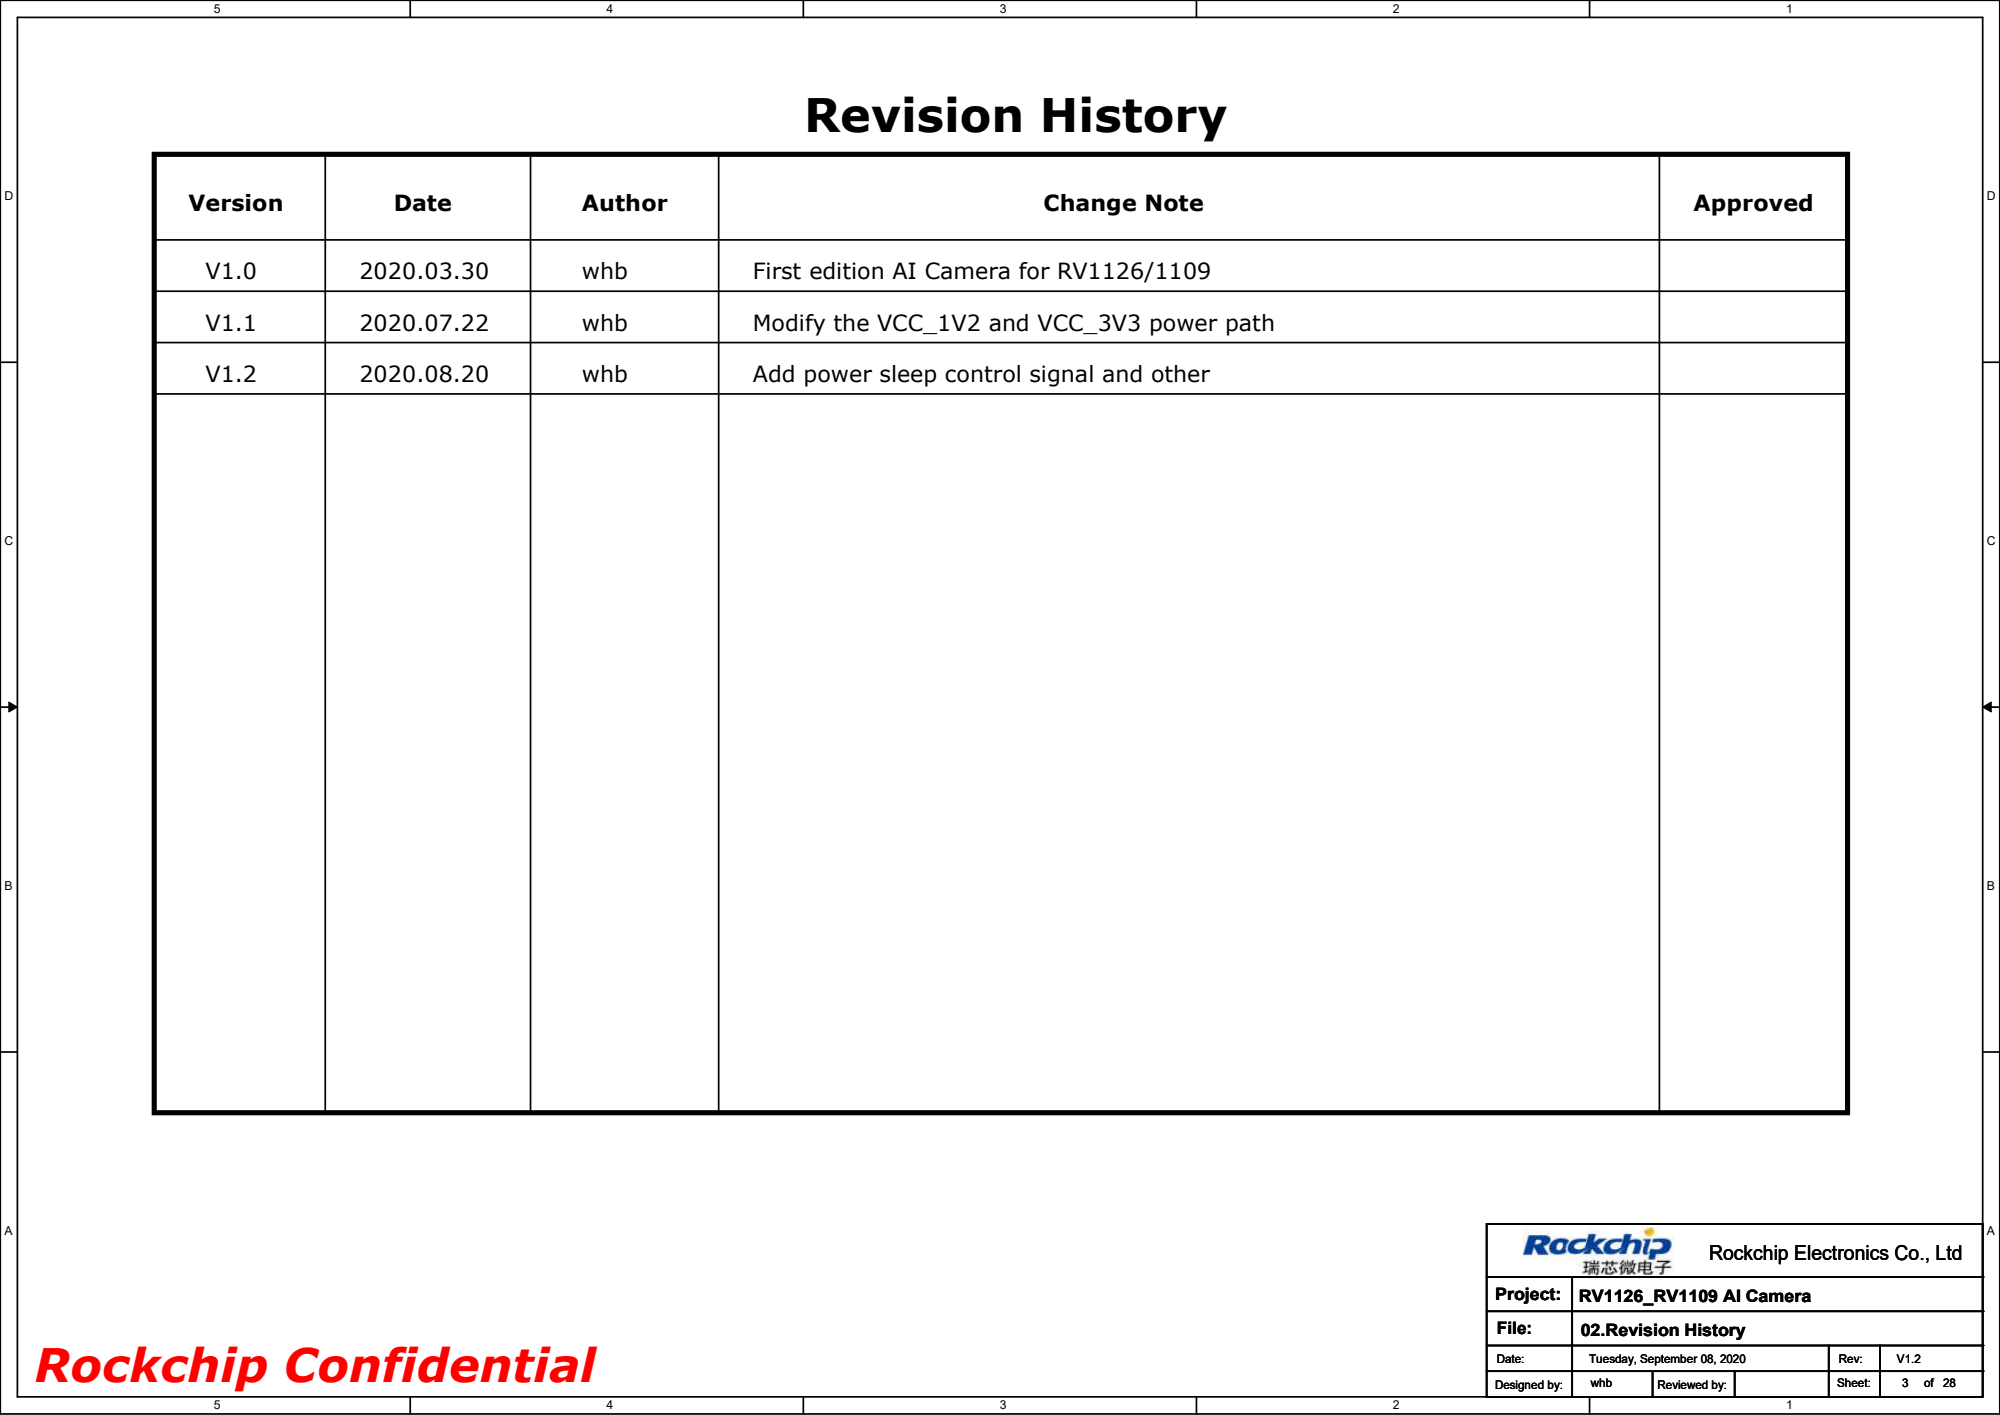
[picture p62: page 3]
Version; Date; Author; Change Note; Approved; whb; First edition AI Camera for RV1126/1109; Rockchip Confidential; Modify the VCC_1V2 and VCC_3V3 power path; Add power sleep control signal and other; Project:; 02.Revision History

Rockchip Electronics Co., Ltd

DDR3L/DDR3 | DDR Controller

# MIPI DSI

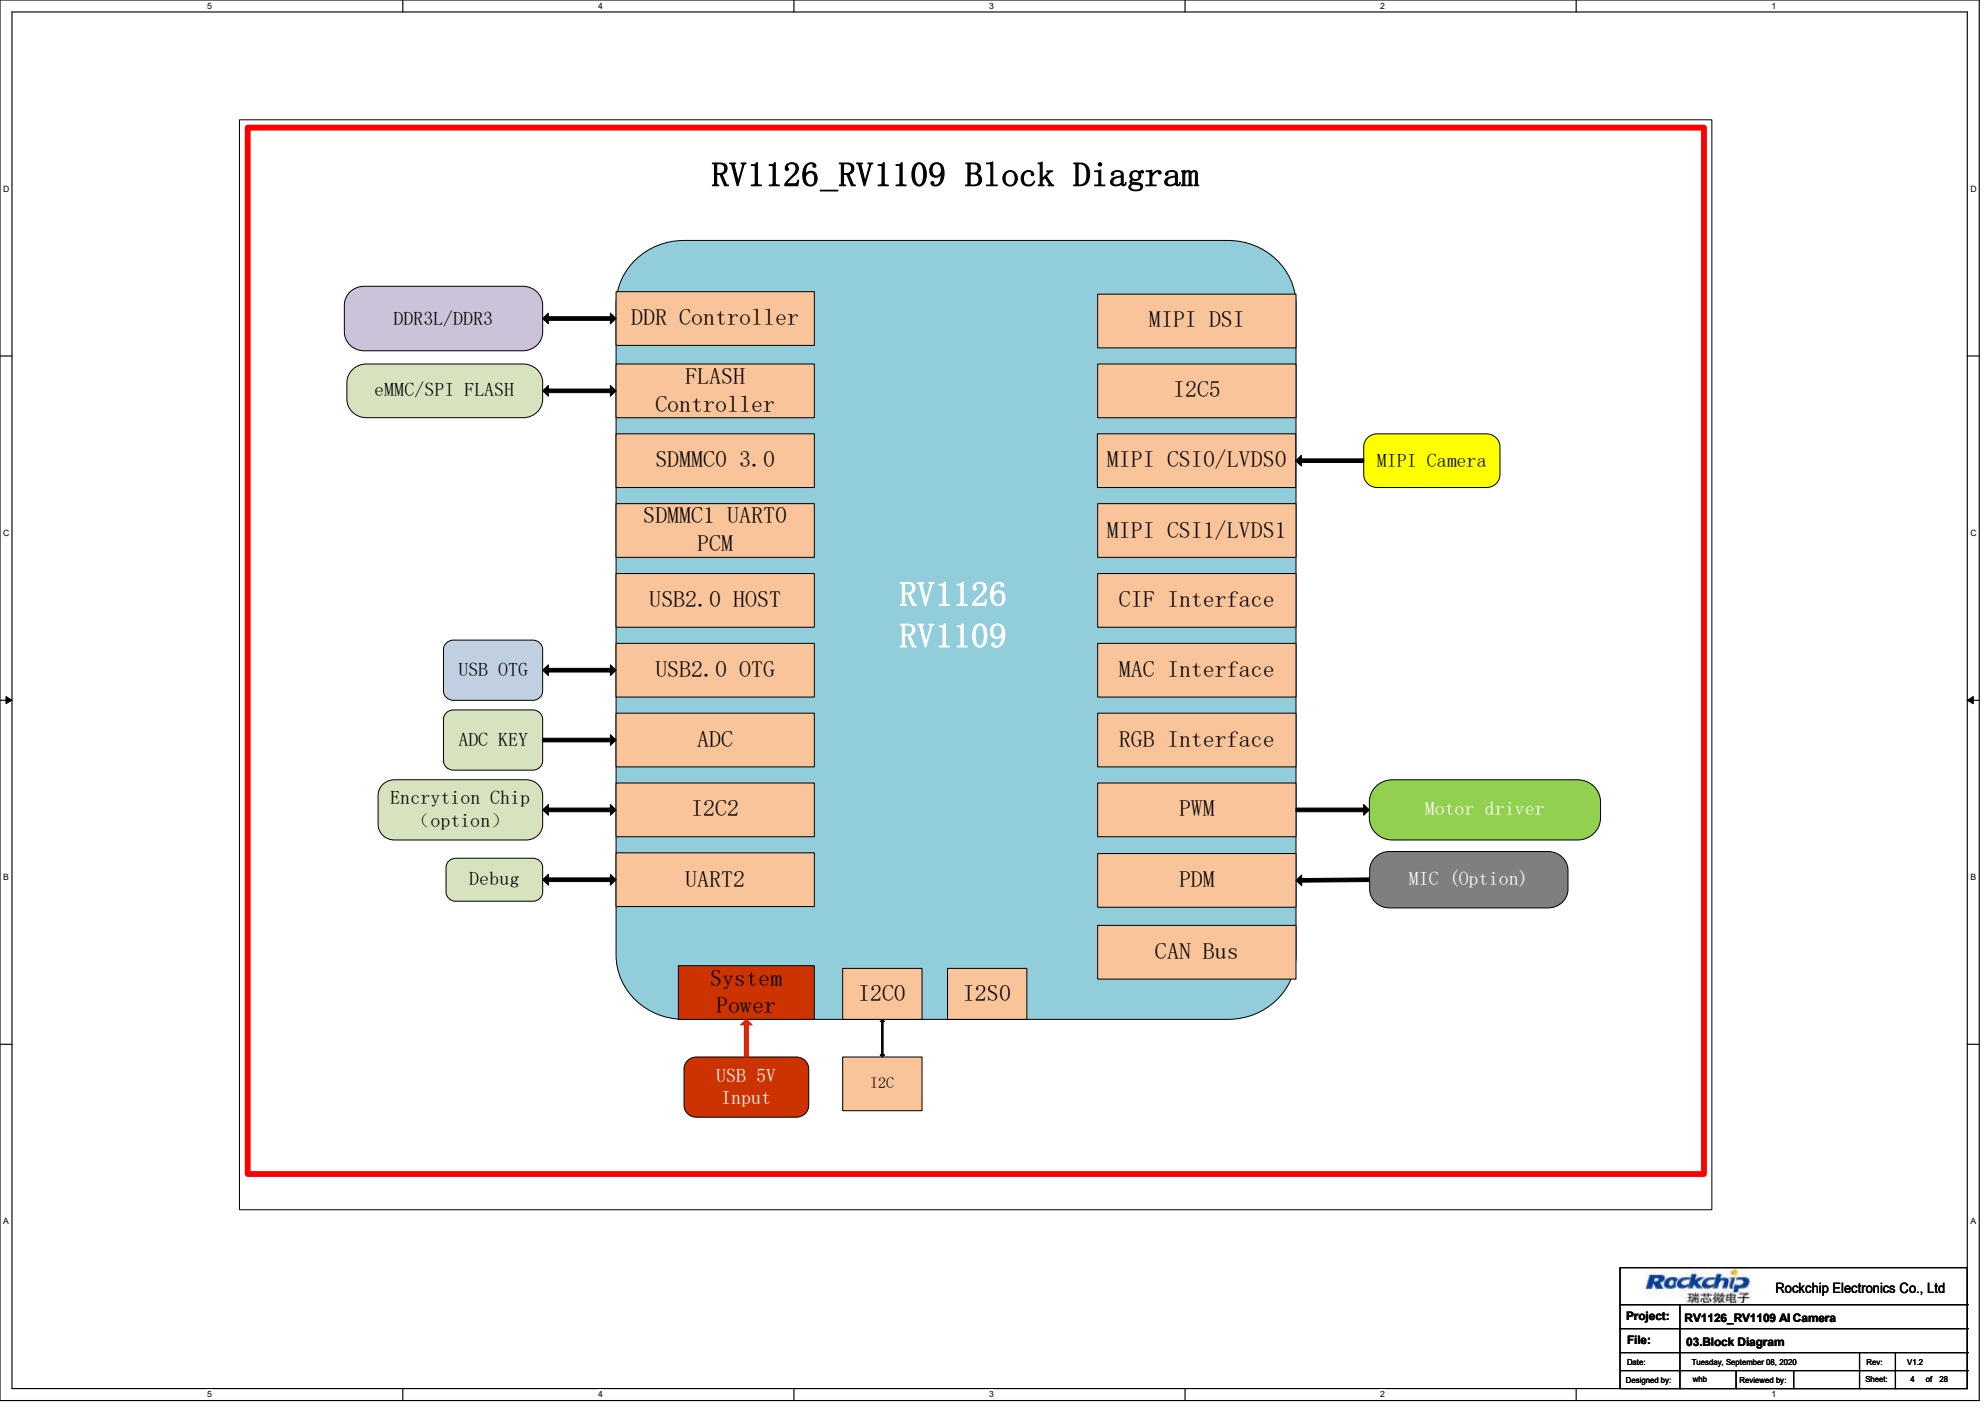
[picture p63: page 4]
FLASH; SDMMC0 3.0; SDMMC1 UART0 PCM; USB2.0 HOST; USB OTG; USB2.0 OTG; ADC KEY; ADC; CAN Bus; System Power; USB 5V Input; PDM; MIC (Option); RGB Interface; MIPI CSI0/LVDS0; MIPI Camera; MIPI CSI1/LVDS1; CIF Interface; UART2; Motor driver; MAC Interface; Debug; PWM; RV1126_RV1109 Block Diagram; Encrytion Chip （option）; Project:; 03.Block Diagram; whb

Controller eMMC/SPI FLASH

Rockchip Electronics Co., Ltd

# Power Diagram

## VDD_ARM

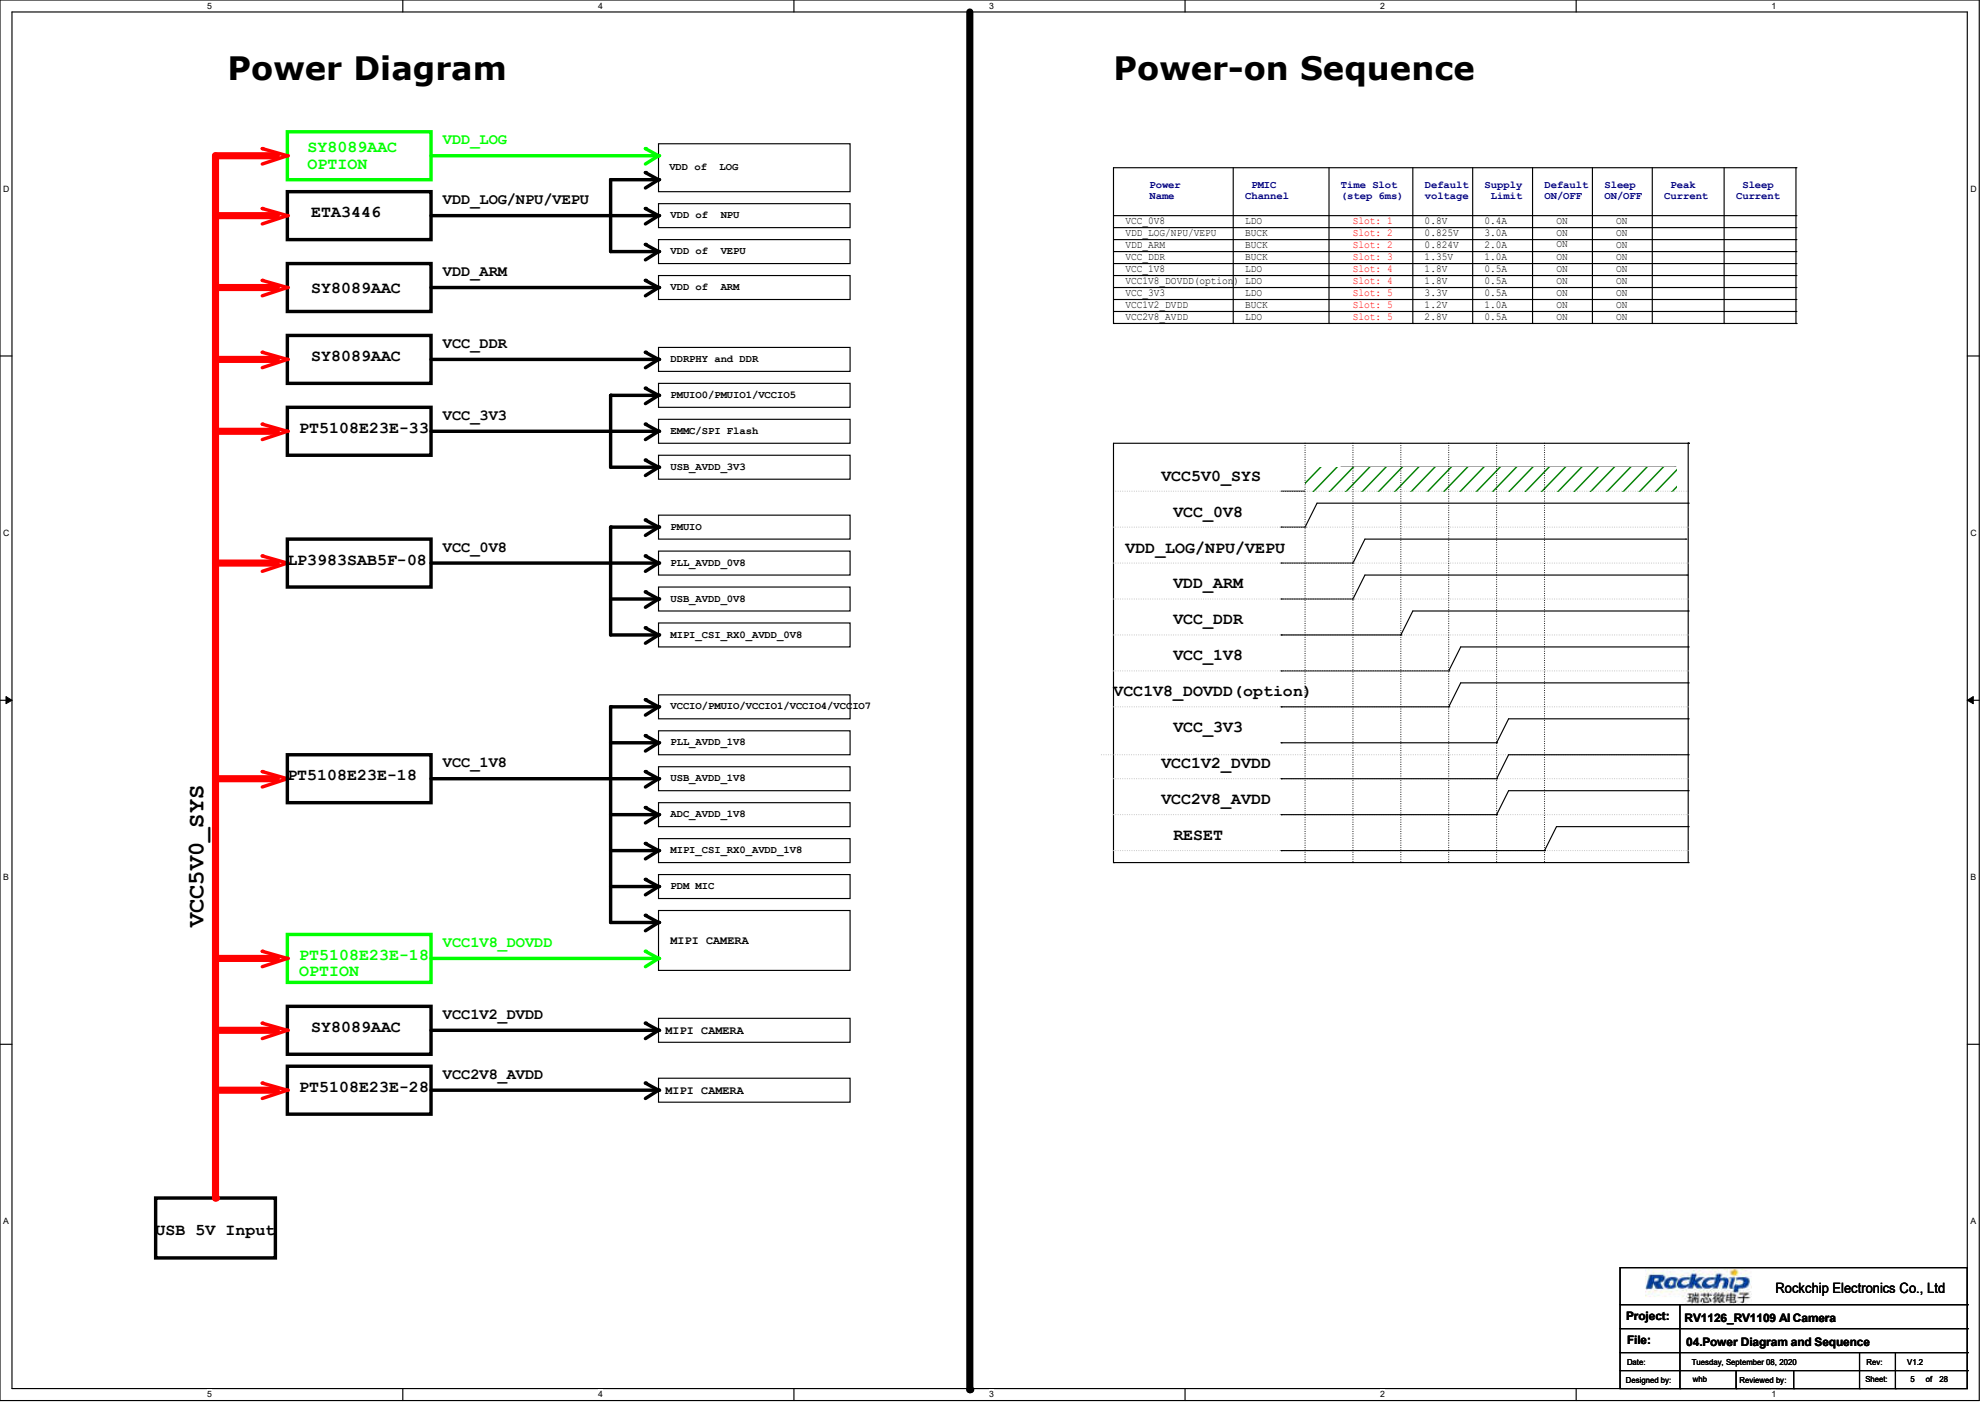
[picture p64: page 5]
USB 5V Input VCC5V0_SYS; VDD of; NPU; VDD_LOG/NPU/VEPU; ARM; SY8089AAC; LP3983SAB5F-08; ETA3446; LOG; VEPU; VCC_3V3; VCC_DDR; PMUIO0/PMUIO1/VCCIO5; VCC_0V8; VCC_1V8; USB_AVDD_3V3; USB_AVDD_0V8; PLL_AVDD_1V8; PLL_AVDD_0V8; PMUIO; MIPI_CSI_RX0_AVDD_1V8; MIPI_CSI_RX0_AVDD_0V8; VCCIO/PMUIO/VCCIO1/VCCIO4/VCCIO7; MIPI CAMERA; USB_AVDD_1V8; ADC_AVDD_1V8; VCC1V2_DVDD; PT5108E23E-28 VCC2V8_AVDD; PDM MIC; VDD_LOG SY8089AAC; OPTION; PT5108E23E-18 OPTION; VCC1V8_DOVDD; Project:; whb

Power-on Sequence

Power Name | PMIC Channel | Time Slot (step 6ms) | Default voltage | Supply Limit | Default ON/OFF | Sleep ON/OFF | Peak Current | Sleep Current

VCC_0V8 | LDO | Slot: 1 | 0.8V | 0.4A | ON | ON
VDD_LOG/NPU/VEPU | BUCK | Slot: 2 | 0.825V | 3.0A | ON | ON
VDD_ARM | BUCK | Slot: 2 | 0.824V | 2.0A | ON | ON
VCC_DDR | BUCK | Slot: 3 | 1.35V | 1.0A | ON | ON
VCC_1V8 | LDO | Slot: 4 | 1.8V | 0.5A | ON | ON
VCC1V8_DOVDD(option) LDO | | Slot: 4 | 1.8V | 0.5A | ON | ON
VCC_3V3 | LDO | Slot: 5 | 3.3V | 0.5A | ON | ON
VCC1V2_DVDD | BUCK | Slot: 5 | 1.2V | 1.0A | ON | ON
VCC2V8_AVDD | LDO | Slot: 5 | 2.8V | 0.5A | ON | ON

DDRPHY and DDR

EMMC/SPI Flash

VCC5V0_SYS

VCC_0V8

VDD_LOG/NPU/VEPU

VDD_ARM

VCC_DDR

VCC_1V8

VCC1V8_DOVDD(option)

VCC2V8_AVDD

RESET

Rockchip Electronics Co., Ltd

04.Power Diagram and Sequence

D | D

RV1126

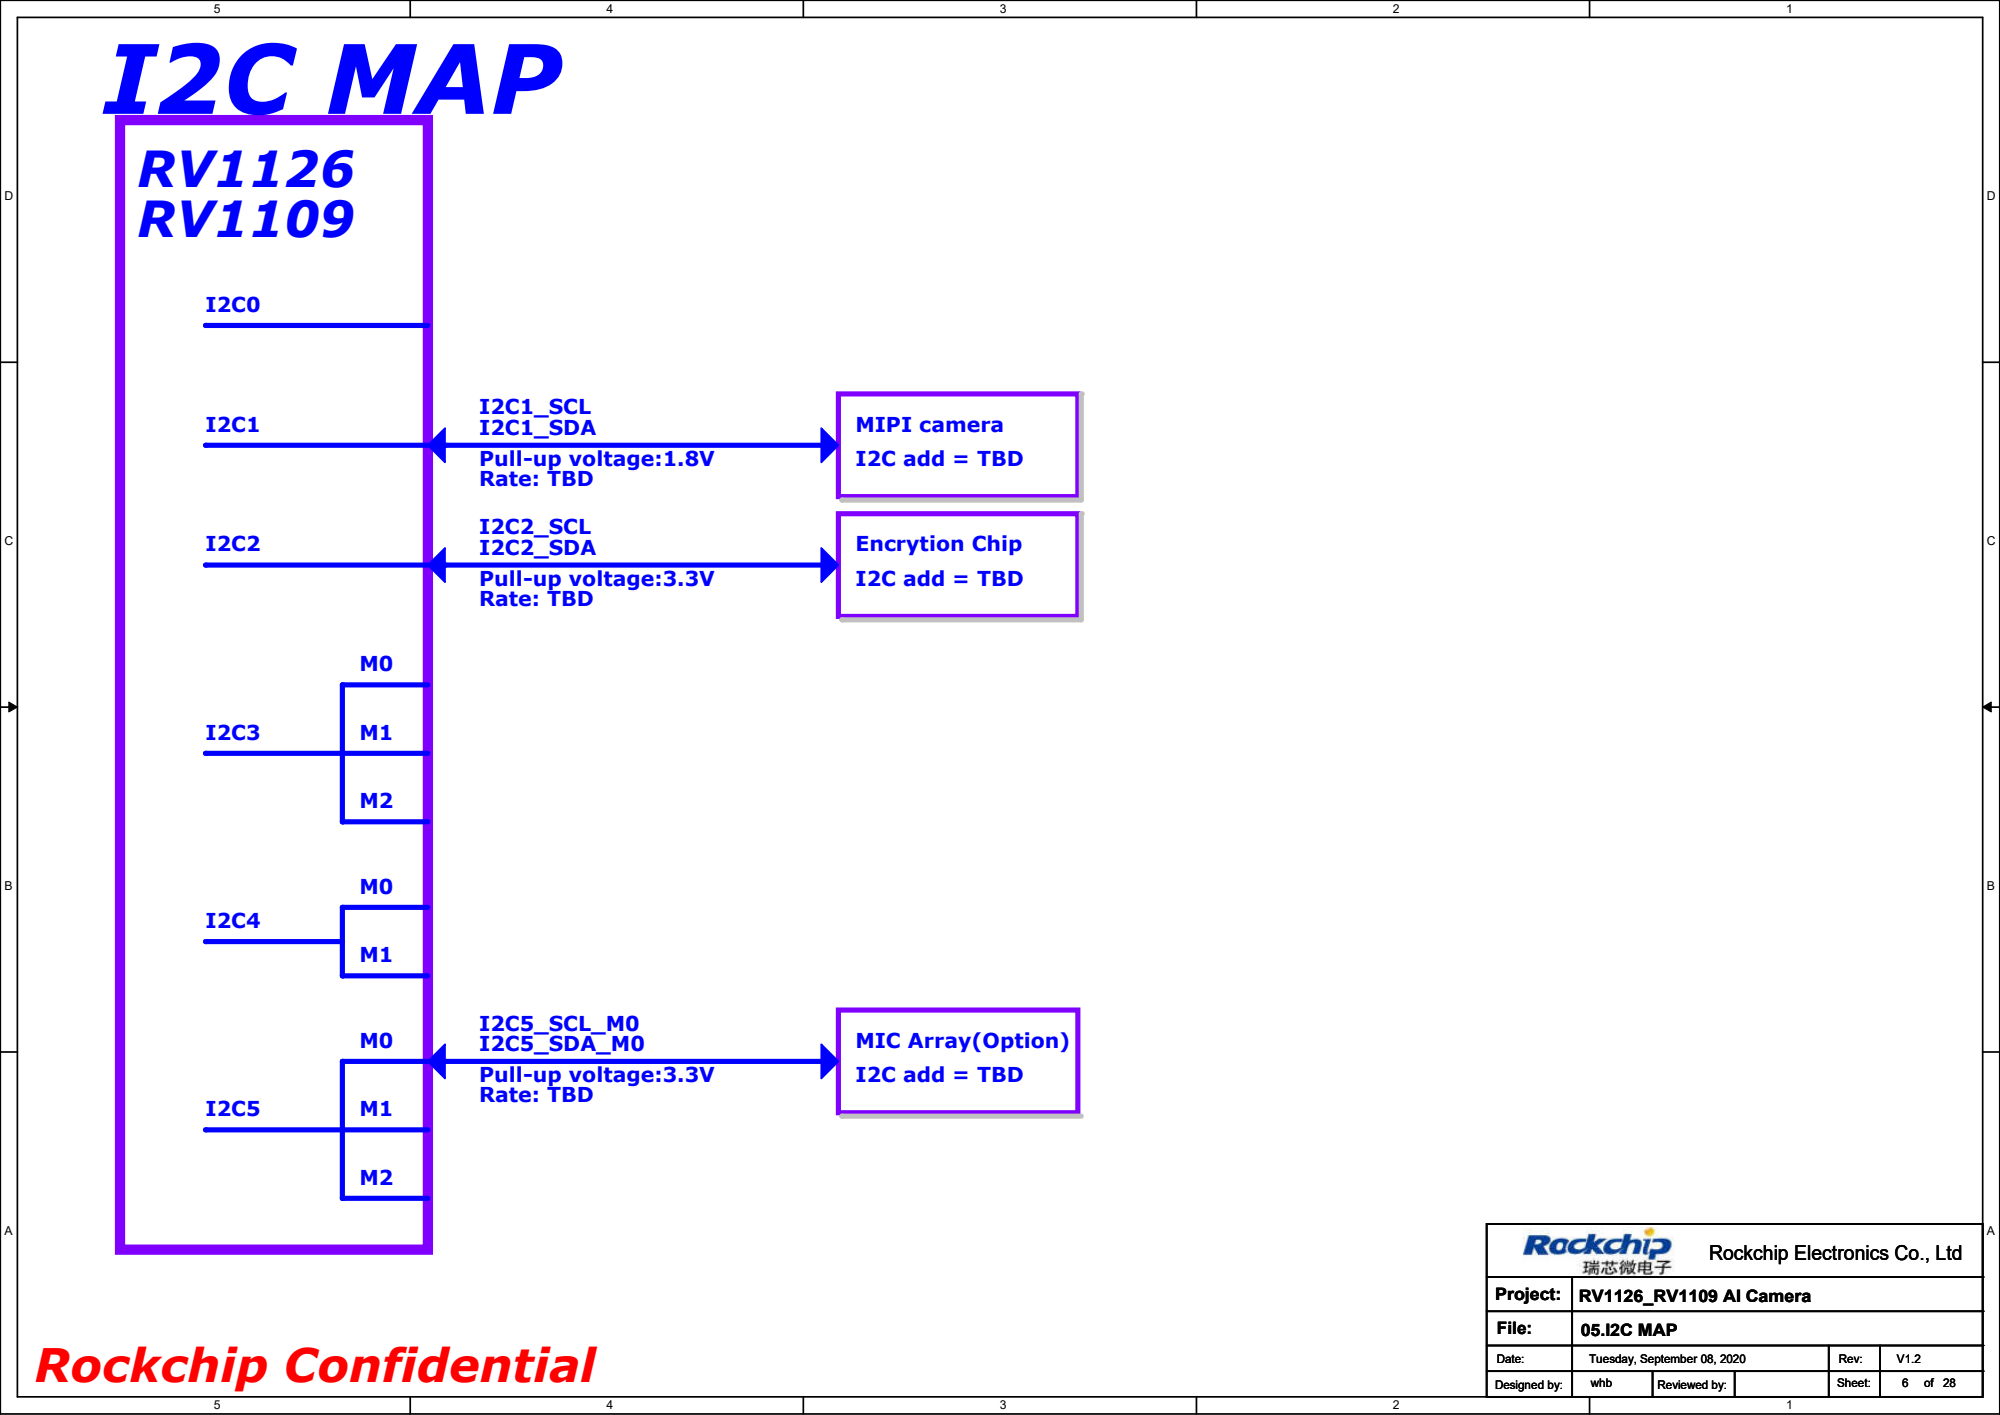
[picture p65: page 6]
Rockchip Confidential; MIPI camera; I2C add = TBD; I2C MAP; I2C1_SCL I2C1_SDA; Pull-up voltage:1.8V Rate: TBD; I2C5_SCL_M0 I2C5_SDA_M0; Pull-up voltage:3.3V Rate: TBD; Encrytion Chip; I2C2_SCL I2C2_SDA; Project:; 05.I2C MAP; whb

MIC Array(Option)
I2C add = TBD

Rockchip Electronics Co., Ltd

D | D

# IO Power Domain Map

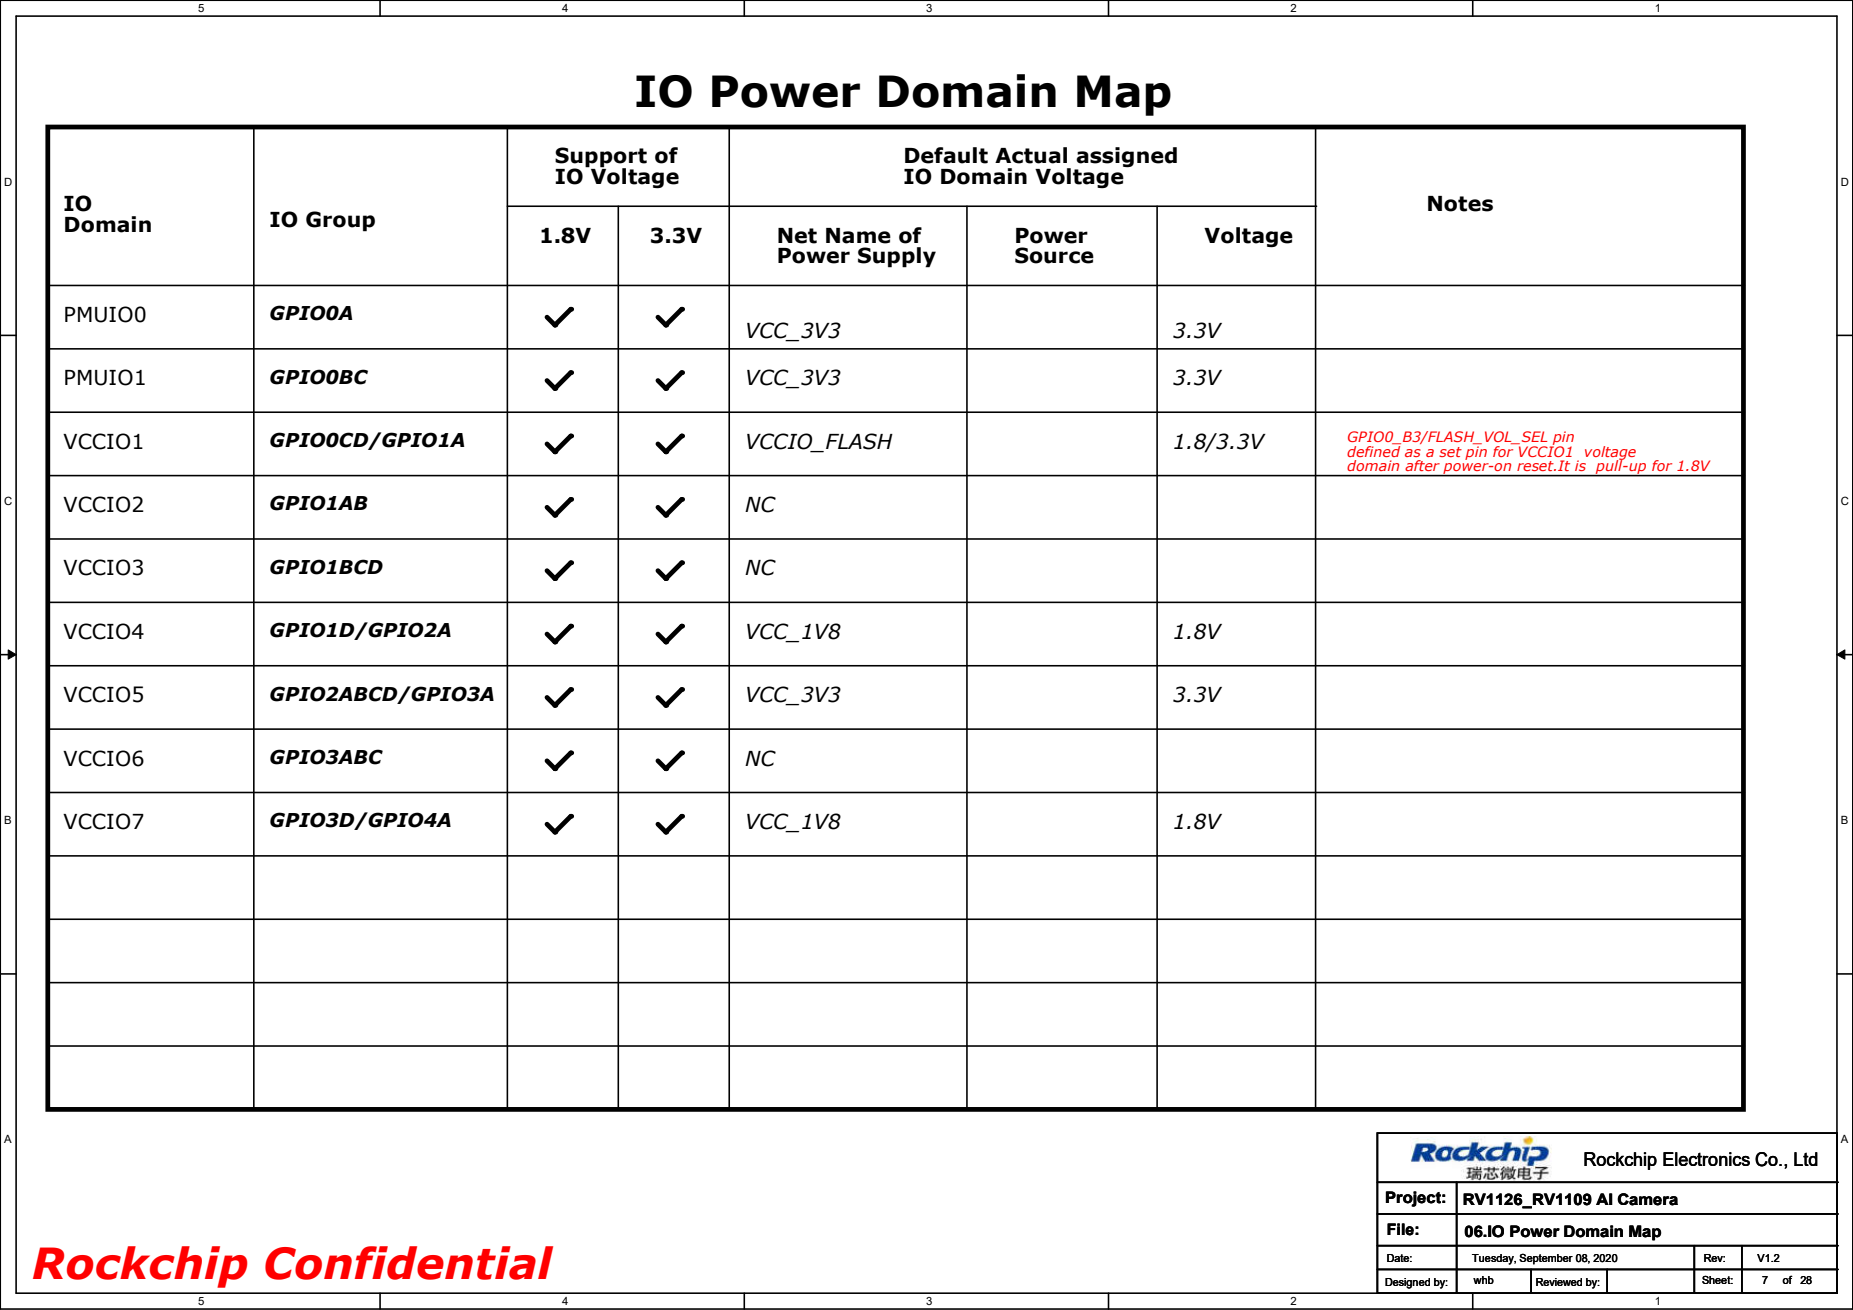
[picture p66: page 7]
Rockchip Confidential; Domain; IO Group; Support of IO Voltage; Notes; PMUIO0; Voltage; PMUIO1; VCCIO2; VCCIO1; VCCIO_FLASH; VCCIO7; VCCIO4; VCC_1V8; VCCIO3; VCCIO6; VCCIO5; GPIO0A; GPIO0BC; GPIO0CD/GPIO1A; GPIO1AB; GPIO3D/GPIO4A; GPIO1BCD; GPIO1D/GPIO2A; GPIO2ABCD/GPIO3A; GPIO3ABC; Power Source; VCC_3V3; Project:; whb

Default Actual assigned
IO Domain Voltage

Net Name of
Power Supply

GPIO0_B3/FLASH_VOL_SEL pin
defined as a set pin for VCCIO1 voltage
domain after power-on reset.It is pull-up for 1.8V

Rockchip Electronics Co., Ltd

06.IO Power Domain Map

55

44

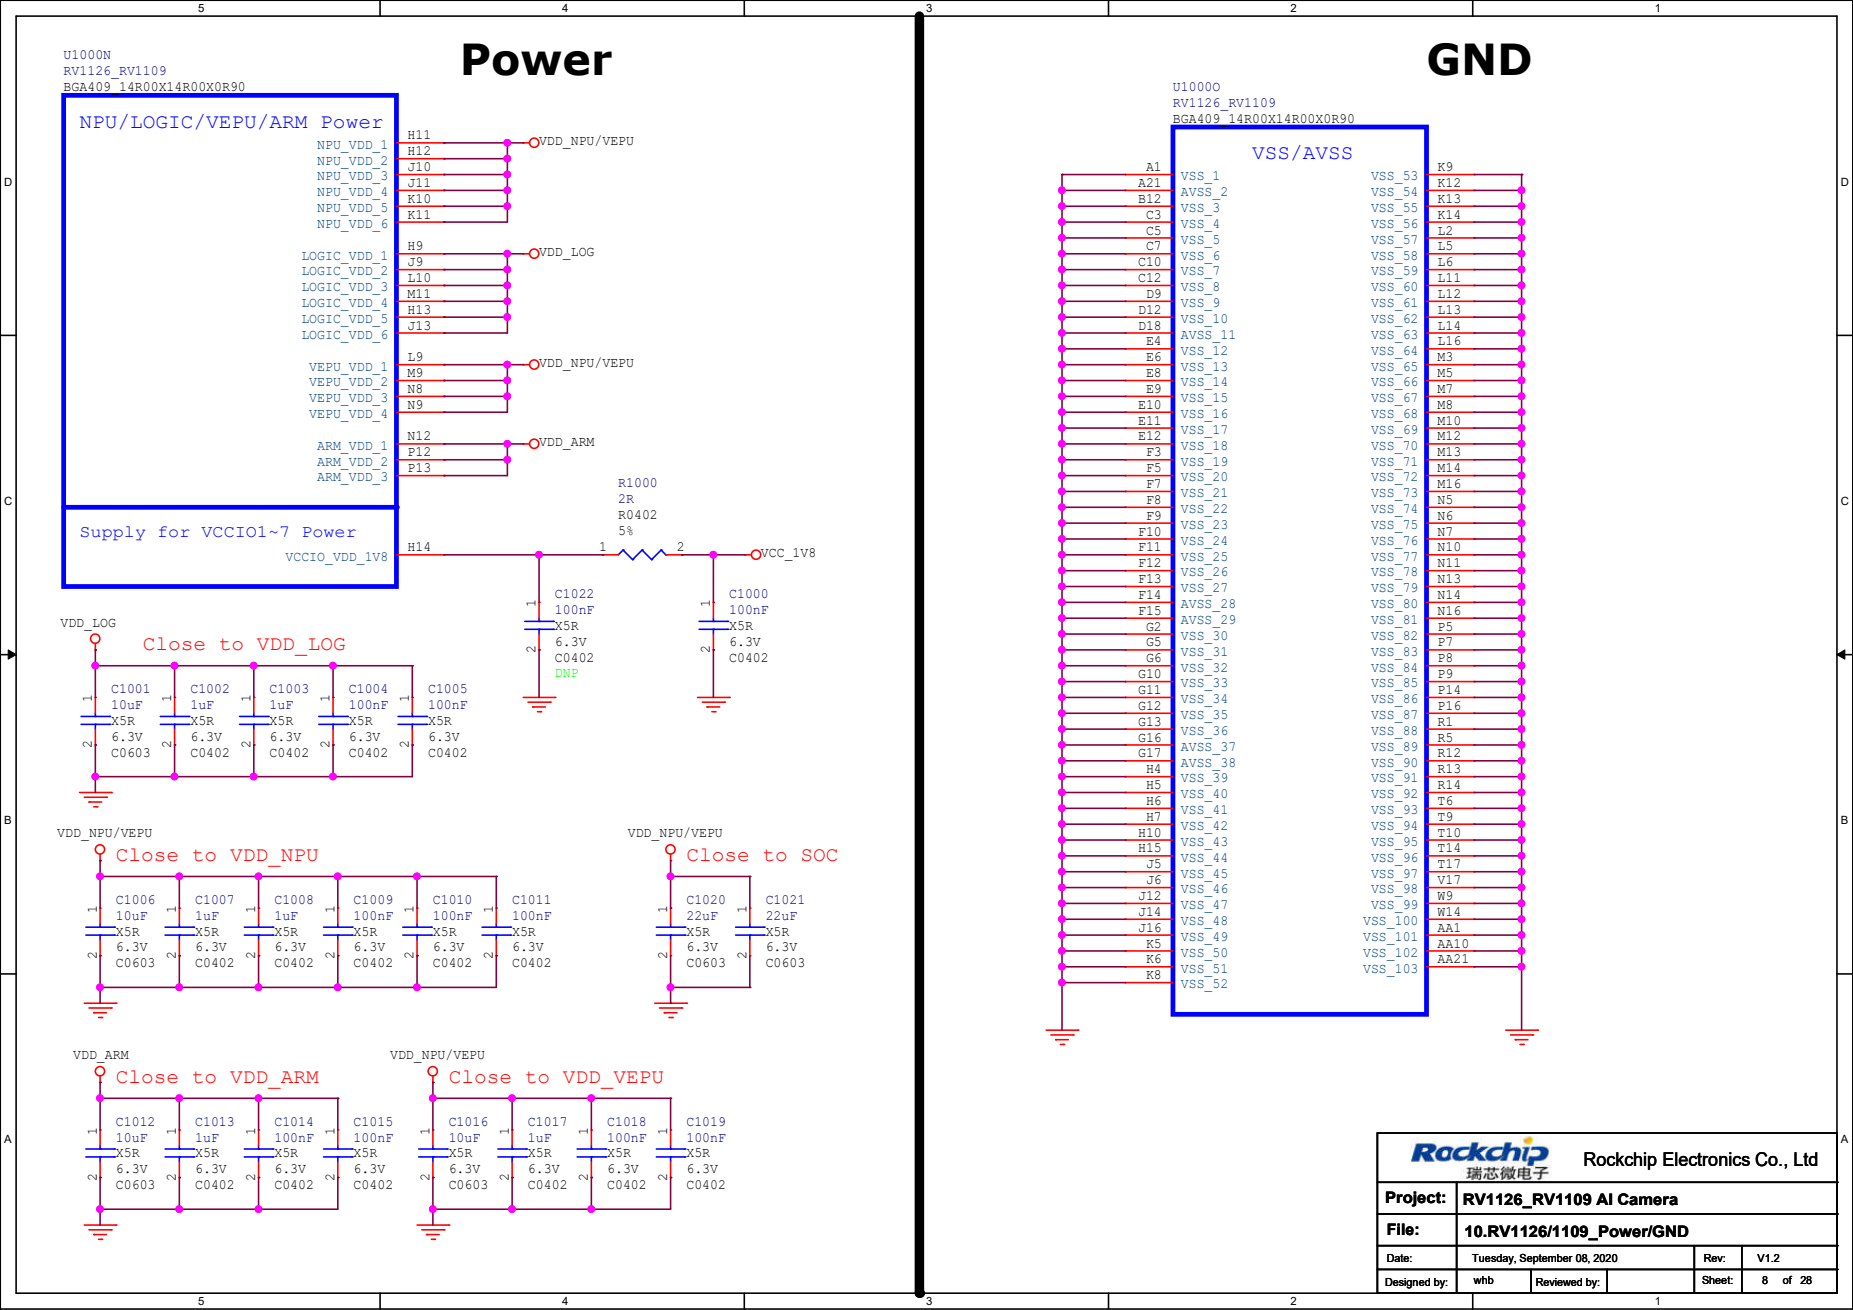
[picture p67: page 8]

Rockchip Electronics Co., Ltd

D | D

# OSC/PLL/PMUIO

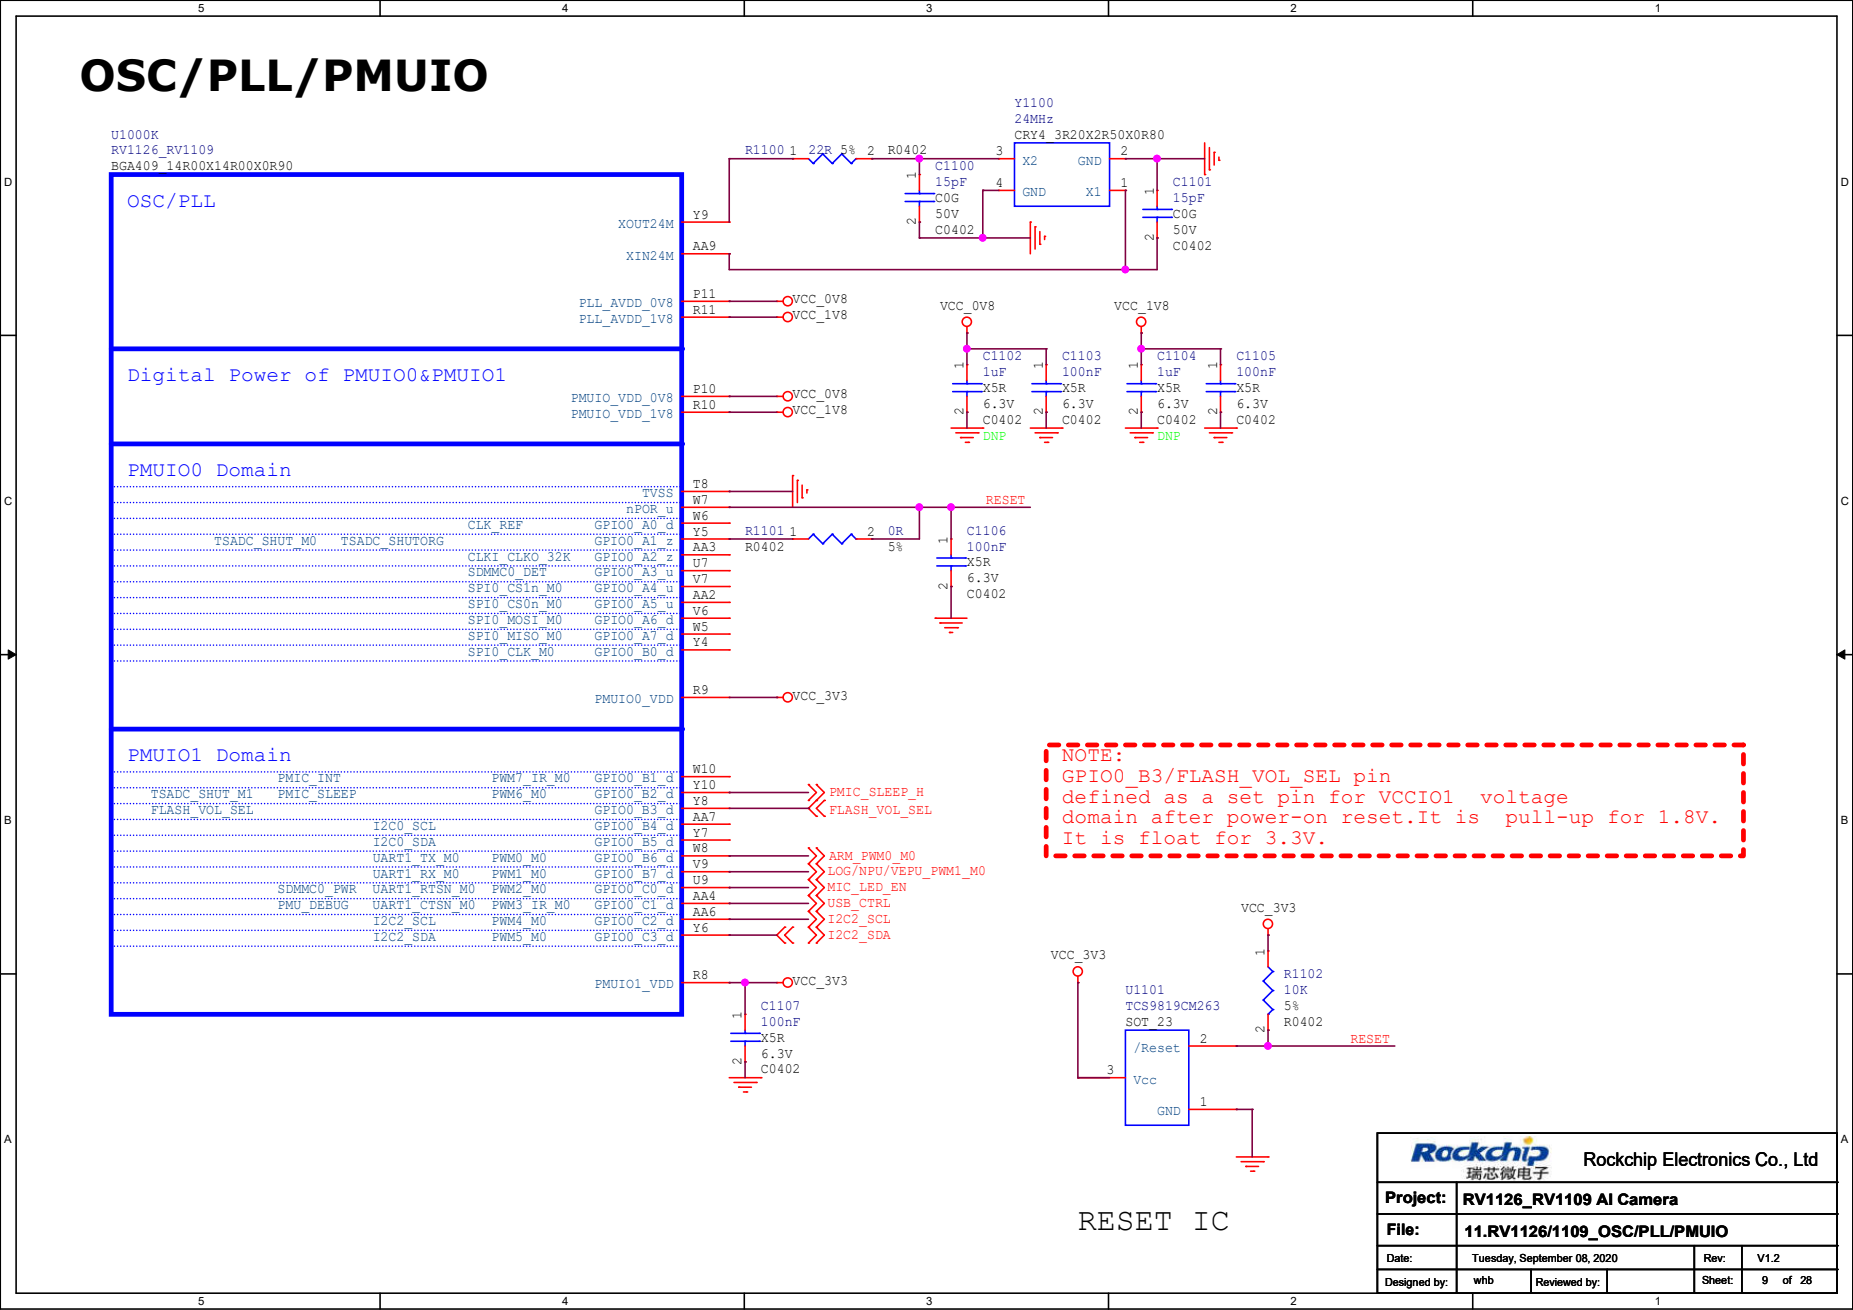
[picture p68: page 9]

NOTE:
GPIO0_B3/FLASH_VOL_SEL pin
It is float for 3.3V.

Rockchip Electronics Co., Ltd

# DDR Controller

## DDR

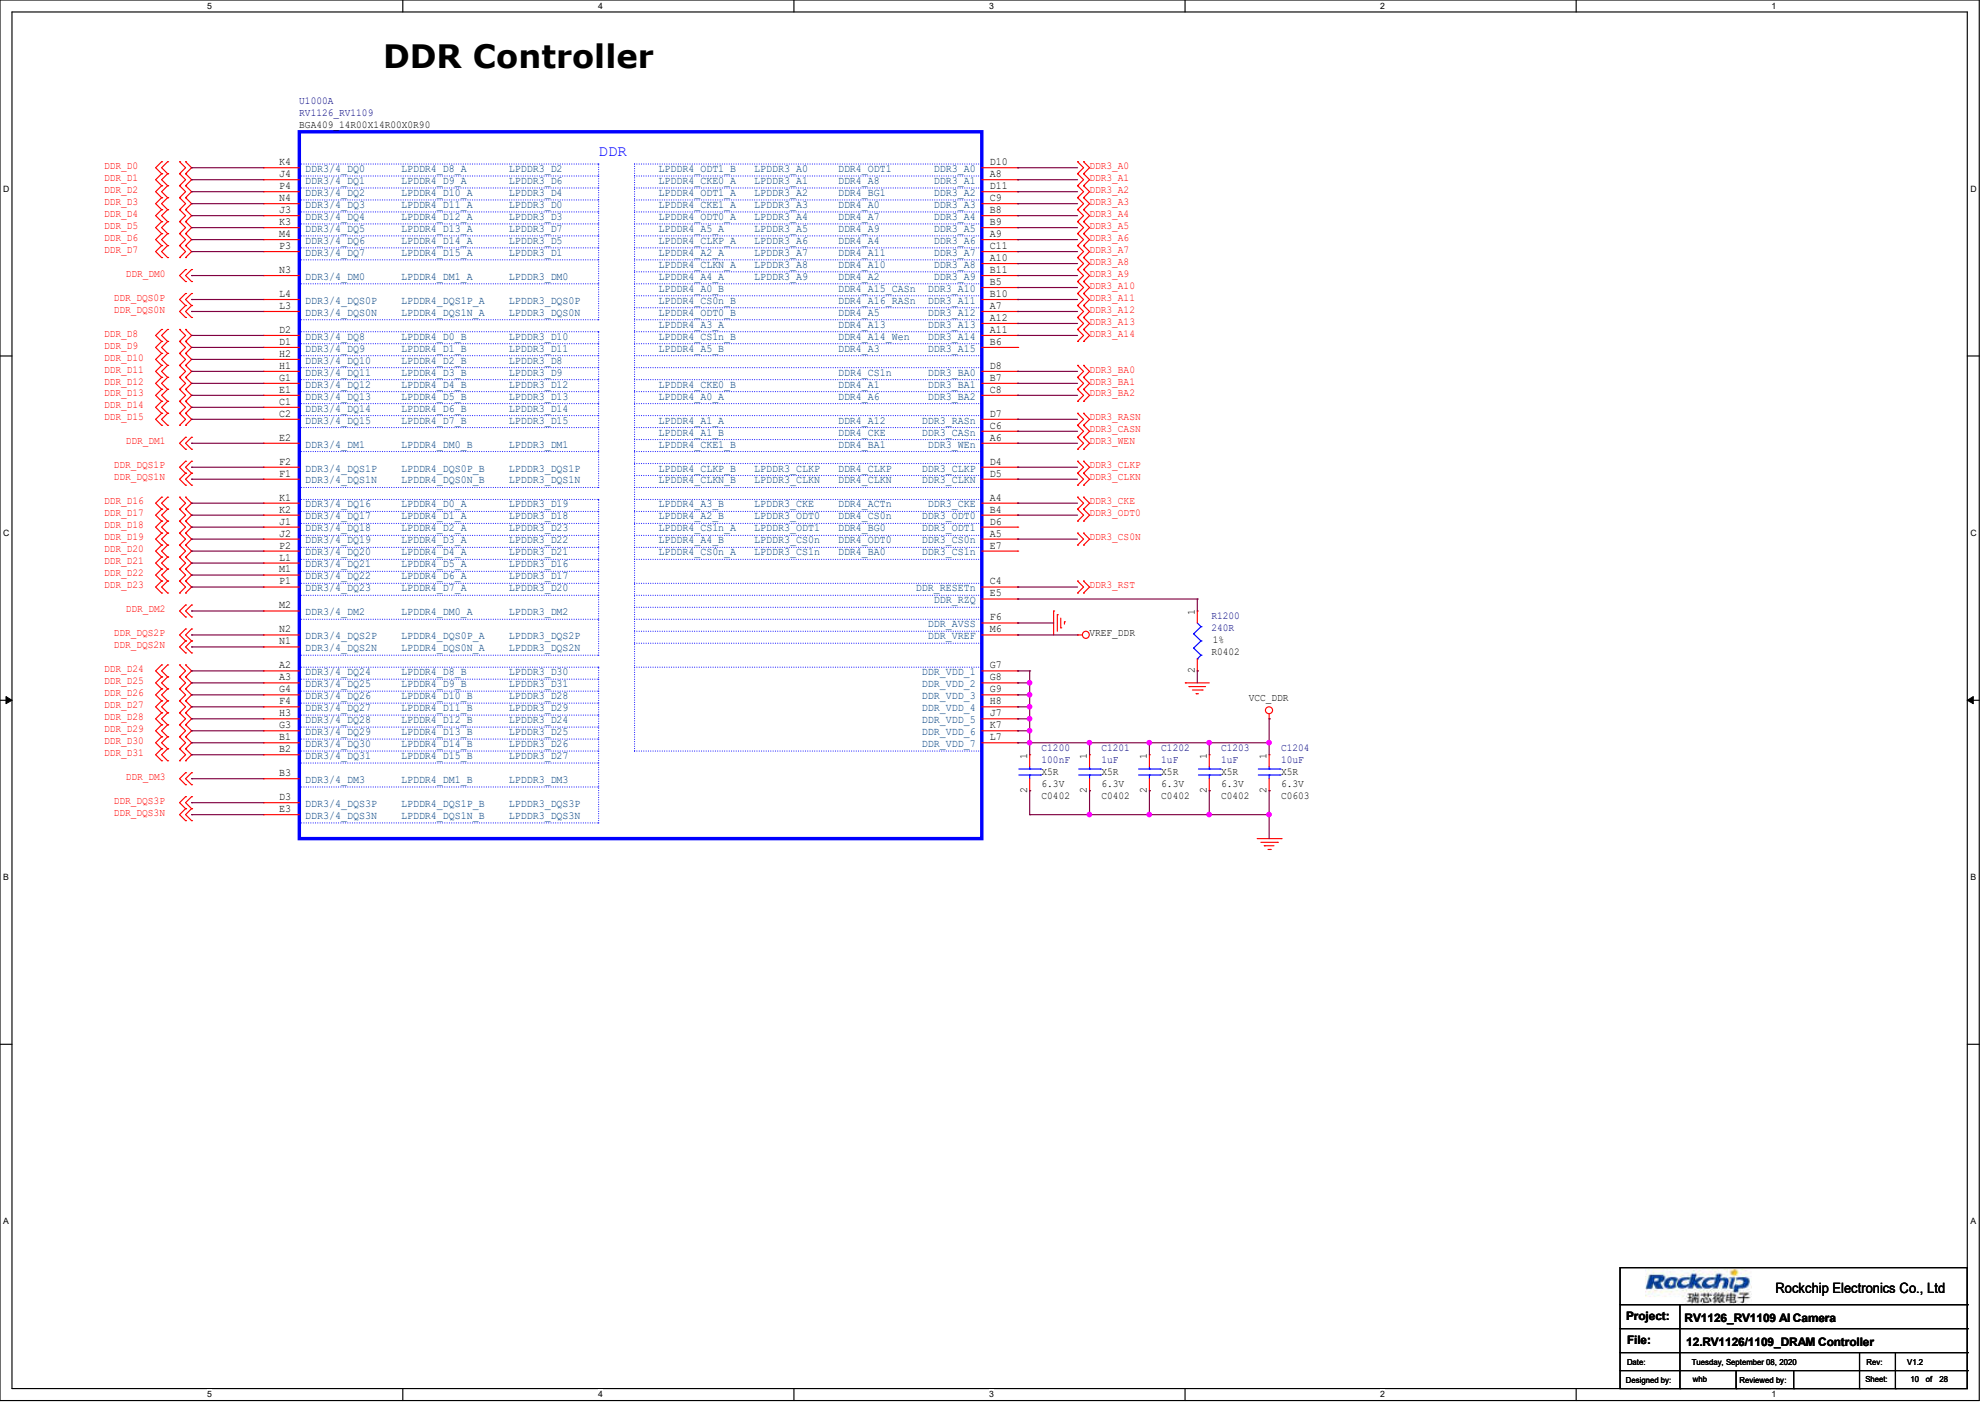
[picture p69: page 10]

Rockchip Electronics Co., Ltd

EMMC/FLASH | SDMMC0/JTAG

## I2S1/FSPI/EMMC/FLASH

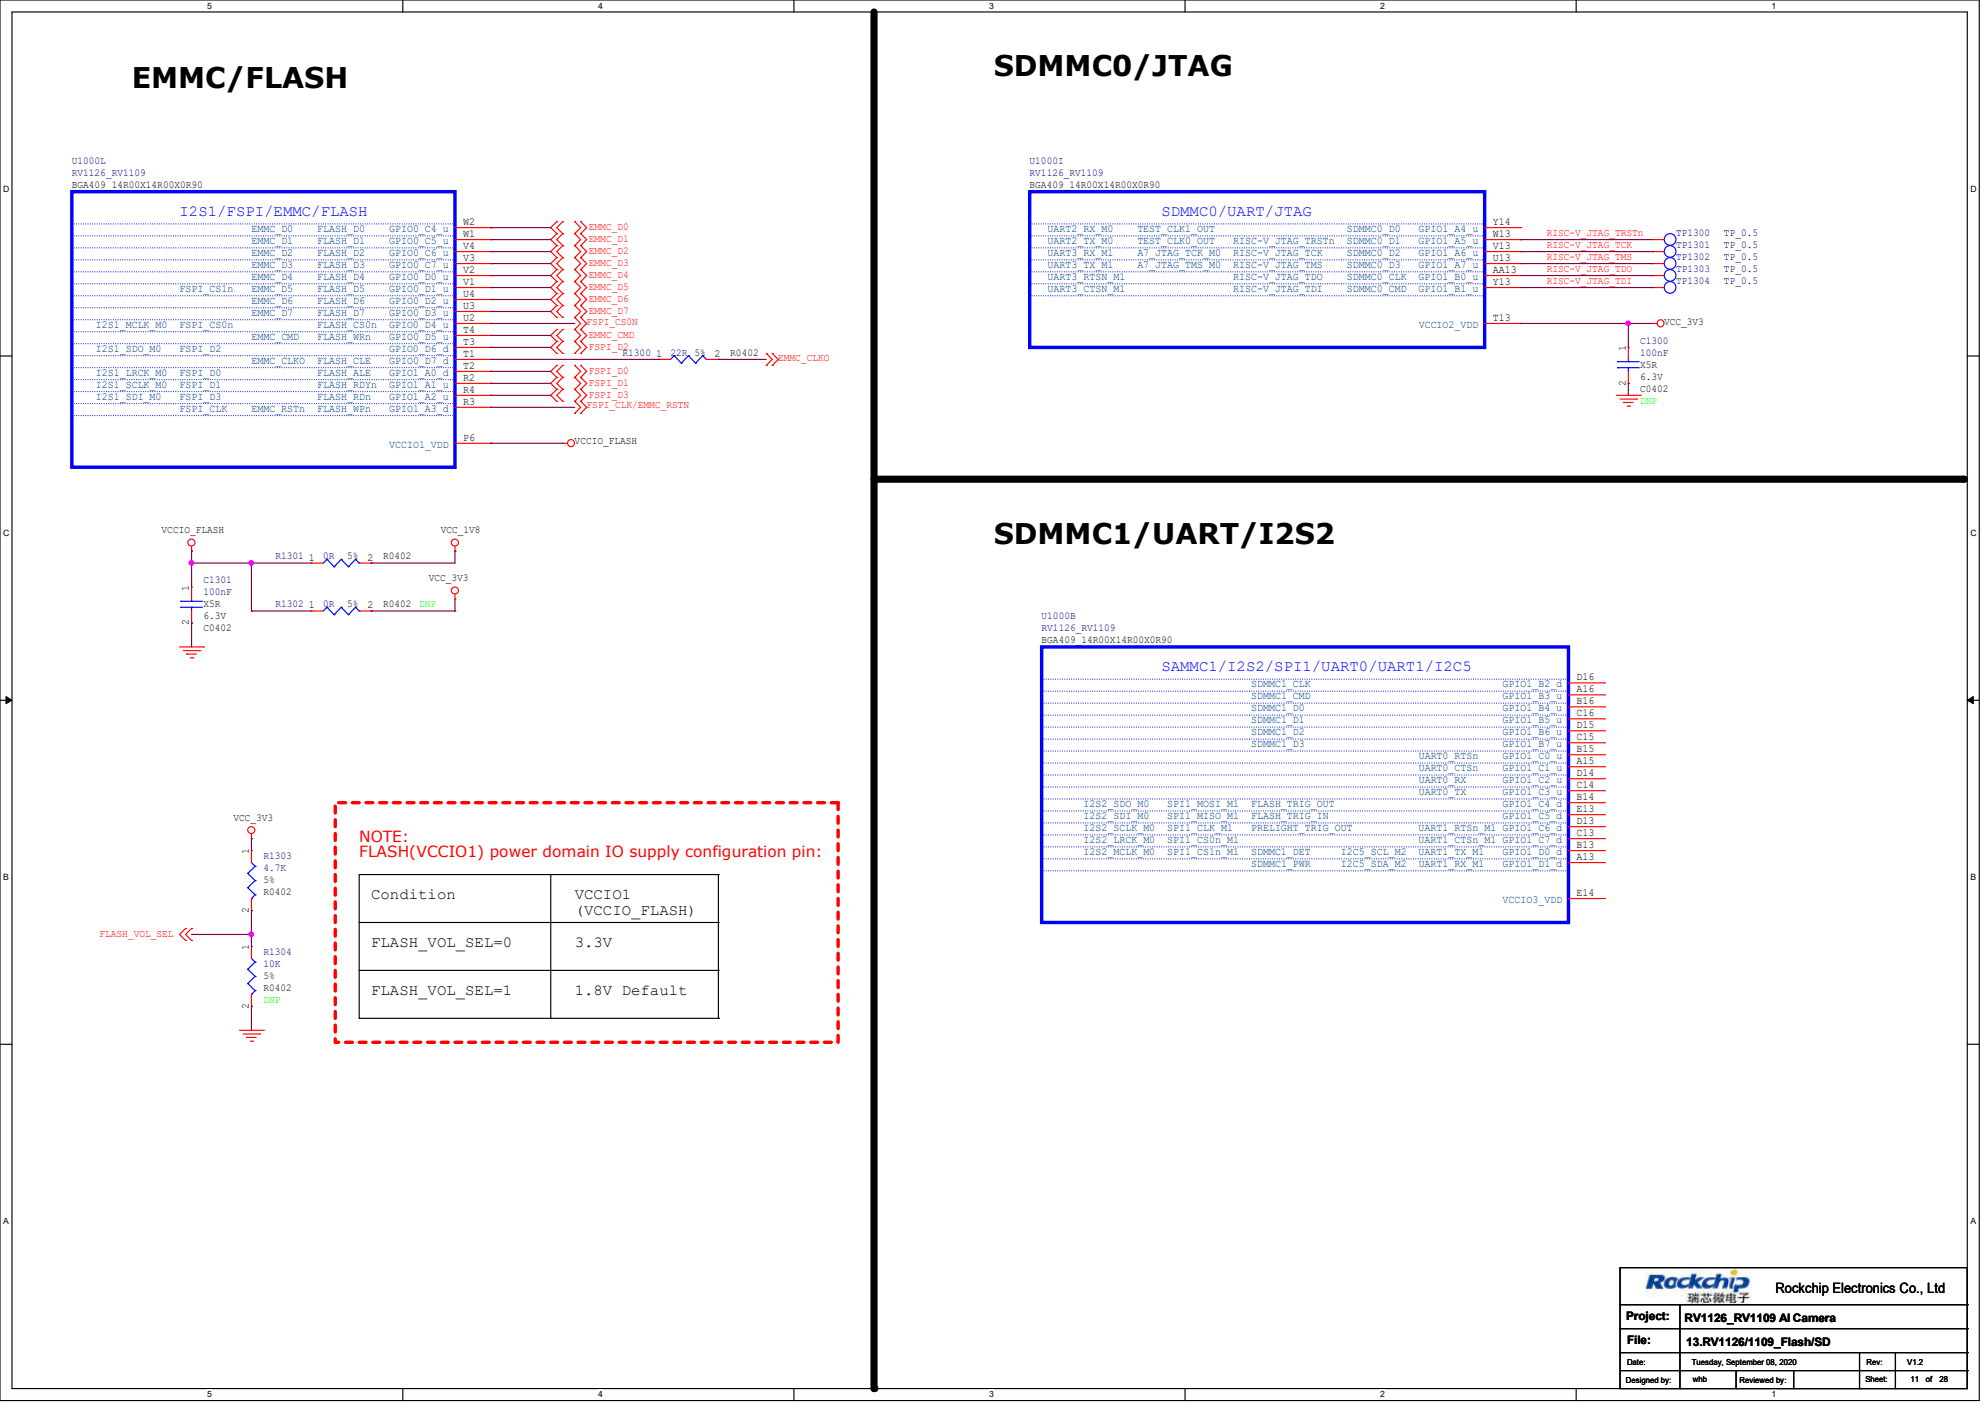
[picture p70: page 11]

NOTE:
FLASH(VCCIO1) power domain IO supply configuration pin:

Condition | VCCIO1 (VCCIO_FLASH)

FLASH_VOL_SEL=0 | 3.3V

FLASH_VOL_SEL=1 | 1.8V Default

Rockchip Electronics Co., Ltd

D | D

# USB Controller

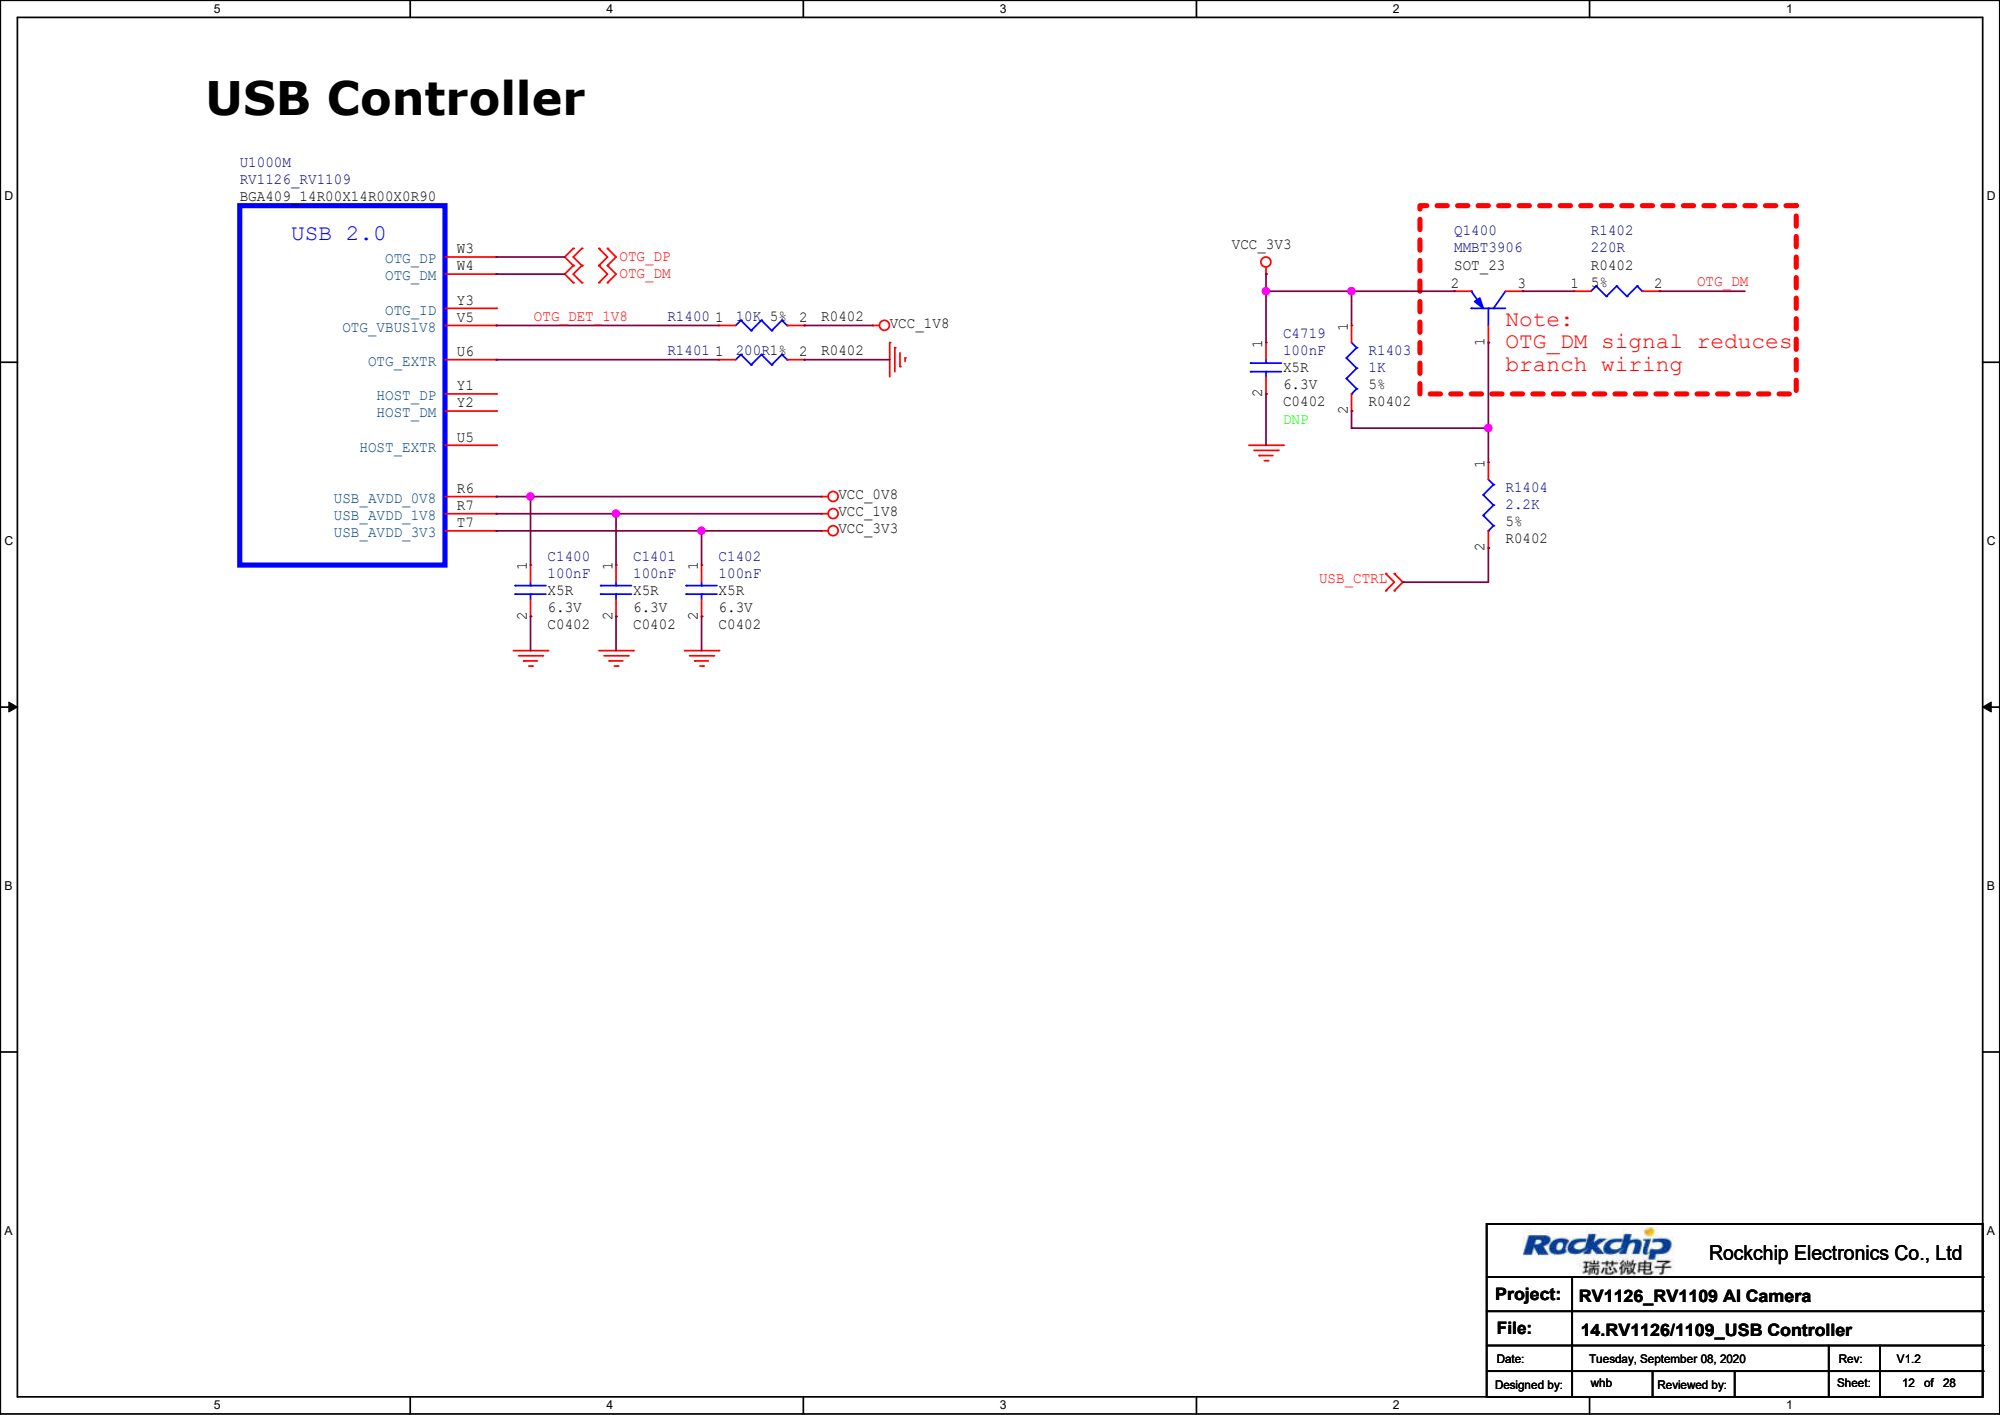
[picture p71: page 12]

Rockchip Electronics Co., Ltd

D | D
SARADC | Note:

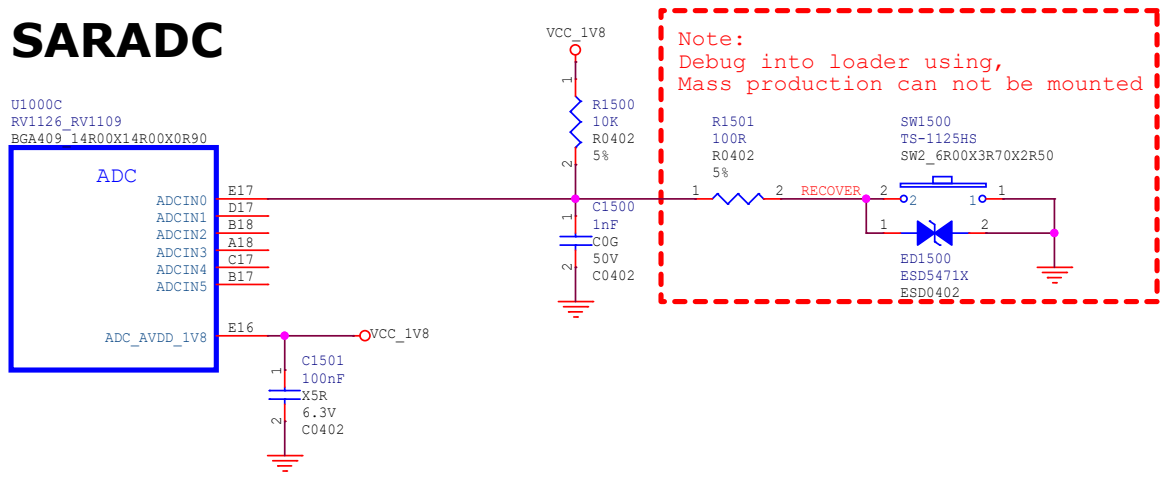
[picture p72: page 13]

Debug into loader using,
Mass production can not be mounted

Rockchip Electronics Co., Ltd

# CIF Interface I2C/SPI/MIPI-CLK

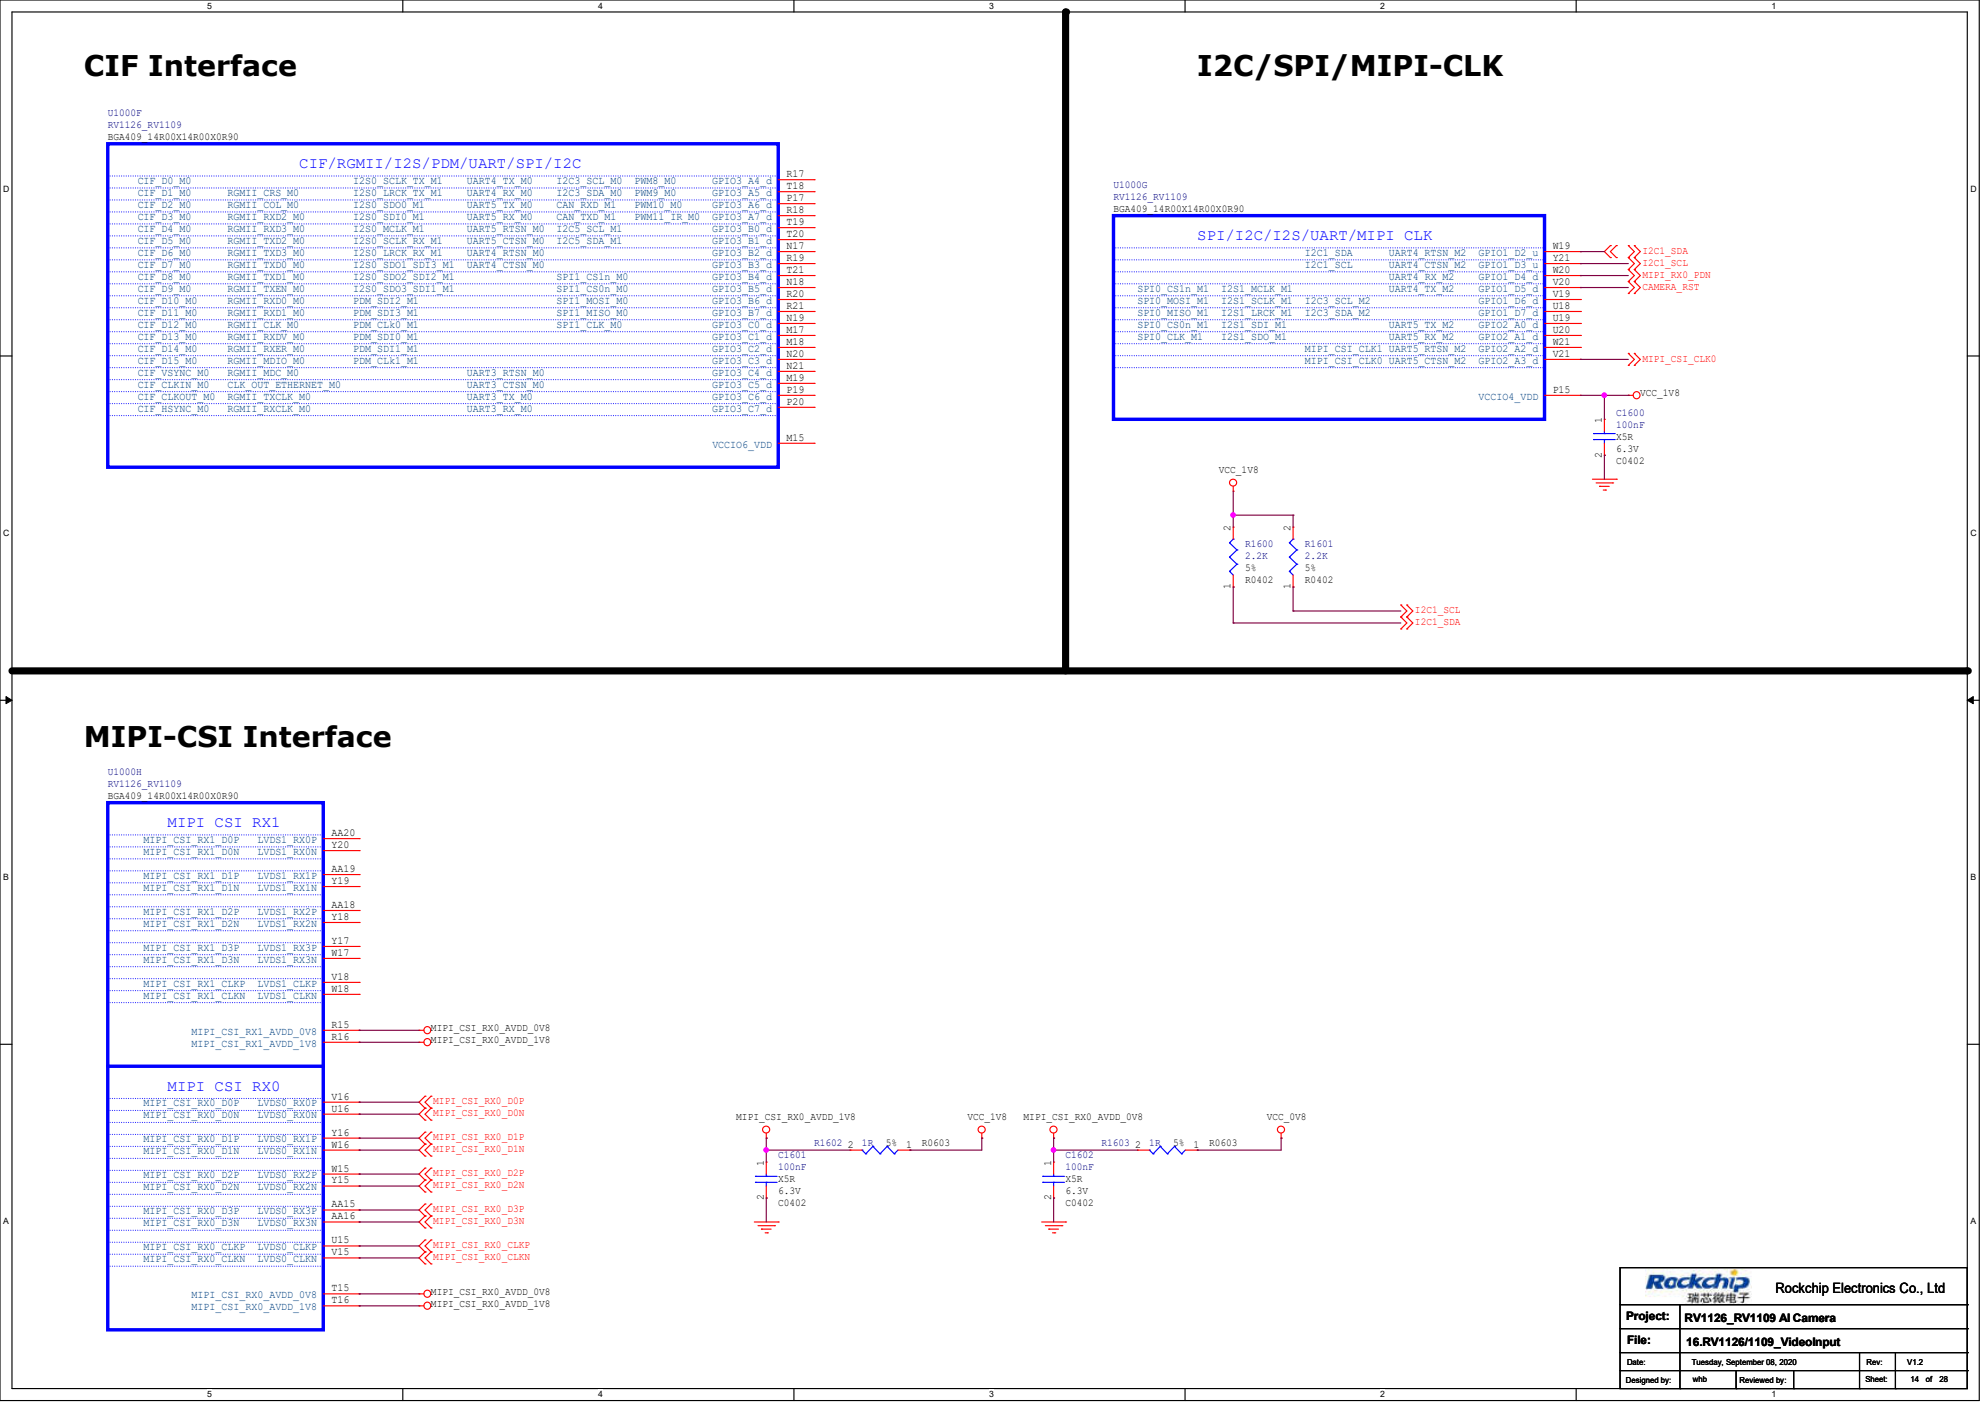
[picture p73: page 14]

CIF/RGMII/I2S/PDM/UART/SPI/I2C

SPI/I2C/I2S/UART/MIPI CLK

Rockchip Electronics Co., Ltd

D | D
C | C
B | B
A | A

# LCDC/RGMII/PWM

# MIPI-DSI Interface

## VCC_3V3

## VCC_3V3

## UART2_TX UART2_RX

## Mot_AEN/nEN_PWM6_M1 Mot_BEN/STEP_PWM10_M1 Mot_BPH/DIR_PWM9_M1 Mot_APH/M0_PWM8_M1

## Mot_EN_H

## I2C5_SCL_M0

## I2C5_SDA_M0

## CAM_EN

## Mot_state/M1

## Mot_nFAULT

# Project:

# Rockchip Electronics Co., Ltd

# 17.RV1126/1109_VideoOutput

whb | 15 | 28

# Project:

# Rockchip Electronics Co., Ltd

# 17.RV1126/1109_VideoOutput

whb | 15 | 28

# Project:

# Rockchip Electronics Co., Ltd

# 17.RV1126/1109_VideoOutput

whb | 15 | 28

C1700
100nF

C0402

X5R
6.3V

1 2

## LED1700 LED_RED

## LED0603 R1700 1 510R5% 2 R0402

# MIPI DSI TX0

U1000D

## RV1126_RV1109 BGA409_14R00X14R00X0R90

MIPI_DSI_TX0_D0N | B19 MIPI_DSI_TX0_D0P | A19
MIPI_DSI_TX0_D1N | B20 MIPI_DSI_TX0_D1P | A20
MIPI_DSI_TX0_D2N | C20 MIPI_DSI_TX0_D2P | B21
MIPI_DSI_TX0_D3N | D19 MIPI_DSI_TX0_D3P | D20
MIPI_DSI_TX0_AVDD_0V8 | | E18
MIPI_DSI_TX0_AVDD_1V8 | | G15
MIPI_DSI_TX0_CLKN | C18 MIPI_DSI_TX0_CLKP | C19

# LCDC/RGMII/CIF/UART/JTAG/I2S/SPI/I2C

U1000E

## RV1126_RV1109 BGA409_14R00X14R00X0R90

| | UART4_RTSN_M1 | | RGMII_TXD3_M1 | CIF_D0_M1 | LCDC_D0 | GPIO2_A4_d | J18
I2C5_SCL_M0 | | UART4_CTSN_M1 | | RGMII_CRS_M1 | CIF_D1_M1 | LCDC_D1 | GPIO2_A5_d | L17
| | UART4_TX_M1 | PWM5_M1 | RGMII_COL_M1 | CIF_D2_M1 | LCDC_D2 | GPIO2_A6_d | M21
| I2S2_SDO_M1 | UART4_RX_M1 | PWM4_M1 | SPI0_CS0n_M2 | | LCDC_D3 | GPIO2_A7_d | M20
| I2S2_SDI_M1 | UART5_TX_M1 | PWM3_IR_M1 | SPI0_MOSI_M2 | | LCDC_D4 | GPIO2_B0_d | L19
| I2S2_SCLK_M1 | UART5_RX_M1 | PWM2_M1 | SPI0_MISO_M2 | | LCDC_D5 | GPIO2_B1_d | L20
| I2S2_LRCK_M1 | UART5_RTSN_M1 | PWM1_M1 | SPI0_CLK_M2 | | LCDC_D6 | GPIO2_B2_d | K16
I2C5_SDA_M0 | I2S2_MCLK_M1 | UART5_CTSN_M1 | PWM0_M1 | SPI0_CS1n_M2 | CIF_D3_M1 | LCDC_D7 | GPIO2_B3_d | K17
| | | | RGMII_RXDV_M1 | CIF_D4_M1 | LCDC_D8 | GPIO2_B4_d | K18
| | | | RGMII_RXD0_M1 | CIF_D5_M1 | LCDC_D9 | GPIO2_B5_d | K19
| | | | RGMII_RXD1_M1 | CIF_D6_M1 | LCDC_D10 | GPIO2_B6_d | K20
| | | | RGMII_CLK_M1 | CIF_D7_M1 | LCDC_D11 | GPIO2_B7_d | K21
| | | | RGMII_RXER_M1 | CIF_D8_M1 | LCDC_D12 | GPIO2_C0_d | J19
| | | | RGMII_MDIO_M1 | CIF_D9_M1 | LCDC_D13 | GPIO2_C1_d | J21
| | | | RGMII_MDC_M1 | CIF_D10_M1 | LCDC_D14 | GPIO2_C2_d | J20
| | | | RGMII_TXD0_M1 | CIF_D11_M1 | LCDC_D15 | GPIO2_C3_d | H20
| | | | RGMII_TXD1_M1 | CIF_D12_M1 | LCDC_D16 | GPIO2_C4_d | H19
| | | | CLK_OUT_ETHERNET_M1 | CIF_D13_M1 | LCDC_D17 | GPIO2_C5_d | G21
| | | | RGMII_TXEN_M1 | CIF_D14_M1 | LCDC_D18 | GPIO2_C6_d | G20
| I2S1_MCLK_M2 | | | RGMII_RXD2_M1 | CIF_D15_M1 | LCDC_D19 | GPIO2_C7_d | G19
| I2S1_SDO_M2 | | | RGMII_RXD3_M1 | CIF_VSYNC_M1 | LCDC_D20 | GPIO2_D0_d | H18
| I2S1_SCLK_M2 | | | RGMII_TXD2_M1 | CIF_CLKOUT_M1 | LCDC_D21 | GPIO2_D1_d | F21
| I2S1_LRCK_M2 | | | RGMII_TXCLK_M1 | CIF_CLKIN_M1 | LCDC_D22 | GPIO2_D2_d | F20
| I2S1_SDI_M2 | | | RGMII_RXCLK_M1 | CIF_HSYNC_M1 | LCDC_D23 | GPIO2_D3_d | F19
I2C3_SCL_M1 | | | PWM6_M1 | SPI1_CS0n_M2 | | LCDC_DEN | GPIO2_D4_d | J17
I2C3_SDA_M1 | | | PWM10_M1 | SPI1_CLK_M2 | | LCDC_HSYNC | GPIO2_D5_d | H17
| | UART3_RTSN_M2 | PWM9_M1 | SPI1_MOSI_M2 | | LCDC_VSYNC | GPIO2_D6_d | C21
| | UART3_CTSN_M2 | PWM8_M1 | SPI1_MISO_M2 | | LCDC_CLK | GPIO2_D7_d | D21
I2C4_SCL_M0 | CAN_RXD_M0 | UART3_TX_M2 | PWM7_IR_M1 | SPI1_CS1n_M2 | | | GPIO3_A0_u | E20
I2C4_SDA_M0 | CAN_TXD_M0 | UART3_RX_M2 | PWM11_IR_M1 | | | | GPIO3_A1_u | E19
A7_JTAG_TCK_M1 | | UART2_TX_M1 | | | | | GPIO3_A2_u | G18
A7_JTAG_TMS_M1 | | UART2_RX_M1 | | | | | GPIO3_A3_u | H16
VCCIO5_VDD1 | J15
VCCIO5_VDD2 | K15

## work_led

D | D

# Audio Interface

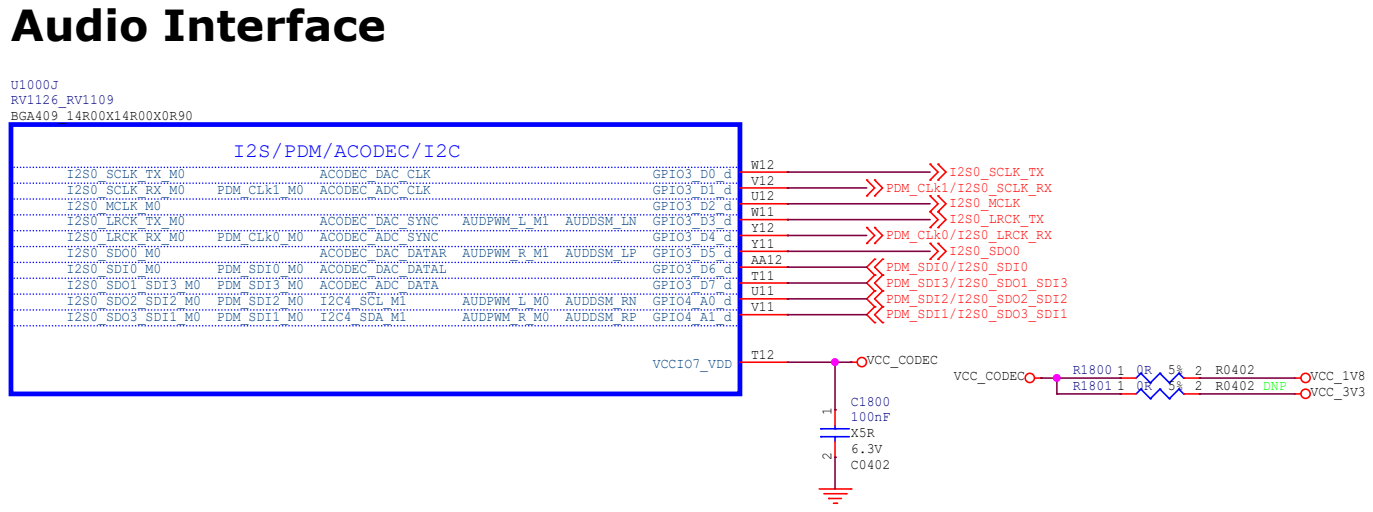
[picture p74: page 16]
VCC_CODEC; VCC_1V8 VCC_3V3; PDM_SDI2/I2S0_SDO2_SDI2 PDM_SDI1/I2S0_SDO3_SDI1; PDM_SDI3/I2S0_SDO1_SDI3; PDM_CLk1/I2S0_SCLK_RX; PDM_CLk0/I2S0_LRCK_RX; I2S0_SCLK_TX; I2S0_MCLK I2S0_LRCK_TX; I2S0_SDO0 PDM_SDI0/I2S0_SDI0; Project:; 18.RV1126/1109_Audio; whb; 5% 2 R0402 DNP; I2S/PDM/ACODEC/I2C; U1000J RV1126_RV1109 BGA409_14R00X14R00X0R90; I2S0_SCLK_TX_M0; ACODEC_DAC_CLK; GPIO3_D0_d; I2S0_SCLK_RX_M0; PDM_CLk1_M0; ACODEC_ADC_CLK; GPIO3_D1_d; I2S0_MCLK_M0; GPIO3_D2_d; I2S0_LRCK_RX_M0; PDM_CLk0_M0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

Rockchip Electronics Co., Ltd

# VCC_3V3

# VDD_ARM

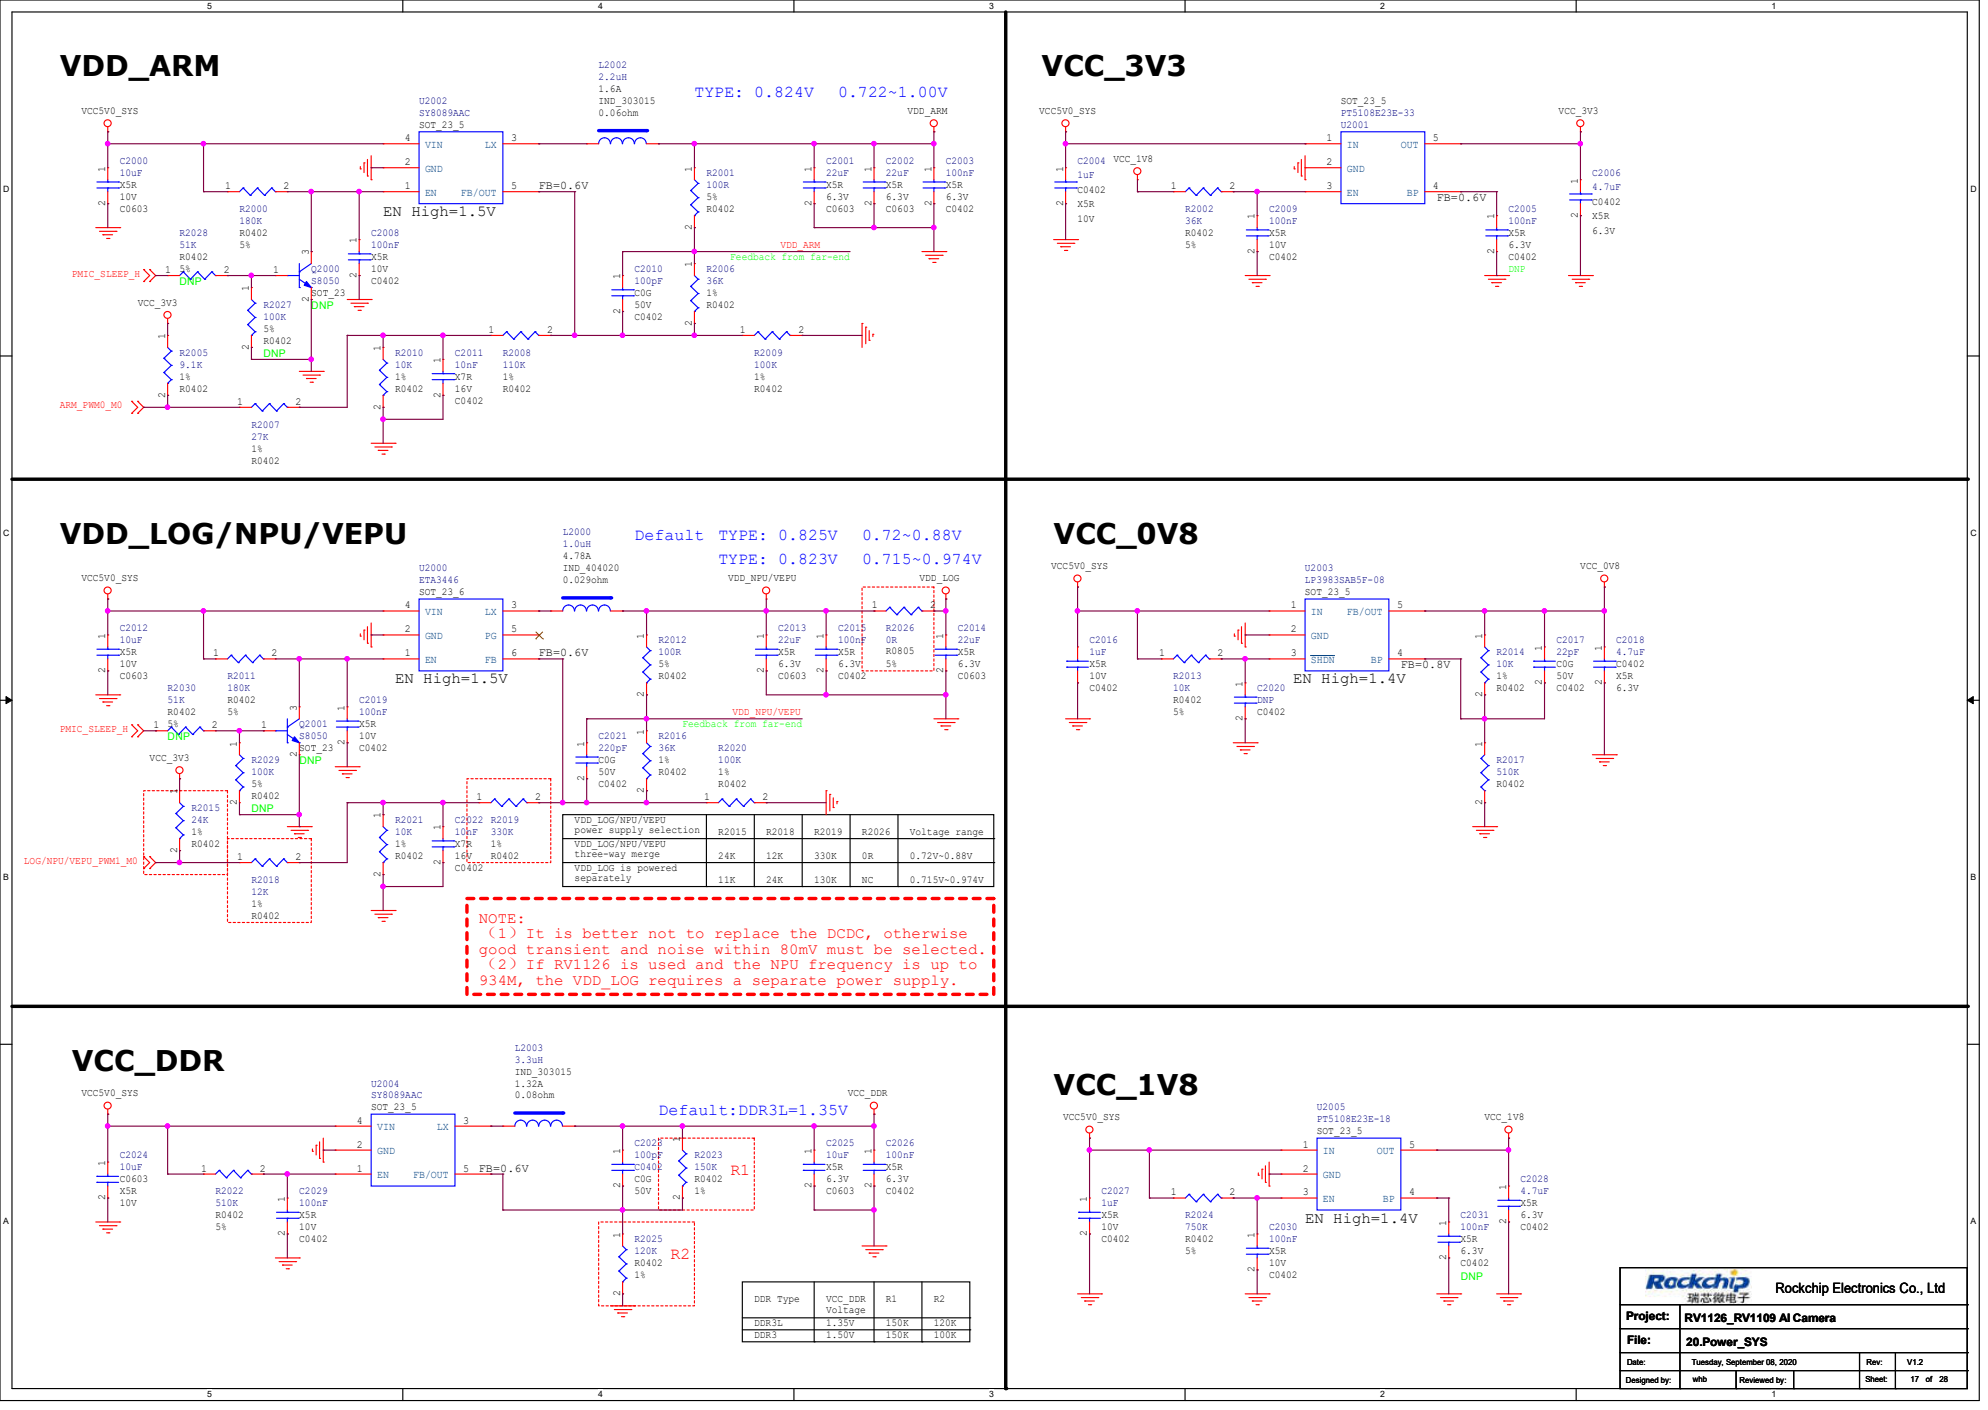
[picture p75: page 17]

NOTE:
（1）It is better not to replace the DCDC, otherwise
good transient and noise within 80mV must be selected.
（2）If RV1126 is used and the NPU frequency is up to
934M, the VDD_LOG requires a separate power supply.

Rockchip Electronics Co., Ltd

D | D

# VDD_LOG

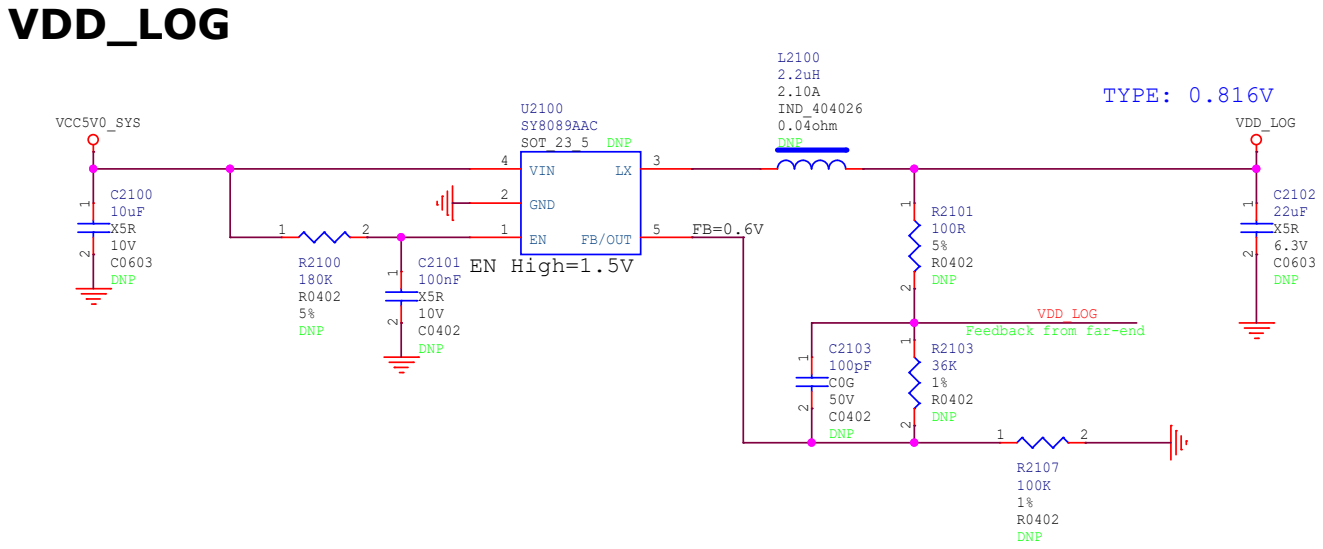
[picture p76: page 18]

Rockchip Electronics Co., Ltd

D | D

## VCC_3V3

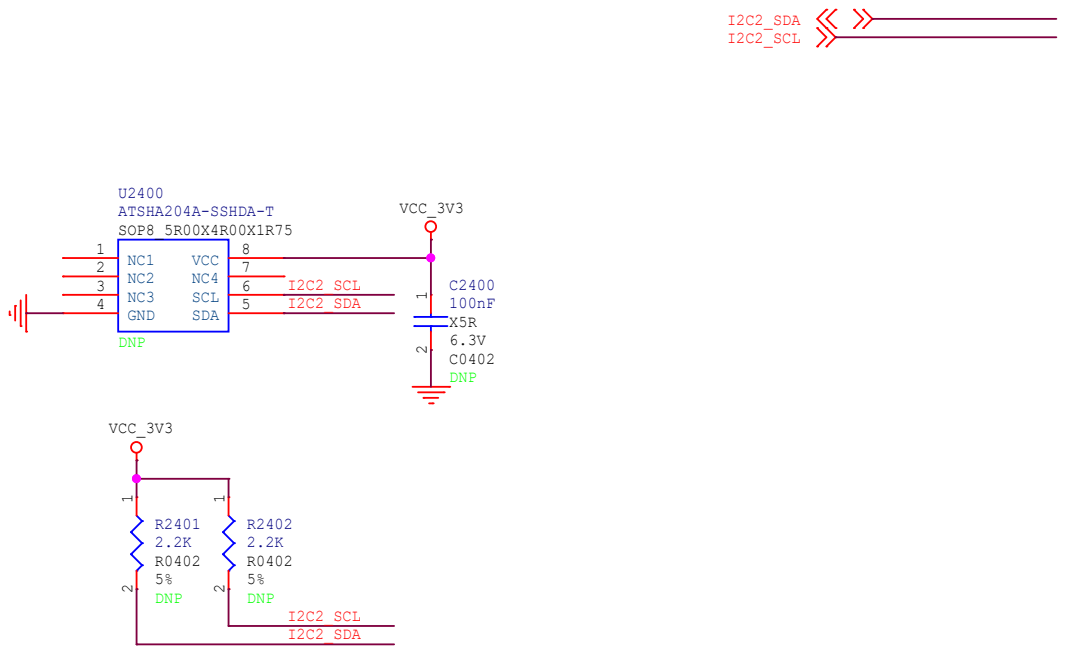
[picture p77: page 19]
VCC_3V3; I2C2_SDA I2C2_SCL; Project:; 24.Encrytion Chip; whb; DNP; R2401 2.2K R0402 5% DNP; R2402 2.2K R0402 5% DNP; U2400 ATSHA204A-SSHDA-T SOP8_5R00X4R00X1R75; GND 4; SDA; 5 SCL; 7 VCC; I2C2_SCL I2C2_SDA

Rockchip Electronics Co., Ltd

D | D

# USB2.0 OTG

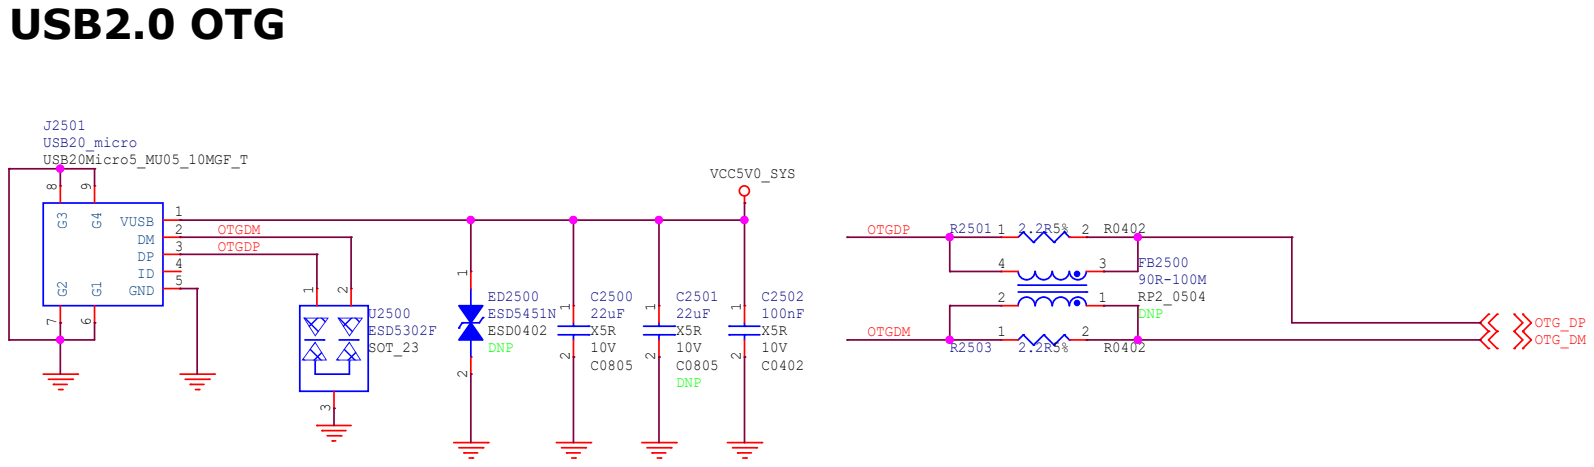
[picture p78: page 20]

Rockchip Electronics Co., Ltd

# DDR3/DDR3L 2x16bit

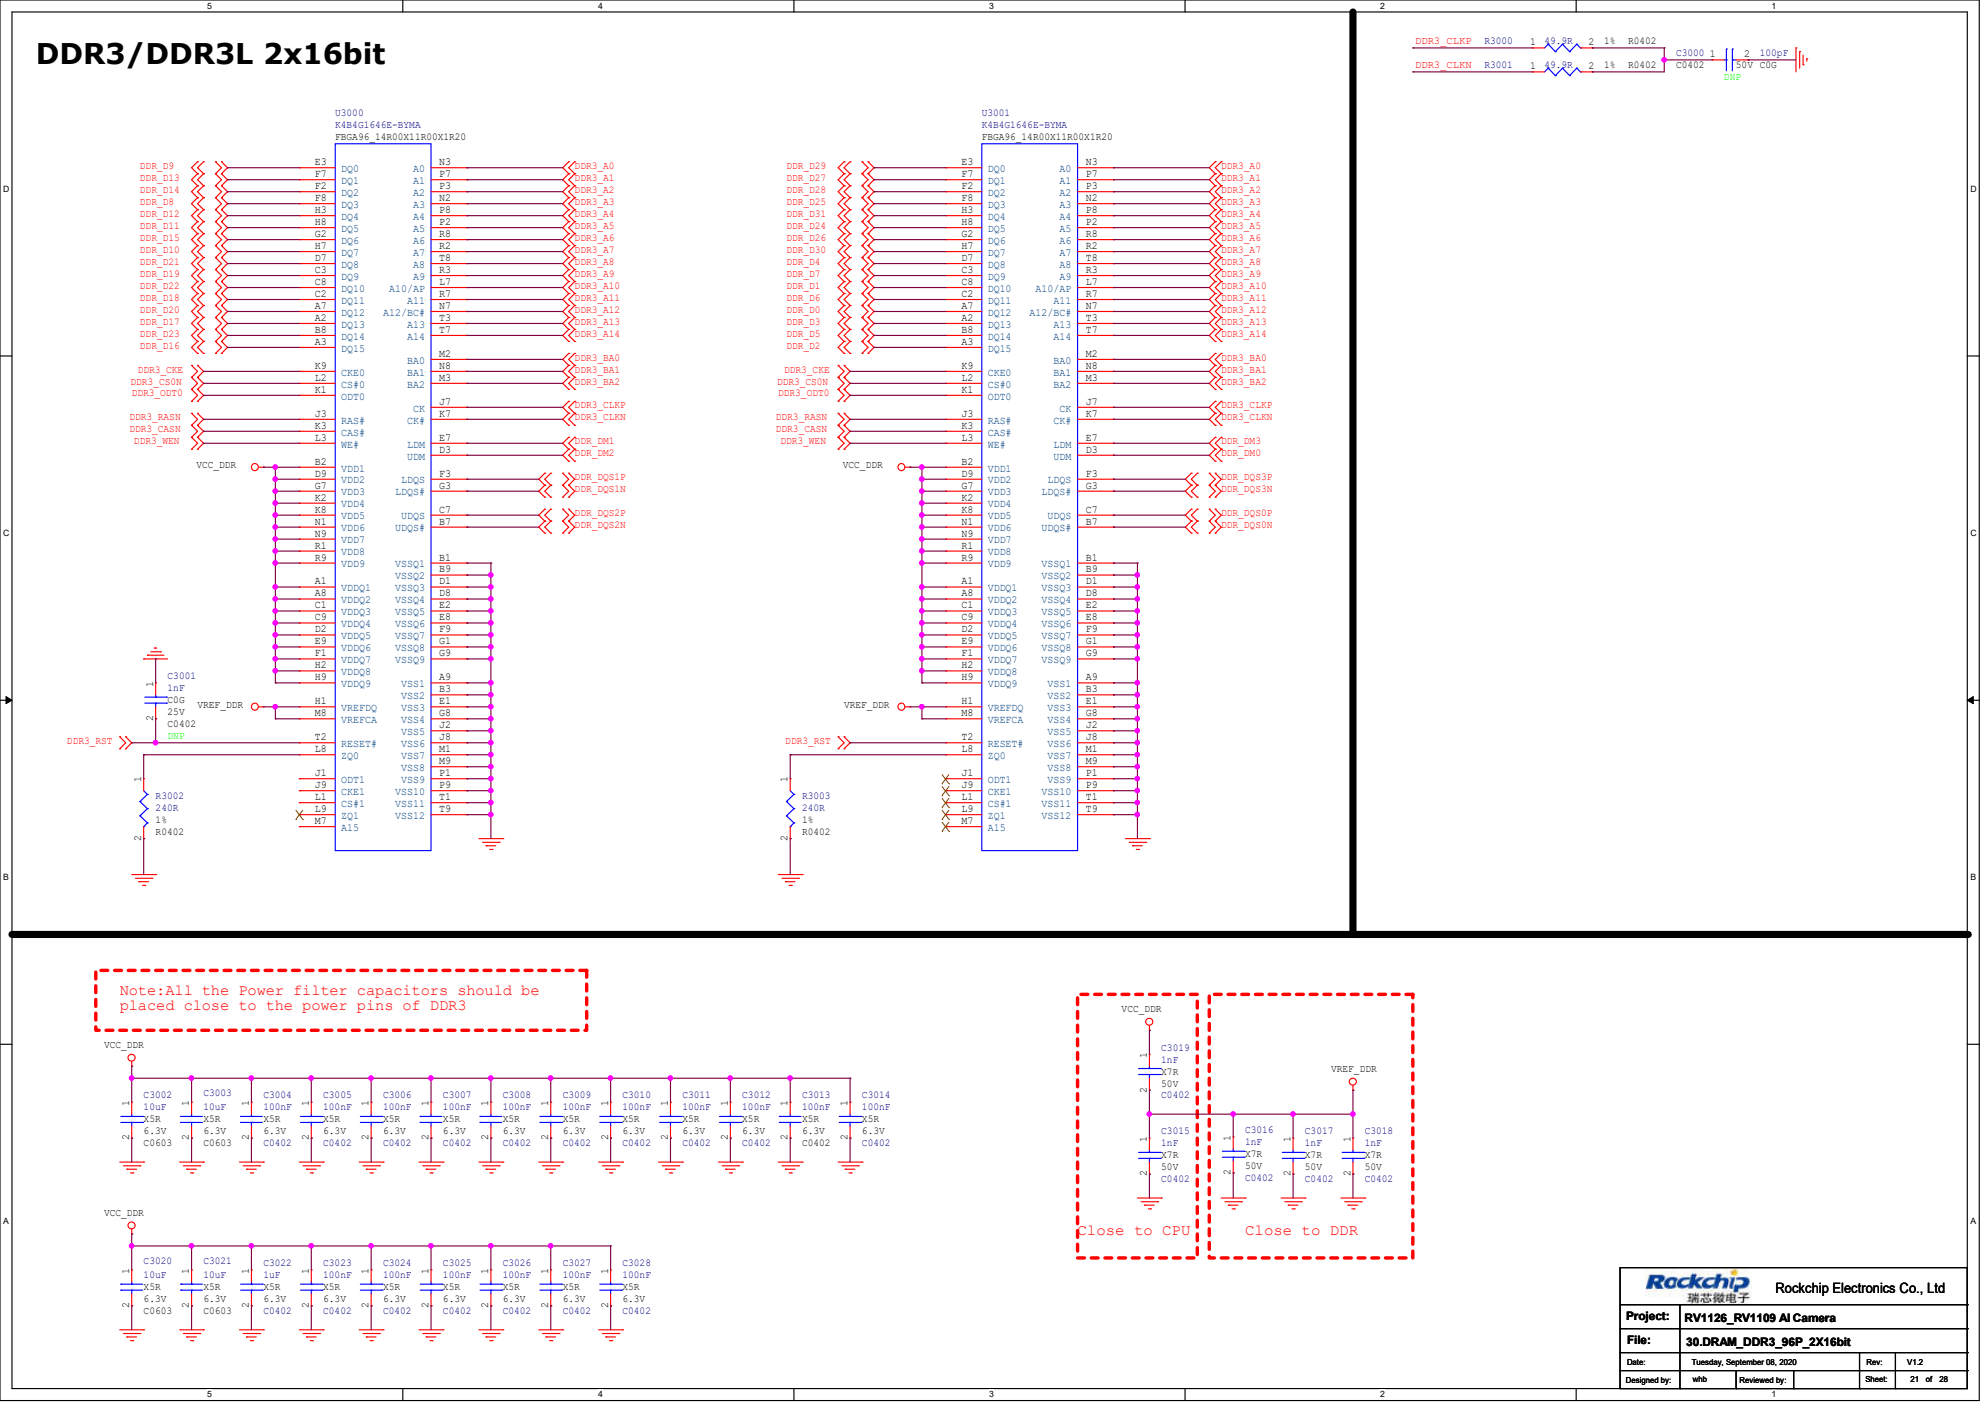
[picture p79: page 21]

Note:All the Power filter capacitors should be
placed close to the power pins of DDR3

Rockchip Electronics Co., Ltd

D | D

# eMMC

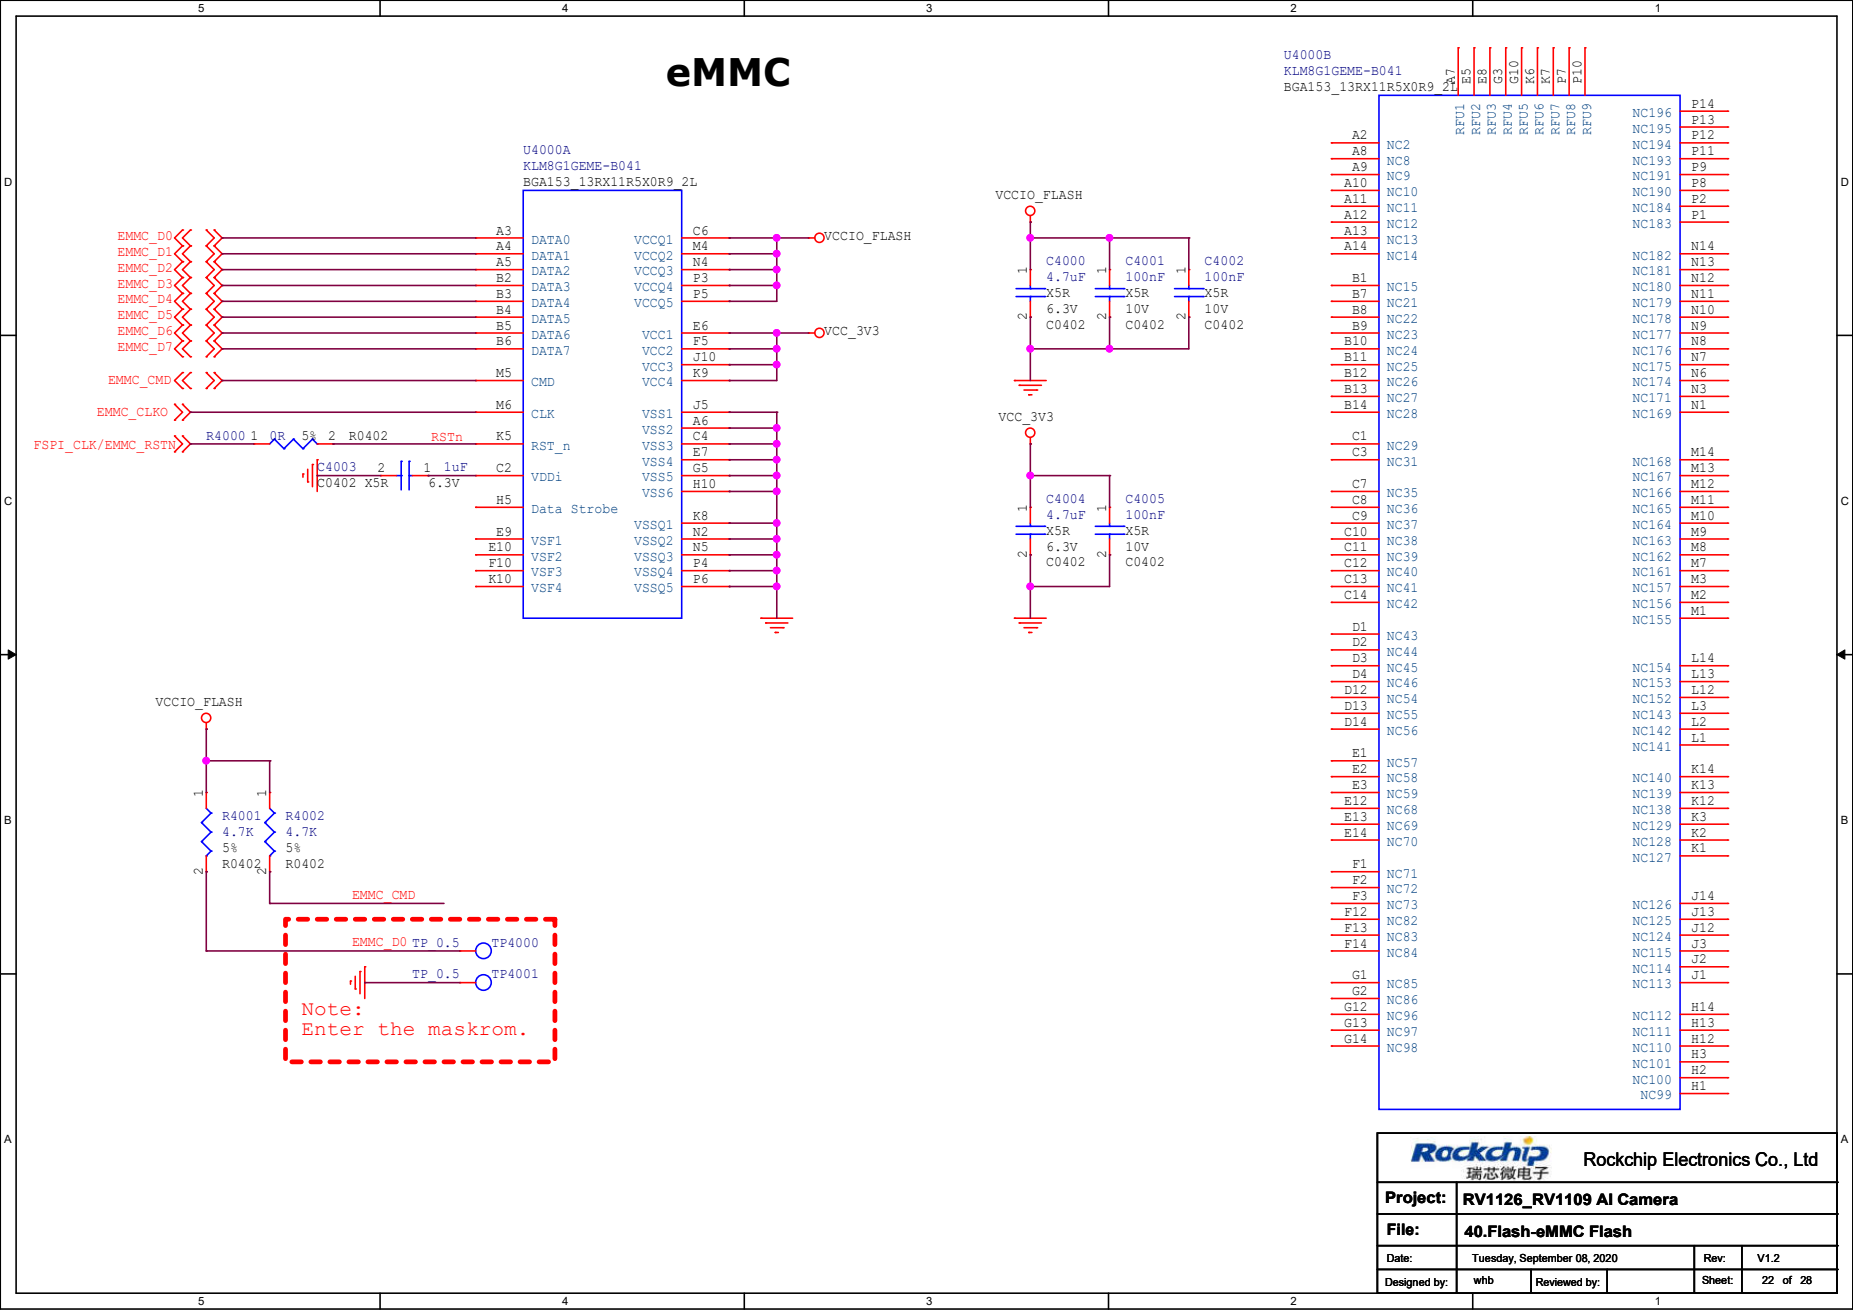
[picture p80: page 22]

Rockchip Electronics Co., Ltd

D | D

# SPI Flash

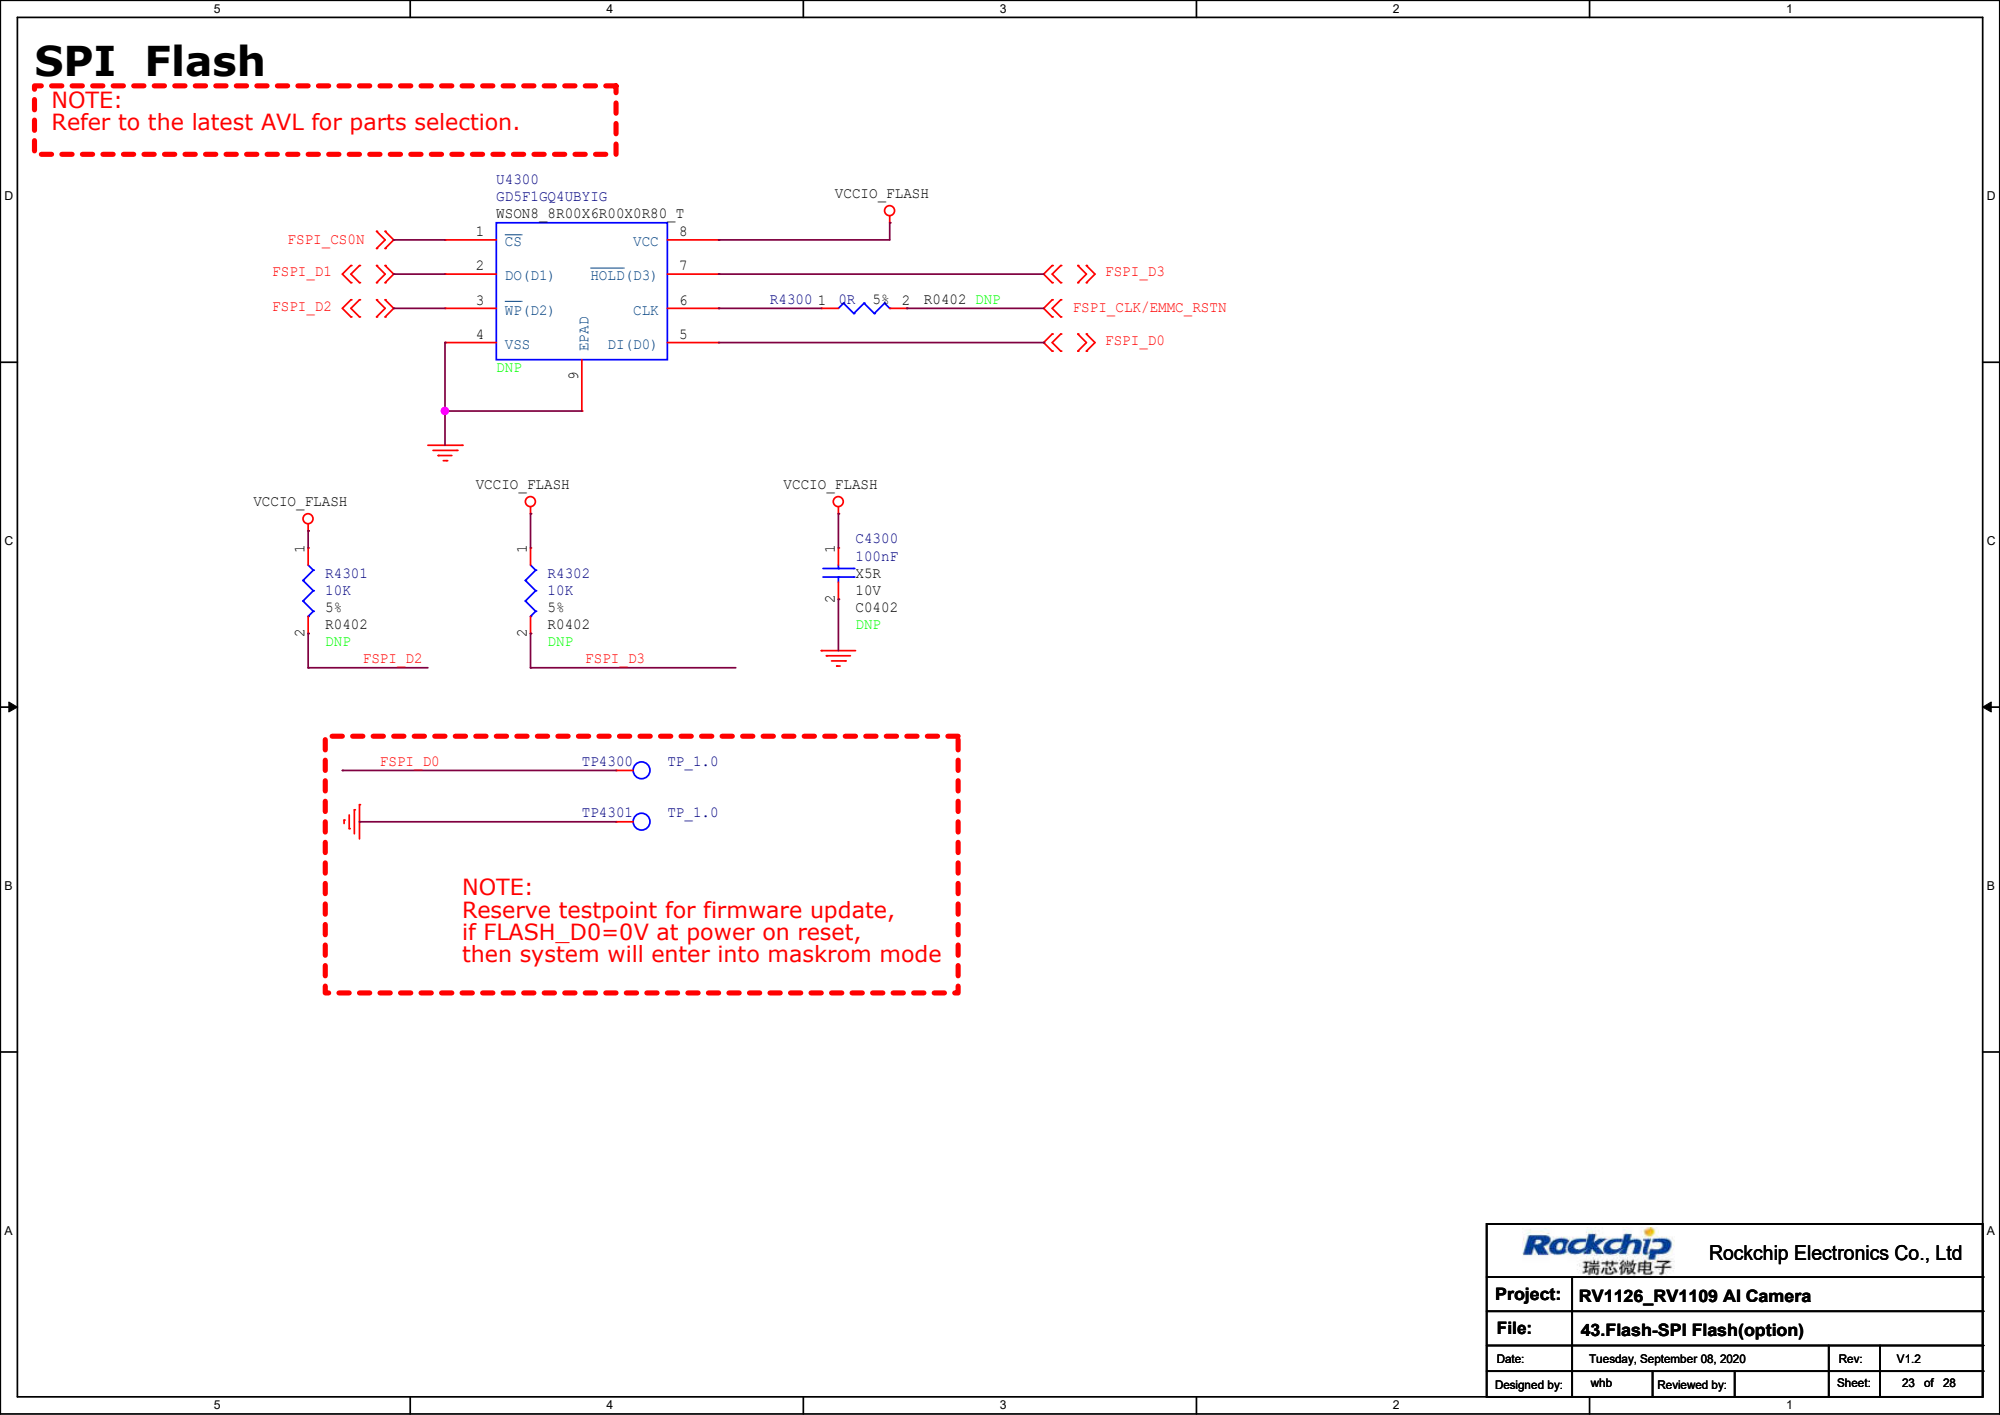
[picture p81: page 23]

NOTE:
Refer to the latest AVL for parts selection.

Reserve testpoint for firmware update,
if FLASH_D0=0V at power on reset,
then system will enter into maskrom mode

Rockchip Electronics Co., Ltd

43.Flash-SPI Flash(option)

D | D

# MIPI-CSI_RX0 Interface

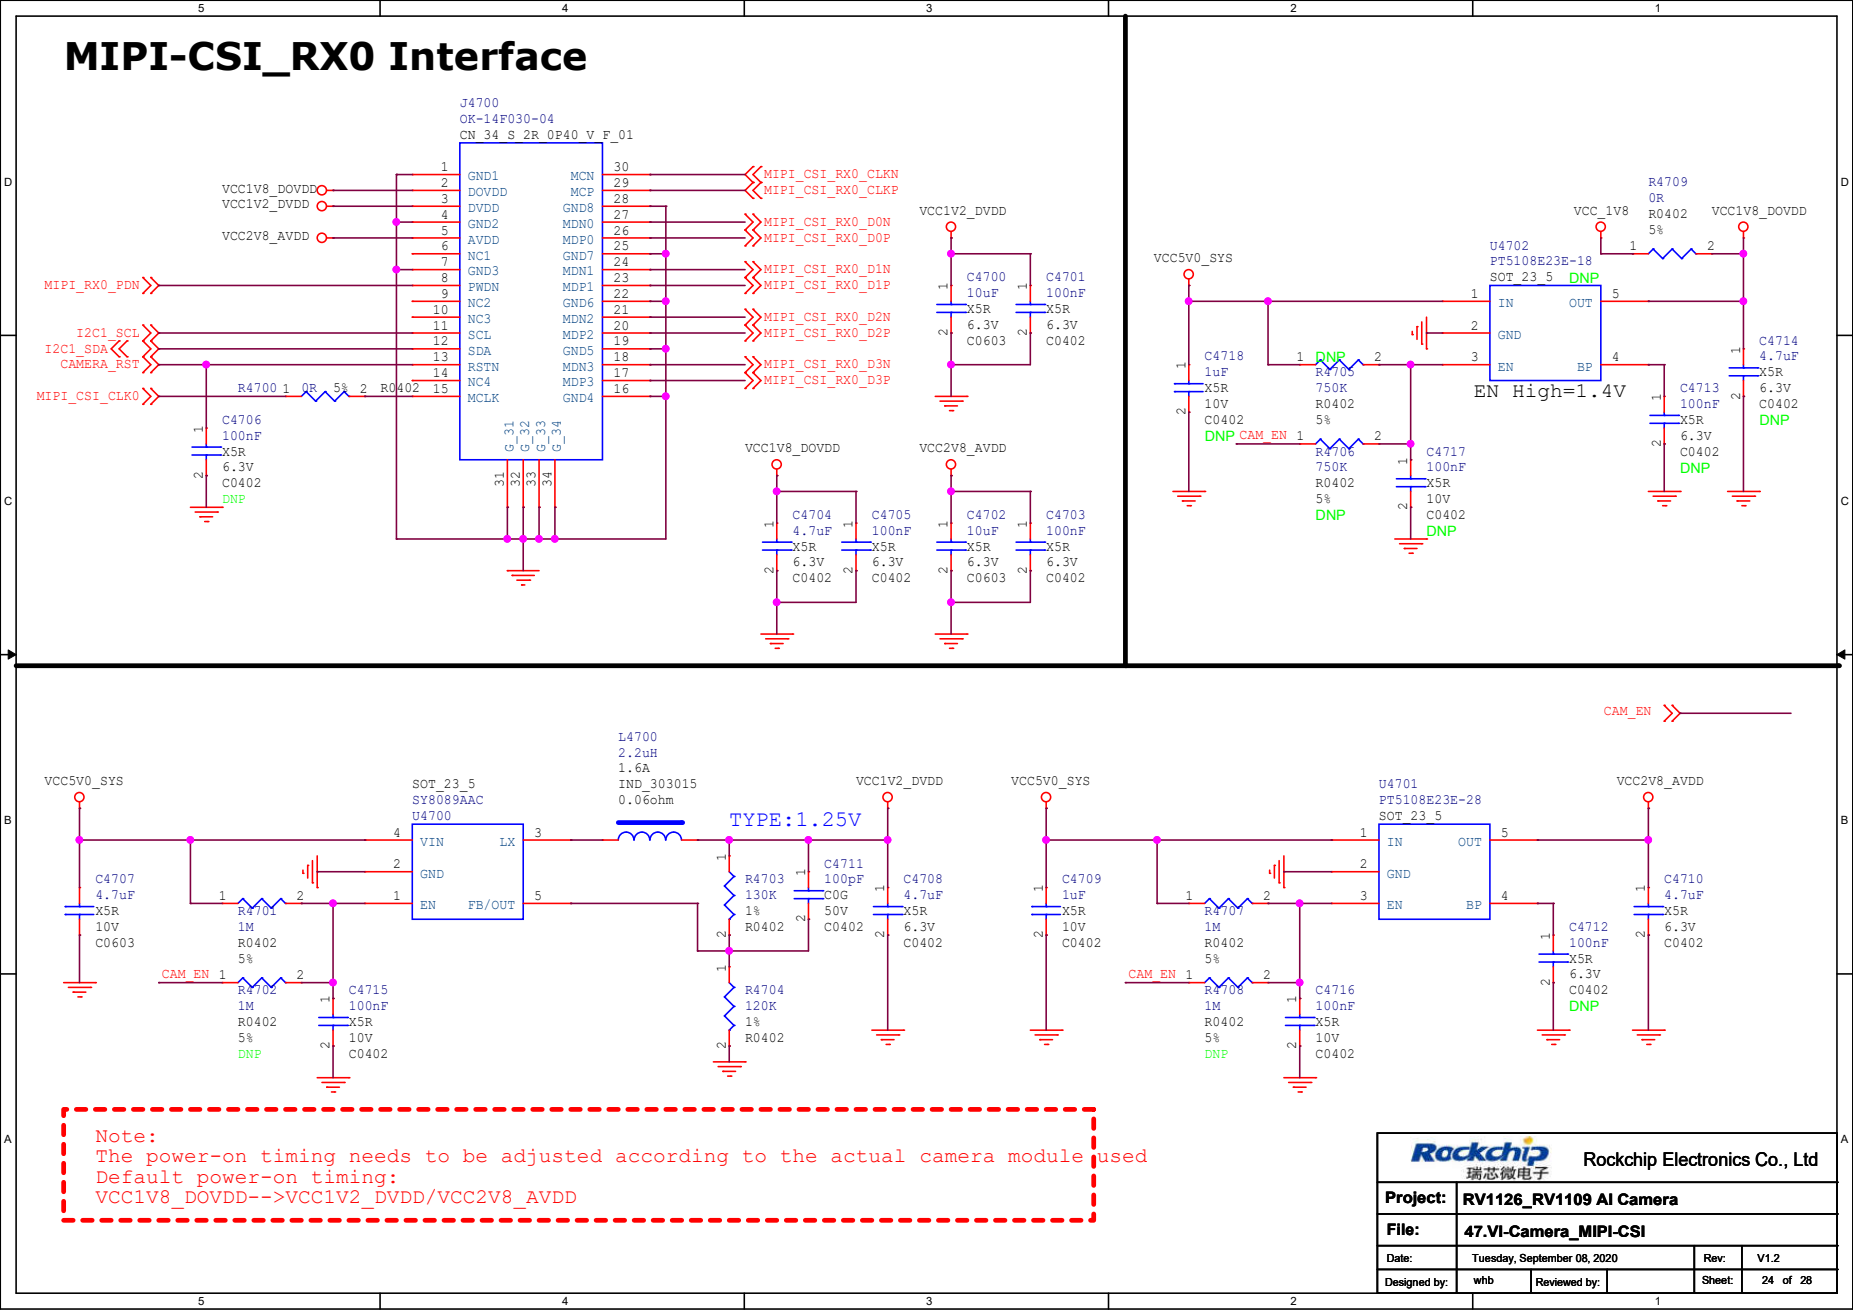
[picture p82: page 24]

Note:
The power-on timing needs to be adjusted according to the actual camera module used
Default power-on timing:
VCC1V8_DOVDD-->VCC1V2_DVDD/VCC2V8_AVDD

Rockchip Electronics Co., Ltd

D | D

# Iris Zoom Focus driver

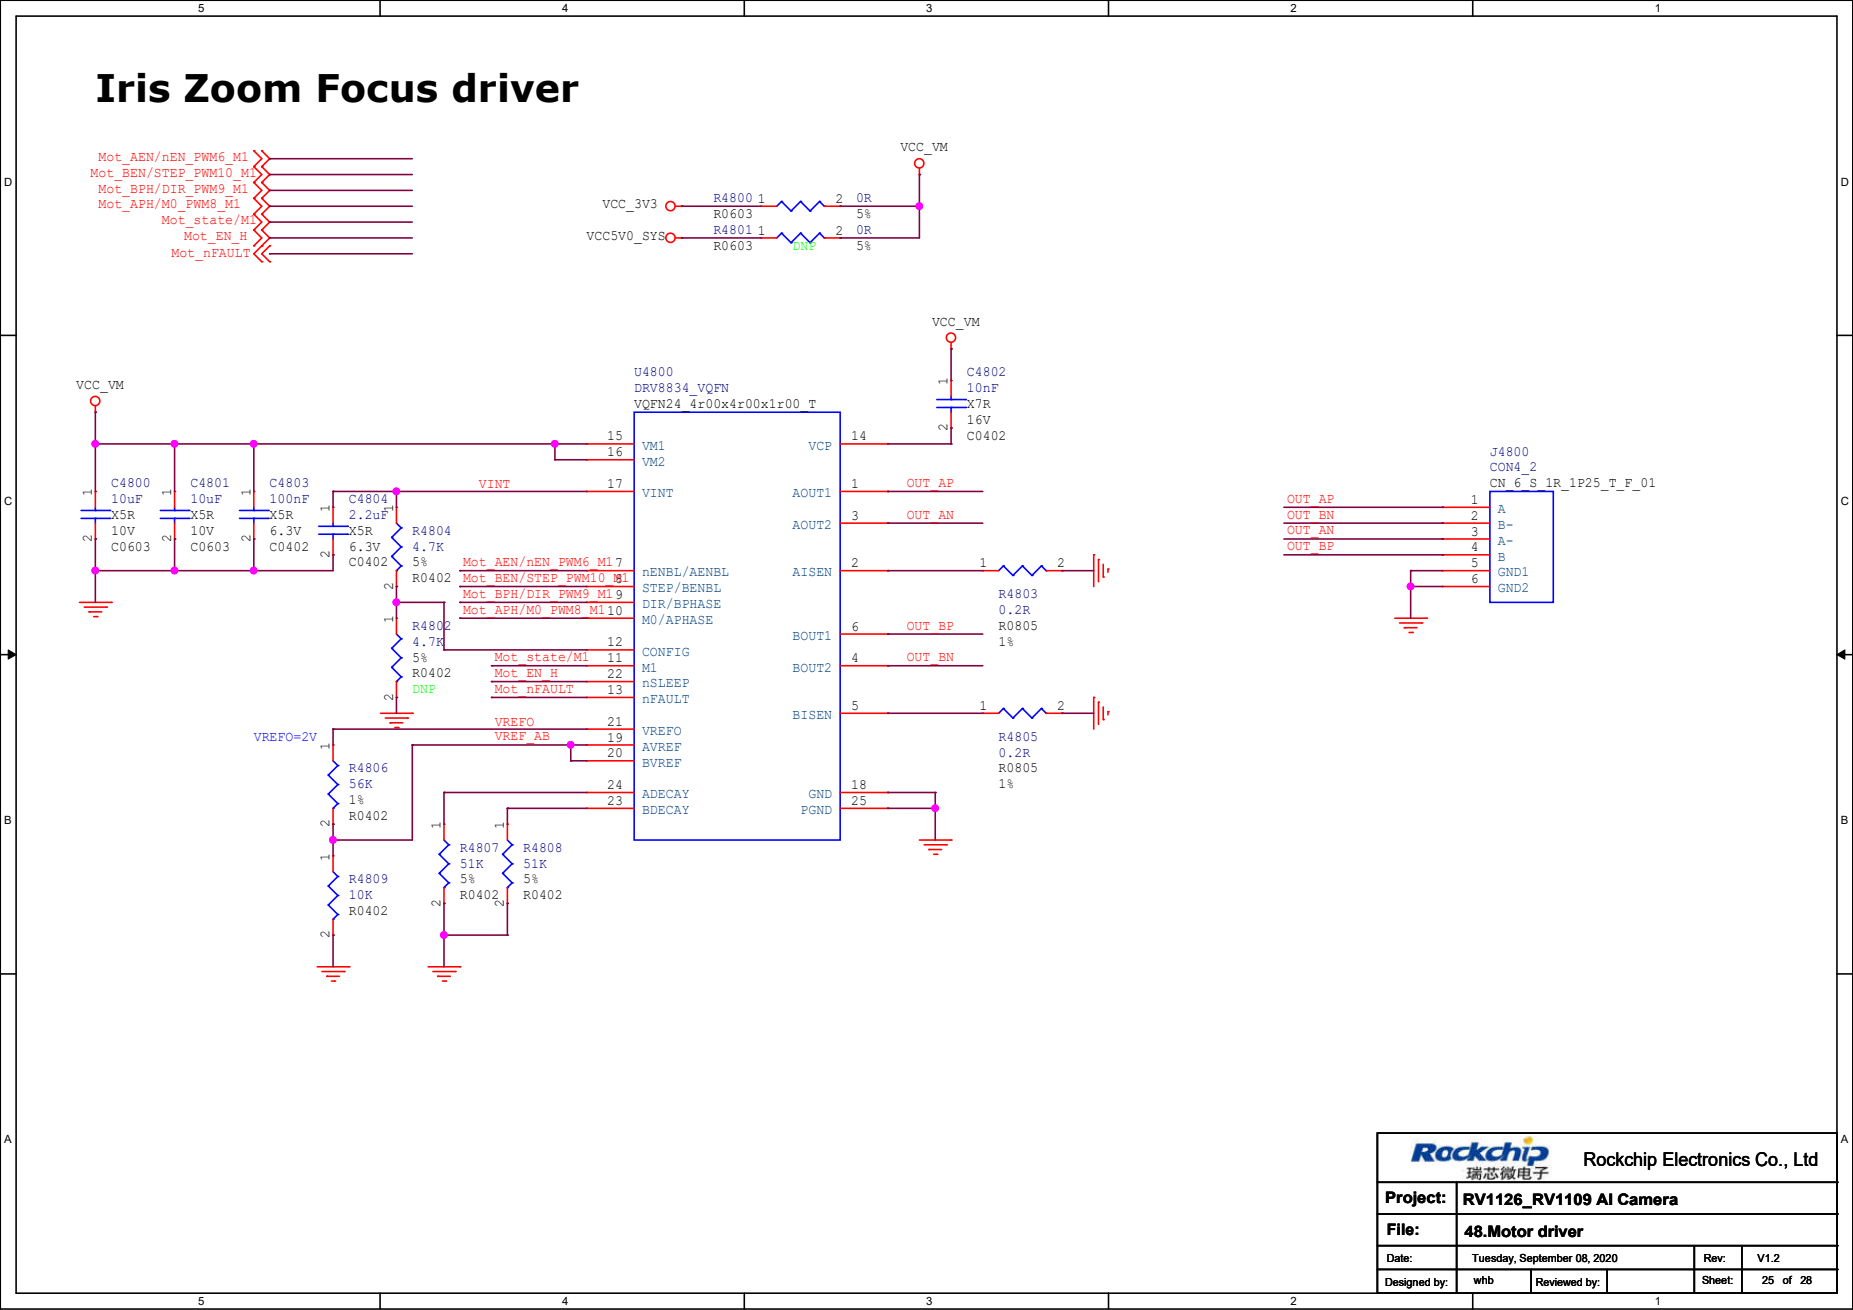
[picture p83: page 25]

Rockchip Electronics Co., Ltd

D | D

# PDM MIC X4

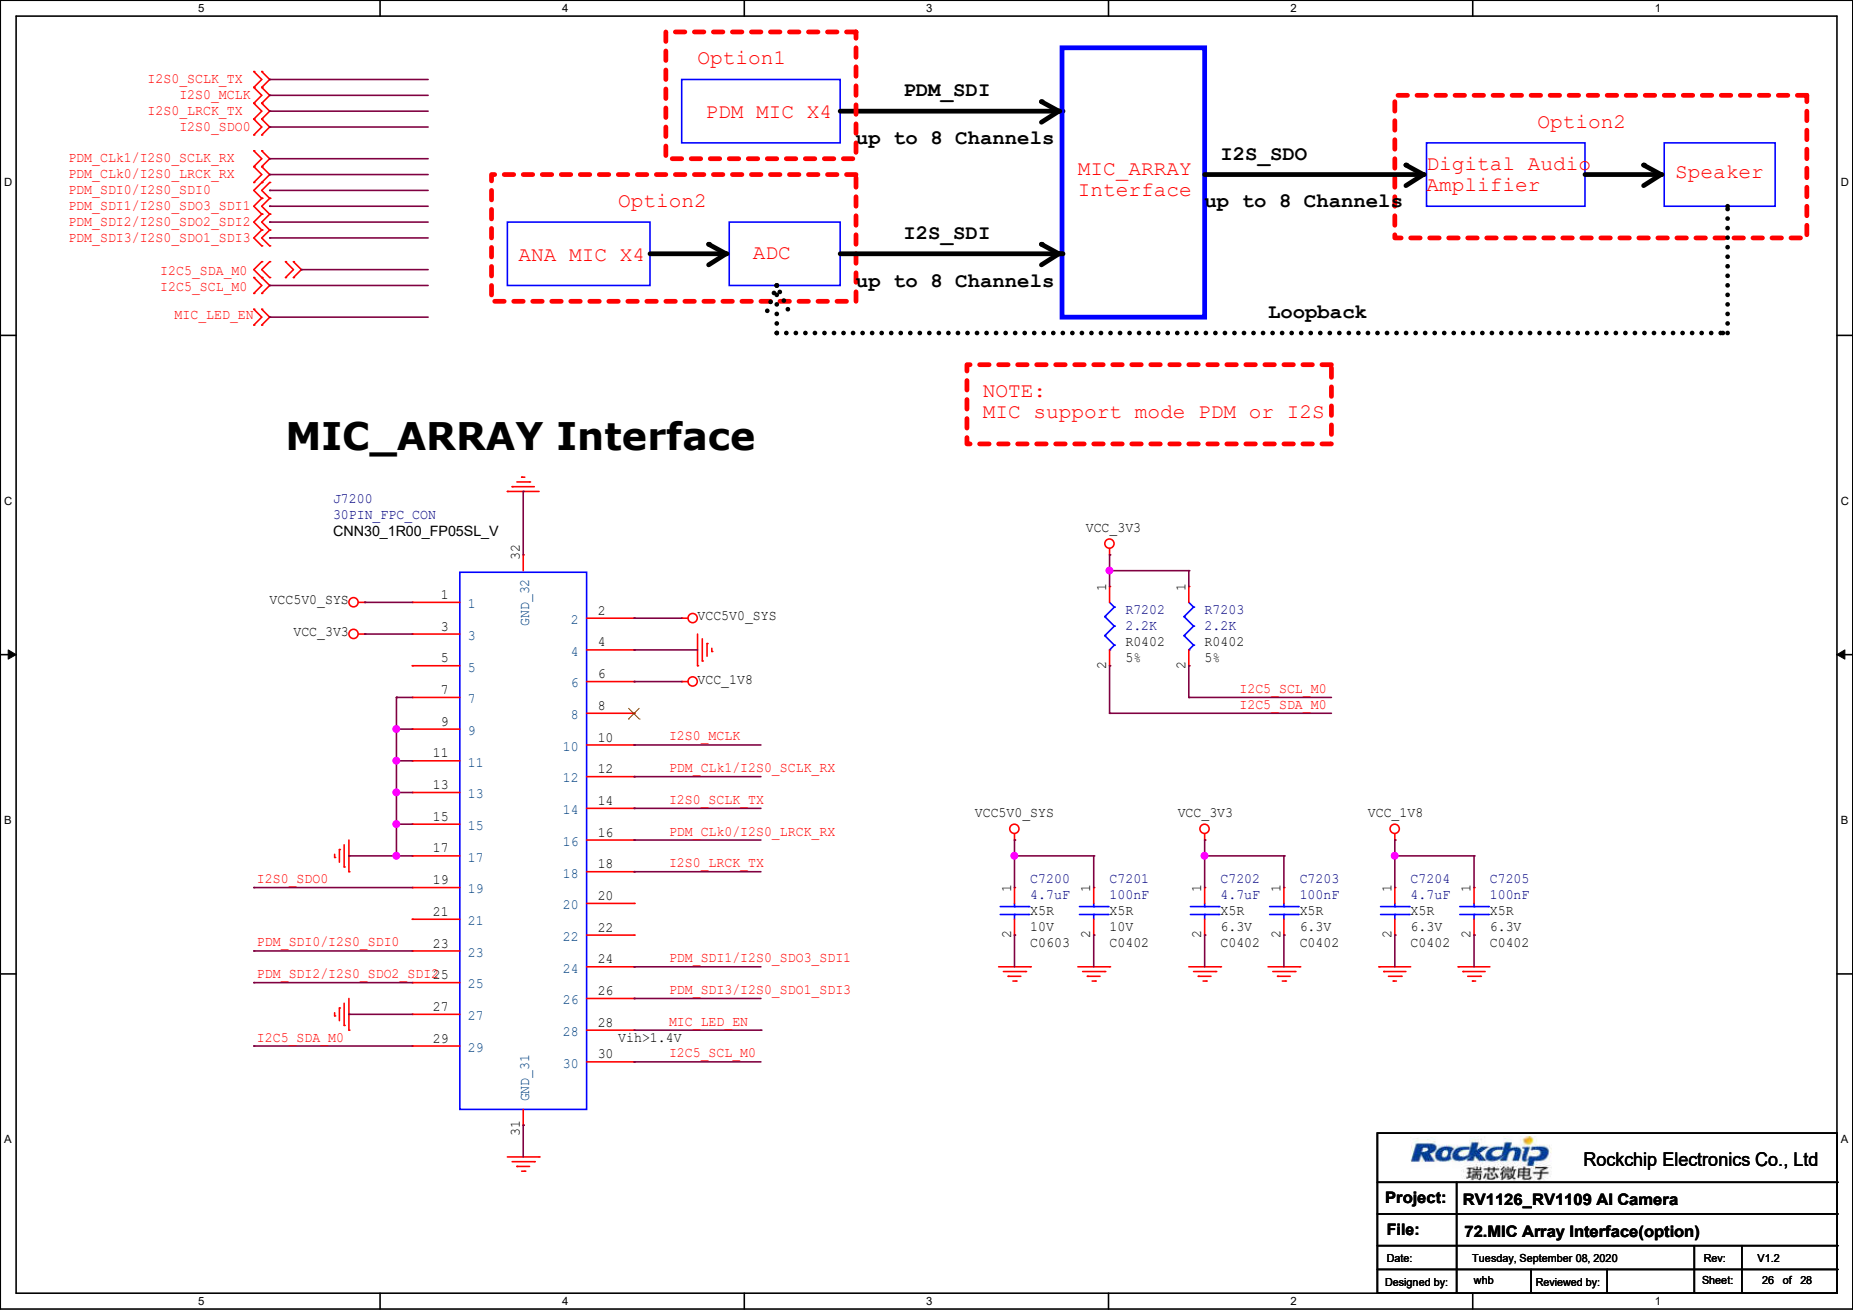
[picture p84: page 26]

NOTE:
MIC support mode PDM or I2S

Rockchip Electronics Co., Ltd

72.MIC Array Interface(option)

D | D

# Debug UART2

VCC_3V3; UART2_RX UART2_TX; Project:; 93.Debug; whb; CN4M_2R54_V_DIP; UART2RX UART2TX

Rockchip Electronics Co., Ltd

D | D

M9903

Project:; 99.MARK/HOLE; whb; MARK; M9905 MARK; M9904 MARK; M9901 MARK; M9900 MARK; M9902 MARK

Rockchip Electronics Co., Ltd
