cnchens/RV1126_RV1109_Hardware_Design_Template/05_Pruduct Line Branch(UVC DEMO)/02_Key Device Specifications/OK-14GMXXX-04 and OK-14FXXX-04规格书(GB04P-24P-H08)(1).pdf

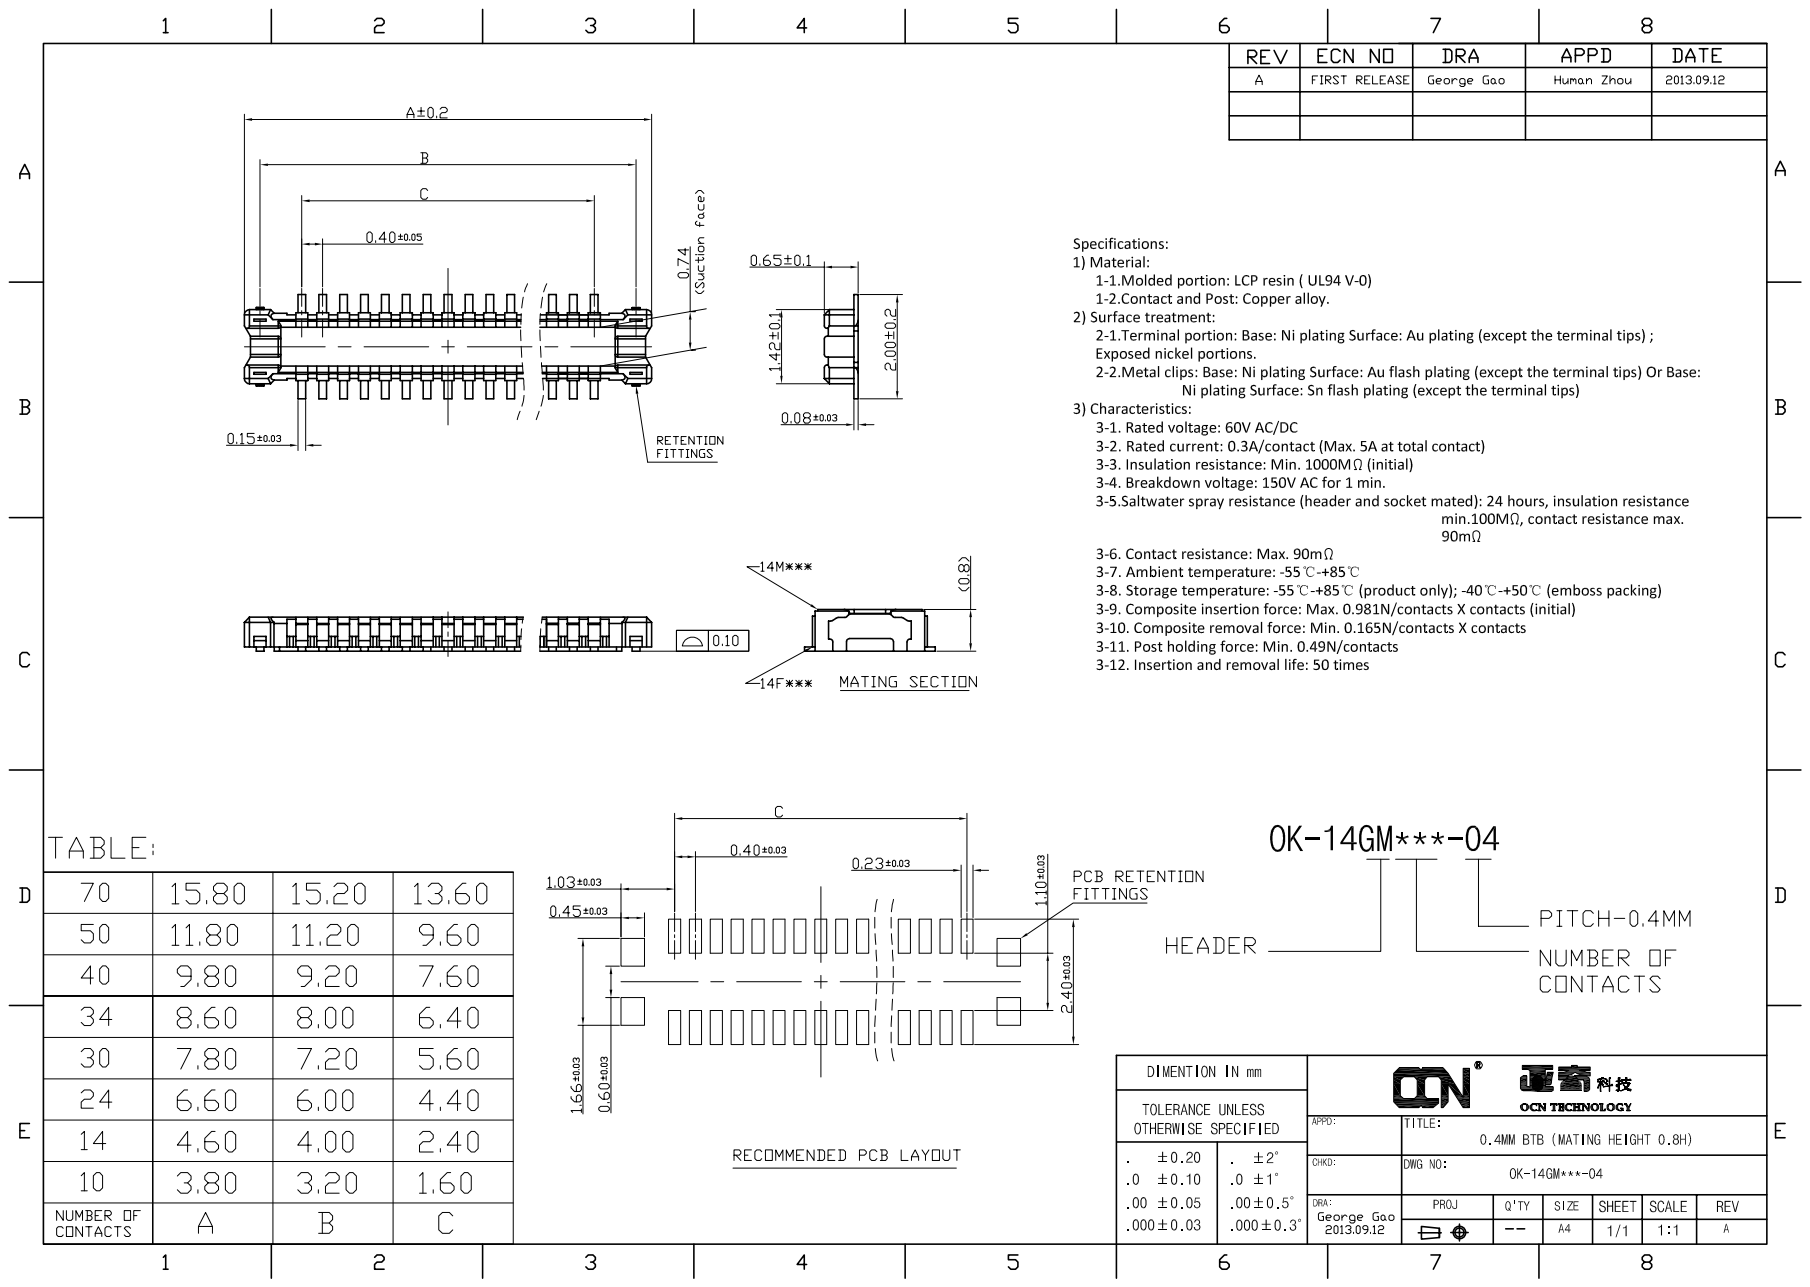
[picture p147: page 1]

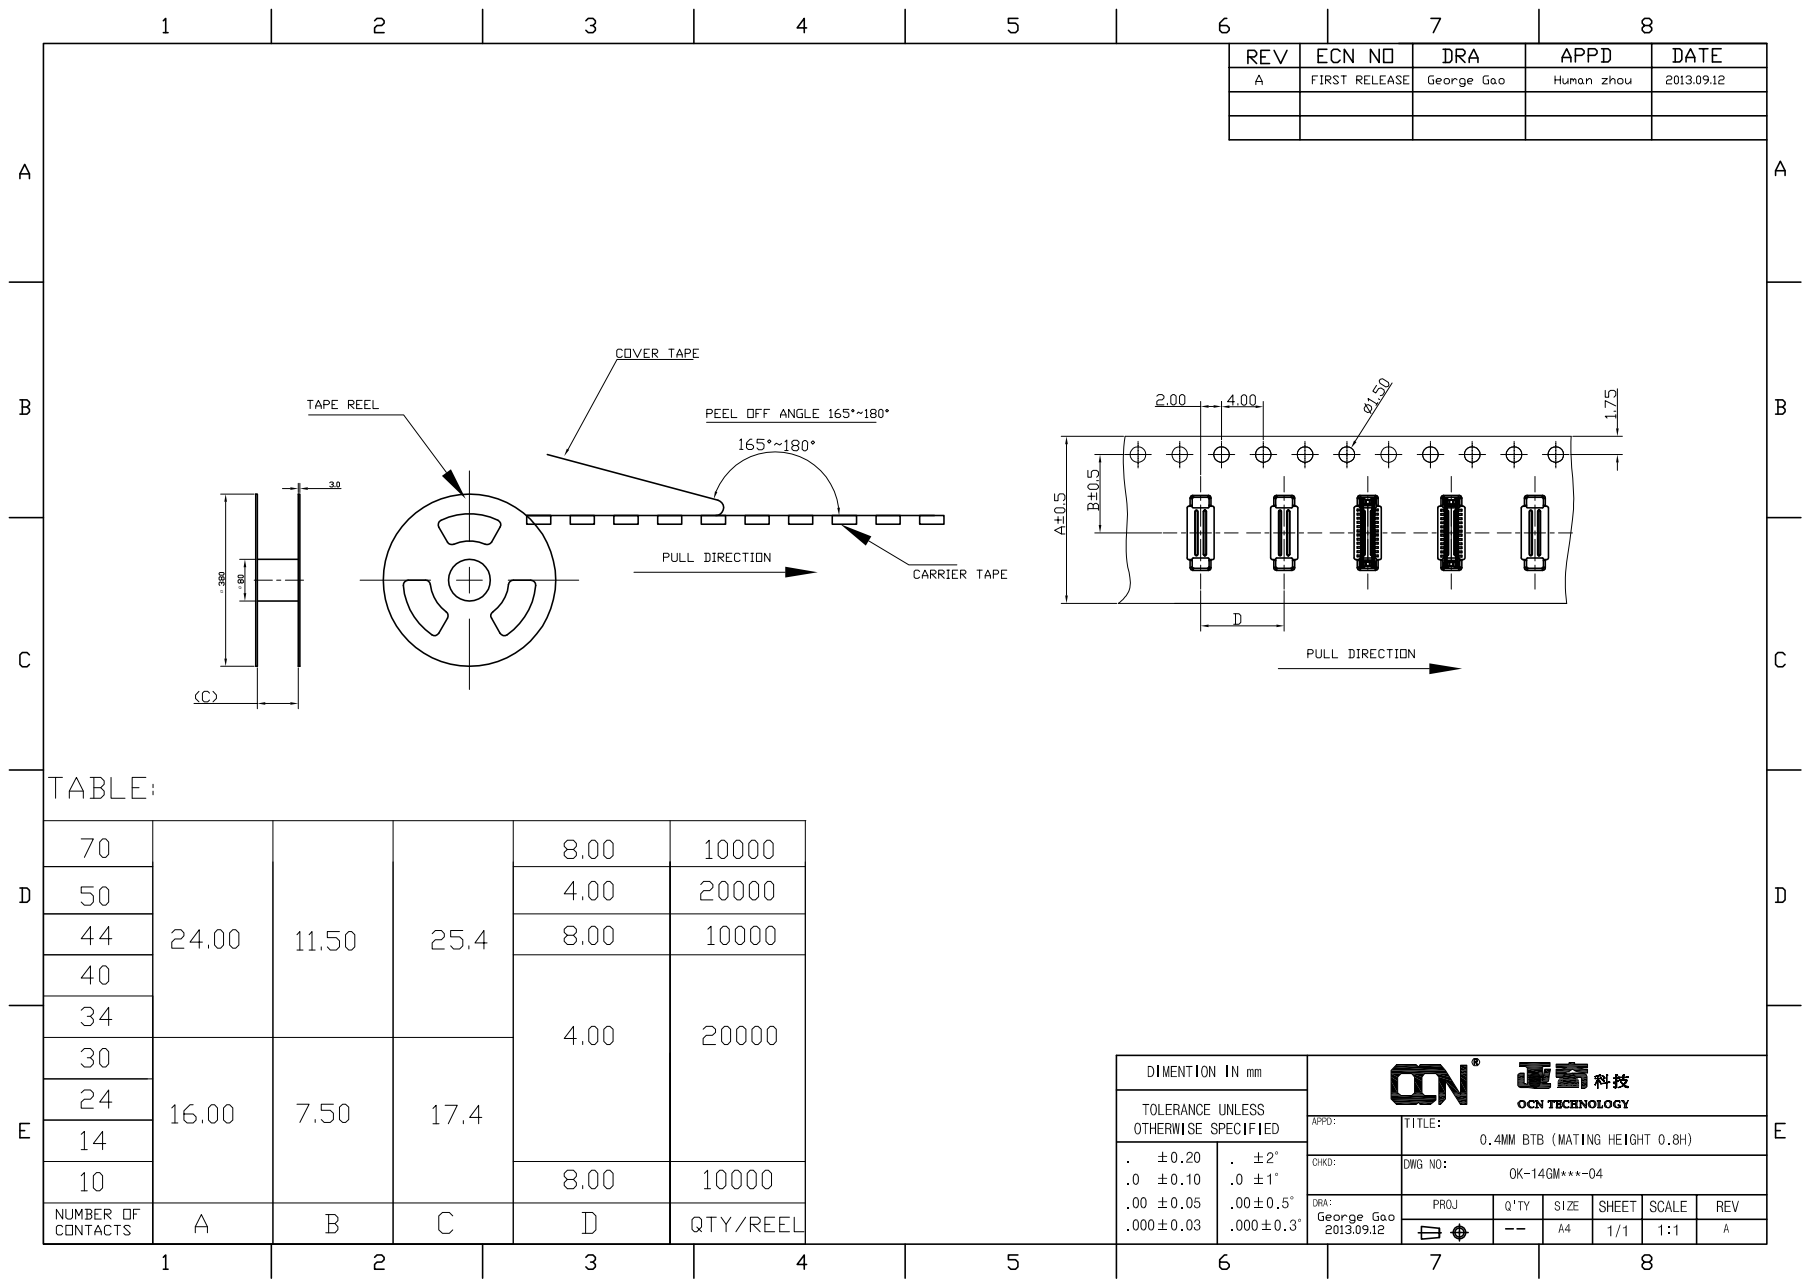
[picture p148: page 2]

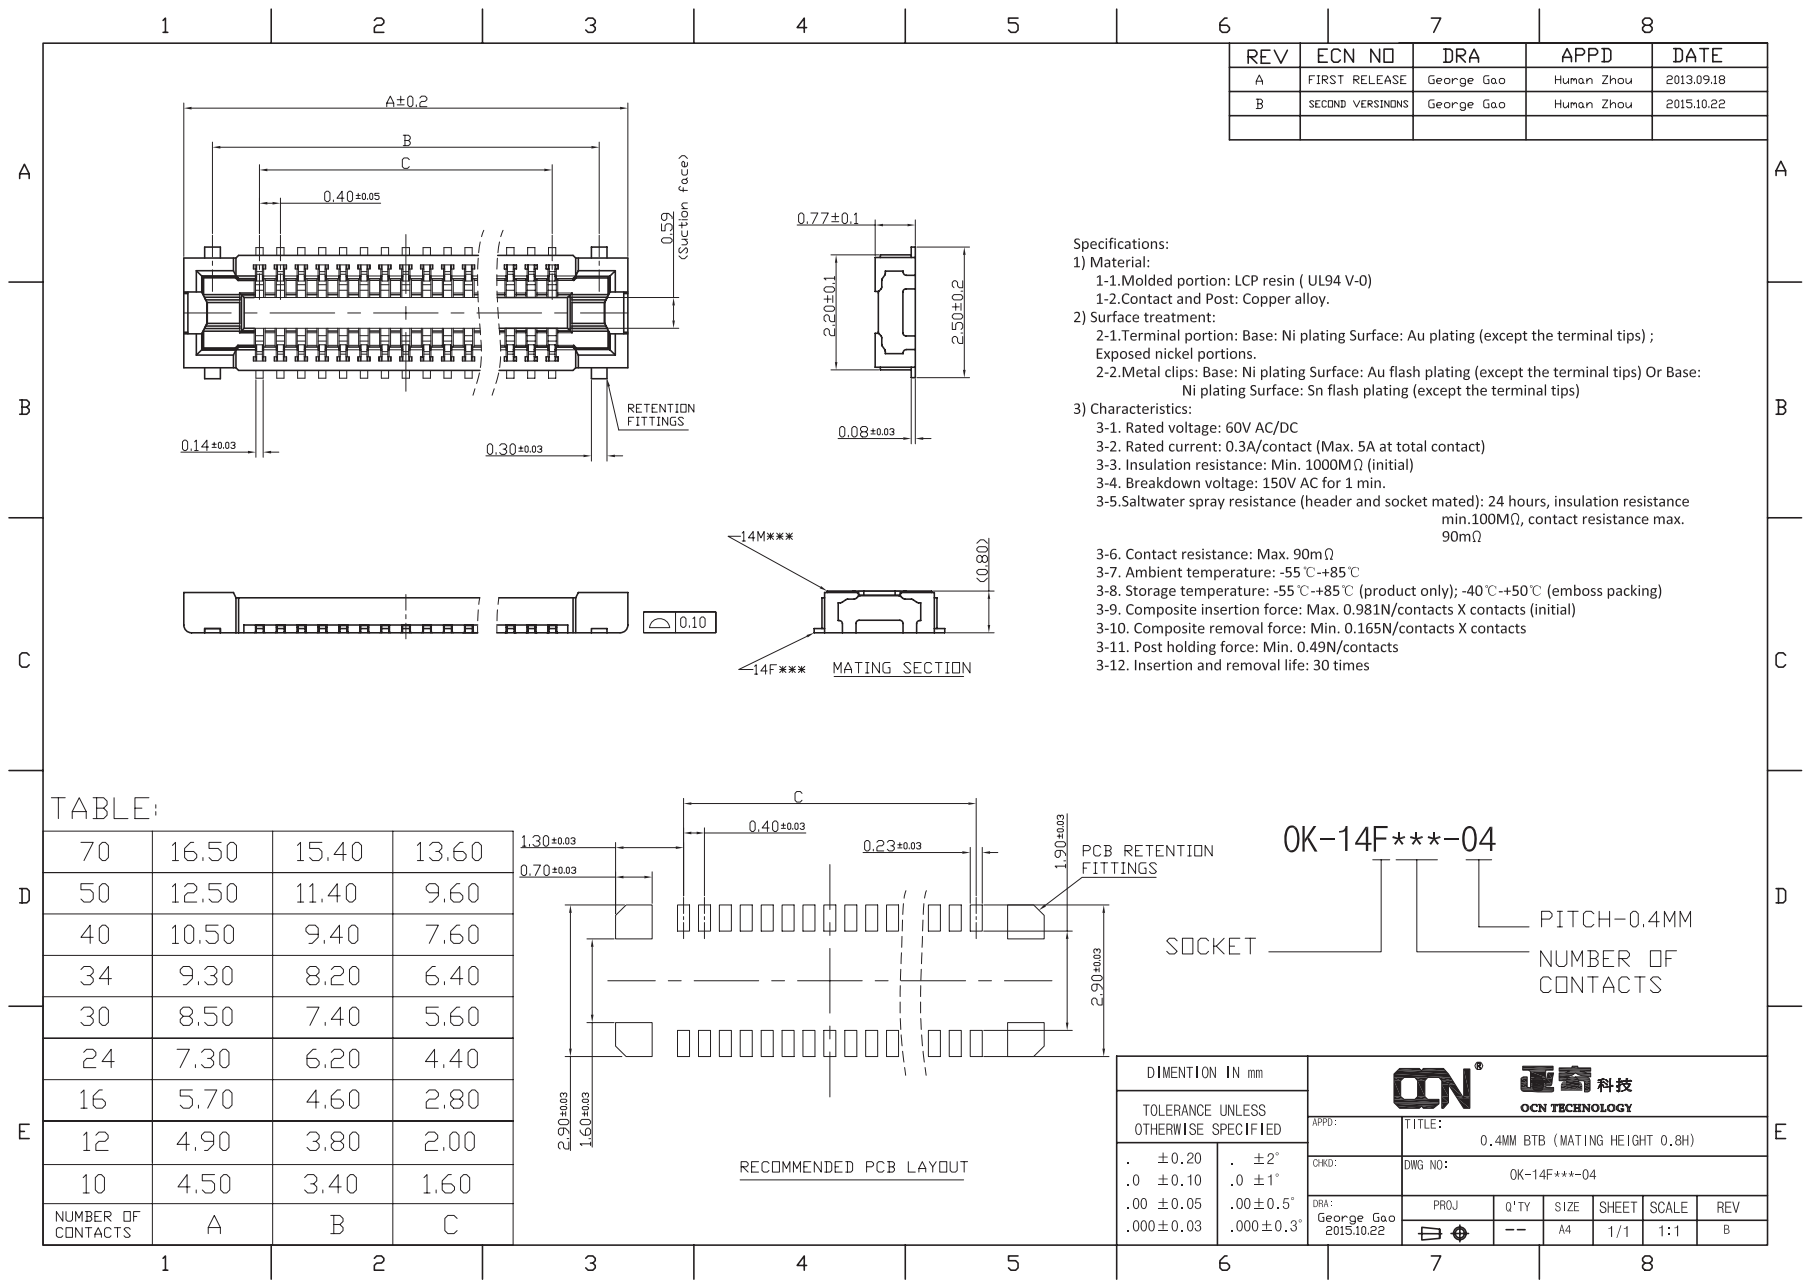
[picture p149: page 3]

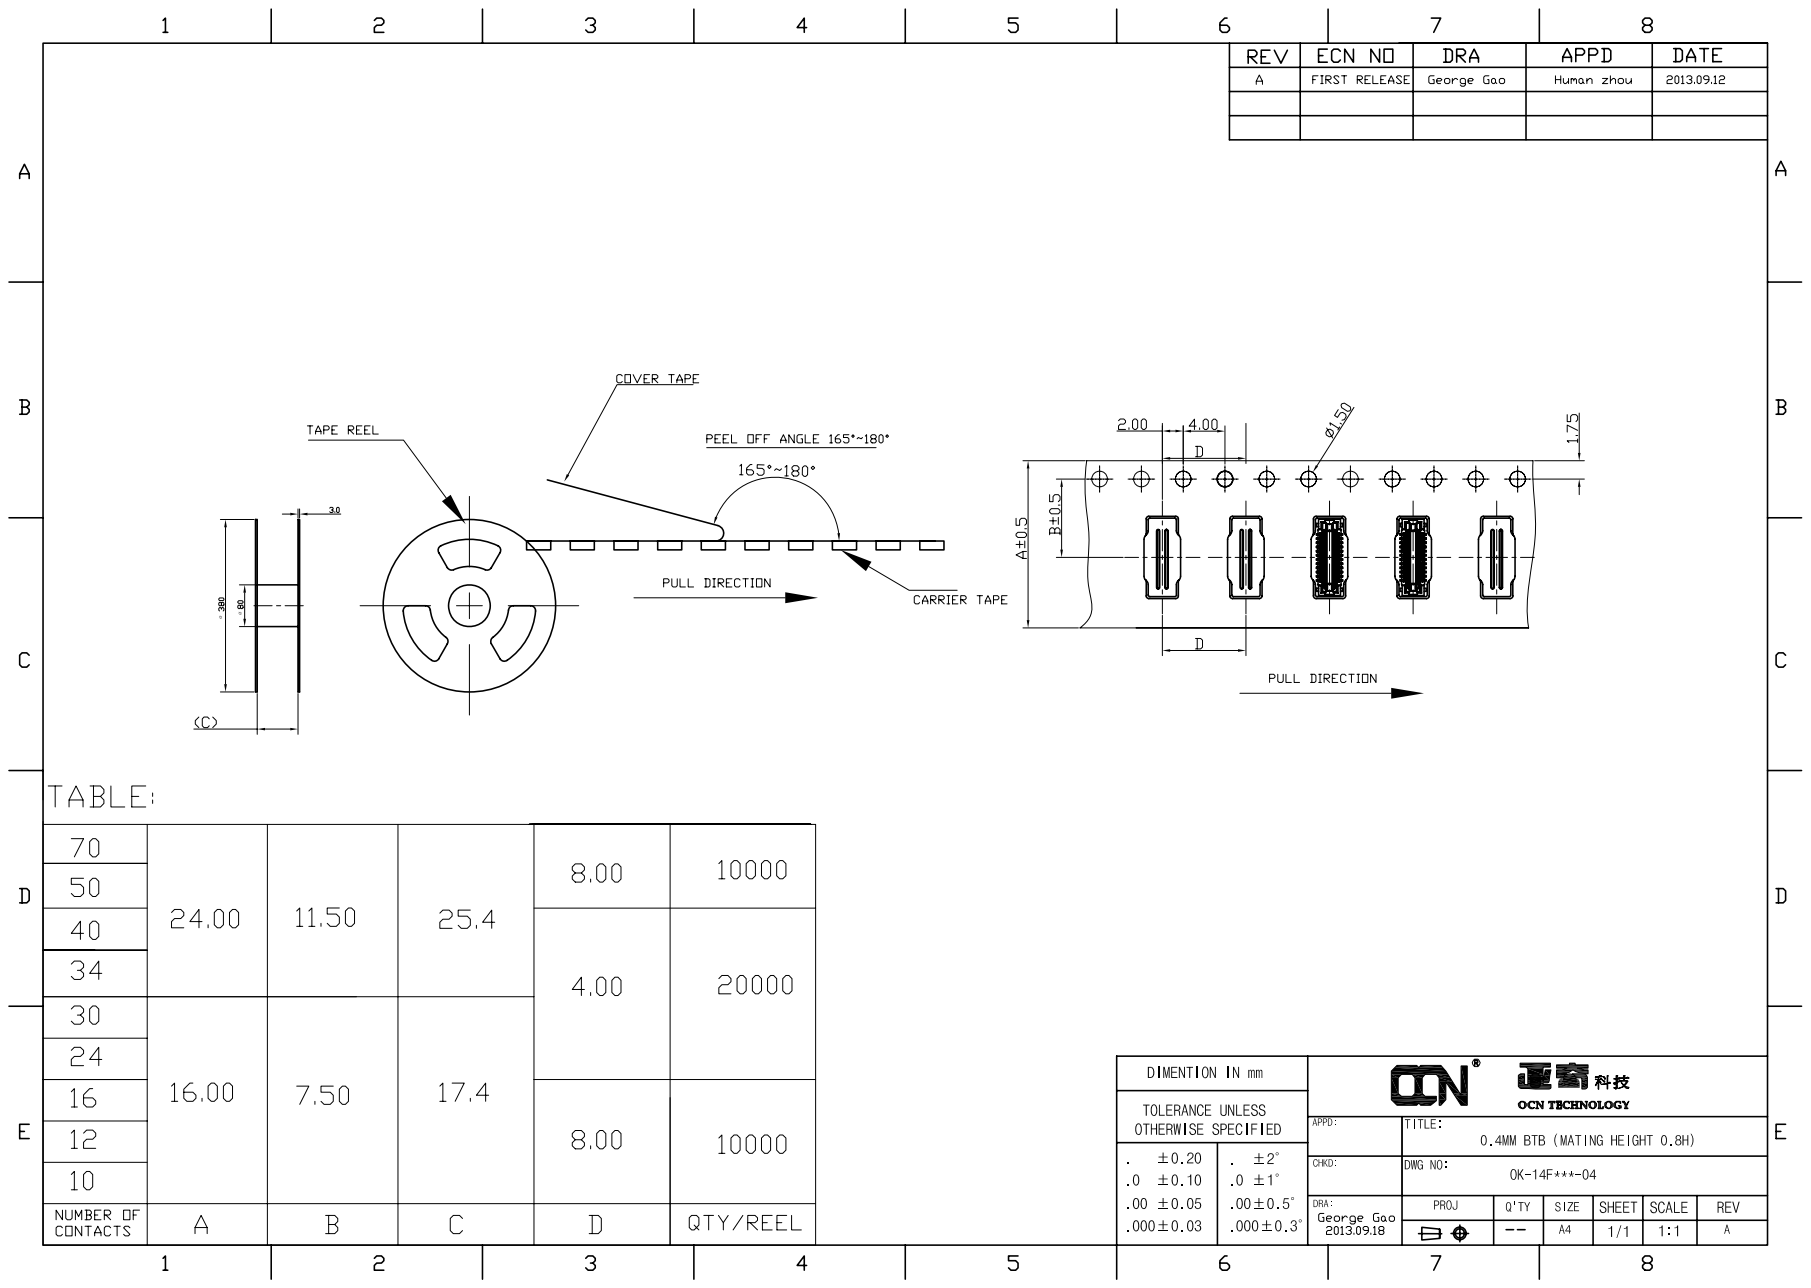
[picture p150: page 4]
