cnchens/RV1126_RV1109_Hardware_Design_Template/(list of files, drawings)

Other design files:
02_DDR Template/RV1126_RV1109_DDR3P116SD4 _Template_V10_20201118/RV1126_RV1109_DDR3P116SD4 _Template_V10_20201118XHF.pcb
02_DDR Template/RV1126_RV1109_TEMPLATE_DDR3P216SD4_V10_20200901/RV1126_RV1109_TEMPLATE_DDR3P216SD4_V10_20200901.pcb
03_Pruduct Line Branch(IPC and Entrance Gate)/03_Reference Design/PCB LIB Ver1.0/RV1126_RV1109_RK809_Component Library-PADS.pcb
04_Product Line Branch(Battery IPC-Smart Bell)/03_Reference Design/PCB LIB Ver1.0/RV1126_RV1109_RK809_Component Library-PADS.pcb
05_Pruduct Line Branch(UVC DEMO)/00_History Document/PCB Ver11/RV1126_RV1109_USB_AI_CAMERA_DEMO_DDR3P216DD4_V11_20200706lxf.pcb
05_Pruduct Line Branch(UVC DEMO)/00_History Document/PCB Ver11/RV1126_RV1109_USB_AI_CAMERA_DEMO_DDR3P216DD6_V11_20200706lxf.pcb
05_Pruduct Line Branch(UVC DEMO)/00_History Document/PCB Ver12/RV1126_RV1109_USB_AI_CAMERA_DEMO_DDR3P216DD4_V12_20200821KYY.pcb
05_Pruduct Line Branch(UVC DEMO)/00_History Document/PCB Ver12/RV1126_RV1109_USB_AI_CAMERA_DEMO_DDR3P216DD6_V12_20200821KYY.pcb
05_Pruduct Line Branch(UVC DEMO)/00_History Document/PCB Ver13/RV1126_RV1109_USB_AI_CAMERA_DEMO_DDR3P216DD4_V13_20201030KYY.pcb
05_Pruduct Line Branch(UVC DEMO)/00_History Document/PCB Ver13/rv1126_rv1109_usb_ai_camera_demo_ddr3p216dd6_v13_20201030kyy.pcb
05_Pruduct Line Branch(UVC DEMO)/00_History Document/PCB Ver14/RV1126_RV1109_USB_AI_CAMERA_DEMO_DDR3P216DD4_V14_20201221KYY.pcb
05_Pruduct Line Branch(UVC DEMO)/00_History Document/PCB Ver14/rv1126_rv1109_usb_ai_camera_demo_ddr3p216dd6_v14_20201221kyy.pcb
05_Pruduct Line Branch(UVC DEMO)/03_Reference Design/PCB Ver15/RV1126_RV1109_USB_AI_CAMERA_DEMO_DDR3P216DD4_V15_20210207lxf.pcb
05_Pruduct Line Branch(UVC DEMO)/03_Reference Design/PCB Ver15/RV1126_RV1109_USB_AI_CAMERA_DEMO_DDR3P216DD6_V15_20210207lxf.pcb
